jeffmhopkins/POGO/specs/block-6/spec.md

# Block 6: Triple Bandpass + Distortion
Three independent 2-pole OTA-C SVF bandpass resonators with per-band frequency, Q (FOCUS), stereo spread (TILT), drive, and distortion mode. A global BP master section controls overall offset, tilt, bypass level, and wet level.

DSP source: `plugin/src/dsp/BandpassSVF.hpp`, `plugin/src/dsp/Distortion.hpp`, `plugin/src/Pogo.cpp` (lines 410–510)

---

## 1. Intent

Three bandpass resonators — each freely tunable over ~50 Hz–3.2 kHz (F_REF = 400 Hz at param = 0). Together they act as a resonator bank, vowel sculptor, or harmonic comb filter. All three bands default to the same center frequency; the user positions them independently via the per-band FREQ knobs.

**Per-band signal order (change 0018, matching the locked plugin `Pogo.cpp:443–451`): DISTORTION *before* the bandpass.** Each band is `input → DISTn (drive + SC/HC/WF) → SVFn (2-pole bandpass) → band output`; the three band outputs are then summed and dry/wet-mixed. (BP1/BP2 input = LP1 band; BP3 input = the ALT-VCA-or-LP1 selector — see ALT path.) The hardware nets carry this as `LP1_OUT/BP3IN → distN → BPn_DISTOUT → svfN → BPn_BANDOUT/BP3_TAP → mix`.

### Global BP master controls

**BP_OFFSET** shifts all three bands simultaneously (master V/oct offset). **BP_TILT** creates global stereo spread — L channel gets +tiltV, R gets −tiltV — separating the band positions across the stereo field.

**BP_BYPASS** sets the level of the pre-BP signal (LP1 output or ALT input) that passes through to the BP output (0 = muted, 1 = full). **BP_WET** sets the level of the processed (post-distortion) BP sum at the output (0 = dry only, 1 = full wet). The output formula is:

```
bpOut = clamp(bandIn × bypass + wetSum × wet, −12, +12)
```

Both controls are independent scalers — not a crossfade. Setting both to 1.0 adds LP1 and full BP together; setting BYPASS to 0 gives pure BP; setting WET to 0 gives pure LP1 passthrough.

CV inputs for the master section: FREQ jack (+ attenuverter trimpot) modulates BP_OFFSET; TILT jack modulates BP_TILT.

### Per-band controls (BP1, BP2, BP3 — identical architecture)

Each band has:
- **DIST switch** (Dailywell DW5, 3-position toggle): Soft Clip (down) / Hard Clip (centre) / Wavefold (up) — selects distortion character independently per band
- **FREQ knob** (xl): per-band frequency offset in V/oct; F_REF = 400 Hz → range ~50 Hz–3.2 kHz
- **FOCUS knob** (large): resonance (Q); `Q = 0.5 × 400^focus` → Q range 0.5–200; does not self-oscillate
- **TILT knob** (large): per-band stereo spread, additive with global BP_TILT
- **DIST knob** (large): per-band drive depth (0–1) into the distortion cell, which sits **before** the bandpass (0.20 = unity/threshold)
- **CLIP LED**: illuminates when the per-band distortion output (pre-bandpass) exceeds ±4 V
- CV inputs per band: FREQ, TILT, DIST jacks (each with attenuverter trimpot)

### ALT path

`ALT_BP_L/R` jacks (with the `ALT_GAIN` 1×/5× switch) feed **BP3 only**, and the ALT signal still
passes **through the VCA** (same control as the main path) — it bypasses **LP1**, not the VCA (see
block-1/block-4). A per-channel selector (block-6, BP3) routes the ALT-VCA signal (block-4
`ALT_VCA_OUT_L/R`) into BP3's input when the ALT jacks are patched, else BP3 takes the LP1 band.
BP1 and BP2 always take the LP1 band.

### BP3 output tap

`BP3_L_OUT` and `BP3_R_OUT` jacks provide BP3's **post-bandpass band output** (the filtered BP3
voice, after its distortion+SVF, before the 3-band sum and dry/wet mix) — useful for parallel
processing or sidechain routing. R normals to L when the R jack is unpatched.

---

## 2. Theoretical Design and Topology

> ⚠️ **SUPERSEDED (pre-2026-05-27 theory)** — This section predates change 0018. Where it
> conflicts with §1, the Stage-alignment notes above (two-scaler BP_BYPASS+BP_WET mix; **per-band**
> `BP{n}_DIST_MODE`; distortion **before** the SVF; F_REF 400 Hz; per-band variable DRIVE VCA),
> or the `specs/block-6-{svf1,svf2,svf3,dist1,dist2,dist3,mix}/*.nets.yaml`, those are authoritative.
> In particular the "global BP_DIST switch" and "BP_MIX crossfade (default 0.5)" language below is
> stale — mode is per-band and the output uses two independent scalers (both default 1.0).

> 📝 **Schematic transcription (2026-05-29).** The KiCad netlist
> (`specs/block-6/block-6.nets.yaml`, generated by `tools/gen_block6.py`) was transcribed
> this pass and `tools/generate_schematic.py --check` is clean. Findings, reconciled
> against the plugin (ground truth) and the TI datasheets:
> - **BP = the same 2-pole Simper SVF as LP1/HP/LP2** (`BandpassSVF.hpp` confirms it),
>   so the topology mirrors block-5/8 but taps **v1 (BP)** instead of v2 (LP). Each group
>   has its own per-channel Q-VCA OTA (U67-69) injecting damping current at the SUM_AMP
>   virtual ground, exactly like the block-5-hosted shared Q-VCAs.
> - **CD4053 mux is a stereo 1-of-3 built from two CD4053 per group** (muxB picks HC↔WF
>   into a MID node; muxA picks SC↔MID), L on the X channel, R on the Y channel, Z spare.
> - **CD4053 symbol pinout was wrong** (now authored in `components/symbols/cd4053.yaml`) and
>   has been corrected to the
>   TI CD4053B datasheet (selects A/B/C = 11/10/9; X com/0/1 = 14/12/13; Y = 15/2/1;
>   Z = 4/5/3). The prior symbol scrambled the channel numbers and overlapped VEE with a
>   signal pin.
>
> **Three controls remain under-specified and are flagged Phase-3R** — the signal path is
> wired faithfully and each control is treated as a boundary CV applied via a Phase-3R element:
> 1. **DRIVE → variable gain.** No in-block variable-gain element exists (the drive knobs
>    RV33/36/39 are control-board; there is no VCA/JFET in the block-6 BOM). The six SC/HC/WF
>    cells are wired at their fixed minimum gain (R_fb fixed); they still clip at their diode
>    (±1.4 V) / zener (±5.8 V) thresholds, so they are functional. The per-band DRIVE depth is
>    a Phase-3R variable-gain stage fed by the BPx_DIST CV. The C_WF 47 pF caps (spec'd as
>    drive-pot wiper bypass) are relocated to the distortion-input nodes as anti-RF caps.
> 2. **DW5 ON-ON-ON → 2-bit mode encoding.** SW4-6 encode mode into two bits per group; the
>    select lines `BPx_SEL_SC`/`BPx_SEL_WF` are pulled to a 5 V logic rail (D7/R29/C27/C28)
>    and leave as boundary nets to the DW5. The exact lug→bit make pattern is Phase-3R. **5 V
>    logic-high against VDD = +12 V is marginal per the CD4053B datasheet** (V_IH ≈ 0.7·VDD):
>    a level shift or VDD = +5 V may be required — prototype-verify. Analog rails are kept at
>    ±12 V for full ±5 V audio headroom.
> 3. **BP_MIX blend — RESOLVED (change 0018, Stage 7).** The plugin uses **two independent
>    0–1 scalers** (`bpOut = bandL·BP_BYPASS + wetSum·BP_WET`), now built as such: the wet
>    3-band sum (U46/47-A, inverting) is re-inverted by U48 (G=−1) to `BP_WETPOS` (+bands);
>    a **BYPASS** dual-gang pot (RV30 L / RV58 R) attenuates the dry LP1 band and a **WET**
>    dual-gang pot (RV57 L / RV59 R, new) attenuates `BP_WETPOS`; both wipers sum in the final
>    inverting summer (U46/47-B), then an output polarity-restore inverter per channel (U27-B
>    = L, U27-A = R, reused) yields `BP_OUT`. Both pots default 1.0 = LP1 + full BP, matching
>    the plugin. *Polarity:* dry and the wet bus are arranged to **add** at `BP_OUT` (the wet
>    chain's net inversions, including the Stage-5 DRIVE-VCA I/V, are accounted so wet sums
>    with — not against — dry). The exact wet-vs-dry absolute phase across frequency/mode and
>    the pot tapers are Phase-3R bring-up items.

### SVF Groups (3 independent resonators)

Each group is a 2-pole state-variable filter (BP output only). Both DSP and hardware use one 2-pole OTA-C SVF per group per channel:

```
H_BP(s) = (ω₀/Q · s) / (s² + ω₀/Q · s + ω₀²)
```

Peak at s = jω₀: |H_BP(jω₀)| = 1 (constant unity, regardless of Q). Q controls bandwidth only, not peak amplitude.

**f_ref per group** (at 0V CV): **all three bands = 400 Hz** (matches the locked plugin
`BandpassSVF.hpp:42` `F_REF = {400, 400, 400}`). The bands default to the same center and the
player spreads them via the per-band FREQ knobs — they are not fixed-formant. (The earlier
`{200, 1500, 6000}` per-group formant assignment matched a stale code comment, not the plugin
code, and is superseded — change 0018. Integrator caps are now a uniform 68 nF C0G, trimmed to
400 Hz by each band's f_ref trim.)
| Group | f_ref | Cap |
|---|---|---|
| BP1 | 400 Hz | 68 nF (C15) |
| BP2 | 400 Hz | 68 nF (C19) |
| BP3 | 400 Hz | 68 nF (C23) |

**Frequency control:**
```
f₀ = f_ref[i] × 2^(BP_OFFSET + BP_FREQ_i + BP_TILT × ±1)
```
where BP_TILT applies +tiltV on L channel, −tiltV on R channel.

**Q control:**
```
DSP: Q = 0.5 × 400^qParam  (range 0.5–200; does NOT self-oscillate by design)
Hardware: Q = 52mV / (Iabc × R_in)
```
BP Q maximum is ~200 at hardware (Iabc → minimum before instability threshold). Self-oscillation is suppressed — BP groups are resonators, not oscillators.

### Distortion

Three modes, selected **per band** by `BP{n}_DIST_MODE` (0/1/2) — BP1/BP2/BP3 independent:

**Soft Clip (mode 0):**
```
G = driveParam ≤ 0.20 ? (driveParam / 0.20)        (0→1× gain control)
      : exp((driveParam − 0.20) / 0.80 × 4)         (1×→~55× drive, same exp law)
y = Vth × tanh(G × x / Vth)    Vth = 0.28 (= 1.4V/5V; two 1N4148W per polarity)
```
Output bounded to ±Vth = ±1.4V at all drive levels. Linear below threshold; smooth tanh onset above. Diodes always in circuit; gain-control zone (≤9am) feeds the diode chain at reduced gain.

**Hard Clip (mode 1):**
```
g = 1 + d × 4    (1–5× linear gain)
y = clamp(g × x, −1.16, +1.16)    (±1.16 = ±5.8V/5V; zener 5.1V + 1N4148W Vf 0.7V)
```
Linear gain into hard rails at ±5.8V. Aggressive, brick-wall limiting.

**Wavefold (mode 2, Buchla-style):**
```
Vth = 0.28    (= 1.4V/5V; two 1N4148W per polarity in passive clamp)
y = (1 + d × 4) × x                    (1–5× pre-gain)
output = Vth × asin(sin(π/2 / Vth × y)) × 2/π
```
Passive diode clamp at ±Vth, then V_out = 2×V_clamp − V_in (slope reversal at ±1.4V). At max drive and full-scale input: ~18 folds vs ~3 folds at ±5V threshold. Dense Buchla-style folding.

### BP_MIX blend

```
BP_out = clamp(LP1_output + mix × sum(distorted_groups), −12, +12)
```
**(Superseded — see §1 / Stage-7 note.)** The current design uses two independent scalers: `BP_BYPASS` scales the dry LP1 band and `BP_WET` scales the wet sum, both default **1.0** (`bpOut = clamp(band·BYPASS + wetSum·WET, ±12)`). There is no single "mix" crossfade and no 0.5 default.

### Oversampling

None. Hardware SVF and distortion run at audio rate; analog hardware is inherently alias-free. DSP matches: no oversampling applied to BP section.

### DSP/Hardware Alignment

DSP and hardware are aligned on all BP signal-processing behaviors:
- 2-pole SVF per group per channel (both)
- Unity BP peak gain regardless of Q (both)
- Additive BP_MIX: dry at unity, wet added on top (both)
- No oversampling (both)
- Distortion thresholds: SC ±1.4V, HC ±5.8V, WF ±1.4V (both)

→ See aux-ota-c-svf.md for SVF topology; aux-distortion.md for distortion cells.

---

## 3. Physical Design

> ⚠️ **STALE** — This section reflects the pre-panel-redesign analog design (2026-05-27).
> It has not been verified against the current panel control set. Do not use for circuit
> construction until re-verified. See `specs/STATUS.md` for current phase status.

> 🔧 **Change 0020 (the per-section nets ARE current; this §3 prose is not):** two fixes landed in
> the block-6 section netlists (`block-6-svf1/2/3`, `block-6-dist1/2/3`):
> - **§A BP expo V/oct divider:** each per-band expo base got the same divider fix as the filters —
>   `R_VOCT`→**49.9k** + a **Vishay TFPT 1k tempco** shunt to GND (centers 17.92 mV/oct). (svf1/2/3.)
> - **HIGH-3 DRIVE-VCA Ec+ trims:** the 6 per-band DRIVE unity trims (RV51–56) were useless series
>   rheostats into the high-Z Ec+ port → replaced with **voltage-injection trims** (RV→10k divider
>   across a local ±1.2 V ref; wiper→R_inj 1M→Ec+; V_DRIVE_CTRL→R_ec 10k→Ec+). ±~2 dB authority
>   (SPICE `block-6-dist1/sim/dist_clip.cir` etc.; mirrors block-4 vca_ecplus.cir). V_DRIVE_CTRL is already an op-amp output (low-Z) so no extra buffer.
>   Mirrors block-4 HIGH-3. (dist1/2/3: R243–260, REF_P/N 1/2/3.)

### OTA-C SVF instances

Three groups × two channels (L + R) = **6 OTA-C SVF instances**. Each instance requires:
- 1× LM13700 OTA cell as integrator (one IC = 2 cells = one group, one channel)
- 1× TL072 half as SUM_AMP

Grouping per IC:
- Per group: `BP_OTA_G1_L`, `BP_OTA_G1_R` etc. — one LM13700 per group per channel (dual OTA: cell A + cell B = integrator + Q VCA, OR cell A/B for two channels of same group)
- Conservative count: 3 groups × 2 channels × 1 LM13700 = **6× LM13700** for integrators + Q VCAs

**Q (resonance) at SUM_AMP:**
Standard SVF BP peak is 1× (constant unity, independent of Q). No normalization is applied. Q controls bandwidth only; high-Q formants have the same peak level as low-Q formants. This is the natural hardware OTA-C SVF behavior and is preserved in the DSP.

**Stereo tilt implementation:**
- BP_TILT generates +V_tilt (from mod bus via attenuverter)
- +V_tilt added to L-channel expo converter offset sum
- −V_tilt generated by TL072 inverting unity buffer; added to R-channel expo converter offset sum
- One TL072 half used as tilt inverter (shared across all 3 groups, same tilt offset applied to all)

**Expo converters:**
- **Per-channel** THAT340: one per L and one per R, per group — 6× THAT340 total (U28-U30 L, U70-U72 R)
- Each band/channel has its own f_ref trim (RV_BP{1,2,3}_REF L/R), all targeting **400 Hz at 0 V**

**Distortion hardware (see aux-distortion.md):**
- **Variable DRIVE (change 0018):** each band has a stereo VCA at its distortion input — a
  THAT2180 current-in/I-V-out cell per channel (mirrors the block-4 VCA), gain set by the
  per-band DRIVE knob (RV33/36/39) + DRIVE CV (`MOD_BPn_DIST`) summed into Ec+. This is the
  hardware "DRIVE→gain" stage; a single dB-law VGA per band approximates the plugin's
  per-mode drive (SC exp vs HC/WF linear) — an accepted, documented deviation, with the exact
  knob→Ec+ dB law and the knob=0.20⇒unity bias set at **Phase-3R** bring-up (like block-4's Ec+).
  *Polarity:* the I/V stage inverts (as in block-4); this adds one inversion to the BP wet path
  — to be absorbed by the mix's wet polarity-restore (Stage 7 / Phase-3R), so wet sums (not
  subtracts) with the dry LP1 band.
- Three sub-circuit chains per group: SC / HC / WF all running simultaneously (after the DRIVE VCA)
- CD4053 triple 2-channel analog mux per group selects which mode's output passes
- All 3 CD4053 select pins tied together → BP_DIST switch controls all groups simultaneously
- One Dailywell DW5 (2M DPDT ON-ON-ON) toggle → its two poles give the 2 select lines to all 3 CD4053 ICs
- Distortion runs **pre-SVF** (band → DRIVE VCA → DISTn → SVFn) at audio rate (no oversampling)
- BP3 output tap: taken at group 3's **post-bandpass** band output (`BP3_TAP`, after DIST3→SVF3), available at BP3_L/R_OUT jacks

**BP3 input selector (change 0018):** BP3's distortion input is fed by a CD4053 mux (U81, in
block-6-dist3) that picks, per channel, between the **LP1 band** (`LP1_OUT`, mux X0/Y0) and the
**ALT-VCA voice** (`ALT_VCA_OUT` from block-4, mux X1/Y1). The select is `ALT_L_DET` — the
ALT_BP_L jack insertion detect: J3's tip-switch lug (block-1) feeds `ALT_L_DET`, pulled to +12 V
(R133) with a 22 kΩ pulldown on the ALT_L tip (R134); patched ⇒ HIGH ⇒ ALT-VCA, unpatched ⇒ LOW
⇒ LP1. Both channels share `ALT_L_DET` (the plugin's asymmetric `bp3InR = L‖R` is not realized —
the locked single-switch jacks have no free contact for an ALT_R detect; diverges only in the
rare R-patched-but-not-L case). *(Phase-3R: like the other CD4053 selects, a +5 V/+12 V logic
threshold margin should be verified on the prototype; ALT_L_DET uses a +12 V pull-up to stay
clean against VDD=+12.)*

**Oversampling:**
- None. Hardware and DSP both run at base sample rate. Analog hardware is inherently alias-free; no oversampling required.

**Board assignment:** BP SVF and distortion on audio board. BP control pots and jacks on control board. THAT340s on audio board near their respective SVF clusters.

### Q Normalization — Design Decision

Hardware OTA-C SVF produces |H_BP(jω₀)| = 1 (constant unity peak). Q controls bandwidth only. A 1/Q² normalization would require a VCA per group per channel (6 cells), significantly increasing complexity. Decision: hardware unity peak is preserved in both hardware and DSP. High-Q formants are louder — this is musically desirable (tight resonances stand out) and is the expected behavior of analog formant filters.

### Distortion Sub-Circuit Design (SC / HC / WF)

One set of three sub-circuit paths (SC + HC + WF) per group, per channel = 6 sets total.
All paths share a common DRIVE control signal per group (one pot + CV per group, summed at
mod bus). All three paths run continuously; the CD4053 selects which output reaches BP_MIX.

#### SC Path (Soft Clip)

Inverting gain stage followed by antiparallel diode-pair feedback (tanh approximation):

```
                 R_SC_fb_fixed (10 kΩ)
              ┌──────────────────────────────┐
              │   RV_DRIVE (0–470 kΩ log)    │
              ├──────────────────────────────┤
              │         (in feedback path)    │
              │                               │
 BP_out ──[R_SC_in = 10 kΩ]──►(−) TL072 ──►─┴─── SC_out
                                   │
                               D_SC_3│D_SC_4 (1N4148W antiparallel pairs)
                               D_SC_1│D_SC_2
                                   │
                                  GND

Diodes: two 1N4148W in series per direction (4 total per path)
  V_clip = 2 × V_f_1N4148 ≈ 2 × 0.7V = 1.4V (soft clip threshold)

DRIVE varies feedback resistance:
  RV_DRIVE = 0 (full CCW): R_fb = R_SC_fb_fixed = 10 kΩ → gain = 10/10 = 1× (linear)
  RV_DRIVE = max (full CW): R_fb = 10 kΩ + 470 kΩ = 480 kΩ → gain = 480/10 = 48× (heavy sat)
```

At low drive: signal below 1.4V threshold → diodes off → output follows linear gain law.
At high drive: pre-amp amplifies to many multiples of 1.4V → diodes conduct → output
limited to ±1.4V, producing soft saturation. Tanh-like characteristic due to incremental
diode conductance. Polarity preserved (inverting amp + final inverting buffer restores sign).

Components per SC path: 1× TL072 half (SC gain amp), 4× 1N4148W (SOD-123), 2× resistors.

#### HC Path (Hard Clip)

Inverting gain stage with variable gain followed by back-to-back zener clamp:

```
 BP_out ──[R_HC_in = 10 kΩ]──►(−) TL072 ──►───────── HC_out
                                    │               │
                               R_HC_fb              │
                     (10 kΩ + RV_DRIVE 47 kΩ log)  │
                                                    │
                             D_HC_Z1 ── D_HC_Z2     │
                             (BZX84C5V1, SOT-23)    │
                             back-to-back to GND     │

Zener pair: one in breakdown (5.1V), one in forward conduction (0.7V) → V_clip = ±5.8V

DRIVE varies gain:
  RV_DRIVE = 0: R_fb = 10 kΩ → gain = 10/10 = 1× → ±5V signal → stays below ±5.8V clip (near-linear)
  RV_DRIVE = max: R_fb = 10+47 = 57 kΩ → gain = 57/10 = 5.7× → ±5V signal → ±28.5V → clips at ±5.8V
```

At low drive: input ±5V with gain 1× gives ±5V output; just below zener threshold (5.8V) — near-linear.
At high drive: gain up to ~5.7×; input is amplified well beyond threshold → hard clip at ±5.8V
(corresponding to ±1V threshold at the input, i.e., signals above 1V clip against the zeners).

Components per HC path: 1× TL072 half (HC gain amp), 2× BZX84C5V1 zener (SOT-23), 2× resistors.

**Note:** Zener clip threshold of ±5.8V vs DSP target of ±5V. Deviation is ±0.8V (16%).
Acceptable for a distortion effect. Document and close.

#### WF Path (Wavefold)

True symmetric precision folder approximating DSP `asin(sin(π/2 × gain × x)) × 2/π`.

Uses a passive diode clamp + op-amp subtractor topology that produces true slope reversal at
±Vth (1.4 V). This is not gain compression — the output slope inverts at threshold.

```
Stage 1 — pre-gain (variable fold depth):
 BP_out ──[R_WF_in = 10 kΩ]──►(−) TL072-A ──► V_fold_in
                                    │
                               R_WF_fb: 10 kΩ + RV_DRIVE 47 kΩ → gain 1×–5.7×
 (inverting; polarity consistent with SC/HC paths)

Stage 2 — symmetric precision folder:
 Passive diode clamp:
   V_fold_in ──[R_clamp = 10 kΩ]──┬── V_clamp
                                    │
              D_WF_1 ──►|── D_WF_2 ──►|──┐
                                           ├── AGND
              D_WF_3 ─◄|── D_WF_4 ─◄|──┘
   (D_WF_1–4: 1N4148W, SOD-123; two per direction → Vth = ±2×0.7V = ±1.4V)
   Clamp action: V_clamp = V_fold_in when |V_fold_in| ≤ 1.4V
                 V_clamp = +1.4V    when V_fold_in > +1.4V
                 V_clamp = −1.4V    when V_fold_in < −1.4V

 Op-amp folder (TL072-B, non-inverting reference = V_clamp):
   V_clamp ──────────────────────────►(+)
   V_fold_in ──[R_g = 10 kΩ]─────────►(−)──── TL072-B ──[R_f = 10 kΩ]──► WF_out
                                        (−) receives negative feedback from output via R_f
```

**Transfer function:**
```
WF_out = 2 × V_clamp − V_fold_in

 |V_fold_in| ≤ 1.4V: V_clamp = V_fold_in → WF_out = V_fold_in          (linear)
 V_fold_in  > +1.4V: V_clamp = +1.4V    → WF_out = 2.8V − V_fold_in   (fold down)
 V_fold_in  < −1.4V: V_clamp = −1.4V    → WF_out = −2.8V − V_fold_in  (fold up)
```

This is a true slope reversal at ±1.4 V, matching the asin(sin(x)) shape for a single fold.
At DRIVE=max (gain 5.7×), a ±5V input signal reaches ±28V pre-fold → multiple reflections
across the ±1.4V window → dense odd-harmonic spectrum.

**Stability:** TL072-B is in standard negative feedback (output → R_f → (−) input).
V_clamp at (+) is a passive resistor-diode network with no active elements; it presents a
source impedance of R_clamp = 10 kΩ at (+), which has no impact on loop stability.
Phase margin is identical to a standard G=+2 non-inverting configuration. No stability
concern — no prototype verification required for this stage.

**Diode Vth variation (resolved — accepted characteristic):**

1N4148W Vf depends on clamp current; Vth = 2×Vf shifts with drive level:

```
V_fold_in   I_clamp = (V−1.4V)/10kΩ   Vf (1N4148W)   Vth = 2×Vf
  3 V           160 µA                  ~0.62 V          ~1.24 V
  5 V           360 µA                  ~0.64 V          ~1.28 V
 10 V           860 µA                  ~0.68 V          ~1.36 V
 28 V (max)    2.66 mA                  ~0.72 V          ~1.44 V
```

At practical folding depths (V_fold_in > 5 V), Vth sits in the 1.28–1.44 V range,
within ±10% of the DSP target (1.4 V). At very low drive (barely past threshold),
Vth is lower (~1.2 V), which softens fold onset slightly. This gives the hardware a
characteristically smooth entry into folding — the fold corners are rounder than the
mathematical `asin(sin(x))` model, consistent with all passive-diode Buchla-style
folders. It is an analog character feature, not a defect. No hardware change required.

Components per WF path: 2× TL072 halves (pre-gain + folder; same IC, no additional ICs),
4× 1N4148W (SOD-123), 4× resistors (R_WF_in, R_WF_fb_fixed, R_clamp, R_g = R_f = 10 kΩ).

**Note on wiper bypass caps:** A 47 pF cap from each RV_DRIVE wiper to AGND is recommended
(pole at R_wiper_max × C ≈ 11.75 kΩ × 47 pF → f_pole ≈ 288 kHz). Kills RF pickup; no
effect on control-rate drive changes.

### CD4053 Mux Wiring

One CD4053 (SOIC-16) per group, 3 total (BP_DIST_MUX_1, _2, _3). All three have their
S_A and S_B control pins tied together (global mode select from SW_DIST panel switch).

**Power supply wiring:**
```
VDD (+12V supply) → pin 16 of each CD4053 (analog/digital supply)
VSS (−12V supply) → pin 7 of each CD4053 (negative analog rail)
VEE (GND)         → pin 8 of each CD4053 (digital ground; sets logic threshold at ~VDD/2)
INH pin (pin 6)   → GND (active-low inhibit; tied LOW = always enabled)
```

The CD4053 passes signals from VSS to VDD on each analog channel. With ±12V supply,
the audio signal can swing ±5V without signal-dependent R_on distortion.

**Control line encoding (2 binary lines → 3 modes):**
```
SW_DIST position → S_A line, S_B line:
  Soft Clip:  S_A = 0,  S_B = 0   → Channel X passes SC_out; Channel Y passes X-output
  Hard Clip:  S_A = 1,  S_B = 0   → Channel X passes HC_out; Channel Y passes X-output
  Wavefold:   S_A = x,  S_B = 1   → Channel Y selects WF_out (overrides Channel X)
```

**Channel assignment within each CD4053:**
```
Channel X (control S_A):
  X0 input ← SC_out
  X1 input ← HC_out
  X output → Channel Y input Y0

Channel Y (control S_B):
  Y0 input ← Channel X output
  Y1 input ← WF_out
  Y output → DIST_out (→ BPn_DISTOUT → SVF input; the SVF band output then goes to the mix)

Channel Z: spare (inputs tied to GND; output unused)
```

When S_B = 1: Channel Y selects WF regardless of S_A — wavefold mode overrides.
When S_B = 0: Channel Y passes Channel X output, which is SC or HC depending on S_A.

SW_DIST is a Dailywell DW5 (2M DPDT ON-ON-ON) toggle generating S_A and S_B:
- Position 0 (Soft):  S_A=low, S_B=low   (0V = logic LOW; from GND)
- Position 1 (Hard):  S_A=high, S_B=low  (+5V = logic HIGH; from +5V regulator or +12V with R+zener)
- Position 2 (Fold):  S_A=low, S_B=high

The +5V logic rail for CD4053 control inputs: taken from a 78L05 regulator (or 5.1V zener
from +12V with 1kΩ series R) on the audio board. Logic signal swings 0V–5V, which is within
the CD4053 VIH threshold at VDD=+12V.

### BP_MIX Blend Circuit

The DSP: `V_out = (1 − mix) × V_dry + mix × V_wet`  
where V_dry = LP1 signal (entering block-6), V_wet = sum of three distorted BP groups.

**BP summing stage (V_wet):**

One TL072 inverting summer combines distortion outputs of all three groups (per channel):
```
DIST_BP1_out ──[R_sum = 33 kΩ]──┐
DIST_BP2_out ──[R_sum = 33 kΩ]──┼──►(−) TL072 ──[R_f = 33 kΩ]──► V_wet_inv
DIST_BP3_out ──[R_sum = 33 kΩ]──┘         │
                                         (+) = GND
```
V_wet_inv = −(BP1 + BP2 + BP3) / 3 (normalized). Signal inverted; corrected at the fixed
output polarity-restore stage (U27 half B).

**BP_MIX summing amp:**

A TL072 inverting summer with the MIX pot controlling the wet-to-dry ratio:
```
V_dry ──[R_dry = 100 kΩ]────────────────────────┐
                                                  ├──►(−) TL072 ──[R_mix_f = 100 kΩ]──► V_mix_inv
V_wet_inv ──[R_wet_pot = RV_BP_MIX wiper × 100k]─┘
                                                (+) = GND
```

RV_BP_MIX (linear-taper 100 kΩ): controls R_wet from 0 (full CCW, no wet) to 100 kΩ (full CW).
V_mix_inv = −(V_dry × R_f/R_dry + V_wet_inv × R_f/R_wet)

At MIX=0 (R_wet = ∞): V_mix_inv = −V_dry (dry inverted)
At MIX=max (R_wet = 100k, R_f = R_dry = 100k):
  V_mix_inv = −V_dry − V_wet_inv = −V_dry − (−V_wet) = −V_dry + V_wet

**Wet polarity restore (U48):** An inverting unity-gain buffer on the V_wet_inv signal
restores wet polarity to +V_wet before the MIX amp, so V_wet_pos = −V_wet_inv = +V_wet.

With V_wet_pos (corrected) feeding the MIX amp instead of V_wet_inv:
  V_mix_inv = −(V_dry + V_wet_pos × R_f/R_wet)
At MIX=0: V_mix_inv = −V_dry
At MIX=max: V_mix_inv = −V_dry − V_wet

V_mix_inv then passes to the fixed output polarity-restore stage (U27 half B).

**DESIGN NOTE — U48 reassigned:** U48 (previously "output polarity buffer") is used as
the wet polarity restorer. This inserts one inversion in the wet path to correct the
polarity before the MIX amp. Without this correction, the wet signal would be subtracted
rather than added at the BP output (V_dry − V_wet instead of V_dry + V_wet).

**Note:** DSP matches hardware: dry is always present at unity, wet is added on top. At MIX=max: output = dry + wet (up to 6 dB louder than a crossfade at equal level). DSP clamps at ±12V; hardware limited by op-amp rails.

### BP output polarity restore (fixed)

The hardware MIX amp output V_mix_inv is inherently negative-polarity (−V_dry − V_wet).
A fixed G=−1 inverter (U27 half B, in the output polarity-restore TL072CDT) restores the expected
positive-polarity BP output (+V_dry + V_wet). There is no user polarity control (BP_POL
was removed — the plugin has no polarity param; the inversion below is always in path).

```
                               R_pol_in (100 kΩ)    R_pol_fb (100 kΩ)
V_mix_inv ──[R_pol_in = 100 kΩ]──►(−) U27-B ──[R_pol_fb]──► V_bp_out (+V_dry+V_wet)
                                        │
                                   (+) = GND
```

U27 (output polarity-restore TL072CDT) halves — both channels (change 0018; per-band tilt
moved to U82/U83/U84):
- Half B: fixed G=−1 inverter, restores **BP_OUT_L** polarity (always in path; no switch).
- Half A: fixed G=−1 inverter, restores **BP_OUT_R** polarity (always in path; no switch).

**Board assignment:** BP_MIX summing amp + output polarity-restore inverter on the audio board.

### Trim Pots

| Ref | Range | Purpose |
|---|---|---|
| RV_BP1_REF | 500 kΩ; ±25% f_ref | BP1 cutoff reference (target: **400 Hz** at 0V); in series with R_IREF_A 1 MΩ |
| RV_BP2_REF | 500 kΩ; ±25% f_ref | BP2 cutoff reference (target: **400 Hz** at 0V); in series with R_IREF_A 1 MΩ |
| RV_BP3_REF | 500 kΩ; ±25% f_ref | BP3 cutoff reference (target: **400 Hz** at 0V); in series with R_IREF_A 1 MΩ |
| RV_BP1_1VOCT | 20 kΩ; ±10% tracking | BP1 expo 1V/oct calibration |
| RV_BP2_1VOCT | 20 kΩ; ±10% tracking | BP2 expo 1V/oct calibration |
| RV_BP3_1VOCT | 20 kΩ; ±10% tracking | BP3 expo 1V/oct calibration |
| RV_BP1_QMAX | V_bias | BP1 Q maximum point |
| RV_BP2_QMAX | V_bias | BP2 Q maximum point |
| RV_BP3_QMAX | V_bias | BP3 Q maximum point |

### Integrator Cap Derivation

All three bands target f_ref = **400 Hz** (plugin `F_REF = {400,400,400}`):
C = g_m_ref / (2π × 400) ≈ 192 µS / (2π × 400) = 76 nF → use **68 nF (C0G, 0805)** for all three
bands (C15/C19/C23), with the per-band f_ref trim (RV_BP{n}_REF, ±25%) calibrating to exactly
400 Hz. (Superseded: the earlier per-band 150/22/4.7 nF caps implemented a stale {200,1500,6000}
formant spread that does not match the plugin code — change 0018.)

(Exact values adjusted via RV_BPx_REF trim; derive from nominal at I_abc = 10µA.)

### Power Draw Estimate

- 6× LM13700M (SVF integrators + Q VCAs): ~4 mA × 6 = ~24 mA  (TI: 4 mA typ per package)
- 6× OPA1612 (SUM_AMPs, dual SOIC-8): 5.5 mA × 6 = 33 mA  (Iq = 2.75 mA/channel × 2 ch/IC)
- Distortion op-amps — 12 TL072CDT ICs (6 SC+HC shared + 6 WF): ~2.6 mA × 12 = ~31 mA
- BP_MIX + tilt/pol — 5 TL072CDT ICs (1 tilt/pol inverter + 2 wet-summer + 2 MIX polarity buffer): ~2.6 mA × 5 = ~13 mA
- 3× THAT340S14-U (expo converters): ~3 mA
- 3× CD4053BM96 (distortion mux, CMOS quiescent ≈ 0): ~0 mA
- **+12V: ~104 mA | −12V: ~104 mA**

Note: SC and HC distortion paths share one TL072CDT per group/channel (half A = SC, half B = HC).
WF requires both halves of its own IC. Total distortion ICs reduced from 18 to 12 vs prior design.
Icc figures use ±12V operating point (~2.6 mA/pkg), not the ±15V datasheet spec.

---

## 4. Component Requirements

Component set: see the generated BOM `kicad/pogo-bom.csv` (rows with `Block = block-6`),
sourced from `specs/components.yaml` (the per-ref design manifest) and enriched by the
`components/` registry (MPN, footprint, datasheet). Verification status: `specs/STATUS.md`.
