jeffmhopkins/POGO/specs/block-8/spec.md

# Block 8: LP Filter 2
Second independent 2-pole lowpass filter, after HP, for stacked or layered LP filtering with separate CV.

DSP source: `plugin/src/dsp/LPFilter.hpp`, `plugin/src/Pogo.cpp` (lines 486–492)

---

## 1. Intent

Block 8 is the second lowpass filter in the chain and the last filter block before the output
buffers (Block B). It shares the same OTA-C SVF topology as LP1 but operates independently — its
own cutoff CV, resonance, and expo converter — so the two LP filters can be tuned to different
purposes simultaneously.

The most common uses are:

- **Stacked mode:** LP2 cutoff set below LP1 cutoff → combined 24 dB/oct slope, both cutoffs swept
  in parallel (or independently) for a steeper, more dramatic lowpass character.
- **Layered mode:** LP2 cutoff set above LP1 cutoff → dual-knee LP response, creating a compound
  transfer function with two shelf-like transition regions and a flat passband between them.
- **Bright default:** LP2_FREQ_PARAM defaults to +2V (≈ 2.5 kHz), placing LP2 well above LP1's
  default of 0V (632 Hz). In this configuration LP2 is effectively open, contributing only a
  gentle top-end softness, while LP1 dominates the filter sound.
- **Independent resonance:** LP2 resonance adds a second resonant peak at its own cutoff, creating
  a dual-peak spectral character when both LP1 and LP2 have significant Q.

LP2 has no stereo tilt — both L and R channels share one cutoff CV and one Q control, keeping
the hardware simpler and reserving the stereo-spread complexity for LP1 and BP_TILT.

LP2's output feeds Block B (output buffers → MAIN_L/R jacks) directly.

---

## 2. Theoretical Design and Topology

> ✅ **Re-verified 2026-05-30** against the locked plugin (change 0018). LP2 mirrors LP1
> minus tilt: 2-pole Simper SVF, 632 Hz V/oct, self-oscillation, mono cutoff (single shared
> expo). Output buffer is a **non-inverting** unity follower (matches LP2's un-negated v2 — no
> polarity flip, unlike HP). Q via the shared U9/U10 cell B (hosted on block-5); boundary nets
> pin-verified. No behavioral edits.

### DSP-to-analog mapping

LP2 uses the same LPFilter struct as LP1. From Pogo.cpp lines 486–491:

```cpp
float lp2FreqCv = params[LP2_FREQ_PARAM].getValue()
                  + modDest(LP2_FREQ_INPUT, LP2_FREQ_ATT_PARAM);
float lp2ResCv  = clamp(params[LP2_RES_PARAM].getValue()
                  + modDest(LP2_RES_INPUT, LP2_RES_ATT_PARAM) / 10.f, 0.f, 1.f);
float outL = lp2L.process(hpOutL, lp2FreqCv, lp2ResCv, fs);
float outR = lp2R.process(hpOutR, lp2FreqCv, lp2ResCv, fs);
```

The same `f₀ = f_ref × 2^(cutoffV)` law with `f_ref = 632 Hz` applies. The default
LP2_FREQ_PARAM = +2V shifts the reference point up by two octaves:

```
f₀_default = 632 Hz × 2^(+2) = 632 × 4 = 2528 Hz ≈ 2.5 kHz
```

This places LP2 above LP1 (632 Hz default) so that in the default patch state the module sounds
like a single LP1 filter — LP2 only becomes audibly active when its cutoff is swept down or when
LP1 is swept above LP2.

### Transfer function (analog prototype)

Identical to LP1 (see `aux/aux-ota-c-svf.md`):

```
H_LP(s) =        ω₀²
          ──────────────────────────
          s² + (ω₀/Q)·s + ω₀²
```

With Q law and Q range identical to LP1/HP:

```
Q = 52mV / (I_abc_q × 100kΩ)
I_abc_q = 0.74 µA → Q = 0.70  (Butterworth, default)
I_abc_q → 0       → Q → ∞    (self-oscillation)
```

**Accepted Q_min deviation:** DSP Q_min = 0.5 at resParam = 0; hardware Q_min = 0.70 (Butterworth).
See LP1 and `aux/aux-q-control.md` §Q_min deviation for full discussion.

### Cascaded response (LP1 + HP + LP2)

When LP2 is stacked below LP1 (LP2_FREQ < LP1_FREQ), the combined response approaches 24 dB/oct.
Cascading two 2-pole stages with independent Q settings produces a 4th-order response that is
not a standard Butterworth or Linkwitz-Riley alignment; the exact shape depends on the ratio of
the two cutoff frequencies and both Q values. This is a feature, not a defect — it produces a
complex, tunable slope character.

When HP is active between LP1 and LP2, the combined LP1 + HP + LP2 response is a bandpass-like
envelope: HP sets a lower cutoff; LP2 sets an upper cutoff; LP1 shapes the overall entry into the
passband. This is a useful configuration for narrow-band spectral shaping downstream of the BP formant section.

### Shared Q-VCAs (U9/U10) — sharing with LP1

LP2 Q uses cell B of U9/U10 — the same LM13700 packages whose cell A provides LP1 Q.
This means LP1 and LP2 Q cells are on the same die; their I_abc_q signals are independently
driven by separate IRES_AMP circuits. Thermal coupling between cells A and B is negligible at the
operating Iabc (<1 µA, <10 µW per cell). See `aux/aux-q-control.md` §LM13700 Cell Sharing.

### Independent EXPO_LP2 converter

LP2 has its own THAT340 expo converter (EXPO_LP2), independently calibrated from EXPO_LP1. This
is required because LP2's default +2V offset means that the two filters are typically operating
at different points on the expo curve simultaneously. If they shared an expo converter, trimming
RV_REF for one would detune the other.

See `aux/aux-expo-converter.md` for full EXPO topology and calibration procedure.

### No stereo tilt

LP2 has no tilt parameter. Both lp2L and lp2R receive the same `lp2FreqCv` and `lp2ResCv` (Pogo.cpp
lines 490–491). Hardware: EXPO_LP2 drives L and R OTA Iabc pins in parallel from a single expo
output — identical to HP, simpler than LP1.

---

## 3. Physical Design

> ✅ **Re-verified 2026-05-30** against the locked plugin (change 0018). Component values,
> the shared U9/U10 cell-B Q boundary (hosted on block-5), the own IRES_AMP (U65), and the
> non-inverting LP output follower verified consistent with §2 and the plugin. Doc-only pass.

> 🔧 **Change 0020 (CV-conditioning fixes):** mirrors block-7 §A/§C/§D.
> - **§A:** `R86` R_VOCT **47k→49.9k** + **Vishay TFPT 1k tempco** shunt (R230) LP2_EXPO_BASE→GND.
> - **§C:** v1/v2 tap the **unbuffered** OTA outputs (pins 5/12); v2 drives the LP output buffer +
>   R_FB from the clean cap node. Pulldowns R88–R91 removed.
> - **§D:** `R80/R81` R_Iabc **1M→100k** (Iabc pin ≈ −10.8 V). IRES_AMP negative-drive = Phase-3R trim.

### Component derivations

**Integrator capacitors C1, C2 (per channel, ×2 channels = 4 total): 47 nF C0G/NP0 0603**

Same derivation as LP1 and HP:

```
f_ref = 632 Hz → I_abc_ref = 9.69 µA → g_m_ref = 186.3 µS → C = 47.0 nF
```

At default +2V CV: I_abc = 9.69µA × 2² = 38.8 µA → f₀ = 2528 Hz ✓. C0G/NP0 mandatory.

**Input resistors, SUM_AMP feedback, linearizing resistors, Q control:** Identical values to LP1
(100 kΩ, 100 kΩ, 1 kΩ, 1 MΩ respectively). See LP1 derivations in block-5/spec.md §3.

**LP2 does not expose an HP output** (output goes directly to Block B, LP output only — the
plugin LP2 returns `v2`/LP only). The SUM_AMP's HP-tap node is used internally by the SVF loop
but not routed anywhere; LP2 therefore has no HP output buffer at all (U58/U59 half B is the LP
output follower). This matches the plugin.

### Calibration trim pots

| Ref | Value | Purpose | Procedure |
|---|---|---|---|
| RV_REF | 500 kΩ | f_ref calibration | Apply 0V CV; trim until f₀ = 632 Hz; in series with R_IREF_A 1 MΩ; set to ~238 kΩ (47.6% CW) |
| RV_1VOCT | 20 kΩ | 1V/oct tracking | Apply +5V CV; trim until f₀ = 632 × 32 = 20.2 kHz |
| RV_QMAX | 100 kΩ | Self-osc onset | Full CW resonance; trim for stable self-oscillation |

Calibration is independent of LP1. Perform LP2 calibration with LP1 set to a known passing state
(bypass or transparent settings) so LP2 output is observable at MAIN_L/R.

### Signal routing

```
Block HP out L  →  LP2_L SVF (SUM_AMP + OTA-A1 + OTA-A2)  →  LP2 out L  →  Block B in L  →  MAIN_L
Block HP out R  →  LP2_R SVF (SUM_AMP + OTA-B1 + OTA-B2)  →  LP2 out R  →  Block B in R  →  MAIN_R

LP2_FREQ_PARAM (−5 to +5 V, default +2V) + LP2_FREQ_INPUT (attenuated by LP2_FREQ_ATT_PARAM)
  →  V_ctrl  →  EXPO_LP2  →  I_abc (shared L+R)

LP2_RES_PARAM (0 to 1, default 0) + LP2_RES_INPUT / 10  →  IRES_AMP_LP2  →  I_abc_q via U9/U10 cell B
```

### Board assignment

Audio board. LP2 should be placed between the HP output nodes and Block B. EXPO_LP2 (THAT340)
is a separate IC from EXPO_LP1, placed adjacent to LP2's V_ctrl summing network.
U9/U10 are shared with LP1 and should be placed between the two filter sections so traces to
both cell A (LP1 Q) and cell B (LP2 Q) are of comparable length.

### Power Draw Estimate

- 2× LM13700M (LP2 L/R integrators): ~4 mA × 2 = 8 mA  (TI: 4 mA typ per package)
- (U9/U10 shared with block-5 — counted in block-5's power estimate, not here)
- 2× OPA1612 (SUM_AMP L/R, dual SOIC-8): 5.5 mA × 2 = 11 mA  (Iq = 2.75 mA/channel × 2 ch/IC)
- 1× TL072CDT (IRES_AMP): ~3 mA  (TI: 1.4 mA/ch × 2 = 2.8 mA)
- 1× THAT340S14-U (EXPO_LP2): ~1 mA
- **+12V: ~23 mA | −12V: ~23 mA**

---

## 4. Component Requirements

Component set: see the generated BOM `kicad/pogo-bom.csv` (rows with `Block = block-8`),
sourced from `specs/components.yaml` (the per-ref design manifest) and enriched by the
`components/` registry (MPN, footprint, datasheet). Verification status: `specs/STATUS.md`.

**Shared resource:** LP2's Q uses **cell B** of the shared Q-VCAs `U9`/`U10`, which are **hosted
on block-5** (`components.yaml`: `block: [block-5, block-8]`, `shared: true`). block-8 reaches them via
boundary nets `LP2_V1/SUMINV/QIABC_*`.
