jeffmhopkins/POGO/specs/block-A/spec.md

# Block A: Input Buffers
Unity-gain stereo input stage that clamps, protects, and normalizes R to L when unpatched.

DSP source: `plugin/src/dsp/InputBuffer.hpp`, `plugin/src/Pogo.cpp` (lines 335–338)

---

## 1. Intent

Block A is the first thing the outside world touches. Its job is purely protective and
organizational: accept up to two TS audio jacks, absorb any cable impedance mismatch,
clamp destructively high voltages before they can reach the signal chain, and present a
low-impedance, unity-gain copy of each input to Block 1. When only a mono source is
patched into the L jack, the R channel silently duplicates L so every downstream stereo
block receives a coherent pair without the user needing to manually mult. The user hears
nothing attributable to this block under normal conditions; its audible contribution is the
absence of buzzing, clipping artifacts from external overdrive, and the convenience of
transparent mono-to-stereo normalling.

---

## 2. Theoretical Design and Topology

> ✅ **Re-verified 2026-05-30** against the locked plugin (change 0017 follow-up).
> Block A is unchanged by 0017; the clamp / R-normalling / unity-follower model below
> matches the plugin ground truth (`InputBuffer.hpp:8–10`, `Pogo.cpp:335–338`) under
> adversarial review. No behavioral edits required — this pass corrected documentation only.

### DSP-to-analog mapping

The DSP model is a single-line hard clamp:

```
V_out = clamp(V_in, −11.0 V, +11.0 V)
```

The ±11 V limit reflects the OPA1612 output swing on ±12 V rails (typ. ±11 V). In
hardware the clamp is not a software limit but a consequence of op-amp output saturation
combined with upstream Schottky diode protection. The analog realization therefore maps
directly: the clamp is the op-amp's natural output ceiling, and the series resistor plus
BAT54S diodes protect the op-amp input before the rail is ever reached.

> **Part-identity note:** the plugin source comment (`InputBuffer.hpp:5–6`) still names an
> *LM4562* follower — that comment predates the hardware part selection and is stale. The
> hardware part is **OPA1612** (see §3 / `components.yaml`), chosen for its lower noise floor;
> the behavior (unity gain, ±11 V saturation) is identical, so this is a part upgrade, not a
> behavioral deviation. The plugin comment is documentation-only and does not affect DSP.

### Transfer function

In the linear region (|V_in| < 11 V):

```
H(s) = 1      (ideal voltage follower, unity gain, zero phase shift at audio frequencies)
```

The OPA1612 has a gain-bandwidth product of ~80 MHz; configured as a voltage follower
(100% feedback) the −3 dB corner is well above 1 MHz, invisible to audio.

### Topology choice and rationale

Non-inverting voltage follower (gain = +1). Chosen because:
- Unity gain — no resistor ratio to trim or drift.
- Non-inverting — preserves signal polarity; no phantom inversion to track through the chain.
- Lowest possible output impedance for driving the next stage's 10 kΩ input.
- OPA1612 selected for noise floor: 1.1 nV/√Hz vs. TL072's 18 nV/√Hz and LM4562's 2.7 nV/√Hz.
  Because Block A sits at the head of the entire chain, its noise contribution is amplified by
  every subsequent gain stage. OPA1612 is the superior choice: it has lower noise than LM4562
  and draws half the quiescent current (2.75 mA/ch vs. 5.5 mA/ch), avoiding SOIC-8 thermal
  stress (LM4562 at 11 mA total = 264 mW in SOIC-8 exceeds the ~200 mW conservative limit).

### Input protection network

Each jack feeds:

```
jack tip ─── 100 Ω ─── BAT54S (to +12V and −12V) ─── op-amp (+) input
```

The 100 Ω series resistor limits the peak current through the Schottky clamp diodes
during an extreme overvoltage event (e.g., patching a powered output from a different
module that is at rail). BAT54S forward voltage ≈ 0.3 V at 1 mA; with the 100 Ω
series resistor, an input of +15 V results in only ~28 mA through the diode, safely
within the BAT54S 200 mA continuous rating.

### R normalling

The R jack carries a tip-switching contact. When the R jack is empty, the tip-switch
ring connects the R buffer's (+) input to the output of the L buffer. When a cable is
inserted into R, the tip-switch opens and the R channel becomes independent. This is a
passive mechanical normalling; no additional circuitry is required.

### Hardware deviations from DSP model

The DSP clamp is symmetric at exactly ±11.0 V. In hardware the OPA1612 output swing is
a function of load current and rail accuracy; it typically saturates at ±10.8 V to
±11.2 V. This is consistent with the DSP spec and requires no correction. There is no
intentional nonlinearity in this block.

→ References `aux/aux-unity-buffer.md` (Variant A, non-inverting follower), `aux/aux-cv-protection.md`

---

## 3. Physical Design

> ✅ **Re-verified 2026-05-30** against the locked plugin (change 0017 follow-up).
> Block A is unchanged by 0017. Component values, netlist (`block-A.nets.yaml`) and BOM
> verified consistent with the §2 model and the plugin ground truth. Documentation-only
> corrections applied (clamp-current derivation, series-R value rationale, aux references).

### Component values and derivations

**Series protection resistors (R1, R2): 100 Ω**
- The clamp current is set by the BAT54S holding the signal node at the rail + a Schottky
  drop (≈ ±12.3 V), *not* near ground — so the series resistor only drops the overshoot
  above the clamp voltage: I = (V_in − 12.3) / R. Worst realistic mis-patch (±17 V from a
  ±15 V system at rail): I = (17 − 12.3) / 100 = **47 mA**, comfortably within the BAT54S
  200 mA continuous rating. (An earlier note quoting 167 mA used I = (17 − 0.3)/100, which
  wrongly assumes the diode clamps to ground rather than to the 12 V rail — 100 Ω is safe.)
- 100 Ω is the Eurorack community standard, keeps source impedance / noise low, and makes
  insertion loss negligible: divider with a ~1 MΩ op-amp input ≈ 0.00001 dB attenuation.

**Clamp diodes (D1, D2): BAT54S (dual *series* Schottky, SOT-23)**
- BAT54S is a **series** dual: D1 (A1=pin1 → K1) in series with D2 (A2 → K2=pin2), the two
  meeting at the **series junction K1;A2 = pin 3**. That junction is wired to the signal node
  (after R1/R2); pin 1 (A1) → −12 V, pin 2 (K2) → +12 V. D2 (junction→+12 V) is the high clamp
  (conducts above +12.3 V); D1 (−12 V→junction) is the low clamp (conducts below −12.3 V). This
  holds the op-amp (+) input within ±(12 + 0.3) = ±12.3 V. (See aux-cv-protection.md for the pin map.)

**Op-amp (U1): OPA1612, SOIC-8**
- Dual: one package serves both L and R channels.
- Configured as voltage followers: (+) = signal input, (−) tied to output, no external
  resistors.
- Supply decoupling: 100 nF X7R 0603 from each supply pin (V+ and V−) to ground,
  placed within 2 mm of IC pins.
- Iq = 2.75 mA/channel × 2 = 5.5 mA total; P_diss = 24 V × 5.5 mA = 132 mW — within
  SOIC-8 practical limit.

### Signal routing

```
J1 (L_IN) → R1 (100 Ω) → D1 clamp → U1A (+) → U1A output → Block 1 inL
J2 (R_IN) → R2 (100 Ω) → D2 clamp → U1B (+) → U1B output → Block 1 inR
J2 (empty) → tip-switch normalling → routes U1A output to U1B (+) input
```

### Calibration points

No calibration is needed for this block. Voltage followers have no adjustable gain.
The ±11 V clamp is set by the OPA1612 rail swing — a property of the IC, not a tunable
parameter.

### Trim pots

None.

### Board assignment

Audio board. Both channels are on a single SOIC-8. Place near the panel edge where the
jacks are located to keep input traces short and shielded from digital noise.

### Power Draw Estimate

- 1× OPA1612 (U1, dual SOIC-8): ~6 mA  (Iq = 2.75 mA/channel × 2 channels = 5.5 mA)
- **+12V: ~6 mA | −12V: ~6 mA**

→ References `aux/aux-unity-buffer.md` (Variant A) for the op-amp follower ASCII schematic
primitive. (The aux/ library is ASCII-only — there are no SVG schematic files.)

---

## 4. Component Requirements

Component set: see the generated BOM `kicad/pogo-bom.csv` (rows with `Block = block-A`),
sourced from `specs/components.yaml` (the per-ref design manifest) and enriched by the
`components/` registry (MPN, footprint, datasheet). Verification status: `specs/STATUS.md`.
