jeffmhopkins/POGO/GENERATED.md

# Generated artifacts (build graph)

<!-- GENERATED by tools/build_components.py --gen-manifest — DO NOT EDIT. -->

These files are **derived** — never hand-edit them; regenerate from their source.
They are flagged `linguist-generated` in `.gitattributes`. Every other tracked file
is authored source of truth. CI `--check` gates keep each row reproducible.

| Artifact | Generator | Source(s) | --check gate |
|---|---|---|---|
| `kicad/fp-lib-table` | `build_components.py --gen-fplib` | components/footprints/*.pretty | `build_components.py --check` |
| `kicad/pogo-bom.csv` | `build_components.py --gen-bom` | specs/components.yaml + components/parts | `build_components.py --check` |
| `docs/pogo-bom.csv` | `build_components.py --gen-bom` | (copy of kicad/pogo-bom.csv) | `build_components.py --check` |
| `docs/footprints/*.svg` | `build_components.py --gen-fp` | components/footprints/*.pretty | `build_components.py --check` |
| `docs/Pogo.svg` | `build_components.py --gen-panel` | plugin/res/Pogo.svg | `build_components.py --check` |
| `kicad/pogo-*.kicad_sch` | `tools/generate_schematic.py` | specs/block-*/*.nets.yaml | `generate_schematic.py --check` |
| `docs/netlist.html` | `tools/build_netlist_viz.py` | specs/block-*/*.nets.yaml + specs/components.yaml | `build_netlist_viz.py --check` |
| `plugin/res/Pogo.svg + Pogo-source.svg` | `build_panel.py --resource --mfr` | tools/panel-data.yaml | `build_panel.py --check (DRC)` |
| `docs/panel-debug.html` | `build_panel.py --design` | tools/panel-data.yaml | `build_panel.py --check (DRC)` |
