jeffmhopkins/POGO/specs/archive/40hp-era-2026-05/kicad-process.md

# POGO — KiCad Schematic Generation Process

## Overview

POGO has no EDA files — all circuit information lives in `specs/`. This document explains how
KiCad 7 `.kicad_sch` files are generated from those specs. PCB layout is done in KiCad
directly using a hybrid approach: critical signal paths and power rails are hand-routed;
remaining traces are completed by an auto-router.

The approach: write a Python generator script per board that emits valid KiCad 7 S-expression
syntax. The generator is the authoritative source; the `.kicad_sch` file is the artifact.

---

## Board Order

| Board | Why this order |
|---|---|
| 1. Control board | Purely passive (jacks, pots, switches). No ICs. Easiest to validate format. |
| 2. Utility board | Complex (mod bus, attenuverters, THAT340s). Do after format is proven. |
| 3. Combined audio board | All analog signal processing ICs — L-channel left half, R-channel right half. Most dense. Use separate sub-sheets or zone comments to distinguish L and R areas. |

---

## File Locations

```
kicad/
  pogo.kicad_pro                    KiCad 7 project file (references all schematics)
  generate_control_board.py         Generator script → produces pogo-control-board.kicad_sch
  pogo-control-board.kicad_sch      Generated artifact (control board — complete)
  generate_utility_board.py         [planned] → pogo-utility-board.kicad_sch
  pogo-utility-board.kicad_sch      [planned artifact]
  generate_audio_combined.py        [planned] → pogo-audio-combined.kicad_sch
  pogo-audio-combined.kicad_sch     [planned artifact] (L-channel left half, R-channel right half)
```

---

## KiCad 7 S-Expression Format

A `.kicad_sch` file is a nested S-expression (Lisp-like parenthesized text). Key sections:

```
(kicad_sch (version 20230121) (generator "eeschema") (paper "A0")
  (lib_symbols          ← inline symbol geometry (defined ONCE per type)
    (symbol "Device:R_POT" ...)
    ...
  )
  (symbol               ← component INSTANCE (one per placed component)
    (lib_id "Device:R_POT")
    (at X Y angle)
    (property "Reference" "RV1" ...)
    (property "Value" "ATTACK" ...)
    ...
  )
  (global_label         ← net label (placed at pin connection point)
    "NET_WPR_ATTACK"
    (shape input)
    (at X Y angle)
    ...
  )
)
```

### How connectivity works

Instead of drawing wires across the canvas, every component pin gets a **global label** placed
directly at its pin endpoint. Two pins with the same label string are electrically connected.
This makes the schematic readable regardless of component placement.

Pin endpoint = symbol (at X Y) + pin offset from lib_symbol definition.

---

## Symbol Library Mapping

| Component | KiCad 7 lib_id | Pins | Notes |
|---|---|---|---|
| Thonkiconn PJ301M-12 | `Device:Audio_Jack_3.5mm_SwitchT` | T=Tip, S=Sleeve, SW=Switch-lug | SW breaks when cable inserted; used for normalling |
| Alpha 9mm pot (any size) | `Device:R_POT` | 1=CCW, 2=Wiper, 3=CW | Same symbol all sizes; Value = panel label |
| ALPS RS45xx slider | `Device:R_POT` | Same 3-pin | Value="SLIDER LP2 CUTOFF" etc. |
| Sub-mini toggle 2-pos (SPDT) | `Switch:SW_SPDT` | C=Common, A=throw-A, B=throw-B | GAIN switch |
| Sub-mini toggle 3-pos (SP3T) | `Switch:SW_SP3T` | C=Common, 1/2/3=positions | MOD SRC, MODE 1/2/3, POLARITY |
| IDC 34-pin (2×17) | `Connector_IDC:IDC-Header_2x17_P2.54mm_Vertical` | Pins 1–34 | CN_CTRL_1 only |
| IDC 40-pin (2×20) | `Connector_IDC:IDC-Header_2x20_P2.54mm_Vertical` | Pins 1–40 | CN_CTRL_2 (expanded from 34 to carry individual SP3T position outputs) |
| IDC 24-pin placeholder (2×12) | `Connector_IDC:IDC-Header_2x12_P2.54mm_Vertical` | Pins 1–24 | CN_CTRL_3 (21 main parameter wipers + 2 GND + 1 spare) |
| Power rails | `power:+12V`, `power:-12V`, `power:GND` | 1 pin each | Pot supply ends |

---

## Net Naming Convention

```
NET_<SIGNAL>          Audio/CV signals on jacks (NET_L_IN, NET_ENV_OUT_L)
NET_CV_<DEST>         CV override jack tips (NET_CV_FREQ1, NET_CV_LP1_CUT)
NET_WPR_<LABEL>       Pot/slider wipers (NET_WPR_FREQ1, NET_WPR_ATT_BYPASS)
NET_SW_<LABEL>        Switch outputs (NET_SW_GAIN, NET_SW_MODE1_A)
+12V / -12V / GND     Power rails (KiCad power symbols)
```

Audio jack sleeve → `GND`. Pot CCW end:
- Bipolar attenuverter: CCW=`-12V`, CW=`+12V`
- Unipolar main pot: CCW=`GND`, CW=`+12V`

All 19 CV override jack switch lugs share a single net: `NET_MODBUS_NORM`.
On the control board PCB, all 19 SW pads are wired together and to CN_CTRL_2 pin 39.
The utility board drives that pin with the processed Mod Bus output (post-AMOUNT/OFFSET,
buffered). When no cable is plugged into any CV jack, the tip sees the Mod Bus signal via
the internal Thonkiconn switch. This costs 1 connector pin instead of 19.

---

## Reference Designator Scheme

| Prefix | Component |
|---|---|
| J | Audio/CV jacks (Thonkiconn) |
| RV | Pots and sliders (rotary or slider) |
| SW | Toggle switches |
| CN | IDC connectors |

Numbering is sequential within each prefix, ordered left-to-right, top-to-bottom on the panel.
J1–J8 = audio I/O jacks; J9 = MOD IN; J10–J28 = CV override jacks (19 destinations).
RV1–RV43 = pots/sliders (43 total). SW1 = GAIN; SW2 = MOD SRC; SW3 = POLARITY; SW4 = MODE (1 shared).
CN1 = CN_CTRL_1 (34-pin); CN2 = CN_CTRL_2 (40-pin); CN3 = CN_CTRL_3 (24-pin placeholder).

---

## Design Decisions (Resolved)

### CN_CTRL_3: Main parameter wipers — 24-pin IDC

CN_CTRL_1 (34-pin) and CN_CTRL_2 (40-pin) carry audio I/O, 19 CV override jack tips, 19
attenuverter wipers, switch position outputs, and mod bus normalling signals. The remaining
21 main parameter pot/slider wipers that do not fit in CN_CTRL_1/2 are carried by **CN_CTRL_3**
(24-pin IDC, 2×12 = 21 signals + 2 GND + 1 spare):

- ATTACK wiper, RELEASE wiper
- COMB BYPASS wiper, WIDTH wiper, MASTER OFFSET wiper, FB DIST BLEND wiper
- FREQ 1/2/3 wipers, FB 1/2/3 wipers, DRIVE 1/2/3 wipers
- LP1 CUTOFF wiper, LP1 RESONANCE wiper
- LP2 CUTOFF (slider) wiper, LP2 RESONANCE wiper
- HP CUTOFF (slider) wiper, HP RESONANCE wiper

**Status: finalized.** Full 24-pin pinout: `layout-notes.md` §5. Implemented in
`kicad/pogo-control-board.kicad_sch` (CN3). Verified by `kicad/validate_schematic.py`
checks 9–11 (all 24 pin assignments).

**Switch common wiring**: All SP3T and SPDT switch commons tie directly to +12V or GND on the
control board (power symbols, no connector pin). Only position outputs and the GAIN common go
through the connector. The utility board decodes which position pin is high.

### MODE switch

**Decision: one shared 3-position vertical switch (SW4)** for all three distortion chains,
confirmed by `panel.svg` (single switch at cx=28 in Zone 1 DIST section; no per-group MODE
switches in Zones 2a/2b/2c).

CN_CTRL_2 pins 6–8 carry SW4's three position outputs: `NET_SW_MODE_SFT`, `NET_SW_MODE_HRD`,
`NET_SW_MODE_WFD`. The switch common ties to +12V on the control board; the active position is
high. The utility board decodes which of the three is high to set the CD4053 A/B state for
all three Block 4 distortion chains simultaneously.

---

## Generator Script Approach

`kicad/generate_control_board.py` produces the `.kicad_sch` by:

1. Defining all lib_symbol geometries (once per type) — correct pin count, type, position
2. Building a component list (ref, lib_id, value, net assignments per pin)
3. Placing components in a zone-based grid matching the panel layout zones
4. Emitting a global_label for every pin (net label placed at the pin's canvas coordinate)
5. Emitting power symbols (+12V, −12V, GND) for pot supply ends
6. Writing the complete S-expression to `pogo-control-board.kicad_sch`

Run from the `kicad/` directory:
```bash
cd kicad
python3 generate_control_board.py
```

---

## Validation Steps

1. Open `pogo-control-board.kicad_sch` in KiCad 7 (free download from kicad.org)
2. Run ERC (Tools → Electrical Rules Checker):
   - Expected: "pin unconnected" warnings for 3 spare connector pins (SPARE_CN2_28, SPARE_CN2_40, SPARE_CN3_24) — intentional
   - Not expected: short circuits, missing power pins, duplicate reference designators, any other floating nets
3. Check component count: 28 jacks + 43 pots/sliders + 4 switches + 3 connectors = 78 components
4. Verify connector pin assignments match `layout-notes.md` CN_CTRL_1 and CN_CTRL_2 tables
5. Export netlist: File → Export → Netlist → KiCad format → `pogo-control-board.net`

---

## PCB Layout Approach

PCB layout uses KiCad native workflow with a hybrid routing strategy:

1. Open `pogo-control-board.kicad_sch` in KiCad 7, then **Tools → Update PCB from Schematic**
   to push the netlist into the `.kicad_pcb` file
2. Component placement is generated by `kicad/generate_control_pcb.py` (reads
   `kicad/layouts/control-board.json` for positions derived from `specs/panel-design/panel.svg`)
3. **Hand-route first**: power rails (+12V, -12V, GND planes), I_abc signal traces (critical
   for noise — see noise-audit.md H2/H3), and any traces where adjacency matters
4. **Auto-route remaining**: run the KiCad built-in auto-router (or external: FreeRouting)
   on all remaining unrouted nets
5. Run DRC after auto-routing; fix any violations manually

Footprints for all parts are committed to `kicad/footprints/` sourced from the KiCad
official footprint library and manufacturer datasheets. No footprint geometry is hand-coded
from memory — see commit history for source citations.

---

## Template for Subsequent Boards

Each board's generator script follows the same structure:

| Section | Content |
|---|---|
| lib_symbols | Only types used on that board |
| Power symbols | +12V, -12V, GND at every IC supply pin |
| Component instances | One per IC, resistor, capacitor, etc. |
| Global labels | Net name at every pin |
| Connector block | Stacking header footprints (STK_AUDIO_L / STK_AUDIO_R) or IDC connectors (CN_CTRL) |

For the utility board: add `Device:R` (resistors), `Device:C` (caps), `Amplifier_Operational:TL074`
(quad op-amp SOIC-14), `Amplifier_Operational:TL072` (dual op-amp), and the THAT340 (custom
symbol needed — 16-pin SOIC with 4 NPN transistors). Stacking header connectors for
STK_AUDIO_L and STK_AUDIO_R (2×20 2.54 mm): use `Connector_PinHeader_2.54mm:PinHeader_2x20_P2.54mm_Vertical`.

For the combined audio board: additionally `Amplifier_Operational:LM13700` (18-pin DIP/SOIC OTA),
`Amplifier_Operational:LM4562` (SOIC-8), `Amplifier_Operational:NE5532` (SOIC-8),
and the CD4053 analog switch (SOIC-16). The schematic should use zone annotations or
hierarchical sub-sheets to distinguish L-channel (left half) and R-channel (right half)
components. All L-channel reference designators end in _L (e.g., IC_Q_AB_L); all R-channel
end in _R. The center GND strip appears as a power symbol cluster with no signal connections.
