jeffmhopkins/POGO/changes/0020-cv-conditioning-fixes.md

# 0020 — CV-conditioning & behavioral netlist fixes (adversarial-review findings)

- **Lane:** B→**A/B MIXED (reclassified 2026-05-30).** Mostly Lane B (spec/nets/components follow the
  locked plugin), BUT §E introduced a **Lane A plugin DSP change** (ALT_BP_L/R made fully independent —
  dropped the R→L normal + symmetric per-channel BP3 gating in `Pogo.cpp`). That slice needs G3 (VCV
  Rack verification) + a `plugin.json` version bump before close.
- **Status:** OPEN — G1 confirmed (fix all CRIT+HIGH; full H5/H6/M5 fixes). Working per cluster.
  **✅ G3 PASSED (user, 2026-05-30): "plugin was good in branch"** — §E ALT-independence verified in
  VCV Rack from the branch CI build. **Plugin LOCKED @** `Pogo.cpp` blob
  `e611fa720bfbe6100f7d011d7ba0e1038f7c9662`, `plugin.json` blob `4188c1cea48208074e55d38f24566ad5c9a9723a`
  (v2.1.0). Any further plugin edit re-opens G2/G3.
- **Opened:** 2026-05-30
- **Branch:** `change/0020-cv-conditioning-fixes` (now rebaselined on `dev` after #48/0019 merged).
- **Stacked-on:** 0019 (merged to dev via #48; 0020's merge-base is 0019's tip — clean, no rebase needed).

## Intent

A 6-agent adversarial review (plugin→spec→nets→schematic, primary sources) found the **signal
paths sound** but the **CV-conditioning sub-circuits and a few change-0018 behavioral wirings
wrong** vs the locked plugin. Fix the confirmed netlist/topology defects so the hardware spec
faithfully reproduces the plugin. No plugin/panel change (Lane B).

## Findings to address (prioritized; severity from review, ✓ = I independently verified)

### CRITICAL
- **C1 — Expo V/oct has no attenuation divider (blocks 5,7,8 + 6 by inheritance). ✓**
  CV reaches the THAT340 base through series R only (`R_VOCT`+`RV_1VOCT`), no shunt → no ~18 mV/oct
  scaling; converter rails. Needs a base divider (≈1:55) / proper summing node + the 1V/oct trim
  acting within it. (block-5/7/8 nets + aux-expo-converter §Schematic/Transfer.)
- **C2 — Mod-bus delivers ~3% depth at unpatched destinations (block 3). ✓**
  100 kΩ `R_SRC_NORM` into a ~3.3 kΩ destination node (10 kΩ inverter-in ∥ 10 kΩ pot) → ÷31.
  Fix: low-Z/direct normal (tip-switch breaks it) or buffer per destination. Pairs with H-mod below.
- **C3 — LP1 stereo-tilt "summer" injects into the raw expo base, not a summing node (block 5). ✓**
  Same root as C1; tilt scaling unrealizable. Fix together with C1.

### HIGH
- **H1 — BP3 input selector ignores ALT_BP_R (block-6-dist3). ✓** `ALT_L_DET` drives both U81
  selects; no `ALT_R_DET`. Plugin gates BP3_R on `altLConn||altRConn` (`Pogo.cpp:441`). Need an
  ALT_R detect + an OR into the Y(R) select; X(L) select stays on ALT_L_DET.
  **CONSTRAINT (found 2026-05-30):** `J4.3` (ALT_R jack's only switch lug) is already the
  normalling contact (`block-1.nets.yaml:76` `ALT_L_IN:[...,J4.3]` realizes the plugin's
  "normalise R to L if only L patched"). PJ301M-12 has one switch contact, so J4 can't both
  normal and cleanly detect — the ALT_R_DET derivation is a **G5 topology decision** (options:
  comparator off the normalling node / a second detect scheme / document as a minor limitation).
- **H2 — Mod-bus distribution buffer specified but absent (block 3).** Spec says U3 C/D parallel
  buffer; nets ground them as spares. Bare `MB_INV` (one TL074 section) drives 18 loads. Fix with C2.
- **H3 — VCA "unity trims" are series rheostats into the high-Z Ec+ port (block-4; copied to
  block-6 DRIVE trims). ✓** Series R can't set a DC offset on a µA control input. And the shared
  unbuffered V_CTRL wiper couples all 4 cells. Needs a real offset-injection (divider→Ec+) + a
  wiper buffer.
- **H4 — Wavefold phase — ❌ WITHDRAWN (SPICE-refuted 2026-05-30).** SC/HC/WF all share small-signal
  sign (−drive) from the common node; the VCA inversion is common, no relative flip. See §F. No change.
- **H5 — State variable tapped from LM13700 Darlington buffer → ~1.2 V DC into next OTA input
  (blocks 5,7,8).** Saturates the µV-class OTA input. Tap the unbuffered integrator node, or
  offset-correct. (Needs bias analysis to confirm severity/fix.)
- **H6 — Q=2000 self-osc needs ~260 pA Iabc, below LM13700 floor (5,7,8).** Top decade of Q
  uncontrollable. Likely a documented-limit + soft-limit addition rather than a full fix.

### MED (fold in where cheap)
- **M1 — BP3 R→L output normal averages (L+R)/2 through 2×1 kΩ instead of delivering L (block-6-mix). ✓**
- **M2 — Mod OFFSET range ±12 V vs plugin ±5 V (block 3).** Scale R15 or use ±5 V references.
- ~~M3 — BP per-band TILT CV missing the plugin ×0.22.~~ **RESOLVED / NON-ISSUE (verified
  2026-05-30).** block-6-svf1/2/3 already apply it: `R137/R143/R149 = 470k` into the 100k tilt
  summer = ×0.213 ≈ plugin ×0.22 (the net comment even says so). block-3's BP-tilt destinations are
  plain attenuverters feeding `MOD_BP{n}_TILT` into that summer; the scaling is applied once, in
  block-6, matching the plugin's single `×0.22f`. No change needed — dropped from scope.
- **M4 — I/V transimpedance has no feedback comp cap (block-4, 4 channels).** Add small C_f.
- **M5 — Q-cell Iabc bias math ignores the Iabc-pin rail potential (5,7,8).** Recheck arithmetic.

### Decisions made (G1, 2026-05-30)
- **Scope: fix all confirmed CRITICAL + HIGH defects in this one change (0020)**, plus the cheap
  MEDs (M1, M2, M4, M5). M3 dropped (non-issue, verified).
- **H5/H6/M5: full netlist fixes now** (not deferred to Phase-3R), backed by deeper LM13700
  datasheet analysis.
- Mod-bus strategy + expo divider topology will still be presented at **G5** for approval before
  the nets are rewired (the *decision to fix* is made; the *exact topology* is the G5 gate).

## Status
- **Status:** OPEN — G1 confirmed. Working cluster-by-cluster, committing per cluster.

## Scope / blocks
block-3, block-4, block-5, block-7, block-8, block-6-svf{1,2,3}, block-6-dist{1,2,3}, block-6-mix;
aux-expo-converter, aux-q-control, aux-ota-c-svf, aux-vca-cell, aux-mod-bus-core, aux-distortion;
components.yaml (new parts: shunt resistors, comp caps, possible buffer op-amps, ALT_R detect).

## Reconnaissance notes (wiring facts gathered before G5)
- **M1 mechanism (block-6-mix:88-89):** `BP3_L_OUT:[J27.1, J28.3]` + `BP3_R_OUT:[J28.1]`. BP3_L/R_OUT
  are block-B-buffered (U62, 1k series each). J28 unpatched shorts tip↔switch → ties both buffer
  outputs through 2k → tip = (L+R)/2, and back-feeds R into the J27(L) node. Fix: normal the L
  *source* into J28's switch ahead of R's buffer/series-R, not tie two driven outputs. (Wiring-only.)
- **H4 (WF phase, dist3 + dist1/2):** WF folder `BP3_WFOUT = 2·Vclamp − Vfoldin` with the leading
  DRIVE-VCA I/V inversion makes WF net-inverting while SC/HC are net non-inverting. Fix: add one
  unity inversion in the WF path (or swap a summing polarity) so all 3 modes share sign. Need to
  confirm a free op-amp half exists per dist section (U38/39/44/45 usage) — else +1 component.
- **H1 (BP3 selector):** see CONSTRAINT above — J4.3 already normalling; ALT_R_DET source is a G5 call.

---

## G5 TOPOLOGY PROPOSAL (2026-05-30) — awaiting user approval

Datasheet-grounded values from a focused analog-design pass (LM13700 SNOSBW2F, THAT340 Doc 600041).
Confidence tags: **[HC]** high (math/datasheet solid, verified) · **[NV]** needs datasheet re-verify
(PDF text-extraction unavailable in this env — structural argument sound, exact value to confirm).

### A. Expo V/oct divider — fixes C1 (+C3 base) — blocks 5,7,8 + propagate to 6-svf1/2/3 [HC, SPICE-validated]
- **Root cause:** V/oct CV lands on the THAT340 base through series R only (no shunt) → ratio≈1 → rails.
- **Fix:** add a base divider. ΔV_BE/oct = V_T·ln2 = **17.92 mV/oct** → 1 V ÷ ~55.8.
- ⚠️ **SPICE caught a 2.1× error in the first-pass values (2026-05-30).** The analysis gave R_SHUNT
  866Ω *and* a 1k tempco in series → real shunt leg 1866Ω → 37.8 mV/V (2.1× too high). Corrected
  topology (`specs/sim/expo_voct.cir`): **the +4110ppm tempco (Vishay TFPT 1k) IS the shunt leg to GND**
  (whole shunt tracks temp), and the **series leg sets the ratio**.
  - Validated: `R_VOCT ≈ 51.1k (E96)` + `RV_1VOCT 10k` (series wiper) + `R_TEMPCO = TFPT 1k` shunt→GND
    gives **19.19 → 16.10 mV/V across full trim, 17.92 at ~38% rotation** — target centered with
    authority both sides. (Final series R tuned to E96 to center 17.92 at mid-rotation; SPICE picks it.)
  - Shunt (the tempco) to **GND**, not the I_ref node (loading I_ref shifts f_ref). f_ref trim (RV_REF)
    stays — orthogonal. R_E (1k) + I_ref net unchanged.
  - Tempco SLOPE: TFPT +4110 ppm/K vs ideal ~+3413 ppm/K over-compensates ~20% — RV_1VOCT sets the
    room-temp setpoint; residual tempco-slope error is a documented limit (bench-trimmable, not a value bug).
  - **New part = tempco (G6a, Vishay TFPT, decided).** R_VOCT/RV unchanged types. Counts: LP1=2 (L+R),
    HP=1, LP2=1, BP×3=2 each → ~8 tempco + 8 series-R changes.

### B. LP1 tilt summing node — fixes C3 — block-5 [HC] — DESIGN REFINED 2026-05-30
- **Plugin:** `lp1TiltV = LP1_TILT×5` → full tilt **±5 V/oct**; L=base+tilt, R=base−tilt; sums 1:1 with V_freq.
- **Why it's mandatory once §A lands (SPICE `lp1_tilt_sum.cir`):** §A adds the tempco shunt (~1k base→GND).
  The current tilt injection (R55/R56 100k → raw base) then divides ~99% away. So tilt MUST be summed
  with V_freq **before** the §A divider, not at the base.
- **Polarity finding (SPICE):** a plain inverting summer flips sign (out = −(Vf+Vt)). The expo needs
  +mV/+octave at the base. **Cleanest topology (proposed):** sum V_freq + (±V_tilt) at the **top of the
  R_VOCT divider** (the divider input node `a`, not the base), so the existing divider+tempco scales the
  *summed* octave command. Per channel: a summing junction feeding R_VOCT. L sums +V_freq + (+V_tilt);
  R sums +V_freq + (−V_tilt) (U13-A already makes −V_tilt). Sign handled by driving the summer from the
  already-correct-polarity freq/tilt sources (no extra inversion) OR one shared inverter.
- **Op-amp budget:** needs up to **2 summer halves** (L+R). U13 both halves are used (tilt-inv + IRES_AMP),
  so this is **+1 dual op-amp** (TL072) on block-5 — a G6 item (existing type, new ref).
- ⚠️ **block-5 is the convergence of §A + §B + §C(OTA tap) + §D(Q-cell) + the shared U9/U10 Q-VCAs.**
  These interact (same expo nodes, same SUM_AMP, same V_ires). **Plan: do block-5 as ONE combined
  edit** (A+B+C+D together) rather than piecemeal, to avoid regenerating an inconsistent intermediate.
  Pending: finalize the summer node topology + the +1 TL072 ref, SPICE the combined base response, then wire.

### C. OTA state-variable tap — fixes H5 — blocks 5,7,8 [HC, pure reroute]
- **Root cause:** v1/v2 tapped from LM13700 **Darlington buffer** outputs (pins 8/9), ~1.2–1.4 V
  (2·V_BE, temp-dependent) below the integrator node → injects ~1.3 V DC into the next OTA's ±30mV input.
- **Fix:** tap v1 from **pin 5**, v2 from **pin 12** (the unbuffered OTA outputs = the cap nodes; merge
  `*_V1_*` into `*_V1CAP_*`, `*_V2_*` into `*_V2CAP_*`). Use the Darlington buffer (8/9) **only** for
  output-jack / inter-block low-Z drive, never inside the loop or into an OTA input. **No new parts.**
  47nF C0G caps stay on pins 5/12; f_ref math unchanged (gm/C identical) — removing the buffer *improves*
  DC accuracy.

### D. Q-cell Iabc bias + self-osc — fixes M5 (bias) + H6 (range) — blocks 5,7,8 [NV — re-verify pin V]
- **M5 root cause:** spec assumes Iabc = V_ires/R_Iabc with the bias pin at 0 V. The LM13700 Iabc pin
  actually sits ~2·V_BE above V− (**≈ −10.8 V at −12V rails**), so a 1 MΩ from a ~0 V node delivers
  ~10.8 µA almost regardless of control → Q pinned at min. **(Structurally certain the pin is near V−,
  not GND; the exact 1-vs-2 V_BE figure is the [NV] item.)**
- **Proposed fix:** `R_Iabc` 1MΩ → **100k**; IRES_AMP drives V_ires **negative** in the ~−10.0…−10.8 V
  window (Iabc = (V_ires−V_pin)/R_Iabc); **fix the clamp polarity** (current BAT54 clamps V_ires≥0,
  wrong sign — should prevent going below V_pin).
- **H6 root cause:** Q=2000 needs Iabc≈**260 pA**, far below the LM13700 controllable floor (~10–100 nA).
  Honest controlled Q_max ≈ **10–50**.
  - **Proposed:** clamp the *controlled* Q range to ~≤10 and reach self-oscillation via a **soft-limit:
    2× BAT54S antiparallel across the BP-tap integrator cap** (BAT54 already in BOM — no new part type).
    Alternative (cleaner, bigger blast radius): lower R_in so a comfortable Iabc maps to high Q — but
    R_in is the SVF summing/gm-reference resistor, so it ripples into SUM_AMP gains. **Recommend the
    soft-limit option.**

### E. BP3 input selector ALT_R — fixes H1 — block-6-dist3 + block-1 [topology decision]
- Plugin: `bp3InR = (altLConn || altRConn)`; `bp3InL = altLConn`. Hardware gates BOTH selects on
  ALT_L_DET only.
- **Truth table (verified 2026-05-30 against `Pogo.cpp:345-441`):** the ONLY divergent case is
  **"ALT_R patched, ALT_L empty"**: plugin sends ALT→BP3_R, hardware leaves BP3_R on LP1 (bandR). All
  other 3 patch states already match. And the L channel is correct in ALL cases (only R is wrong) →
  **the fix is R-channel-only.**
- **Confirmed the ALT_R *signal* normal already works in hardware:** `block-1.nets.yaml:76` ties J4.3
  (R jack switch lug) into `ALT_L_IN`, so an unpatched R jack routes the L signal into the R gain
  stage → R VCA — matching the plugin's `altR = (altLConn ? altL : 0)`. So §E is ONLY the *selector
  gating*, not the signal path.
- **J4 switch-lug constraint:** J4.3 is the signal-normal contact (can't also be the detect). The
  ALT_L detect (`ALT_L_DET=J3.3`) uses J3's *switch lug*, but J3 doesn't need its lug for normalling
  (L is master); J4 does. → derive ALT_R_DET by **tip-sensing** instead (independent of the lug).
- **Proposed E1+E2 (refined):**
  - **E1 — tip-sense ALT_R_DET (block-1):** `ALT_R_TIP` already has the 100Ω + a pulldown pattern
    available; add a detect that goes HIGH when a plug drives the tip. Simplest robust form: a small
    NPN (MMBT3904, already in BOM) or comparator referencing the tip vs a threshold → logic-level
    `ALT_R_DET`. +1 small part on block-1. (SPICE-check the threshold + that it ignores audio swing.)
  - **E2 — OR into R select only (block-6-dist3):** `ALT_R_DET` OR `ALT_L_DET` → U81 **Y/R** select
    (pins 10? — verify which select pin is the Y channel); **X/L select stays ALT_L_DET alone.**
    Diode-OR (2× 1N4148 + pullup) into the existing R133 pull-up node. No new part type.
  - **E3 (fallback):** document the narrow "R-only patched" limitation, no change.
  - **Recommend E1+E2.** NOTE: tip-sense detect is an [NV]-class analog choice (threshold vs audio
    swing) — SPICE the detector before wiring; if it proves fiddly, fall back to E3 + document.

#### ⚠️ E1 INFEASIBLE — finding 2026-05-30 (overrides the E1+E2 selection)
While designing the MMBT3904 tip-sense detector I proved it **cannot work reliably**, and that the
whole E1 premise is flawed:
- **A tip-VOLTAGE sense can't distinguish "patched but silent" from "unpatched."** Both leave the J4
  tip near 0 V (a patched cable from an idle source = 0 V; unpatched = floating/pulled). The *only*
  unambiguous "plug inserted" signal on a switched jack is the **switch contact opening** — which on a
  PJ301M is the single lug J4.3, already consumed by the R→L signal normal (`ALT_L_IN`).
- **One switch contact cannot do both** a reliable insertion-detect and the signal normal. This is a
  hardware reality of the chosen jack, not a wiring oversight. (Contrast J3/ALT_L: J3's lug is free for
  detect precisely because L, as master, needs no normal.)
- **Options that remain real:**
  - **E3 — document the narrow limitation (now recommended).** The only divergent case is "ALT_R
    patched, ALT_L empty"; leave wiring, document. Zero new parts, zero new [NV] analog.
  - **E-dual-jack — switch to a dual-switch (NN) jack for J4** (e.g. a Thonkiconn with 2 switch
    contacts / a different jack PN): one contact does the normal, the other the detect. New part type
    (G6) + panel/footprint change — heavier than the bug warrants.
  - **E-source-normal — move the R→L normal to the amp input** (feed `ALT_R_IN` from `ALT_L_IN` via the
    lug) and use the **tip+pulldown as detect** — but this still hits the patched-silent ambiguity
    above, so it does NOT actually recover a reliable detect. Rejected.
- **Recommendation: E3.** The "R-only patched" case is an unusual mono-into-right patch; reproducing it
  faithfully costs either a new dual-switch jack (G6 + panel) or an unreliable analog sense. Documenting
  the limitation is the honest, proportionate call. **Needs user OK to drop E1+E2 → E3.**

#### E DECISION (user, 2026-05-30): dual-switch jack for J4 — full parity
- Replace J4 (ALT_BP_R) with a **dual-switch 3.5mm jack** (two switch contacts): contact 1 = R→L signal
  normal (as today), contact 2 = independent ALT_R insertion-detect → `ALT_R_DET`. Then E2: OR
  `ALT_R_DET` with `ALT_L_DET` into U81's **R-channel select only**; L-select stays `ALT_L_DET`.
- **NEW PART TYPE → G6a/G6b required** before any net references it: real dual-switch jack MPN +
  datasheet + a new symbol (≥5 pins: tip / tip-switch / ring-or-sleeve / 2nd-switch / sleeve) + a
  vendored footprint + `footprints.yaml` panel binding. Also a **panel/footprint implication** (J4
  mechanical footprint changes) — coordinate with the panel build.
- Part research launched (background). G6a STOP until a real MPN + datasheet land. §E netlist edit
  (block-1 J4 + dist3 OR) waits on that.

#### E — jack research result (2026-05-30): a panel-mechanical tradeoff surfaced
- **Amphenol ACJS-MV35-5** — *only confirmed dual-switch* vertical 3.5mm jack. 5 pins (T=4, TN=5,
  R=2, RN=3, S=1; two independent switch legs — datasheet 55010544-001-5). BUT **M6 bushing, not
  the M8 Thonkiconn standard** → J4 becomes a mechanical outlier among POGO's ~24 jacks (different
  panel hole), and the footprint must be **vendored** (no stock KiCad fp). Symbol `AudioJack3_SwitchTR`
  exists in stock KiCad. Datasheet: amphenol-sine.com/pdf/datasheet/ACJS-MV35-5.pdf.
- **Qingpu WQP-PJ3410** — Thonk-ecosystem, **M8 (fits the standard)**, taller. BUT dual-switch status
  **UNCONFIRMED** — marketing says "switching on tip"; the clacktronics lib maps it to a switched-T/R
  symbol only as a *substitute*. If it's switched-tip-only it does NOT give the detect → back to square
  one. Would need physical verification.
- **The tradeoff:** parity-certain (Amphenol, panel outlier + vendored fp) vs ecosystem-fit-but-risky
  (PJ3410, unconfirmed). All to fix the narrow "ALT_R-only patched" case. **E3 (document) remains the
  proportionate fallback** now that the dual-switch route is shown to cost a panel-standard break or a
  sourcing risk. → user decision needed (next question).

#### ✅ E RESOLVED (user, 2026-05-30): keep ALT L & R fully INDEPENDENT (Lane A plugin change)
Rather than chase a dual-switch jack to reproduce the R→L normal, the user chose to **make ALT_BP_L/R
independent** — which dissolves the whole problem: each jack does one job (self-detect via its own
switch lug), no dual-switch jack, no M8→M6 panel break, no new part type. Cleaner behavior (true stereo
ALT input) too. This is a **plugin (Lane A) change** (plugin leads), done here per user direction:
- **Plugin (`Pogo.cpp`):** `altR = altRConn ? PreGain(...) : 0` (dropped the `altLConn ? altL : 0`
  R→L normal); `bp3InR = altRConn ? VcaBlock(...) : bandR` (was `altLConn||altRConn`). L unchanged.
  → **✅ G3 PASSED** (user verified in VCV Rack, 2026-05-30); plugin LOCKED @ v2.1.0.
- **block-1:** J4 now mirrors J3 — `ALT_R_DET:[J4.3]` (own switch lug) + `R225` 22k tip pulldown on
  `ALT_R_TIP`; removed `J4.3` from `ALT_L_IN` (R→L normal gone). New boundary `ALT_R_DET`.
- **block-6-dist3:** split the U81 selects — X/L select (pin11/A) stays `ALT_L_DET`; Y/R select
  (pin10/B) now `ALT_R_DET` with its own `R226` 100k pull-up. New boundary `ALT_R_DET`.
- **components.yaml:** +R225 (block-1, 22k), +R226 (block-6-dist3, 100k). No new part *type*.
- **Gates:** all green (components/build_components/netlist-viz/panel + schematic, only the pre-existing
  jack-pad WARN); `ALT_R_DET` boundary resolves across both sheets. BOM regenerated.
- **Supersedes** the dual-switch-jack plan above and the earlier E1/E2/E3 options. The narrow divergence
  is now *fully fixed* (R gates on its own input), not documented-around.

### F. WF phase — H4 — block-6-dist1/2/3 — ❌ WITHDRAWN (H4 is FALSE; no change)
- Original claim: WF net-inverting vs SC/HC → add an inversion. **SPICE refuted it** (`specs/sim/wf_phase.cir`).
- Net trace from the common `BP1_DRIVEOUT` node: SC = inverting amp (R18/R19) → −drive; HC = inverting
  (R20/R21) → −drive; WF = stage-1 invert (V_foldin = −drive) then folder `2·V_clamp − V_foldin` = below
  threshold = +V_foldin = −drive. **All three are −drive → same small-signal sign.** The DRIVE-VCA
  inversion ahead of them is common to all three, so it cannot create a *relative* phase difference.
- SPICE: SC and WF slopes identical (both −1 V/V near 0; ∓1.0 at din=±1); WF folds above ±1.4V while
  SC stays linear, but **phase agrees**. The agent's "Vfoldin=−Vin" was a sign-tracking error.
- **Decision: NO netlist change.** Adding an inversion would have *introduced* a phase bug across all
  3 bands. (2nd SPICE catch of a wrong proposed fix — validation working as intended.)

### G. BP3 R→L output normal — fixes M1 — block-6-mix + block-B [HC, wiring] — ✅ IMPLEMENTED
- Re-route so J28's switch lug taps the **L source ahead of R's buffer/series-R** (true "R normals to L"),
  instead of tying two driven 1k outputs together (which gives (L+R)/2 and back-feeds the L jack).
- **DONE (2026-05-30):** added boundary net `BP3_L_BUF` = block-B U62A stiff output (pre-R36);
  `block-6-mix` J28.3 (switch lug) now taps `BP3_L_BUF` instead of `BP3_L_OUT` (post-1k). block-B
  exports `BP3_L_BUF` as boundary. SPICE `bp3_normal.cir`: buggy = J27/J28 both (L+R)/2 = 2.0V;
  fixed = J28 tip clean 3.0V, J27 undisturbed. Gates: schematic --check OK, netlist-viz OK.

### H. Mod-bus depth + buffer — fixes C2 + H2 — block-3 [topology decision]
- C2: 100k `R_SRC_NORM` into a ~3.3k destination node → ~3% depth. H2: spec'd distribution buffer is
  absent (U3 C/D grounded as spares); bare MB_INV drives 18 loads.
- **Options for G5:**
  - **(H-a)** Direct/low-Z normal: bus normals onto V_src via the jack tip-switch (override breaks it),
    drop R_SRC_NORM; **re-enable the U3 C/D distribution buffer** (per the spec's own §145) to drive the
    18×~10k loads (~18 mA). Cleanest plugin parity. **Recommend.**
  - **(H-b)** Per-destination buffer (18 unity buffers) — many parts, overkill.
  - **(H-c)** Raise destination input impedance (10k→100k pots+inverters) so 100k norm divides less —
    changes 18 attenuverter scalings + noise. Not recommended.
- Also fold **M2** (mod OFFSET ±12V→±5V: scale R15 or use ±5V refs) and confirm **M4** (block-4 I/V comp
  cap, add small C_f ~few pF across R_f, 4 ch) here.

#### H — SPICE-validated (2026-05-30). `specs/sim/modbus_depth.cir` + `modbus_load.cir`
- Depth: buggy 100k-norm → **~3–4.8%** at an unpatched destination; **direct low-Z normal → ~98%**.
  C2 confirmed + fixed.
- ⚠️ **Buffer-load REVISED (modbus_load.cir, exact attenuverter model):** my 10k estimate was wrong —
  it ignored the pot's path to −V_src. Exact per-dest load = `R_INV_IN(10k to vground) ∥ pot(10k to
  −V_src=inverted copy, looks like 5k)` = **3.33k**. Model **reconciles the 3% bug figure exactly
  (3.22%)**, confirming it's right. → **~2.9 mA/dest, ~52 mA for all 18 at +10V.**
- **The mod bus is ONE source normalled to ALL 18 destinations at once**, so all-18-at-+10V is the
  REAL worst case, not rare. **52 mA exceeds 2× TL074 sections (~40 mA peak) → H-a is UNDER-SPEC.**
- **Buffer options (user decision needed):** (i) **3× TL074 ∥** (~60-75mA) — but U3 has only C+D free,
  needs a 4th IC section / new TL074; (ii) **op-amp + BJT push-pull current boost** inside the feedback
  loop (>100mA robust, +2 transistors — MMBT3904/3906 class); (iii) reduce the load (raise R_INV_IN
  10k→larger across 18 dests — but that changes attenuverter scaling/noise). **Recommend (ii)** — a
  transistor-boosted unity buffer is the standard, robust mod-bus distribution driver.

#### ✅ H BUFFER DECISION (user, 2026-05-30): raise destination impedance (option iii)
SPICE `modbus_hiZ.cir`: scaling the attenuverter network **×5** (R_INV_IN/FB 10k→**47k**, pot
10k→**50k**; preserves the −1 inverter gain + ±1 attenuverter ratio, only impedance up) →
**0.61 mA/dest, ~11.0 mA for all 18 at +10V** — comfortably within the re-enabled 2× U3 TL074
distribution buffer (~40 mA peak). **No transistor boost, no extra IC.** Modest noise penalty (47k
Johnson ≈ 28 nV/√Hz vs 18 nV at 10k) — acceptable on CV (non-audio) paths.

#### ✅ §H IMPLEMENTED (2026-05-30) — C2 + H2 + M2 fixed, all gates green
- 18 attenuverters scaled ×5 (R_INV_IN/FB 10k→47k in nets + BOM); R_SRC_NORM (18× R18) **removed**;
  each jack switch lug now ties **directly** to the buffered `V_MODBUS` rail (low-Z normal). U3 C/D
  re-enabled as paralleled unity distribution buffer (MB_INV out → U3.10/U3.12 in+ → U3.8/U3.14 out
  → R227/R228 47Ω share → rail). M2: R15 100k→240k (OFFSET ±12V→±5V). +R227/R228 BOM rows; R18 row
  dropped. block-3 schematic regenerated (141 parts/111 nets), all `--check` gates + parity green.
- SPICE: depth ~3%→~98%; buffer load ~11mA (within 2× TL074). Verified V_MODBUS = 18 jack lugs + 2
  share Rs, no R18 part remains.

#### §H EDIT PLAN (validated; done — see above)
1. **18 attenuverters:** `R_INV_IN_n`/`R_INV_FB_n` 10k→**47k** (nets); `R_INV_IN`/`R_INV_FB` qty-18 BOM
   rows 10k→47k; pot value tag stays `lin pot` but spec the value as **50k** (RV6–RV23).
2. **Drop the normalling R:** remove the 18× `R18_n` parts + their `JSW_*`↔`V_MODBUS` series; instead
   tie each `JSW_*` (jack switch lug) **directly** to `V_MODBUS` (low-Z normal; override plug breaks
   it). Remove the `R18` qty-19 BOM row (it was already mis-counted as 19; the VCA normal isn't an R18).
3. **Re-enable U3 C/D buffer:** `U3_SPARE_3/4` → paralleled unity followers driving `V_MODBUS` from
   `MB_INV` output, each via a small ~47Ω share R (R227/R228). V_MODBUS becomes the buffered rail.
4. **M2 (OFFSET ±12V→±5V):** RV4 wiper currently spans ±12V into R15=100k (gain 1 vs R13=100k). Scale
   so the wiper's usable range maps to ±5V: change R15 100k→**240k** (±12·100/240 ≈ ±5V at the summer).
5. Regenerate sch/BOM/viz; full gate stack; commit.
- **Edit plan (block-3):** (1) drop the 18× `R18_n` (R_SRC_NORM 100k); (2) jack switch lug ties
  `V_MODBUS` directly to each tip (low-Z normal, override plug breaks it); (3) re-wire `U3_SPARE_3/4`
  → paralleled unity buffer driving `V_MODBUS` (each via a small ~47Ω share resistor); (4) M2: rescale
  the OFFSET path (R15) for ±5V. Big 18-destination rewrite — do as its own commit + re-gate.

### New out-of-scope finding (log, separate change)
- **THAT340 has NO internal PTAT/tempco** — aux-expo-converter's "on-chip compensation" is wrong. A real
  V/oct design needs an external **+3300 ppm/°C tempco resistor** in the expo (e.g. series with R_SHUNT).
  This affects ALL expo converters (5,7,8,6×3). Recommend a **separate change 0021** (it's a new
  component type + every expo), not folded into 0020. Flagging now so it isn't lost.

### G5 DECISIONS (user, 2026-05-30) — APPROVED, proceed
1. **Mod-bus (H):** ✅ **H-a** — low-Z normal via jack tip-switch (drop R_SRC_NORM) + re-enable U3 C/D
   distribution buffer to drive the 18 loads.
2. **BP3 selector (E):** ✅ **E1+E2** — add ALT_R detect (+1 part on block-1) + OR with ALT_L_DET into
   the R-channel select. Full plugin parity.
3. **Q-cell (D):** ✅ **Proceed, flag [NV]** — implement R_Iabc 1M→100k, negative V_ires drive, fix
   clamp polarity, soft-limit diodes for self-osc; mark the LM13700 Iabc-pin-voltage-dependent values
   as needing datasheet/bench re-verify at prototype.
4. **THAT340 tempco (out-of-scope finding):** ✅ **Fold into 0020** — add external +3300 ppm/°C tempco
   resistor to every expo converter (blocks 5,7,8 + 6-svf1/2/3). NEW PART TYPE → G6a/G6b required.

## G6 — new components (gate before any net references them)
| Item | Part | New type? | Gate |
|---|---|---|---|
| Expo base shunt (§A) | R_SHUNT 866Ω 0603 | no (generic R, new value) | — |
| Expo tempco (§4 fold-in) | **tempco resistor +3500 ppm/°C** (e.g. Vishay TFPT/PTF series or KRL) | **YES** | **G6a+G6b** |
| Tilt summer op-amp (§B) | TL072/OPA1612 half | no (existing type, new ref) | — |
| WF invert op-amp (§F) | TL072 half | no (existing type, new ref) | — |
| ALT_R detect (§E1) | MMBT3904 + R (existing) or comparator | no (MMBT3904 in BOM) | — |
| E2 OR gate | 2× 1N4148W + pullup (existing) | no | — |
| Q soft-limit (§D/H6) | 2× BAT54S antiparallel (in BOM) | no | — |
| I/V comp cap (§M4) | C_f ~10pF 0603 (existing type) | no | — |
- **Only the tempco resistor needs G6a/G6b.** Candidate to confirm: a discrete PTC/tempco resistor with
  ~+3300–3500 ppm/°C to compensate the expo's −1/T base-emitter tempco. Need a real MPN + footprint +
  datasheet. **G6a STOP: confirm the tempco-resistor MPN before it enters any netlist.**

## Implementation plan (cluster-by-cluster, commit per cluster, gates per CLAUDE.md Step 5-7)
1. **G6a** tempco resistor part selection (STOP for confirm) → registry + datasheet + footprint.
2. **Cluster expo+tilt** (A,B,§4): block-5/7/8 + 6-svf1/2/3 nets + aux-expo-converter §2-3 + aux-ota-c-svf.
3. **Cluster OTA-tap** (C): block-5/7/8 nets (reroute) + aux-ota-c-svf.
4. **Cluster Q-cell** (D): block-5/7/8 nets + aux-q-control.
5. **Cluster block-6** (E,F,G): dist1/2/3 (WF invert), dist3 (ALT_R sel), mix (BP3 normal) + block-1 (ALT_R det).
6. **Cluster mod-bus** (H,M2): block-3 nets + aux-mod-bus-core; **block-4** M4 comp cap + (carry HIGH-3
   VCA Ec+ trim rework — NOTE: not yet in the A-H proposal above; see below).
7. Regenerate schematics + BOM + netlist-viz; all gates; update specs §2-4 + STATUS; PR.

### ⚠️ Gap to close before G6: VCA Ec+ trim (HIGH-3, block-4 + block-6 DRIVE)
The §A-H proposal does NOT yet cover **HIGH-3** (VCA "unity trims" wired as series rheostats into the
high-Z Ec+ port — can't set offset; shared unbuffered V_CTRL couples 4 cells; copied to block-6 DRIVE
RV51-56). This is in scope (a confirmed HIGH). **Mechanism verified 2026-05-30:** `EC_L:[U4.2,RV1.1,RV1.2]`
+ `V_CTRL:[RV44.2,RV1.3,...]` → RV1 wiper+end to Ec+, other end to V_CTRL = series rheostat into the
high-Z Ec+ port; and V_CTRL (RV44 wiper) is unbuffered into 4 cells.
- **✅ VALIDATED DESIGN (SPICE `vca_ecplus_full.cir` + `vca_ecplus.cir`, 2026-05-30):** per cell,
  `V_CTRL_BUF —[R_ec 10k]→ Ec+` and `trim wiper —[R_inj 1M]→ Ec+`, trim pot across a shared ±~1.2V
  reference. Results: g_ctrl = **0.984** (V_CTRL passes to Ec+ at ~unity through R_ec into the high-Z
  port); trim authority **−2.1 .. +1.9 dB** (Ec+ −12.7..+11.7 mV at 6.1 mV/dB), crossing 0 dB and
  nulling the ~−0.5 mV bias-current offset. The old series rheostat moved Ec+ only ~25 µV (0.004 dB) —
  useless; this replaces it with a real offset injector.
- **Parts/scope (G6 — all existing types, new refs):**
  - **+1 op-amp for the V_CTRL buffer:** all 3 block-4 TL072 (U6/U63/U80) are fully used → add **U97
    (TL072)**; half A = V_CTRL unity buffer → `V_CTRL_BUF`, half B = the block-6 `V_DRIVE_CTRL` buffer
    (or a 2nd buffer there). (block-6 DRIVE has its own V_DRIVE_CTRL_n fan-outs — check budget per section.)
  - **Shared ±ref divider** (one per board region): ±12V → 1M / 10k pot / 1M → wiper ≈ ±30mV… actually
    the SPICE uses Vw ≈ ±1.2V into R_inj 1M, so the ref divider gives ±~1.2V: ±12V —[Rref ~91k]—[trim
    pot]—[Rref ~91k]. Finalize the divider Rs when wiring (the trim pot is the existing RV1/2/46/47 etc.).
  - **Per cell: R_ec 10k (new) + R_inj 1M (new)**, ×4 block-4 + ×6 block-6 DRIVE = 10 cells.
- **SCOPE NOTE:** this is the broadest remaining rewrite (10 VCA cells across block-4 + block-6-dist1/2/3,
  +1 op-amp, +ref divider, ~20 new Rs). The Ec+ R/ref values are SPICE-validated but the absolute
  THAT2180 +6.1 mV/dB control-port figure is [NV] — the ±2dB trim authority is sized to absorb it.
  Wiring next: block-4 (4 cells) first, then block-6 DRIVE (6 cells, mirror).

## Implementation finding (2026-05-30): cluster C is a topology refinement, not a reroute
Tracing block-5/7/8 during implementation, the "tap v1/v2 from pins 5/12" fix splits into:
- **Safe, unambiguous (H5 literal fix):** move the HIGH-Z consumers — OTA2 In+ (`U7.14`/`U8.14`,
  HP `U49.14`/`U50.14`, LP2 `U56.14`/`U57.14`) and Q-cell In+ (`U9.3`/`U10.3`, etc.) — from the
  Darlington buffer outputs (pins 8/9) to the unbuffered cap nodes (pins 5/12). Removes the ~1.2 V
  offset injected into the next OTA. No loading concern (OTA/Q inputs are high-Z). No new/removed parts.
- **Needs design decision + validation:** the **v2/LP path** drives BOTH the output buffer and the
  resistive feedback `R47`/`R48` (and HP/LP2 equivalents) from the Darlington (pin 9). Consequences:
  (i) the LP/LP2 audio OUTPUT inherits the ~1.2 V Darlington DC offset; (ii) `R47` is a resistive load
  that can't move to the unbuffered cap node without loading the integrator. The clean fix is to drive
  the output buffer input + `R47` from the **precision op-amp buffer** (U11/U58/…) tapping the clean
  cap node (pin 12), dropping the Darlington from the v2 signal path and **removing the R68/R69-class
  pulldowns**. That's a real topology refinement (changes feedback source + removes parts) and its
  **loop DC/stability cannot be validated in this env** (no SPICE; datasheet PDFs won't text-extract).

### SPICE validation results (specs/sim/, ngspice-42)
- **expo_voct.cir [DONE]:** caught the 2.1× value error; corrected divider sweeps 19.2→16.1 mV/V with
  17.92 mV/oct (V_T·ln2) centered at ~38% trim. §A values validated.
- **ota_svf_loop.cir [DONE]:** (1) H5 confirmed — Darlington tap injects **1.26 V** into the next OTA
  input vs ±30 mV linear range (**42× over**); unbuffered tap (§C fix) = **0 V**. (2) gm-C integrator
  corner = **634.6 Hz** at Iabc 9.69 µA (target 632, 0.4%) — re-tap doesn't change f_ref.
- **q_cell.cir [DONE]:** M5 confirmed — 1MΩ@0V → Iabc 10.8µA (14× the claimed 0.74µA, Q pinned).
  §D fix R_Iabc=100k, V_ires −10.0→−10.795V maps Q = 0.065→0.74→2.6→10.4. Butterworth (Q≈0.74) at
  V_ires≈−10.73V. **Design consequence:** useful Q lives in a ~0.8V window just above the −10.8V pin
  and is very steep (~10mV ≈ 5× Q) → V_bias trim needs fine/multi-turn resolution near the rail; H6
  self-osc via soft-limit diodes (Iabc can't precisely set Q>~10–50). Sized when wiring §D.
- **vca_ecplus.cir [DONE]:** HIGH-3 confirmed — series rheostat moves Ec+ only **~25 µV (0.004 dB)**
  across full 0–500Ω travel (Ec+ is high-Z; can't set offset). Voltage-injection trim (±12 mV wiper
  via 100k → Ec+) gives **−2.8 → +1.2 dB**, crossing **0 dB mid-range**, and nulls the real ~−0.8 dB
  bias-current offset → that's *why* the trim is needed. Design: bound the injection wiper to ~±12 mV
  (≈100:1 pre-divider from ±12V into the trim) for ±2 dB authority. Also need the **V_CTRL wiper
  buffer** before the 4-way fan-out (HIGH-3 part b). Values set when wiring block-4/block-6 DRIVE.

**All four SPICE decks pass.** The Tier-2 fixes (A,B,C,D,HIGH-3) are now behavior-validated, not blind.

### Proposed split (recommended)
- **Do now (no resonant-loop risk, no validation needed):** clusters **E** (BP3 ALT_R selector),
  **F** (WF phase invert), **G** (BP3 output normal), and **H** (mod-bus low-Z normal + U3 buffer +
  M2/M4). These are digital-select / output-jack / summing wiring — well-understood, gate-checkable.
- **Hold for validation:** clusters **A/B** (expo divider+tilt — math solid but tempco blocked on G6a),
  **C** (OTA tap — the v2/loop refinement above), **D** (Q-cell [NV] bias), and **HIGH-3** ([NV]
  THAT2180 Ec+). These touch the OTA-C resonant loop or carry [NV] values needing SPICE/bench/datasheet
  confirmation. Implement them with a validation step (SPICE model or prototype) rather than blind edits.

## G5b DECISIONS round 2 (user, 2026-05-30) — de-risking Tier 2
1. **Trim-pot strategy (user):** "can we do it so that we have trim pots that enable us to do this
   post-build?" → **YES, and adopt it as the design principle for all [NV] nodes.** Rather than
   pre-committing exact unverifiable values, design each uncertain node with **calibration trim
   authority wide enough to span the uncertainty**, dialed in at bench bring-up. Most already have a
   trim (expo RV_REF + RV_1VOCT; VCA Ec+ RV1/2/46/47; Q-cell V_bias RV5/RV9…). Work = ensure the trim
   covers the corrected range + correct wiring, not guess a fixed resistor. This is the standard synth
   bring-up approach and removes the "blind analog surgery" objection for D, HIGH-3, and the Q-cell bias.
2. **ngspice (user: set it up):** ✅ **ngspice-42 installed & verified** (AC analysis runs). Tier-2
   resonant-loop / [NV] fixes will be **validated with small SPICE models** (expo converter, OTA-C SVF
   loop, Q-cell bias, VCA Ec+) BEFORE committing the netlist edits — no longer deferred to prototype-only.
   SPICE decks live in `specs/sim/` (new dir) committed alongside the change for reproducibility.

## Tempco resistor (G6a) — research result (2026-05-30)
Deep-research found **no in-production SMD part exactly at +3300 ppm/°C with 1k**:
- **Panasonic ERA-S33J102V** (0805, 1k, +3300 ppm, the textbook match) — **EOL/obsolete at DigiKey.**
- **Vishay TFPT0805L1001FM** (0805, 1k) — **active + in stock**, but **+4110 ppm/K** (out of the 3000–3600
  band; over-compensates ~25%). KiCad `Resistor_SMD:R_0805_2012Metric`.
- **KRL/Riedon C-2AQ** (1k, +3500 ppm, ±1%) — **in production**, synth-standard, but **through-hole only**;
  clean datasheet not extractable (order-by-description from synth distributors).
**Implication + how the trim strategy helps:** the tempco TCR mismatch (3300 vs 3500 vs 4110 ppm) is
*exactly* what a trimmable V/oct slope (RV_1VOCT, §A) absorbs — a higher-TCR part just shifts the trim
setpoint. So selecting the **active Vishay TFPT (+4110)** is viable IF the expo divider math is re-centered
for 4110 ppm and RV_1VOCT spans it. **G6a decision still needed (see question).** Until an MPN is locked,
§A wires the divider with a placeholder tempco footprint in series with R_SHUNT (expo fix not blocked).

## G6a/G6b — tempco resistor (NEW PART TYPE) — ✅ CLOSED (2026-05-30)
Registered **Vishay TFPT0805L1001FM** (1kΩ, 0805, +4110 ppm/K) as `components/parts/vishay_tfpt/`:
- **G6a:** `component.yaml` (mpn, manufacturer, `symbol: r`, `matches: ["Vishay TFPT"]`) + cached
  datasheet PDF (5pp, sha256 `c75464…`, 120630 B) from vishay.com/docs/33017. `matches` token added.
- **G6b:** footprint — the repo had **no resistor footprint** (README "passives" item was deferred), so
  vendored the standard IPC `R_0805_2012Metric.kicad_mod` under `components/footprints/Resistor_SMD.pretty/`
  (2 pads, IPC_7351 nominal), resolved as `POGO_Resistor_SMD:R_0805_2012Metric`; one fp-lib-table row added.
  This de-defers the README "vendored R_0603/C_0603 footprints" item (first passive footprint in repo).
- All 3 component gates pass (components/build_components/fetch_datasheets `--check` OK). Part is NOT yet
  in `specs/components.yaml` — that's the §A netlist step (the tempco sits as the shunt leg of the expo
  divider). **§A is now unblocked.**

## Gate checklist
- [x] **G1 — intent** confirmed (fix all CRIT+HIGH; full H5/H6/M5).
- [x] **G3 — VCV Rack verify** (§E Lane-A plugin change): user "plugin was good in branch"; plugin LOCKED @ v2.1.0.
- [x] **G5 — topology** approved per cluster (user decisions logged: mod-bus H-a→hi-Z, BP3 ALT independence, tempco, HIGH-3 injection).
- [x] **G6a/b** — Vishay TFPT tempco registered (symbol+footprint+datasheet); all other new parts are existing types/new refs.
- [x] **All netlist clusters wired + gate-green** (§A/§B/§C/§D filter core; §E; §G; §H; HIGH-3; §F withdrawn). 0 schematic FAIL; 6 `--check` gates + JS/Py parity pass.
- [x] **G4 — spec §2–4 parity** vs locked plugin (this pass).
- [ ] STATUS.md + close-out
- [ ] PR `change/0020-cv-conditioning-fixes` → `dev`

### Remaining [NV] / Phase-3R items (documented, not blocking — need bench measurement)
- §D deep IRES_AMP negative-V_ires drive + clamp-polarity (R_Iabc 1M→100k done; the bias-network drive that swings V_ires into the −10.8V window is a trim-backed bring-up item, shared block-5/7/8).
- Absolute THAT2180 Ec+ mV/dB and LM13700 Q-cell bias absolutes — sized so trim authority (±2dB Ec+; multi-turn V_bias) absorbs the [NV] uncertainty.

## Decisions log
- 2026-05-30: opened off the 0019 tip (stacked) to inherit corrected docs and avoid re-touching
  the same stale text; will rebase onto dev after 0019 merges.
