jeffmhopkins/POGO/kicad/pogo-block-1.kicad_sch

## KiCad design kicad/pogo-block-1.kicad_sch (2026-05-31)

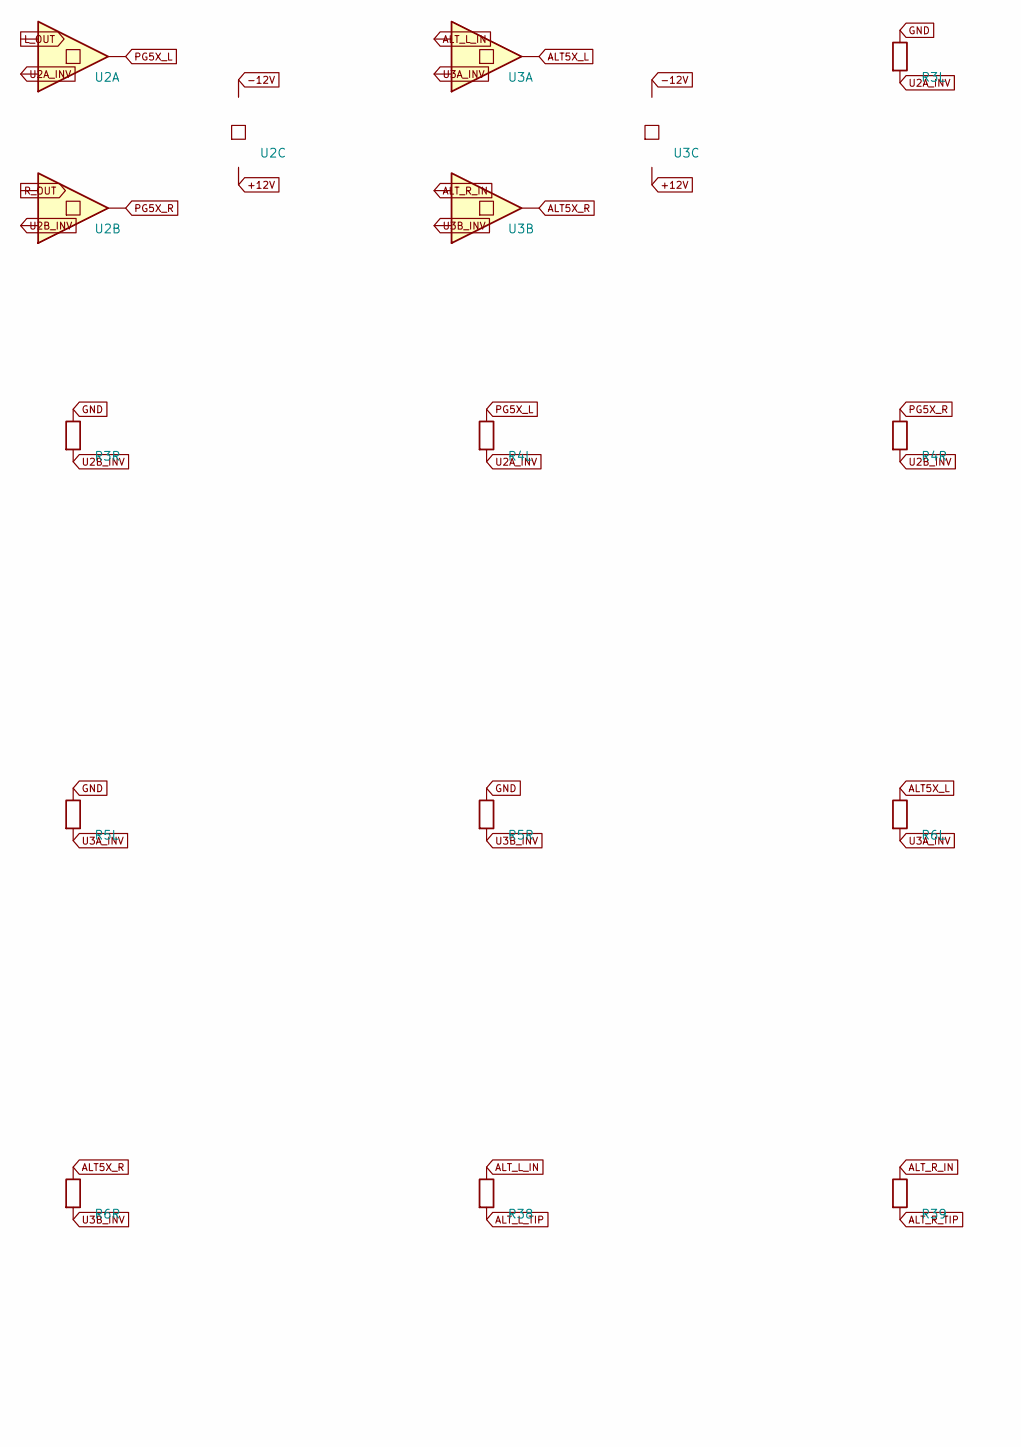
[picture p1: schematic pogo-block-1.kicad_sch, part in row 1, column 1]

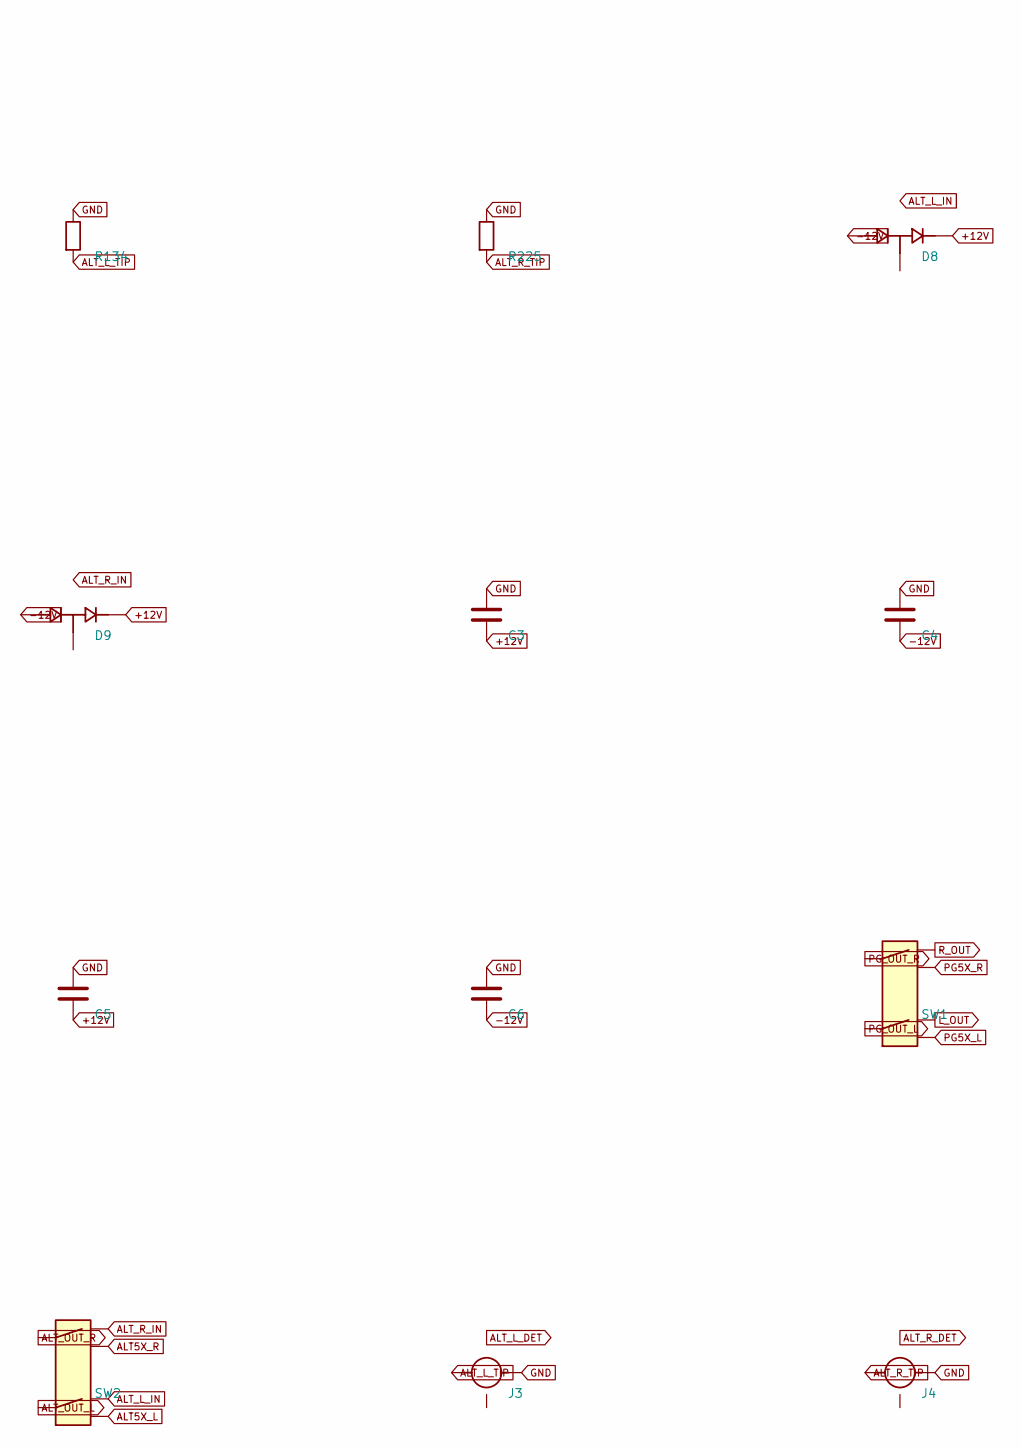
[picture p2: schematic pogo-block-1.kicad_sch, part in row 2, column 1]

Parts:
C3, C4, C5, C6: 100nF
D8, D9: BAT54S; SOT-23
J3: ALT_BP_L; Jack_3.5mm_QingPu_WQP-PJ398SM_Vertical_CircularHoles
J4: ALT_BP_R; Jack_3.5mm_QingPu_WQP-PJ398SM_Vertical_CircularHoles
R3L, R3R, R5L, R5R: 4k7
R4L, R4R, R6L, R6R: 18k
R38, R39: 100R
R134, R225: 22k
SW1: GAIN_MAIN; SW_Dailywell_DW3_DPDT
SW2: GAIN_BP3; SW_Dailywell_DW3_DPDT
U2, U3: OPA1612; SOIC-8_3.9x4.9mm_P1.27mm

Connections:
+12V: C3.2, C5.2, D8.2 (K2), D9.2 (K2), U2.4 (V-), U3.4 (V-)
-12V: C4.2, C6.2, D8.1 (A1), D9.1 (A1), U2.8 (V+), U3.8 (V+)
ALT5X_L: R6L.1, SW2.6 (B2), U3.1 (Out)
ALT5X_R: R6R.1, SW2.3 (A2), U3.7 (Out)
ALT_L_IN: R38.1, SW2.4 (B1), U3.2 (In-)
ALT_L_TIP: J3.1 (T), R38.2, R134.2
ALT_OUT_L: SW2.5 (B_COM)
ALT_OUT_R: SW2.2 (A_COM)
ALT_R_IN: R39.1, SW2.1 (A1), U3.6 (In-)
ALT_R_TIP: J4.1 (T), R39.2, R225.2
GND: C3.1, C4.1, C5.1, C6.1, J3.2 (S), J4.2 (S), R3L.1, R3R.1, R5L.1, R5R.1, R134.1, R225.1
L_OUT: SW1.4 (B1), U2.2 (In-)
PG5X_L: R4L.1, SW1.6 (B2), U2.1 (Out)
PG5X_R: R4R.1, SW1.3 (A2), U2.7 (Out)
PG_OUT_L: SW1.5 (B_COM)
PG_OUT_R: SW1.2 (A_COM)
R_OUT: SW1.1 (A1), U2.6 (In-)
U2A_INV: R3L.2, R4L.2, U2.3 (In+)
U2B_INV: R3R.2, R4R.2, U2.5 (In+)
U3A_INV: R5L.2, R6L.2, U3.3 (In+)
U3B_INV: R5R.2, R6R.2, U3.5 (In+)
