jeffmhopkins/POGO/kicad/pogo-block-2.kicad_sch

## KiCad design kicad/pogo-block-2.kicad_sch (2026-05-31)

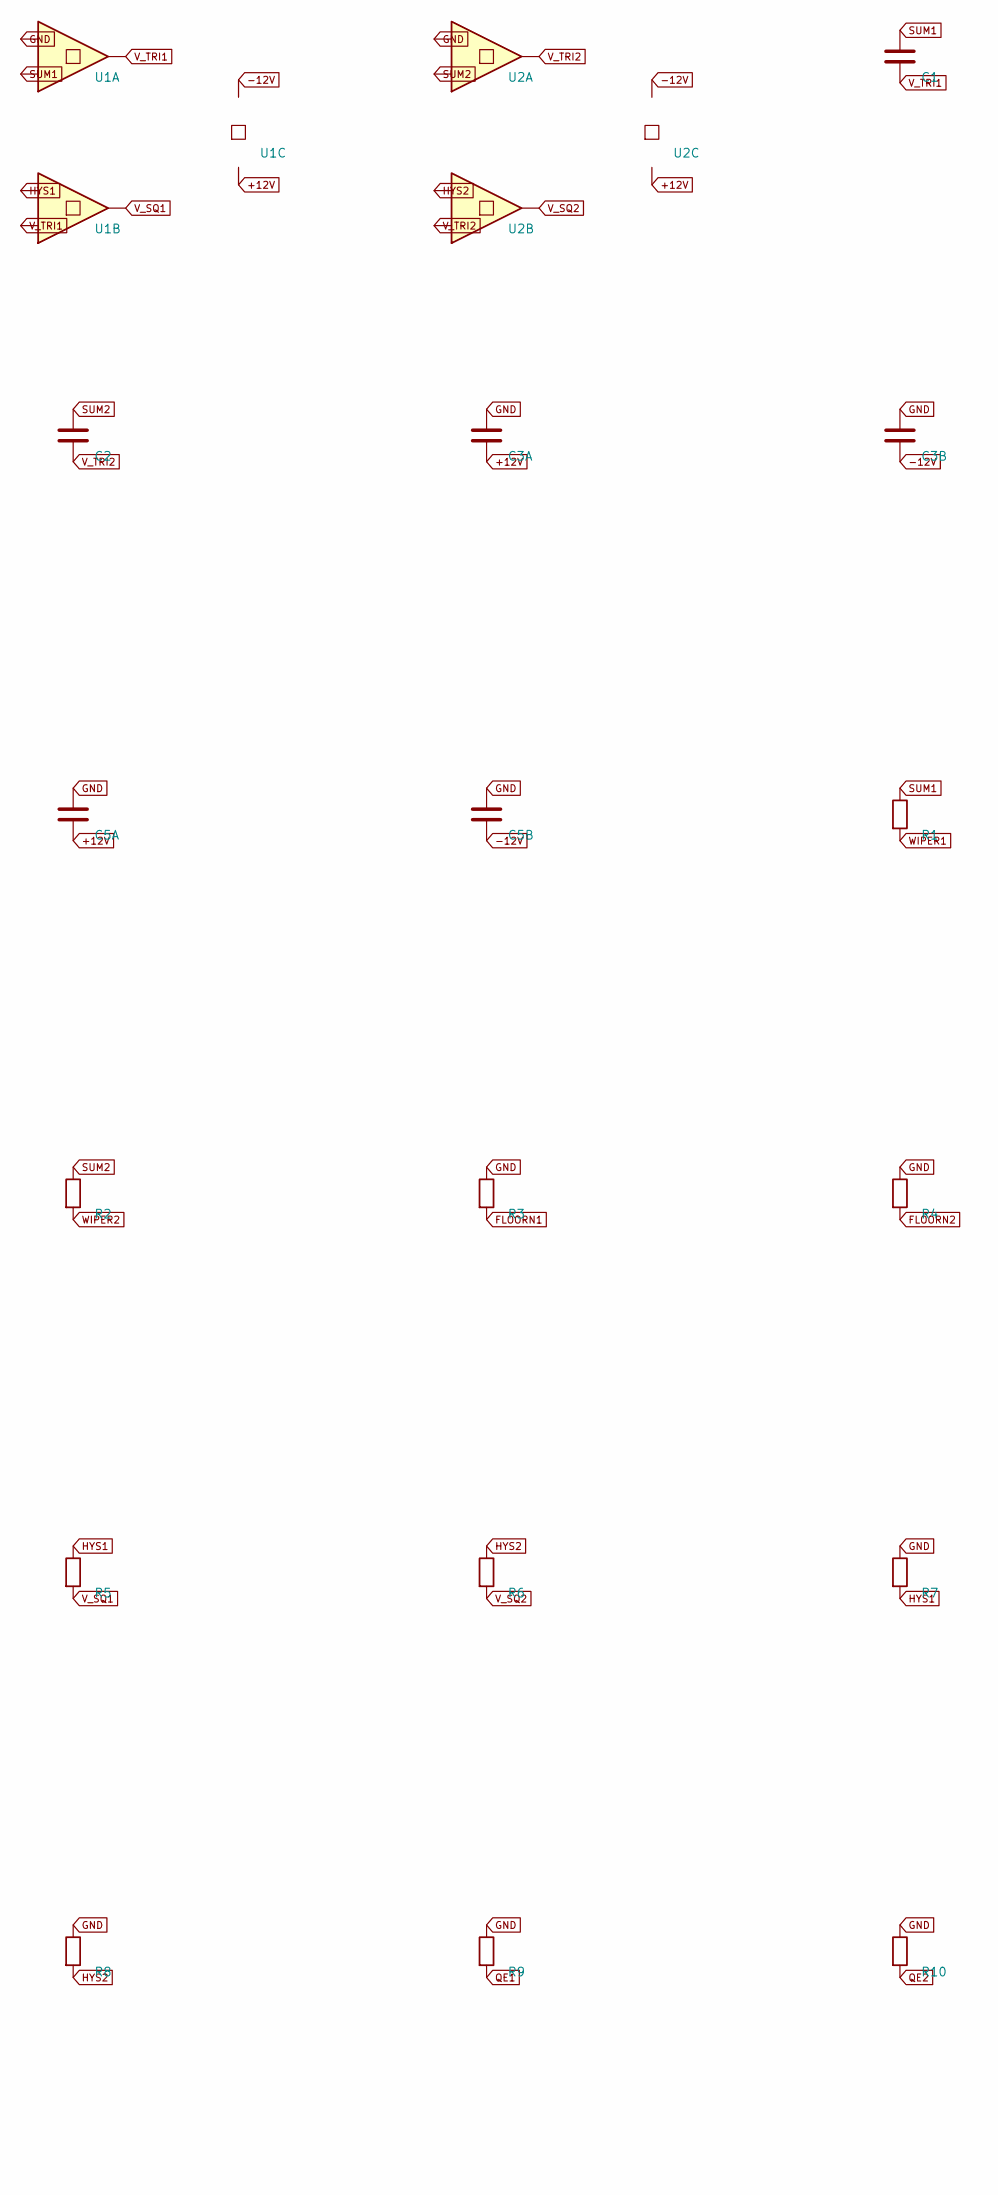
[picture p3: schematic pogo-block-2.kicad_sch, part in row 1, column 1]

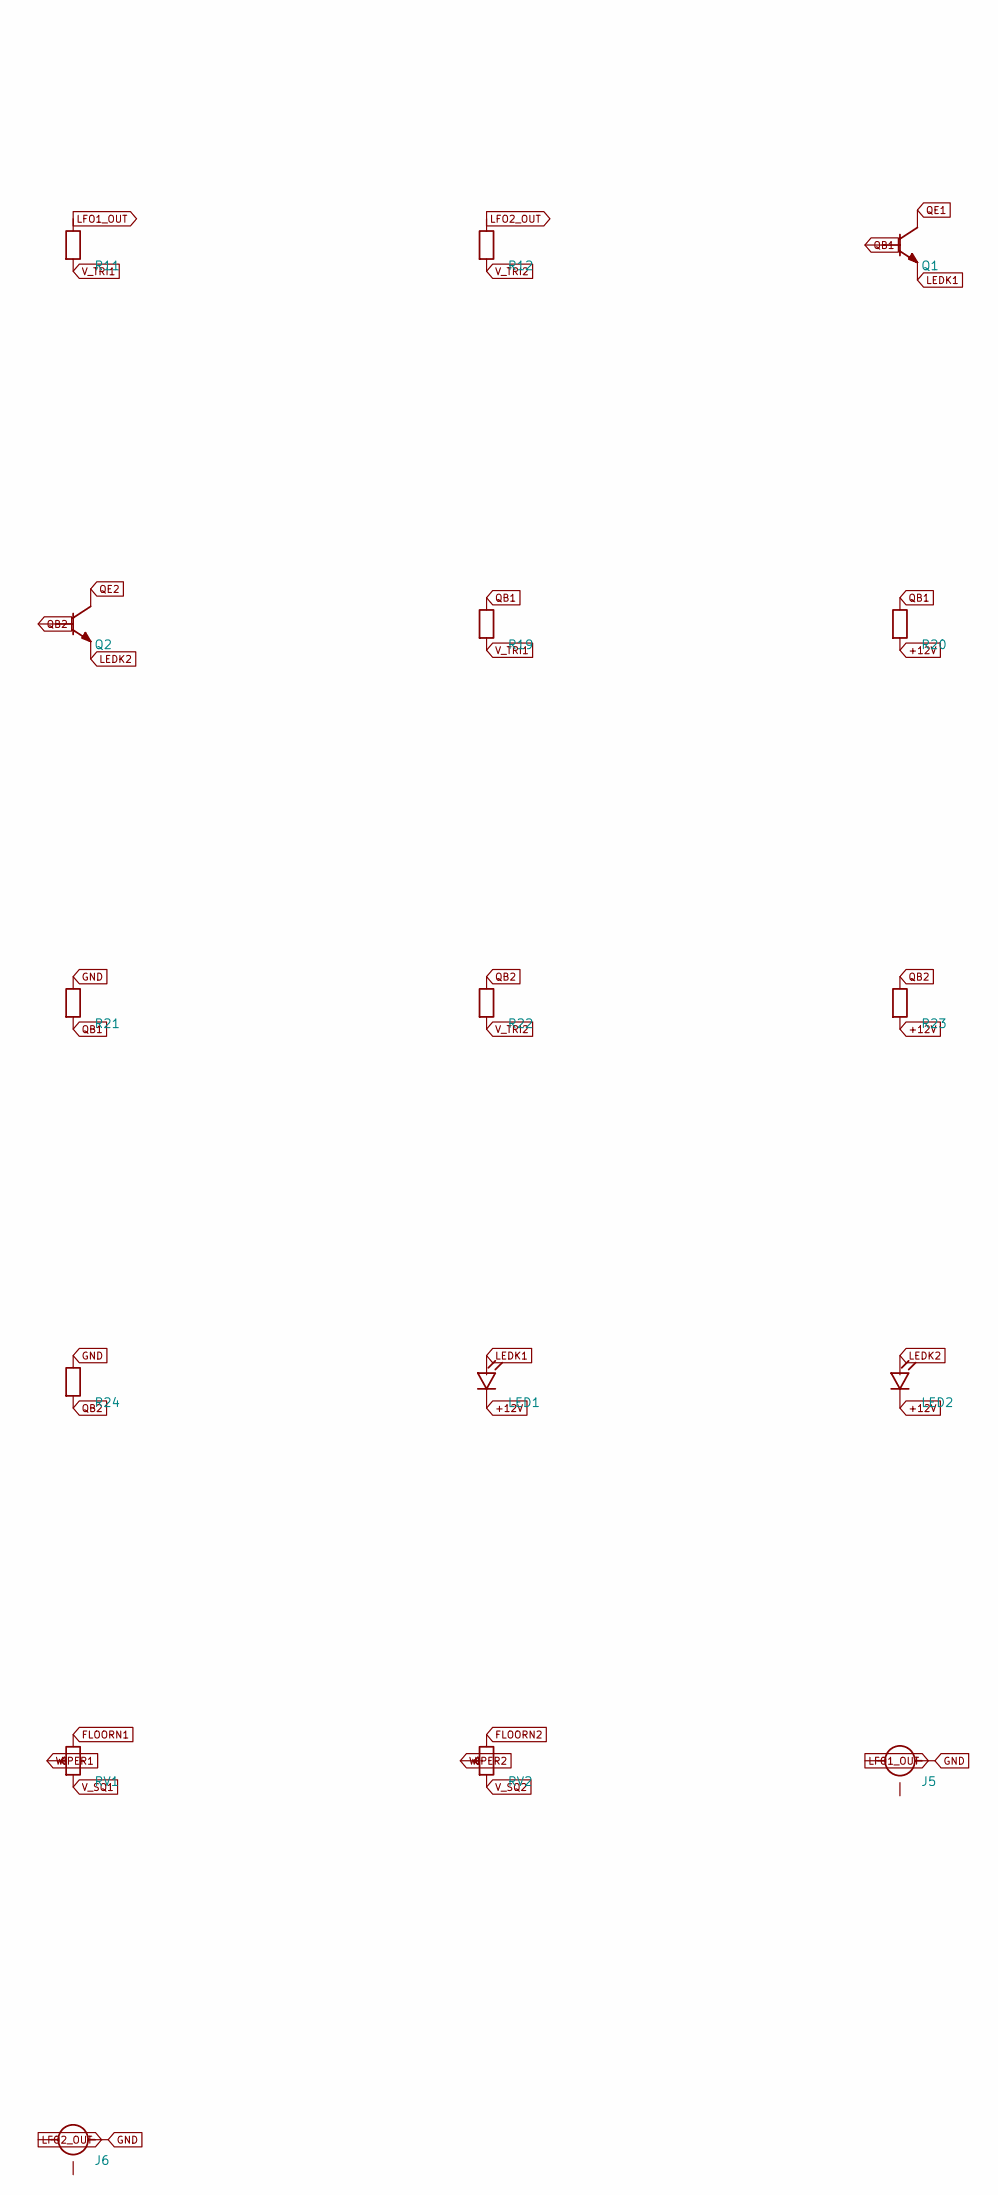
[picture p4: schematic pogo-block-2.kicad_sch, part in row 2, column 1]

Parts:
C1, C2: 47nF
C3A, C3B, C5A, C5B: 100nF
J5: LFO1; Jack_3.5mm_QingPu_WQP-PJ398SM_Vertical_CircularHoles
J6: LFO2; Jack_3.5mm_QingPu_WQP-PJ398SM_Vertical_CircularHoles
LED1: LFO1; LED_D3.0mm
LED2: LFO2; LED_D3.0mm
Q1, Q2: MMBT3904; SOT-23
R1, R2: 590k
R3, R4: 2k4
R5, R6: 100k
R7, R8: 82k
R9, R10: 470R
R11, R12: 1k
R19, R22: 51k
R20, R23: 68k
R21, R24: 10k
RV1: LFO1_RATE; Potentiometer_Songhuei_9mm_TallTrimmer_Vertical
RV2: LFO2_RATE; Potentiometer_Songhuei_9mm_TallTrimmer_Vertical
U1, U2: TL072; SOIC-8_3.9x4.9mm_P1.27mm

Connections:
+12V: C3A.2, C5A.2, LED1.K, LED2.K, R20.2, R23.2, U1.4 (V-), U2.4 (V-)
-12V: C3B.2, C5B.2, U1.8 (V+), U2.8 (V+)
FLOORN1: R3.2, RV1.3
FLOORN2: R4.2, RV2.3
GND: C3A.1, C3B.1, C5A.1, C5B.1, J5.2 (S), J6.2 (S), R3.1, R4.1, R7.1, R8.1, R9.1, R10.1, R21.1, R24.1, U1.2 (In-), U2.2 (In-)
HYS1: R5.1, R7.2, U1.6 (In-)
HYS2: R6.1, R8.2, U2.6 (In-)
LEDK1: LED1.A, Q1.2 (E)
LEDK2: LED2.A, Q2.2 (E)
LFO1_OUT: J5.1 (T), R11.1
LFO2_OUT: J6.1 (T), R12.1
QB1: Q1.1 (B), R19.1, R20.1, R21.2
QB2: Q2.1 (B), R22.1, R23.1, R24.2
QE1: Q1.3 (C), R9.2
QE2: Q2.3 (C), R10.2
SUM1: C1.1, R1.1, U1.3 (In+)
SUM2: C2.1, R2.1, U2.3 (In+)
V_SQ1: R5.2, RV1.1, U1.7 (Out)
V_SQ2: R6.2, RV2.1, U2.7 (Out)
V_TRI1: C1.2, R11.2, R19.2, U1.1 (Out), U1.5 (In+)
V_TRI2: C2.2, R12.2, R22.2, U2.1 (Out), U2.5 (In+)
WIPER1: R1.2, RV1.2 (Wiper)
WIPER2: R2.2, RV2.2 (Wiper)
