jeffmhopkins/POGO/kicad/pogo-block-3.kicad_sch

## KiCad design kicad/pogo-block-3.kicad_sch (2026-05-31)

Schematic: pogo-block-3.kicad_sch

Parts:
C7_1, C7_3, C7_4, C7_5, C7_6, C7_7, C7_8, C7_10, C7_11, C7_12, C7_13, C7_14: 100nF
D3_1, D3_2, D3_3, D3_4, D3_5, D3_6, D3_7, D3_8, D3_9, D3_10, D3_11, D3_12, D3_13, D3_14, D3_15, D3_16, D3_17, D3_18, D4: BAT54S; SOT-23
D5, D6: BZX84C10; SOT-23
J7: MOD_IN; Jack_3.5mm_QingPu_WQP-PJ398SM_Vertical_CircularHoles
J8: LP1_FREQ; Jack_3.5mm_QingPu_WQP-PJ398SM_Vertical_CircularHoles
J9: LP1_TILT; Jack_3.5mm_QingPu_WQP-PJ398SM_Vertical_CircularHoles
J10: LP1_RES; Jack_3.5mm_QingPu_WQP-PJ398SM_Vertical_CircularHoles
J11: BP_FREQ; Jack_3.5mm_QingPu_WQP-PJ398SM_Vertical_CircularHoles
J12: BP_TILT; Jack_3.5mm_QingPu_WQP-PJ398SM_Vertical_CircularHoles
J13: BP1_FREQ; Jack_3.5mm_QingPu_WQP-PJ398SM_Vertical_CircularHoles
J14: BP1_TILT; Jack_3.5mm_QingPu_WQP-PJ398SM_Vertical_CircularHoles
J15: BP1_DIST; Jack_3.5mm_QingPu_WQP-PJ398SM_Vertical_CircularHoles
J16: BP2_FREQ; Jack_3.5mm_QingPu_WQP-PJ398SM_Vertical_CircularHoles
J17: BP2_TILT; Jack_3.5mm_QingPu_WQP-PJ398SM_Vertical_CircularHoles
J18: BP2_DIST; Jack_3.5mm_QingPu_WQP-PJ398SM_Vertical_CircularHoles
J19: BP3_FREQ; Jack_3.5mm_QingPu_WQP-PJ398SM_Vertical_CircularHoles
J20: BP3_TILT; Jack_3.5mm_QingPu_WQP-PJ398SM_Vertical_CircularHoles
J21: BP3_DIST; Jack_3.5mm_QingPu_WQP-PJ398SM_Vertical_CircularHoles
J22: HP_FREQ; Jack_3.5mm_QingPu_WQP-PJ398SM_Vertical_CircularHoles
J23: HP_RES; Jack_3.5mm_QingPu_WQP-PJ398SM_Vertical_CircularHoles
J24: LP2_FREQ; Jack_3.5mm_QingPu_WQP-PJ398SM_Vertical_CircularHoles
J25: LP2_RES; Jack_3.5mm_QingPu_WQP-PJ398SM_Vertical_CircularHoles
R13, R16_1, R16_2: 100k
R14: 22k
R15: 240k
R37_1, R37_2, R37_3, R37_4, R37_5, R37_6, R37_7, R37_8, R37_9, R37_10, R37_11, R37_12, R37_13, R37_14, R37_15, R37_16, R37_17, R37_18, R99: 100R
R227, R228: 47R
RV3: MOD_SCALE; Potentiometer_Songhuei_9mm_TallTrimmer_Vertical
RV4: MOD_OFFSET; Potentiometer_Songhuei_9mm_TallTrimmer_Vertical
RV6: LP1_FREQ_ATT; Potentiometer_Songhuei_9mm_TallTrimmer_Vertical
RV7: LP1_TILT_ATT; Potentiometer_Songhuei_9mm_TallTrimmer_Vertical
RV8: LP1_RES_ATT; Potentiometer_Songhuei_9mm_TallTrimmer_Vertical
RV9: BP_FREQ_ATT; Potentiometer_Songhuei_9mm_TallTrimmer_Vertical
RV10: BP_TILT_ATT; Potentiometer_Songhuei_9mm_TallTrimmer_Vertical
RV11: BP1_FREQ_ATT; Potentiometer_Songhuei_9mm_TallTrimmer_Vertical
RV12: BP1_TILT_ATT; Potentiometer_Songhuei_9mm_TallTrimmer_Vertical
RV13: BP1_DIST_ATT; Potentiometer_Songhuei_9mm_TallTrimmer_Vertical
RV14: BP2_FREQ_ATT; Potentiometer_Songhuei_9mm_TallTrimmer_Vertical
RV15: BP2_TILT_ATT; Potentiometer_Songhuei_9mm_TallTrimmer_Vertical
RV16: BP2_DIST_ATT; Potentiometer_Songhuei_9mm_TallTrimmer_Vertical
RV17: BP3_FREQ_ATT; Potentiometer_Songhuei_9mm_TallTrimmer_Vertical
RV18: BP3_TILT_ATT; Potentiometer_Songhuei_9mm_TallTrimmer_Vertical
RV19: BP3_DIST_ATT; Potentiometer_Songhuei_9mm_TallTrimmer_Vertical
RV20: HP_FREQ_ATT; Potentiometer_Songhuei_9mm_TallTrimmer_Vertical
RV21: HP_RES_ATT; Potentiometer_Songhuei_9mm_TallTrimmer_Vertical
RV22: LP2_FREQ_ATT; Potentiometer_Songhuei_9mm_TallTrimmer_Vertical
RV23: LP2_RES_ATT; Potentiometer_Songhuei_9mm_TallTrimmer_Vertical
R_INV_FB_1, R_INV_FB_2, R_INV_FB_3, R_INV_FB_4, R_INV_FB_5, R_INV_FB_6, R_INV_FB_7, R_INV_FB_8, R_INV_FB_9, R_INV_FB_10, R_INV_FB_11, R_INV_FB_12, R_INV_FB_13, R_INV_FB_14, R_INV_FB_15, R_INV_FB_16, R_INV_FB_17, R_INV_FB_18: 47k
R_INV_IN_1, R_INV_IN_2, R_INV_IN_3, R_INV_IN_4, R_INV_IN_5, R_INV_IN_6, R_INV_IN_7, R_INV_IN_8, R_INV_IN_9, R_INV_IN_10, R_INV_IN_11, R_INV_IN_12, R_INV_IN_13, R_INV_IN_14, R_INV_IN_15, R_INV_IN_16, R_INV_IN_17, R_INV_IN_18: 47k
SW7: MOD_SRC
U3, U5, U6, U7, U8, U9: TL074; SOIC-14_3.9x8.7mm_P1.27mm

Connections:
+12V: C7_1.2, C7_3.2, C7_4.2, C7_5.2, C7_6.2, C7_7.2, D3_1.2 (K2), D3_2.2 (K2), D3_3.2 (K2), D3_4.2 (K2), D3_5.2 (K2), D3_6.2 (K2), D3_7.2 (K2), D3_8.2 (K2), D3_9.2 (K2), D3_10.2 (K2), D3_11.2 (K2), D3_12.2 (K2), D3_13.2 (K2), D3_14.2 (K2), D3_15.2 (K2), D3_16.2 (K2), D3_17.2 (K2), D3_18.2 (K2), D4.2 (K2), RV4.1, U3.11 (V-), U5.11 (V-), U6.11 (V-), U7.11 (V-), U8.11 (V-), U9.11 (V-)
-12V: C7_8.2, C7_10.2, C7_11.2, C7_12.2, C7_13.2, C7_14.2, D3_1.1 (A1), D3_2.1 (A1), D3_3.1 (A1), D3_4.1 (A1), D3_5.1 (A1), D3_6.1 (A1), D3_7.1 (A1), D3_8.1 (A1), D3_9.1 (A1), D3_10.1 (A1), D3_11.1 (A1), D3_12.1 (A1), D3_13.1 (A1), D3_14.1 (A1), D3_15.1 (A1), D3_16.1 (A1), D3_17.1 (A1), D3_18.1 (A1), D4.1 (A1), RV4.3, U3.4 (V+), U5.4 (V+), U6.4 (V+), U7.4 (V+), U8.4 (V+), U9.4 (V+)
BUF_C_OUT: R227.2, U3.8 (Out), U3.10 (In+)
BUF_D_OUT: R228.2, U3.12 (In+), U3.14 (Out)
GND: C7_1.1, C7_3.1, C7_4.1, C7_5.1, C7_6.1, C7_7.1, C7_8.1, C7_10.1, C7_11.1, C7_12.1, C7_13.1, C7_14.1, D6.3 (K), J7.2 (S), J8.2 (S), J9.2 (S), J10.2 (S), J11.2 (S), J12.2 (S), J13.2 (S), J14.2 (S), J15.2 (S), J16.2 (S), J17.2 (S), J18.2 (S), J19.2 (S), J20.2 (S), J21.2 (S), J22.2 (S), J23.2 (S), J24.2 (S), J25.2 (S), U3.2 (In-), U3.6 (In-), U5.2 (In-), U5.6 (In-), U5.9 (In-), U5.13 (In-), U6.2 (In-), U6.6 (In-), U6.9 (In-), U6.13 (In-), U7.2 (In-), U7.6 (In-), U7.9 (In-), U7.13 (In-), U8.2 (In-), U8.6 (In-), U8.9 (In-), U8.13 (In-), U9.2 (In-), U9.6 (In-), U9.9 (In-), U9.13 (In-)
INVN_BP1_DIST: R_INV_FB_8.2, R_INV_IN_8.1, U6.12 (In+)
INVN_BP1_FREQ: R_INV_FB_6.2, R_INV_IN_6.1, U6.5 (In+)
INVN_BP1_TILT: R_INV_FB_7.2, R_INV_IN_7.1, U6.10 (In+)
INVN_BP2_DIST: R_INV_FB_11.2, R_INV_IN_11.1, U7.10 (In+)
INVN_BP2_FREQ: R_INV_FB_9.2, R_INV_IN_9.1, U7.3 (In+)
INVN_BP2_TILT: R_INV_FB_10.2, R_INV_IN_10.1, U7.5 (In+)
INVN_BP3_DIST: R_INV_FB_14.2, R_INV_IN_14.1, U8.5 (In+)
INVN_BP3_FREQ: R_INV_FB_12.2, R_INV_IN_12.1, U7.12 (In+)
INVN_BP3_TILT: R_INV_FB_13.2, R_INV_IN_13.1, U8.3 (In+)
INVN_BP_FREQ: R_INV_FB_4.2, R_INV_IN_4.1, U5.12 (In+)
INVN_BP_TILT: R_INV_FB_5.2, R_INV_IN_5.1, U6.3 (In+)
INVN_HP_FREQ: R_INV_FB_15.2, R_INV_IN_15.1, U8.10 (In+)
INVN_HP_RES: R_INV_FB_16.2, R_INV_IN_16.1, U8.12 (In+)
INVN_LP1_FREQ: R_INV_FB_1.2, R_INV_IN_1.1, U5.3 (In+)
INVN_LP1_RES: R_INV_FB_3.2, R_INV_IN_3.1, U5.10 (In+)
INVN_LP1_TILT: R_INV_FB_2.2, R_INV_IN_2.1, U5.5 (In+)
INVN_LP2_FREQ: R_INV_FB_17.2, R_INV_IN_17.1, U9.3 (In+)
INVN_LP2_RES: R_INV_FB_18.2, R_INV_IN_18.1, U9.5 (In+)
JTIP_BP1_DIST: J15.1 (T), R37_8.2
JTIP_BP1_FREQ: J13.1 (T), R37_6.2
JTIP_BP1_TILT: J14.1 (T), R37_7.2
JTIP_BP2_DIST: J18.1 (T), R37_11.2
JTIP_BP2_FREQ: J16.1 (T), R37_9.2
JTIP_BP2_TILT: J17.1 (T), R37_10.2
JTIP_BP3_DIST: J21.1 (T), R37_14.2
JTIP_BP3_FREQ: J19.1 (T), R37_12.2
JTIP_BP3_TILT: J20.1 (T), R37_13.2
JTIP_BP_FREQ: J11.1 (T), R37_4.2
JTIP_BP_TILT: J12.1 (T), R37_5.2
JTIP_HP_FREQ: J22.1 (T), R37_15.2
JTIP_HP_RES: J23.1 (T), R37_16.2
JTIP_LP1_FREQ: J8.1 (T), R37_1.2
JTIP_LP1_RES: J10.1 (T), R37_3.2
JTIP_LP1_TILT: J9.1 (T), R37_2.2
JTIP_LP2_FREQ: J24.1 (T), R37_17.2
JTIP_LP2_RES: J25.1 (T), R37_18.2
LFO1_OUT: SW7.6 (B2)
LFO2_OUT: SW7.3 (A2)
MB_INVN: R16_1.1, R16_2.2, U3.5 (In+)
MB_SUMINV: R13.2, R14.1, R15.1, U3.3 (In+)
MOD_BP1_DIST: RV13.2 (Wiper)
MOD_BP1_FREQ: RV11.2 (Wiper)
MOD_BP1_TILT: RV12.2 (Wiper)
MOD_BP2_DIST: RV16.2 (Wiper)
MOD_BP2_FREQ: RV14.2 (Wiper)
MOD_BP2_TILT: RV15.2 (Wiper)
MOD_BP3_DIST: RV19.2 (Wiper)
MOD_BP3_FREQ: RV17.2 (Wiper)
MOD_BP3_TILT: RV18.2 (Wiper)
MOD_BP_FREQ: RV9.2 (Wiper)
MOD_BP_TILT: RV10.2 (Wiper)
MOD_HP_FREQ: RV20.2 (Wiper)
MOD_HP_RES: RV21.2 (Wiper)
MOD_IN_EXT: R99.1, SW7.1 (A1)
MOD_IN_TIP: J7.1 (T), R99.2
MOD_LP1_FREQ: RV6.2 (Wiper)
MOD_LP1_RES: RV8.2 (Wiper)
MOD_LP1_TILT: RV7.2 (Wiper)
MOD_LP2_FREQ: RV22.2 (Wiper)
MOD_LP2_RES: RV23.2 (Wiper)
NVSRC_BP1_DIST: RV13.3, R_INV_FB_8.1, U6.14 (Out)
NVSRC_BP1_FREQ: RV11.3, R_INV_FB_6.1, U6.7 (Out)
NVSRC_BP1_TILT: RV12.3, R_INV_FB_7.1, U6.8 (Out)
NVSRC_BP2_DIST: RV16.3, R_INV_FB_11.1, U7.8 (Out)
NVSRC_BP2_FREQ: RV14.3, R_INV_FB_9.1, U7.1 (Out)
NVSRC_BP2_TILT: RV15.3, R_INV_FB_10.1, U7.7 (Out)
NVSRC_BP3_DIST: RV19.3, R_INV_FB_14.1, U8.7 (Out)
NVSRC_BP3_FREQ: RV17.3, R_INV_FB_12.1, U7.14 (Out)
NVSRC_BP3_TILT: RV18.3, R_INV_FB_13.1, U8.1 (Out)
NVSRC_BP_FREQ: RV9.3, R_INV_FB_4.1, U5.14 (Out)
NVSRC_BP_TILT: RV10.3, R_INV_FB_5.1, U6.1 (Out)
NVSRC_HP_FREQ: RV20.3, R_INV_FB_15.1, U8.8 (Out)
NVSRC_HP_RES: RV21.3, R_INV_FB_16.1, U8.14 (Out)
NVSRC_LP1_FREQ: RV6.3, R_INV_FB_1.1, U5.1 (Out)
NVSRC_LP1_RES: RV8.3, R_INV_FB_3.1, U5.8 (Out)
NVSRC_LP1_TILT: RV7.3, R_INV_FB_2.1, U5.7 (Out)
NVSRC_LP2_FREQ: RV22.3, R_INV_FB_17.1, U9.1 (Out)
NVSRC_LP2_RES: RV23.3, R_INV_FB_18.1, U9.7 (Out)
OFFSET_W: R15.2, RV4.2 (Wiper)
SCALE_W: R14.2, RV3.2 (Wiper), RV3.3
SW_AB_BRIDGE: SW7.2 (A_COM), SW7.4 (B1)
U9_SPARE: U9.12 (In+), U9.14 (Out)
U9_SPARE_C: U9.8 (Out), U9.10 (In+)
VSRC_BP1_DIST: R37_8.1, RV13.1, R_INV_IN_8.2
VSRC_BP1_FREQ: R37_6.1, RV11.1, R_INV_IN_6.2
VSRC_BP1_TILT: R37_7.1, RV12.1, R_INV_IN_7.2
VSRC_BP2_DIST: R37_11.1, RV16.1, R_INV_IN_11.2
VSRC_BP2_FREQ: R37_9.1, RV14.1, R_INV_IN_9.2
VSRC_BP2_TILT: R37_10.1, RV15.1, R_INV_IN_10.2
VSRC_BP3_DIST: R37_14.1, RV19.1, R_INV_IN_14.2
VSRC_BP3_FREQ: R37_12.1, RV17.1, R_INV_IN_12.2
VSRC_BP3_TILT: R37_13.1, RV18.1, R_INV_IN_13.2
VSRC_BP_FREQ: R37_4.1, RV9.1, R_INV_IN_4.2
VSRC_BP_TILT: R37_5.1, RV10.1, R_INV_IN_5.2
VSRC_HP_FREQ: R37_15.1, RV20.1, R_INV_IN_15.2
VSRC_HP_RES: R37_16.1, RV21.1, R_INV_IN_16.2
VSRC_LP1_FREQ: R37_1.1, RV6.1, R_INV_IN_1.2
VSRC_LP1_RES: R37_3.1, RV8.1, R_INV_IN_3.2
VSRC_LP1_TILT: R37_2.1, RV7.1, R_INV_IN_2.2
VSRC_LP2_FREQ: R37_17.1, RV22.1, R_INV_IN_17.2
VSRC_LP2_RES: R37_18.1, RV23.1, R_INV_IN_18.2
V_MODBUS: R227.1, R228.1
V_MODBUS_INV: D5.3 (K), R13.1, R16_1.2, U3.1 (Out)
V_MODBUS_RAW: R16_2.1, U3.7 (Out), U3.9 (In-), U3.13 (In-)
V_SRC: RV3.1, SW7.5 (B_COM)
ZMID: D5.1 (A), D6.1 (A)
