jeffmhopkins/POGO/kicad/pogo-block-4.kicad_sch

## KiCad design kicad/pogo-block-4.kicad_sch (2026-05-31)

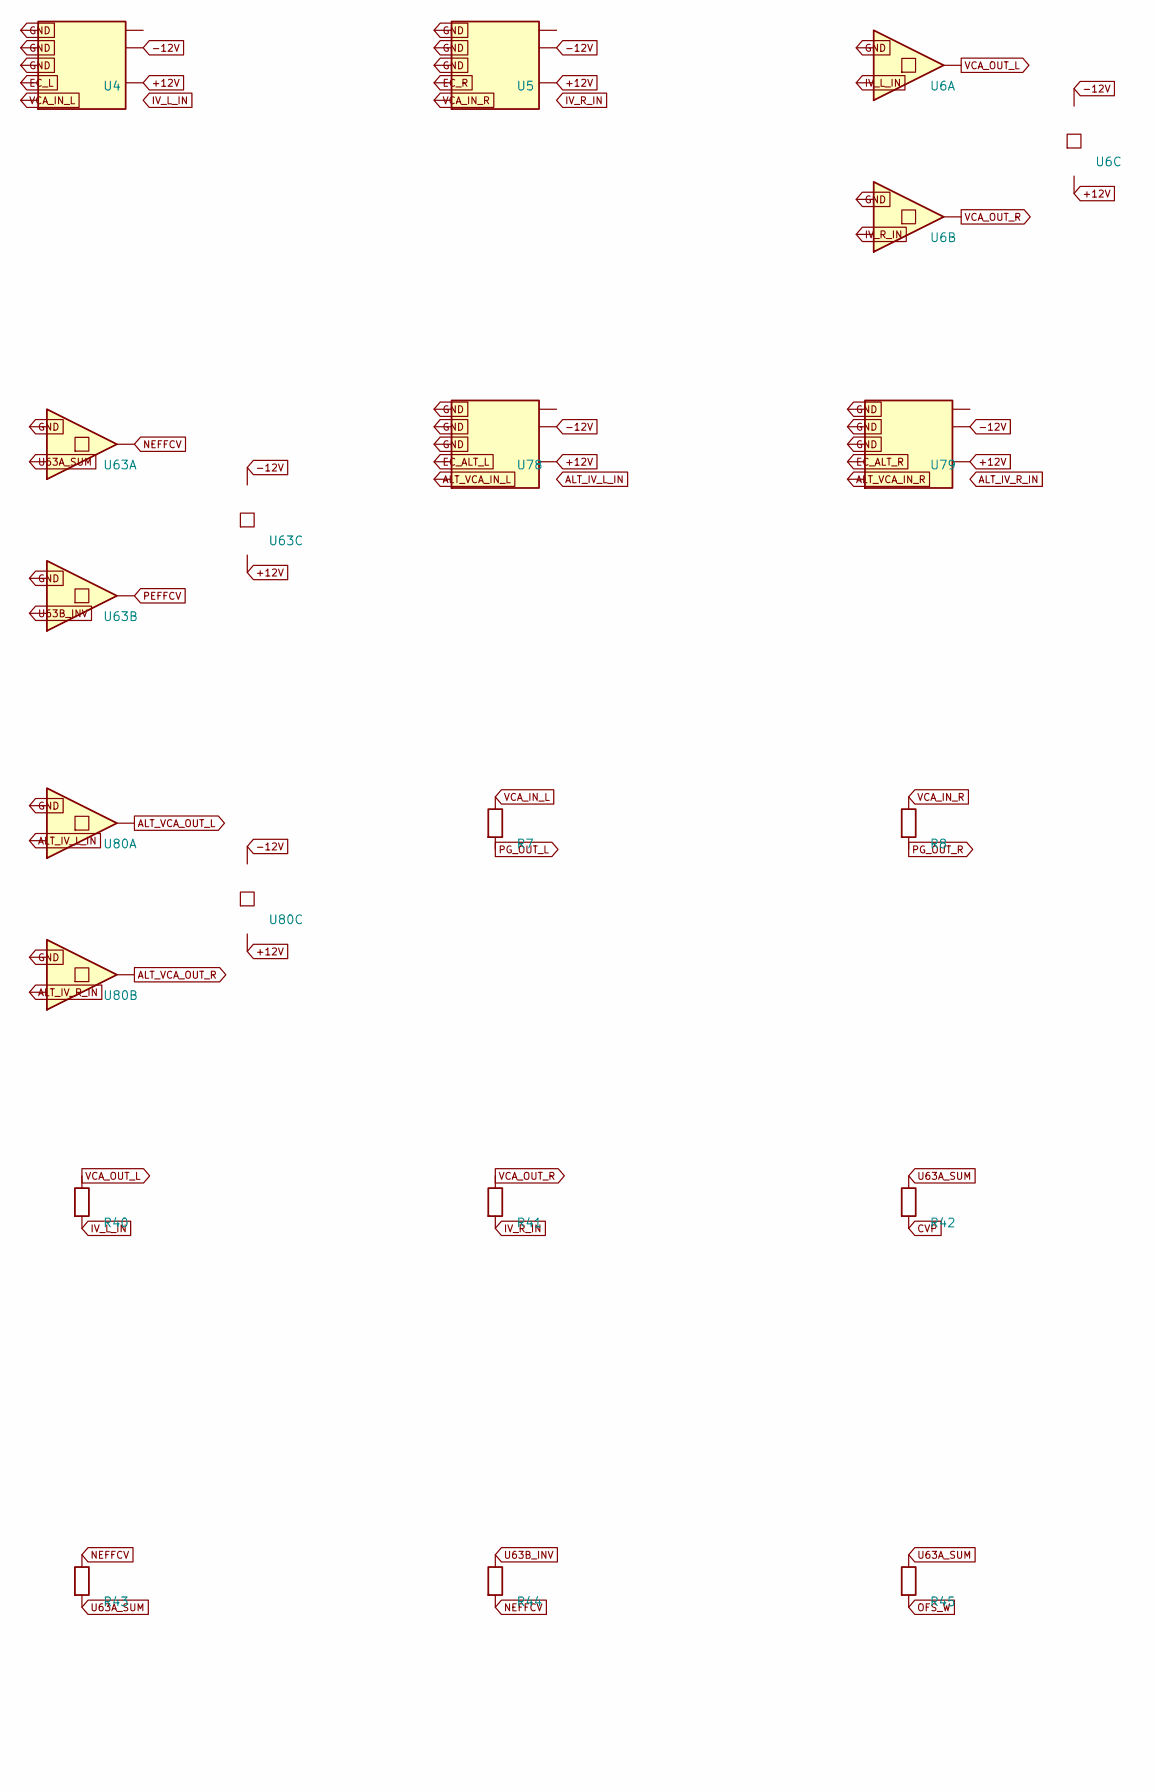
[picture p5: schematic pogo-block-4.kicad_sch, part in row 1, column 1]

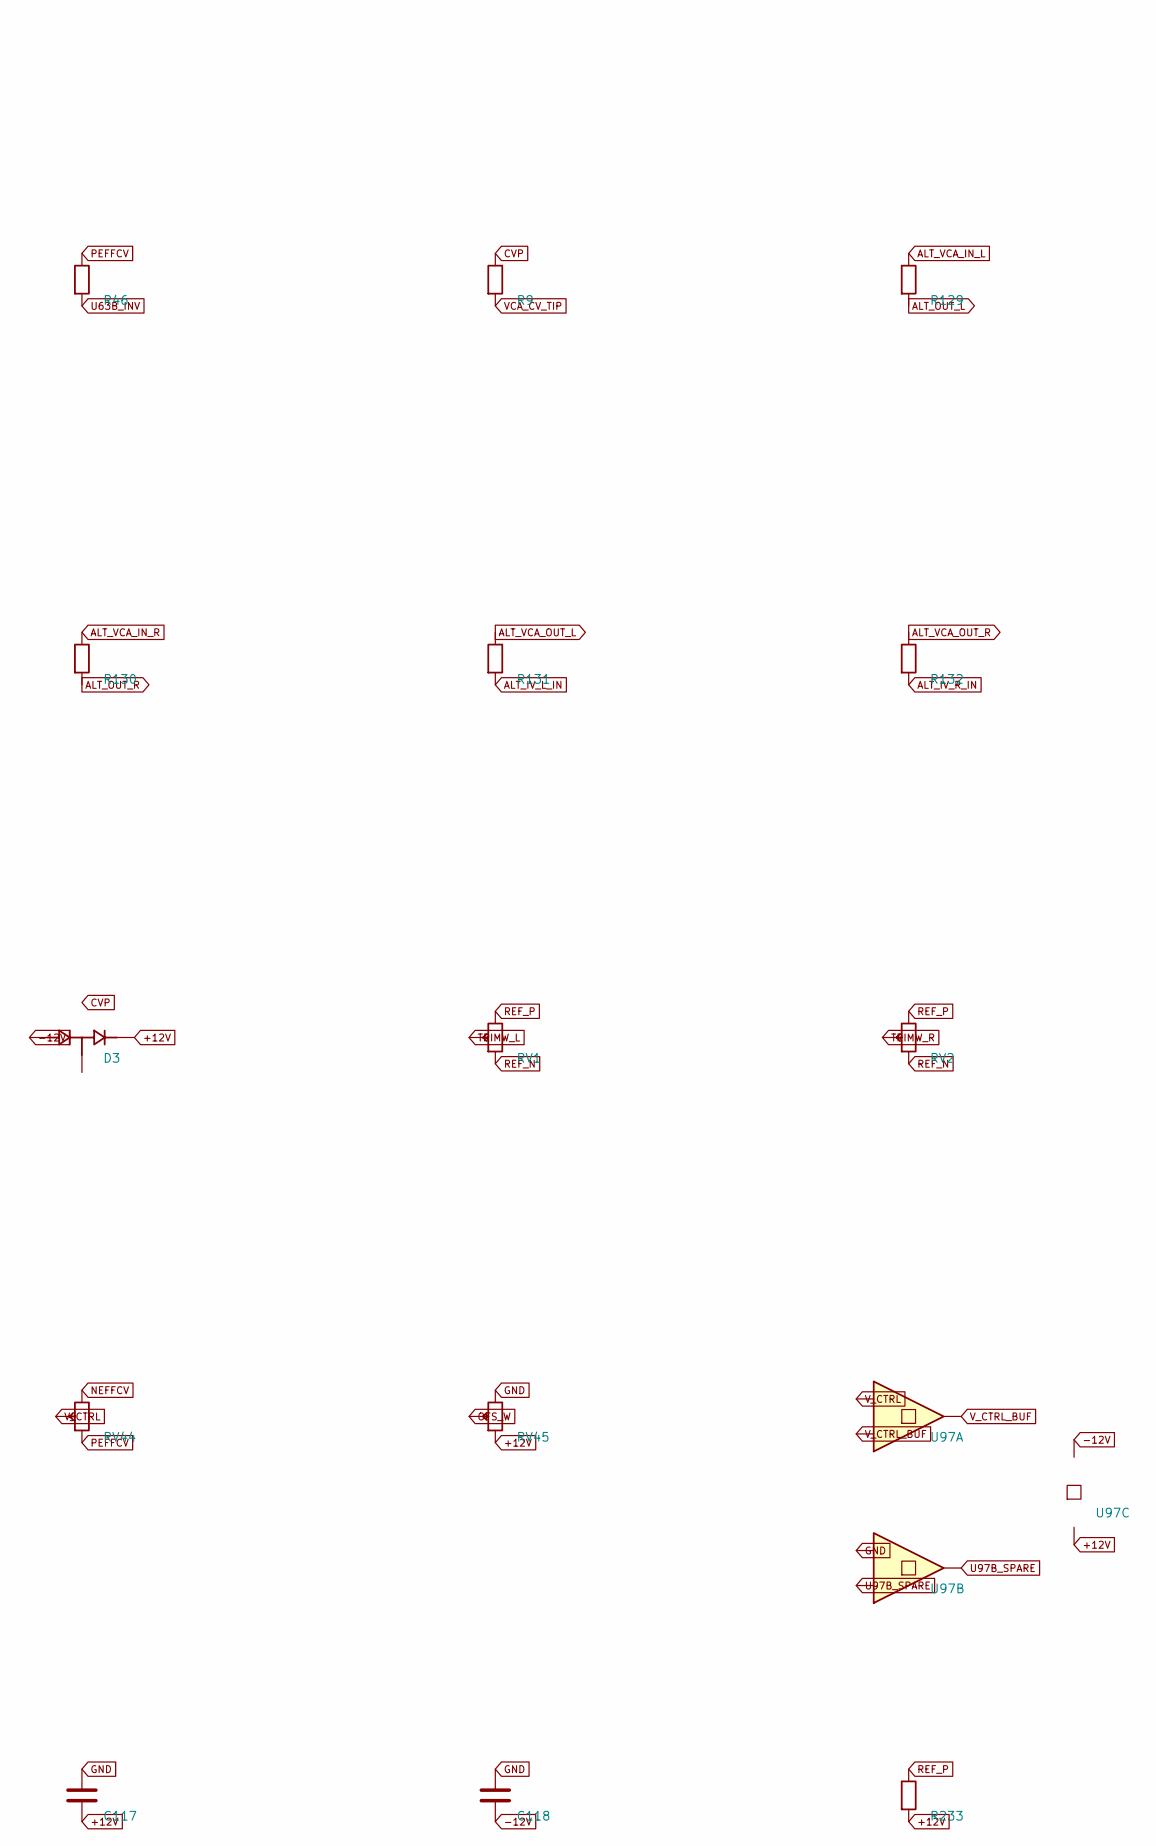
[picture p6: schematic pogo-block-4.kicad_sch, part in row 2, column 1]

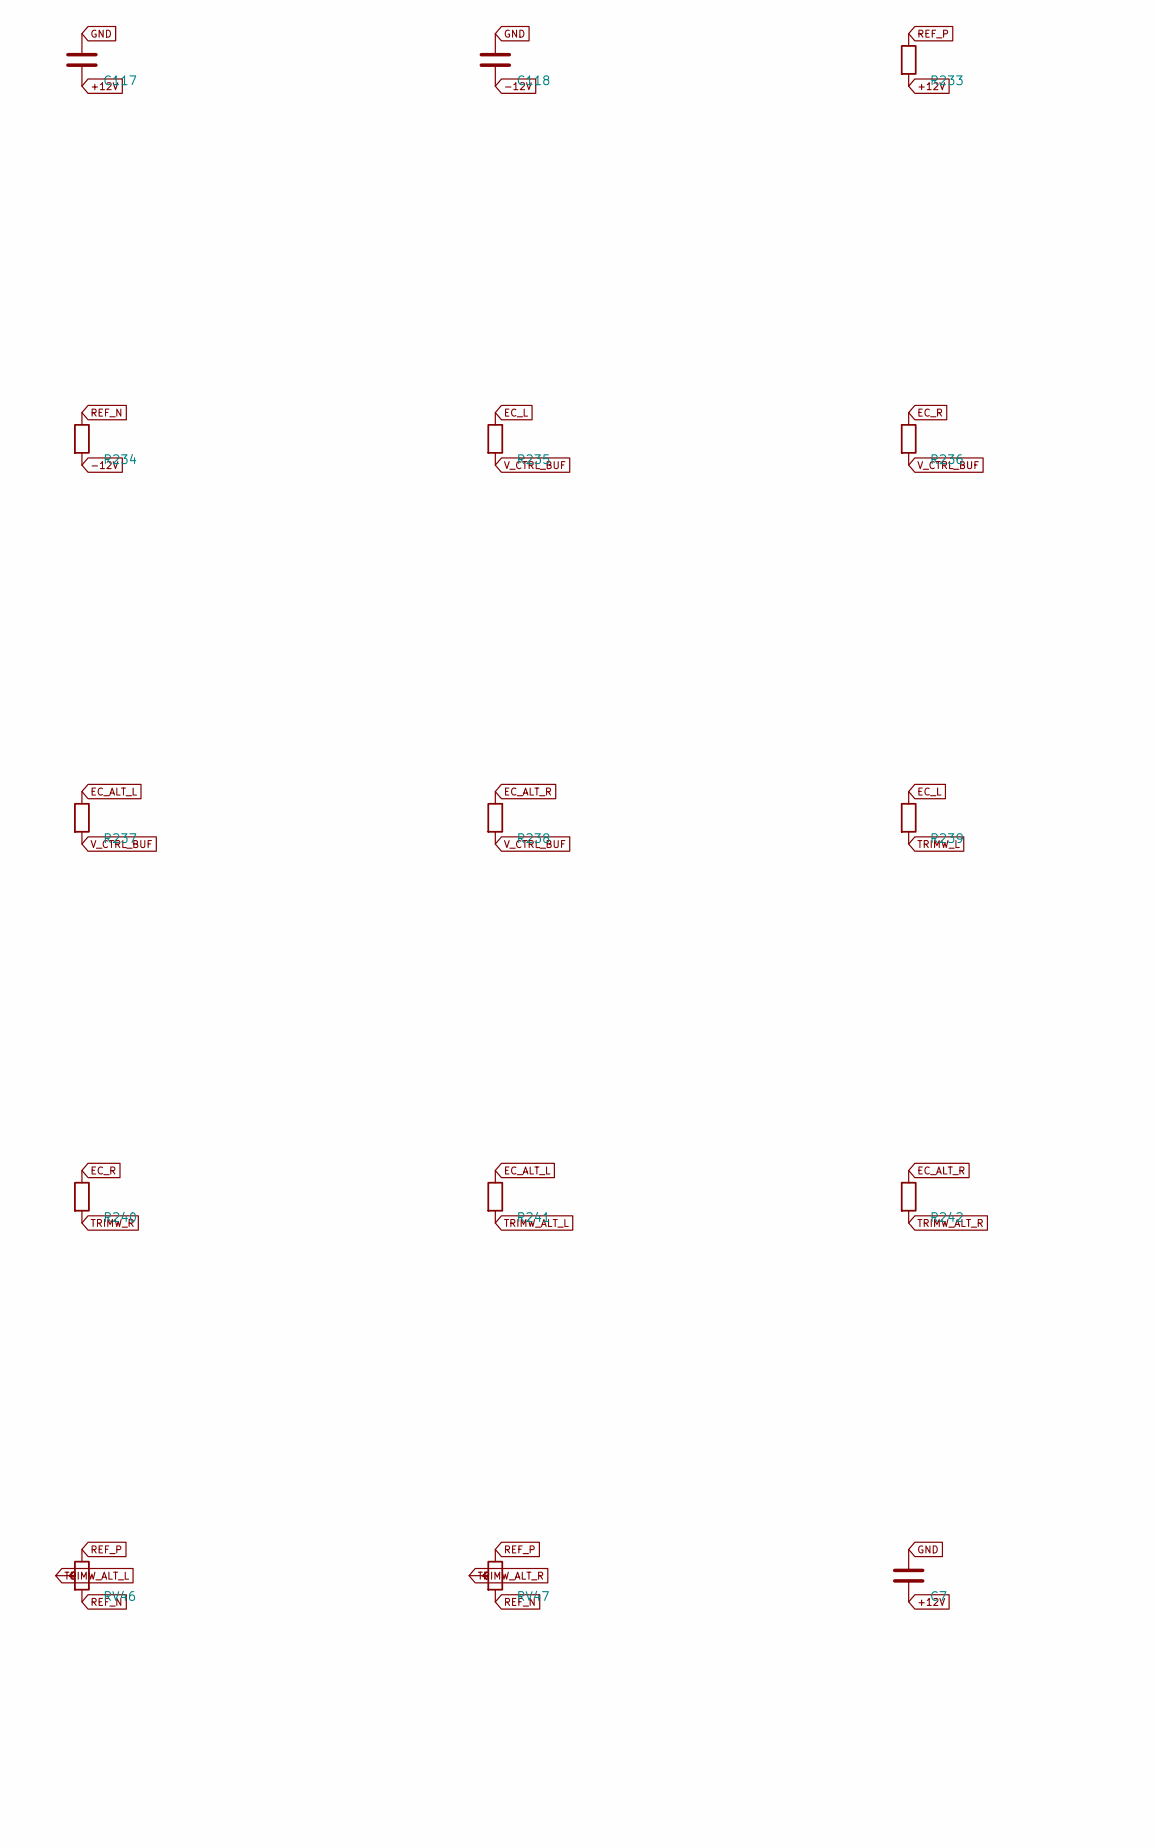
[picture p7: schematic pogo-block-4.kicad_sch, part in row 3, column 1]

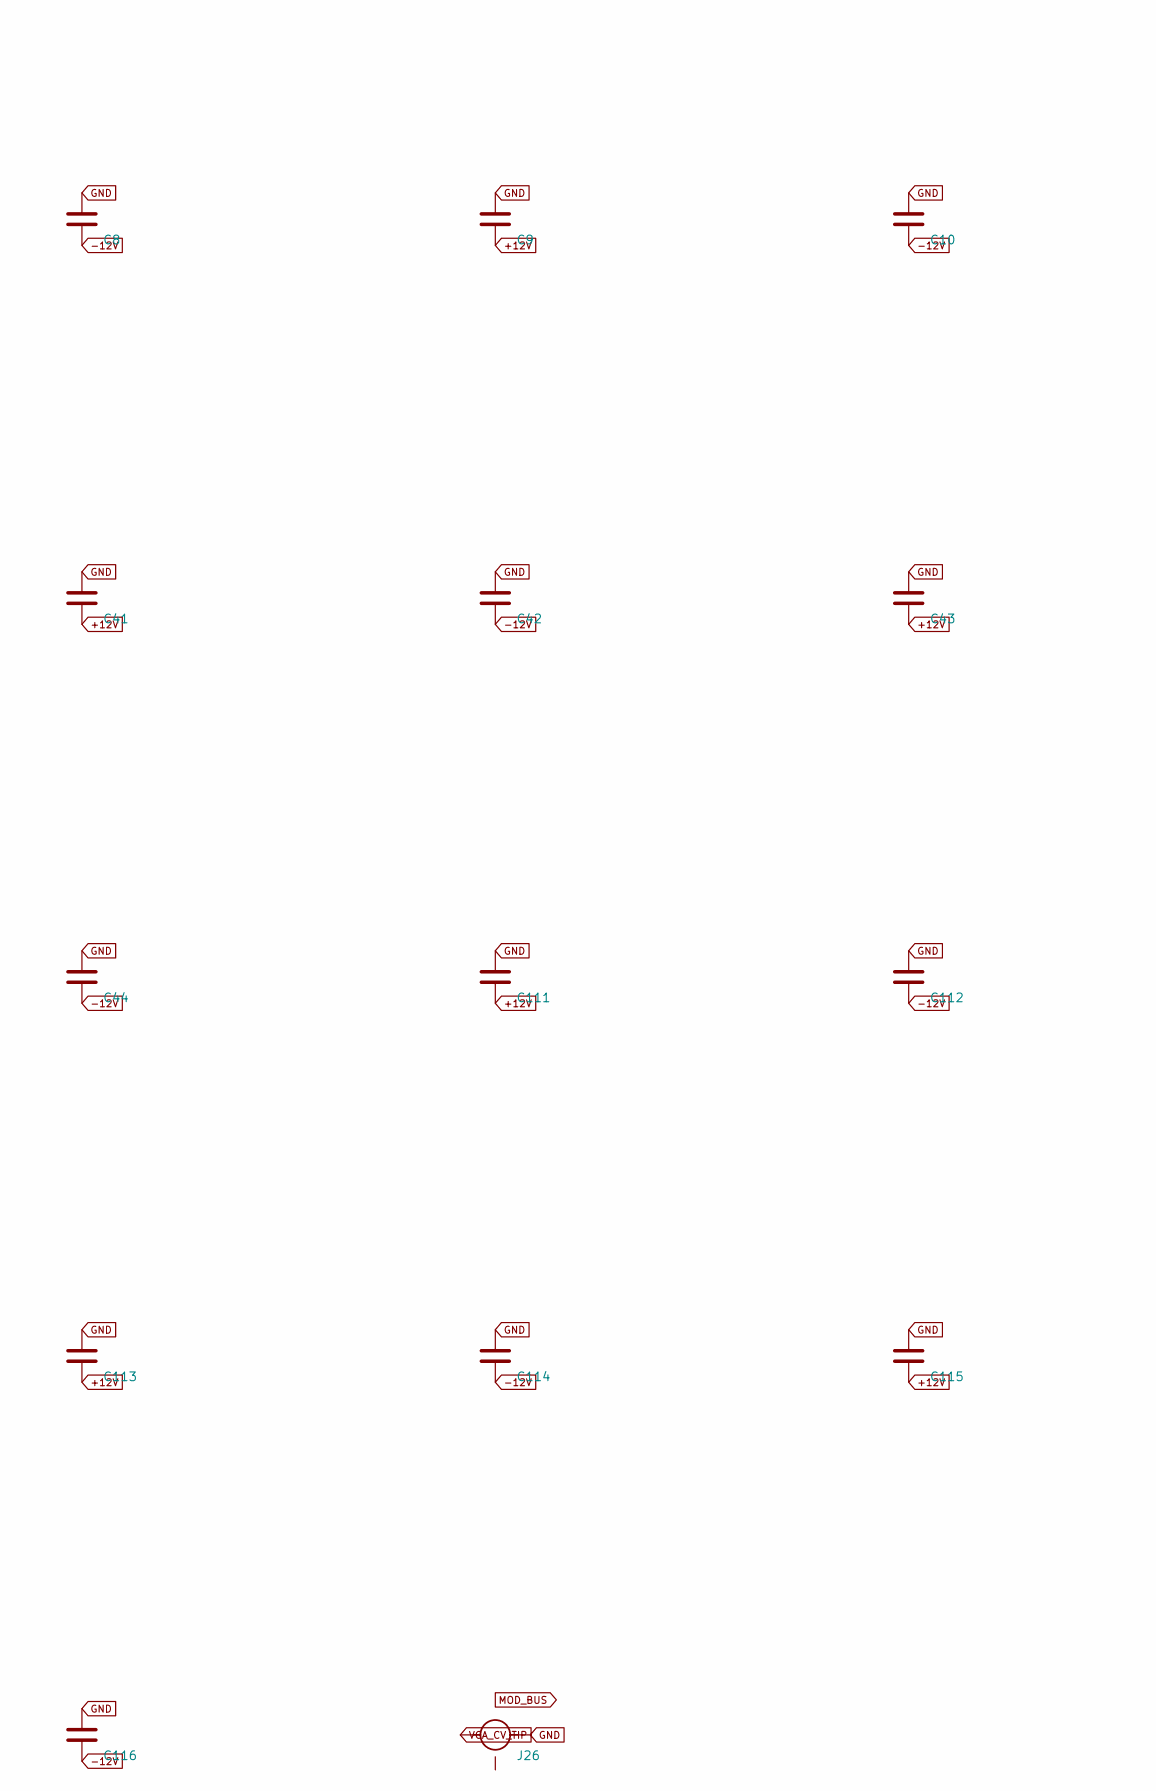
[picture p8: schematic pogo-block-4.kicad_sch, part in row 4, column 1]

Parts:
C7, C8, C9, C10, C41, C42, C43, C44, C111, C112, C113, C114, C115, C116, C117, C118: 100nF
D3: BAT54S; SOT-23
J26: VCA_IN; Jack_3.5mm_QingPu_WQP-PJ398SM_Vertical_CircularHoles
R7, R8, R40, R41, R129, R130, R131, R132: 20k
R9: 100R
R42, R43, R44, R45, R46: 100k
R233, R234: 11k3
R235, R236, R237, R238: 10k
R239, R240, R241, R242: 1M
RV1: VCA_UNITY_L; Potentiometer_Bourns_3224W
RV2: VCA_UNITY_R; Potentiometer_Bourns_3224W
RV44: VCA_AMT; Potentiometer_Songhuei_9mm_TallTrimmer_Vertical
RV45: VCA_OFS; Potentiometer_Songhuei_9mm_TallTrimmer_Vertical
RV46: VCA_UNITY_ALT_L; Potentiometer_Bourns_3224W
RV47: VCA_UNITY_ALT_R; Potentiometer_Bourns_3224W
U4, U5, U78, U79: THAT2180; SIP-8_2.54mm
U6, U63, U80, U97: TL072; SOIC-8_3.9x4.9mm_P1.27mm

Connections:
+12V: C7.2, C9.2, C41.2, C43.2, C111.2, C113.2, C115.2, C117.2, D3.2 (K2), R233.2, RV45.1, U4.5 (V-), U5.5 (V-), U6.4 (V-), U63.4 (V-), U78.5 (V-), U79.5 (V-), U80.4 (V-), U97.4 (V-)
-12V: C8.2, C10.2, C42.2, C44.2, C112.2, C114.2, C116.2, C118.2, D3.1 (A1), R234.2, U4.7 (V+), U5.7 (V+), U6.8 (V+), U63.8 (V+), U78.7 (V+), U79.7 (V+), U80.8 (V+), U97.8 (V+)
ALT_IV_L_IN: R131.2, U80.3 (In+)
ALT_IV_R_IN: R132.2, U80.5 (In+)
ALT_OUT_L: R129.2
ALT_OUT_R: R130.2
ALT_VCA_IN_L: R129.1, U78.6 (Gnd)
ALT_VCA_IN_R: R130.1, U79.6 (Gnd)
ALT_VCA_OUT_L: R131.1, U80.1 (Out)
ALT_VCA_OUT_R: R132.1, U80.7 (Out)
CVP: R9.1, R42.2
EC_ALT_L: R237.1, R241.1, U78.4 (Sym)
EC_ALT_R: R238.1, R242.1, U79.4 (Sym)
EC_L: R235.1, R239.1, U4.4 (Sym)
EC_R: R236.1, R240.1, U5.4 (Sym)
GND: C7.1, C8.1, C9.1, C10.1, C41.1, C42.1, C43.1, C44.1, C111.1, C112.1, C113.1, C114.1, C115.1, C116.1, C117.1, C118.1, J26.2 (S), RV45.3, U4.1 (Input), U4.2 (Ec+), U4.3 (Ec-), U5.1 (Input), U5.2 (Ec+), U5.3 (Ec-), U6.2 (In-), U6.6 (In-), U63.2 (In-), U63.6 (In-), U78.1 (Input), U78.2 (Ec+), U78.3 (Ec-), U79.1 (Input), U79.2 (Ec+), U79.3 (Ec-), U80.2 (In-), U80.6 (In-), U97.6 (In-)
IV_L_IN: R40.2, U6.3 (In+)
IV_R_IN: R41.2, U6.5 (In+)
NEFFCV: R43.1, R44.2, RV44.3, U63.1 (Out)
OFS_W: R45.2, RV45.2 (Wiper)
PEFFCV: R46.1, RV44.1, U63.7 (Out)
PG_OUT_L: R7.2
PG_OUT_R: R8.2
REF_N: R234.1, RV1.1, RV2.1, RV46.1, RV47.1
REF_P: R233.1, RV1.3, RV2.3, RV46.3, RV47.3
TRIMW_ALT_L: R241.2, RV46.2 (Wiper)
TRIMW_ALT_R: R242.2, RV47.2 (Wiper)
TRIMW_L: R239.2, RV1.2 (Wiper)
TRIMW_R: R240.2, RV2.2 (Wiper)
U63A_SUM: R42.1, R43.2, R45.1, U63.3 (In+)
U63B_INV: R44.1, R46.2, U63.5 (In+)
U97B_SPARE: U97.5 (In+), U97.7 (Out)
VCA_CV_TIP: J26.1 (T), R9.2
VCA_IN_L: R7.1, U4.6 (Gnd)
VCA_IN_R: R8.1, U5.6 (Gnd)
VCA_OUT_L: R40.1, U6.1 (Out)
VCA_OUT_R: R41.1, U6.7 (Out)
V_CTRL: RV44.2 (Wiper), U97.2 (In-)
V_CTRL_BUF: R235.2, R236.2, R237.2, R238.2, U97.1 (Out), U97.3 (In+)
