jeffmhopkins/POGO/kicad/pogo-block-5.kicad_sch

## KiCad design kicad/pogo-block-5.kicad_sch (2026-05-31)

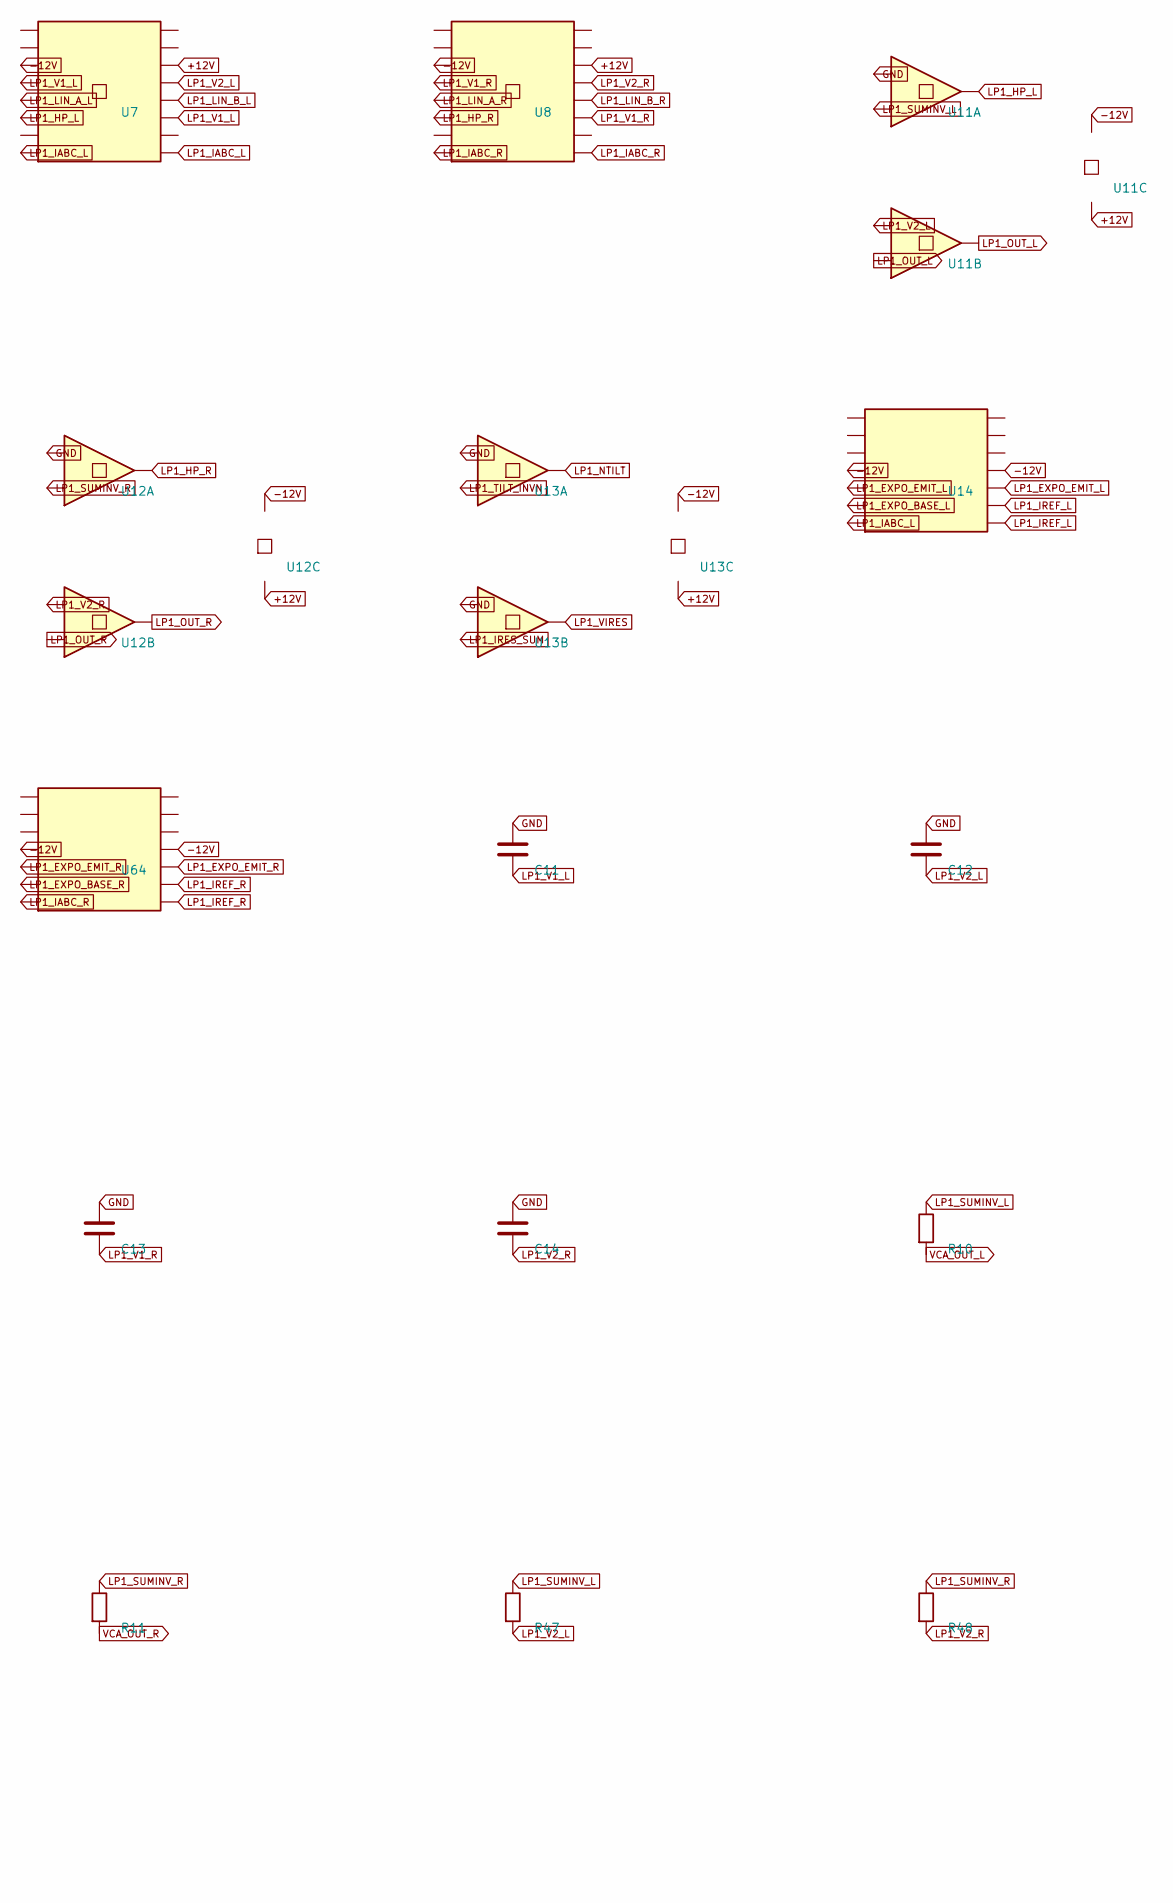
[picture p9: schematic pogo-block-5.kicad_sch, part in row 1, column 1]

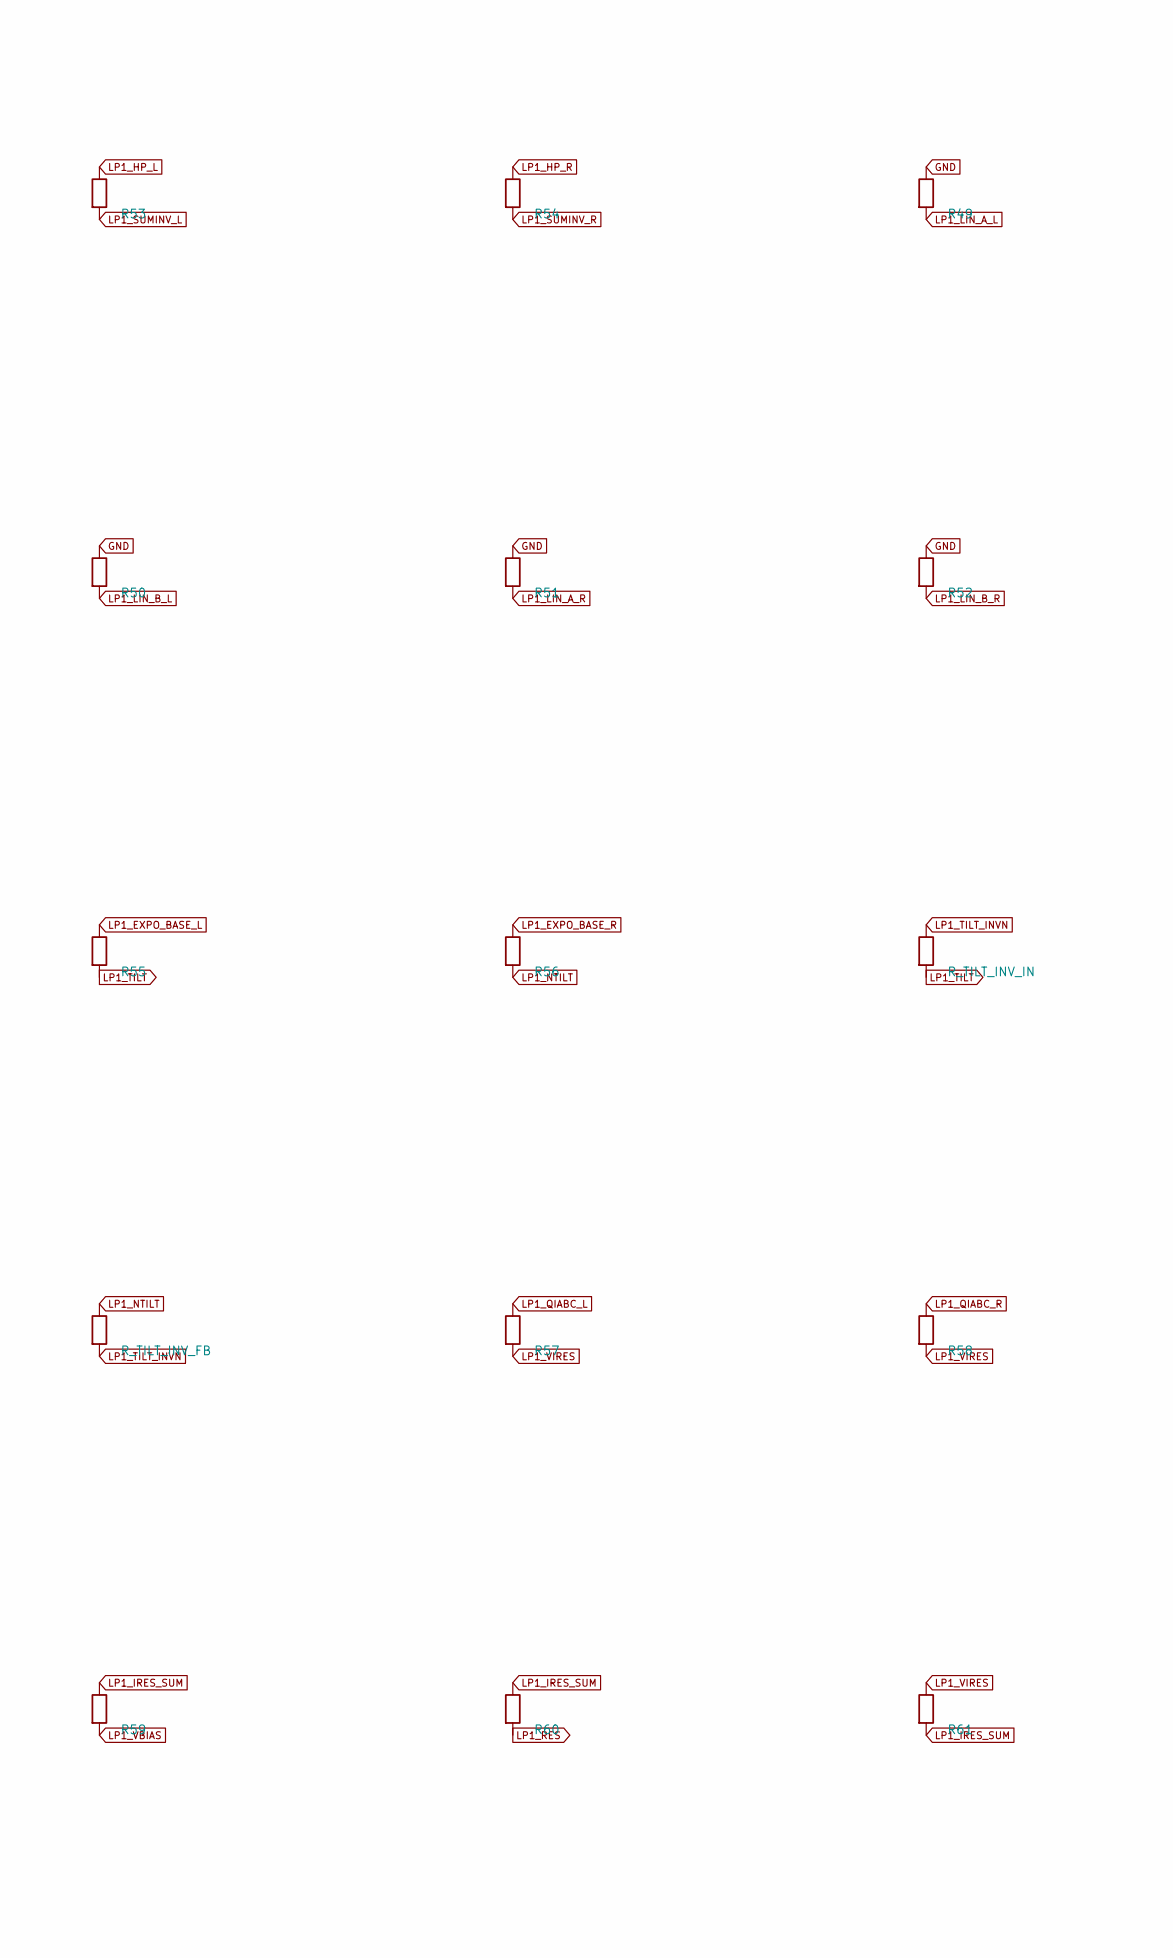
[picture p10: schematic pogo-block-5.kicad_sch, part in row 2, column 1]

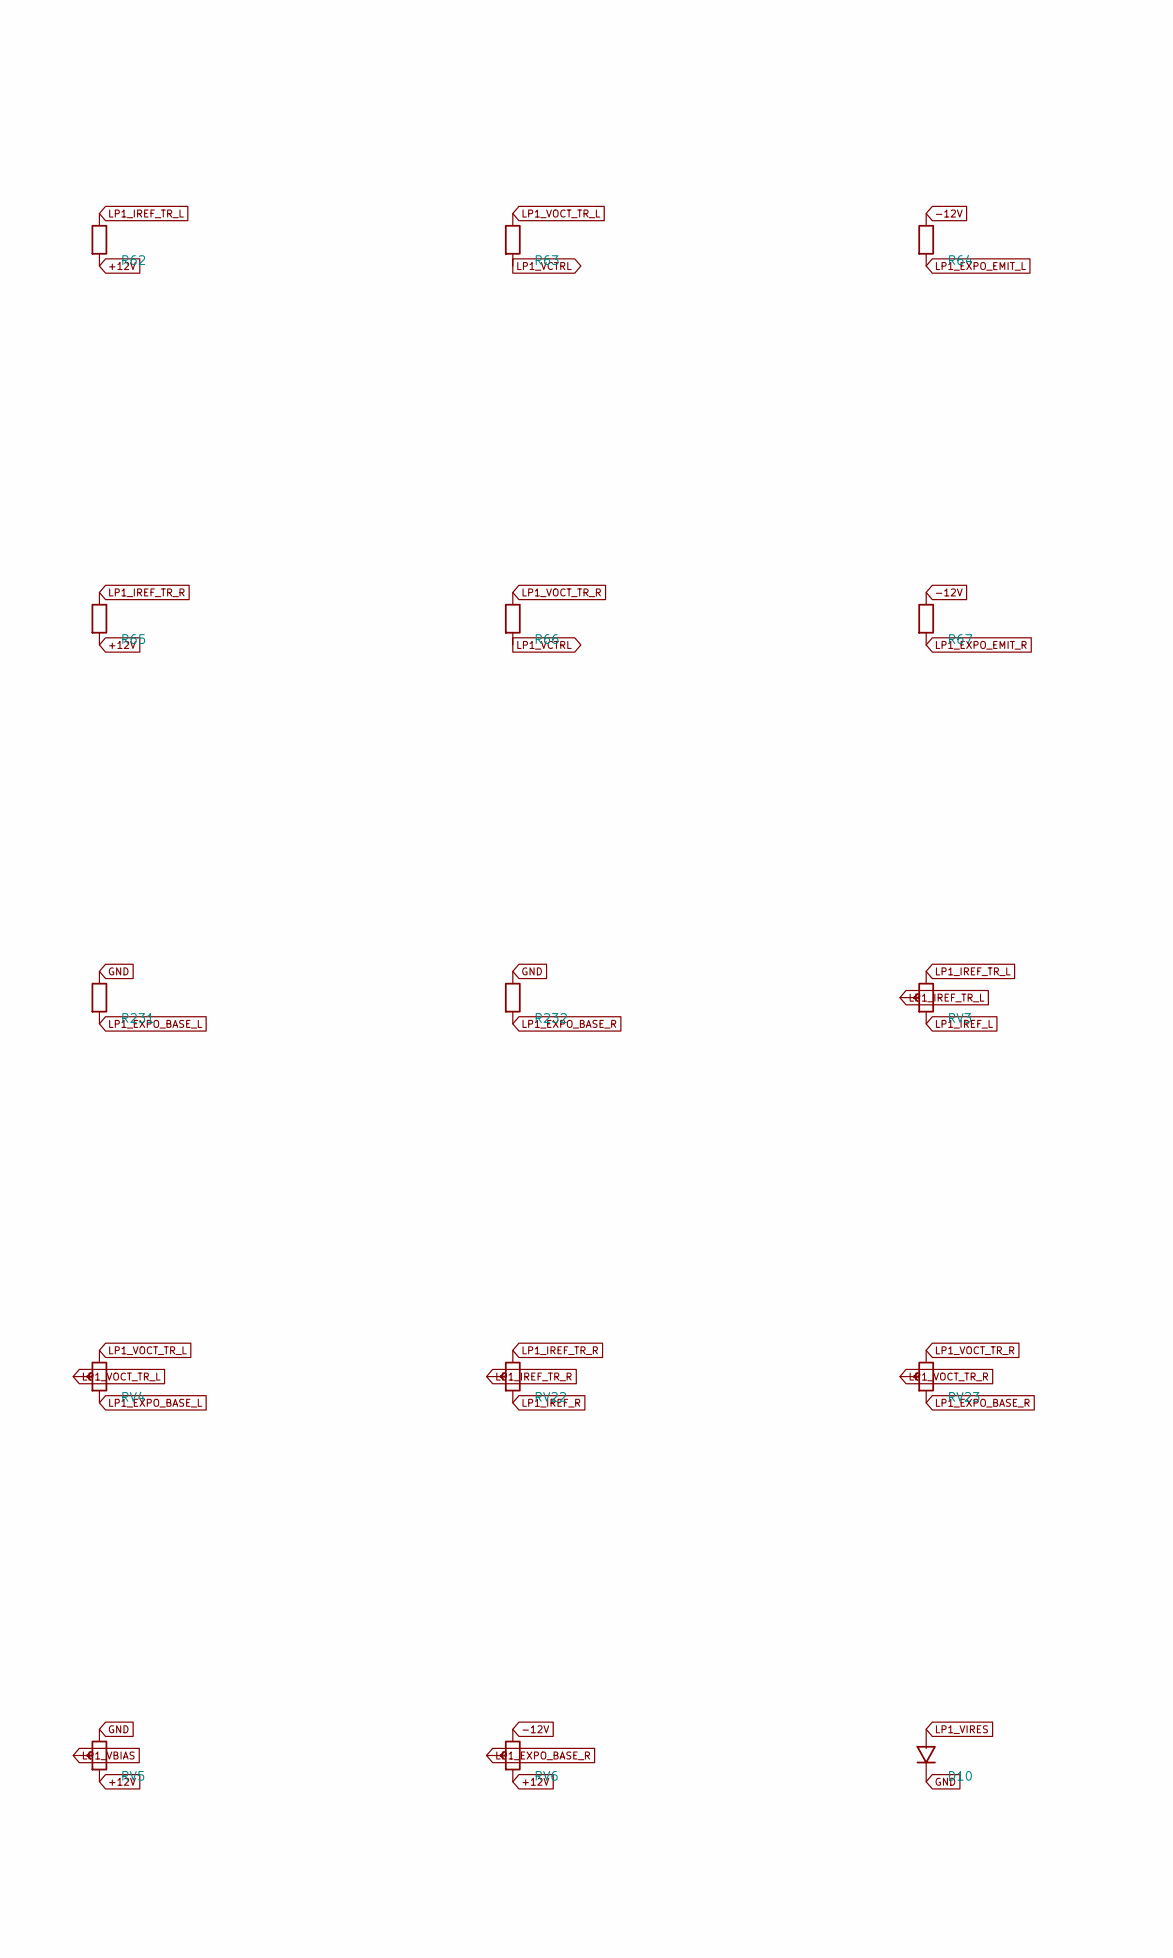
[picture p11: schematic pogo-block-5.kicad_sch, part in row 3, column 1]

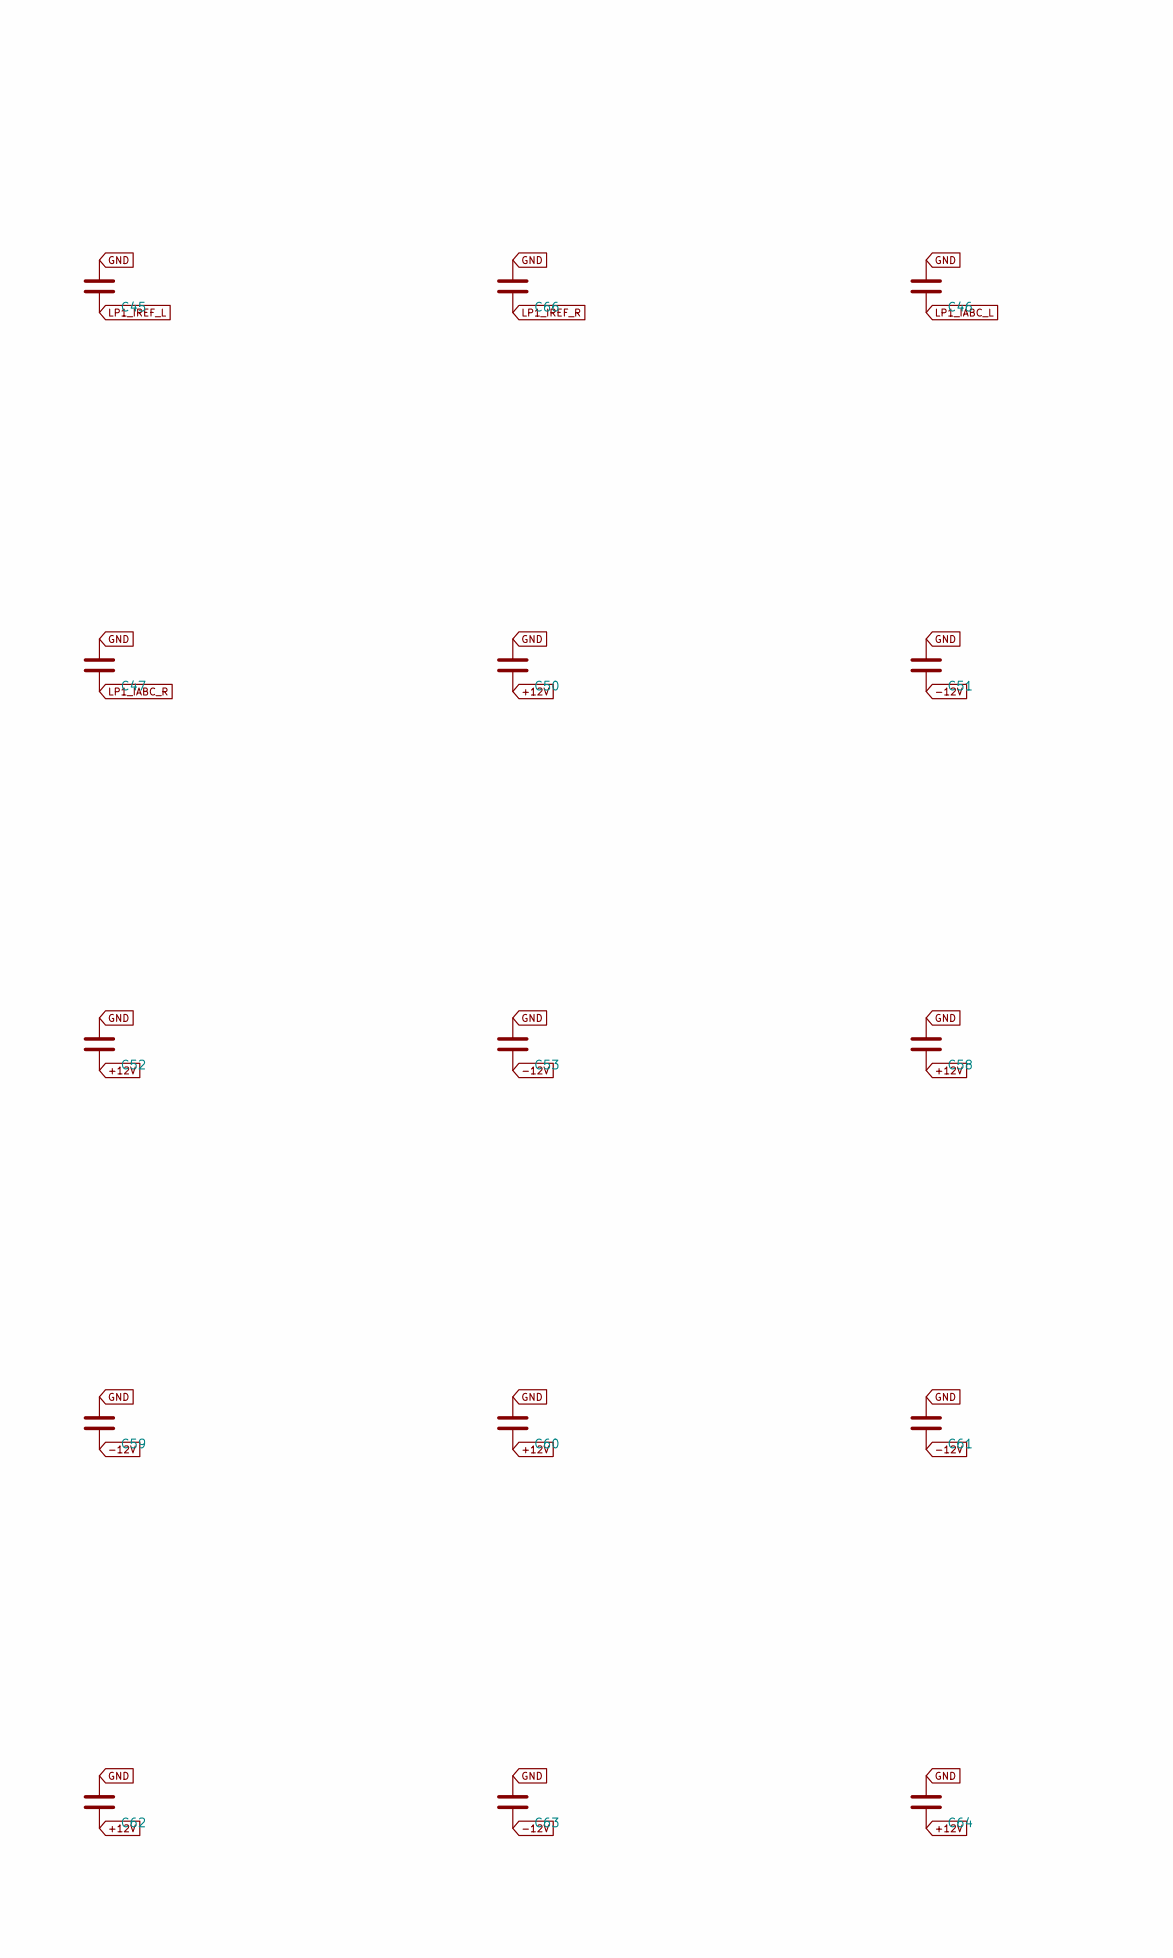
[picture p12: schematic pogo-block-5.kicad_sch, part in row 4, column 1]

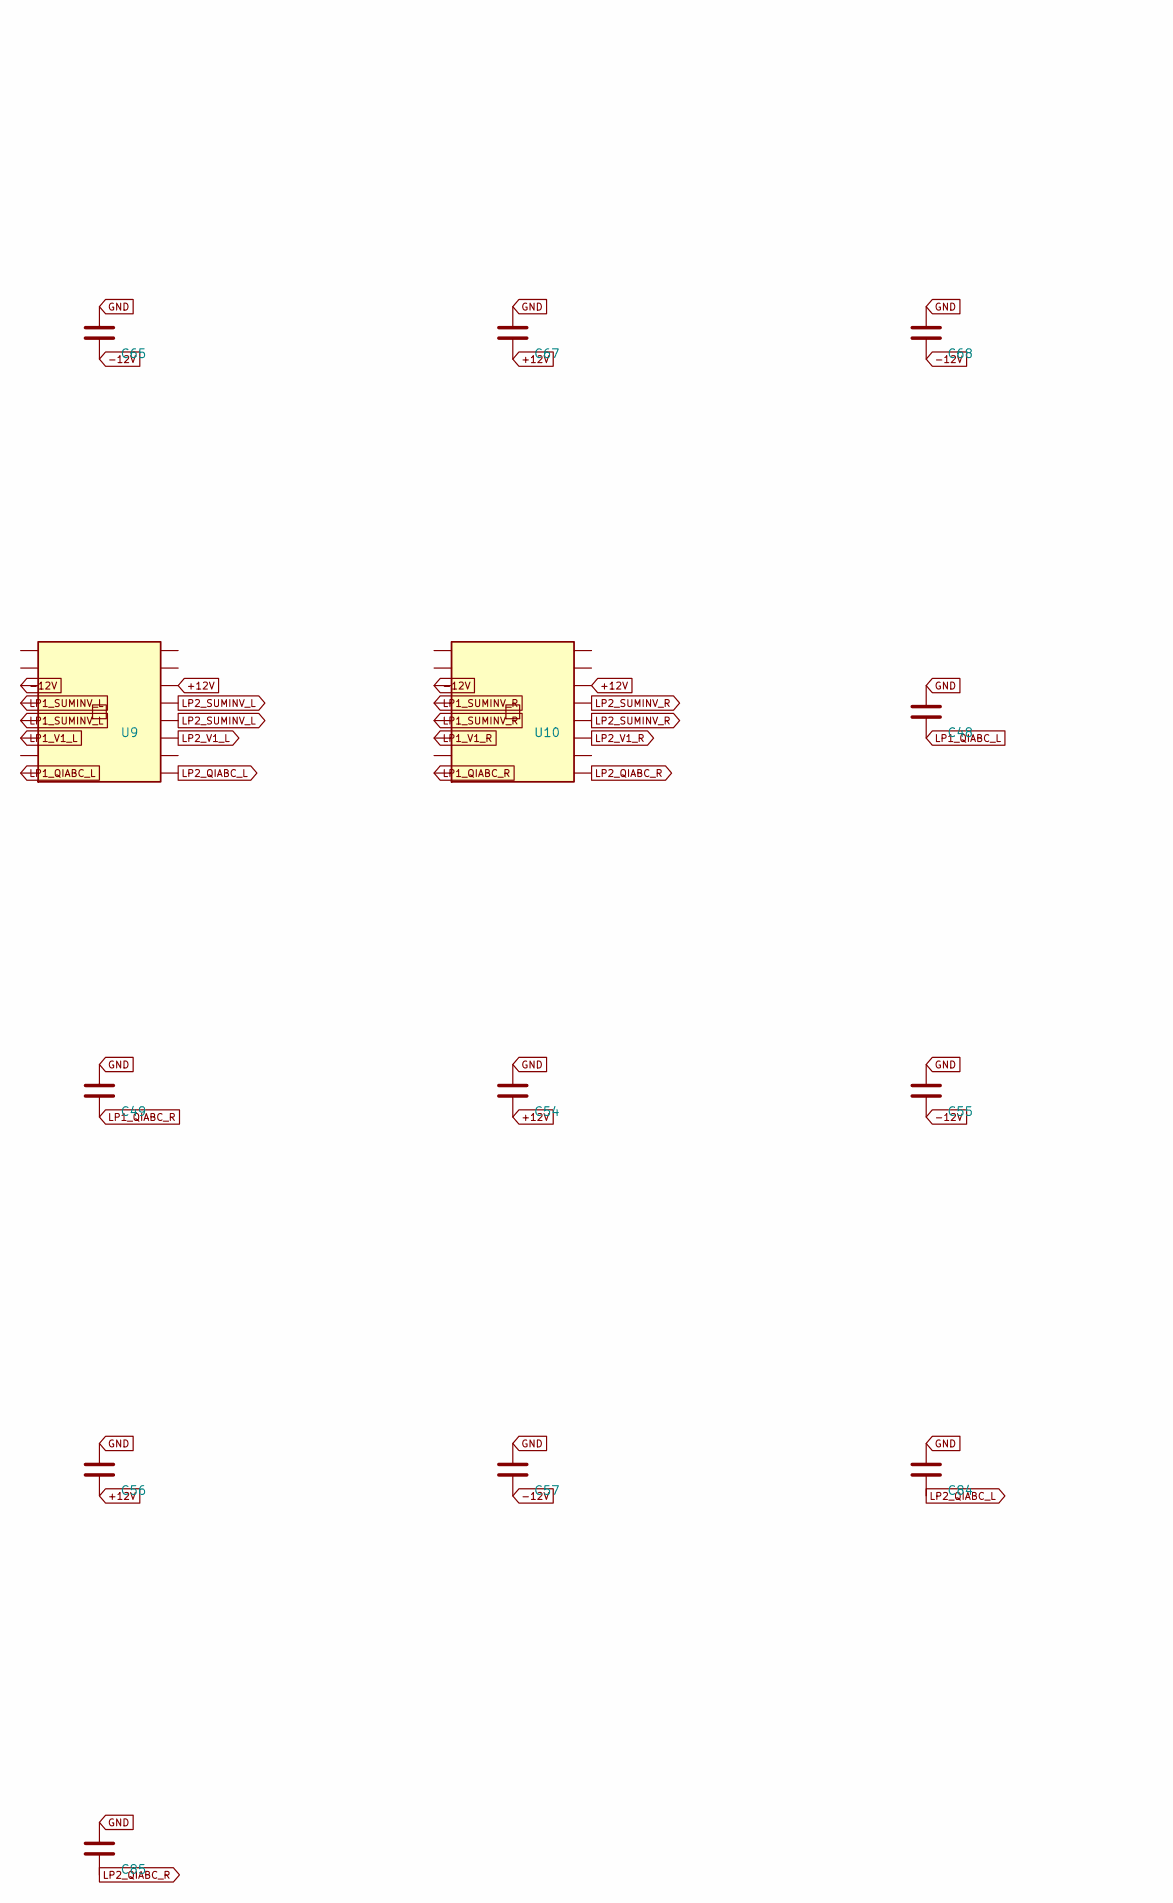
[picture p13: schematic pogo-block-5.kicad_sch, part in row 5, column 1]

Parts:
C11, C12, C13, C14: 47nF
C45, C50, C51, C52, C53, C54, C55, C56, C57, C58, C59, C60, C61, C62, C63, C64, C65, C66, C67, C68: 100nF
C46, C47, C48, C49, C84, C85: 10nF
D10: 1N4148W; D_SOD-123
R10, R11, R47, R48, R53, R54, R57, R58, R59, R60, R61: 100k
R49, R50, R51, R52, R64, R67: 1k
R55, R56: 54k9
R62, R65: 1M
R63, R66: 49k9
R231, R232: 1k; R_0805_2012Metric
RV3: LP1_FREF_L; Potentiometer_Bourns_3224W
RV4: LP1_1VOCT_L; Potentiometer_Bourns_3224W
RV5: LP1_QMAX; Potentiometer_Bourns_3224W
RV6: LP1_TILTNULL; Potentiometer_Bourns_3224W
RV22: LP1_FREF_R; Potentiometer_Bourns_3224W
RV23: LP1_1VOCT_R; Potentiometer_Bourns_3224W
R_TILT_INV_FB: 100k
R_TILT_INV_IN: 100k
U7, U8, U9, U10: LM13700; SOIC-16_3.9x9.9mm_P1.27mm
U11, U12: OPA1612; SOIC-8_3.9x4.9mm_P1.27mm
U13: TL072; SOIC-8_3.9x4.9mm_P1.27mm
U14, U64: THAT340; SOIC-14_3.9x8.7mm_P1.27mm

Connections:
+12V: C50.2, C52.2, C54.2, C56.2, C58.2, C60.2, C62.2, C64.2, C67.2, R62.2, R65.2, RV5.1, RV6.1, U7.14 (In+_B), U8.14 (In+_B), U9.14 (In+_B), U10.14 (In+_B), U11.4 (V-), U12.4 (V-), U13.4 (V-)
-12V: C51.2, C53.2, C55.2, C57.2, C59.2, C61.2, C63.2, C65.2, C68.2, R64.1, R67.1, RV6.3, U7.3 (In+_A), U8.3 (In+_A), U9.3 (In+_A), U10.3 (In+_A), U11.8 (V+), U12.8 (V+), U13.8 (V+), U14.4 (SUB), U14.11 (SUB), U64.4 (SUB), U64.11 (SUB)
GND: C11.1, C12.1, C13.1, C14.1, C45.1, C46.1, C47.1, C48.1, C49.1, C50.1, C51.1, C52.1, C53.1, C54.1, C55.1, C56.1, C57.1, C58.1, C59.1, C60.1, C61.1, C62.1, C63.1, C64.1, C65.1, C66.1, C67.1, C68.1, C84.1, C85.1, D10.K, R49.1, R50.1, R51.1, R52.1, R231.1, R232.1, RV5.3, U11.2 (In-), U12.2 (In-), U13.2 (In-), U13.6 (In-)
LP1_EXPO_BASE_L: R55.1, R231.2, RV4.1, U14.6 (Q3_B)
LP1_EXPO_BASE_R: R56.1, R232.2, RV6.2 (Wiper), RV23.1, U64.6 (Q3_B)
LP1_EXPO_EMIT_L: R64.2, U14.5 (Q3_E), U14.10 (Q4_E)
LP1_EXPO_EMIT_R: R67.2, U64.5 (Q3_E), U64.10 (Q4_E)
LP1_HP_L: R53.1, U7.6 (V-), U11.1 (Out)
LP1_HP_R: R54.1, U8.6 (V-), U12.1 (Out)
LP1_IABC_L: C46.2, U7.8 (BufOut_A), U7.9 (BufOut_B), U14.7 (Q3_C)
LP1_IABC_R: C47.2, U8.8 (BufOut_A), U8.9 (BufOut_B), U64.7 (Q3_C)
LP1_IREF_L: C45.2, RV3.1, U14.8 (Q4_C), U14.9 (Q4_B)
LP1_IREF_R: C66.2, RV22.1, U64.8 (Q4_C), U64.9 (Q4_B)
LP1_IREF_TR_L: R62.1, RV3.2 (Wiper), RV3.3
LP1_IREF_TR_R: R65.1, RV22.2 (Wiper), RV22.3
LP1_IRES_SUM: R59.1, R60.1, R61.2, U13.5 (In+)
LP1_LIN_A_L: R49.2, U7.5 (Out_A)
LP1_LIN_A_R: R51.2, U8.5 (Out_A)
LP1_LIN_B_L: R50.2, U7.12 (Out_B)
LP1_LIN_B_R: R52.2, U8.12 (Out_B)
LP1_NTILT: R56.2, R_TILT_INV_FB.1, U13.1 (Out)
LP1_OUT_L: U11.5 (In+), U11.7 (Out)
LP1_OUT_R: U12.5 (In+), U12.7 (Out)
LP1_QIABC_L: C48.2, R57.1, U9.8 (BufOut_A)
LP1_QIABC_R: C49.2, R58.1, U10.8 (BufOut_A)
LP1_RES: R60.2
LP1_SUMINV_L: R10.1, R47.1, R53.2, U9.4 (In-_A), U9.5 (Out_A), U11.3 (In+)
LP1_SUMINV_R: R11.1, R48.1, R54.2, U10.4 (In-_A), U10.5 (Out_A), U12.3 (In+)
LP1_TILT: R55.2, R_TILT_INV_IN.2
LP1_TILT_INVN: R_TILT_INV_FB.2, R_TILT_INV_IN.1, U13.3 (In+)
LP1_V1_L: C11.2, U7.4 (In-_A), U7.11 (V+), U9.6 (V-)
LP1_V1_R: C13.2, U8.4 (In-_A), U8.11 (V+), U10.6 (V-)
LP1_V2_L: C12.2, R47.2, U7.13 (In-_B), U11.6 (In-)
LP1_V2_R: C14.2, R48.2, U8.13 (In-_B), U12.6 (In-)
LP1_VBIAS: R59.2, RV5.2 (Wiper)
LP1_VCTRL: R63.2, R66.2
LP1_VIRES: D10.A, R57.2, R58.2, R61.1, U13.7 (Out)
LP1_VOCT_TR_L: R63.1, RV4.2 (Wiper), RV4.3
LP1_VOCT_TR_R: R66.1, RV23.2 (Wiper), RV23.3
LP2_QIABC_L: C84.2, U9.9 (BufOut_B)
LP2_QIABC_R: C85.2, U10.9 (BufOut_B)
LP2_SUMINV_L: U9.12 (Out_B), U9.13 (In-_B)
LP2_SUMINV_R: U10.12 (Out_B), U10.13 (In-_B)
LP2_V1_L: U9.11 (V+)
LP2_V1_R: U10.11 (V+)
VCA_OUT_L: R10.2
VCA_OUT_R: R11.2
