jeffmhopkins/POGO/kicad/pogo-block-6-dist1.kicad_sch

## KiCad design kicad/pogo-block-6-dist1.kicad_sch (2026-05-31)

Schematic: pogo-block-6-dist1.kicad_sch

Parts:
BP1_CLIP_LED: BP1_CLIP; LED_D3.0mm
C110_U31n, C110_U31p, C110_U34n, C110_U34p, C110_U35n, C110_U35p, C110_U40n, C110_U40p, C110_U41n, C110_U41p, C110_U75n, C110_U75p, C110_U85n, C110_U85p, C110_U86n, C110_U86p, C110_U91n, C110_U91p, C110_U94n, C110_U94p, C111_N4, C111_P4: 100nF
C_WF_1La, C_WF_1Lb, C_WF_1Ra, C_WF_1Rb: 47pF
D4_1La, D4_1Lb, D4_1Lc, D4_1Ld, D4_1Ra, D4_1Rb, D4_1Rc, D4_1Rd, D6_1La, D6_1Lb, D6_1Lc, D6_1Ld, D6_1Ra, D6_1Rb, D6_1Rc, D6_1Rd, D14_1a, D14_1b, D14_1c, D14_1d: 1N4148W; D_SOD-123
D5_1La, D5_1Lb, D5_1Ra, D5_1Rb: BZX84C5V1; SOT-23
R18_1L, R18_1R, R19_1L, R19_1R, R20_1L, R20_1R, R21_1L, R21_1R, R22_1L, R22_1R, R23_1L, R23_1R, R24_1L, R24_1R, R25_1L, R25_1R, R187, R189, R245, R246: 10k
R128_1sc, R128_1wf, R157, R158, R159, R160, R177, R178, R179, R180, R190, R191: 100k
R153, R154, R155, R156, R186, R188: 20k
R181, R182, R183, R184: 2.2M
R185: 1k
R243, R244: 22k6
R247, R248: 1M
RV33: BP1_DIST; Potentiometer_Alpha_RD901F-40-00D_Single_Vertical_CircularH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
RV51: BP1_DRIVE_UNITY_L; Potentiometer_Bourns_3224W
RV52: BP1_DRIVE_UNITY_R; Potentiometer_Bourns_3224W
R_f_wf_1L, R_f_wf_1R: 10k
U31, U75: CD4053; SOIC-16_3.9x9.9mm_P1.27mm
U34, U35, U40, U41: TL072; SOIC-8_3.9x4.9mm_P1.27mm
U85, U86: THAT2180; SIP-8_2.54mm
U91, U94: TL074; SOIC-14_3.9x8.7mm_P1.27mm

Connections:
+12V: C110_U31p.2, C110_U34p.2, C110_U35p.2, C110_U40p.2, C110_U41p.2, C110_U75p.2, C110_U85p.2, C110_U86p.2, C110_U91p.2, C110_U94p.2, R186.2, R243.2, U31.9 (C), U34.4 (V-), U35.4 (V-), U40.4 (V-), U41.4 (V-), U75.9 (C), U85.5 (V-), U86.5 (V-), U91.11 (V-), U94.11 (V-)
-12V: C110_U31n.2, C110_U34n.2, C110_U35n.2, C110_U40n.2, C110_U41n.2, C110_U75n.2, C110_U85n.2, C110_U86n.2, C110_U91n.2, C110_U94n.2, R188.2, R244.2, U31.11 (A), U34.8 (V+), U35.8 (V+), U40.8 (V+), U41.8 (V+), U75.11 (A), U85.7 (V+), U86.7 (V+), U91.4 (V+), U94.4 (V+)
BP1_CLIP_A_INP: R177.1, R181.1, U94.2 (In-)
BP1_CLIP_A_OUT: D14_1a.K, R181.2, U94.1 (Out)
BP1_CLIP_B_INN: R178.1, U94.5 (In+)
BP1_CLIP_B_INP: R182.1, R190.1, U94.6 (In-)
BP1_CLIP_B_OUT: D14_1b.K, R182.2, U94.7 (Out)
BP1_CLIP_C_INP: R179.1, R183.1, U94.9 (In-)
BP1_CLIP_C_OUT: D14_1c.K, R183.2, U94.8 (Out)
BP1_CLIP_D_INN: R180.1, U94.12 (In+)
BP1_CLIP_D_INP: R184.1, R191.1, U94.13 (In-)
BP1_CLIP_D_OUT: D14_1d.K, R184.2, U94.14 (Out)
BP1_CLIP_LEDA: BP1_CLIP_LED.K, R185.1
BP1_CLIP_OR: D14_1a.A, D14_1b.A, D14_1c.A, D14_1d.A, R185.2
BP1_DISTOUT_L: R177.2, R178.2, U31.5 (Z0)
BP1_DISTOUT_R: R179.2, R180.2, U31.2 (Y0)
BP1_DRIVEIN_L: R153.1, U85.6 (Gnd)
BP1_DRIVEIN_R: R154.1, U86.6 (Gnd)
BP1_DRIVEIV_L: R155.2, U91.3 (In+)
BP1_DRIVEIV_R: R156.2, U91.5 (In+)
BP1_DRIVEOUT_L: C_WF_1La.2, C_WF_1Lb.2, R18_1L.2, R20_1L.2, R22_1L.2, R155.1, U91.1 (Out)
BP1_DRIVEOUT_R: C_WF_1Ra.2, C_WF_1Rb.2, R18_1R.2, R20_1R.2, R22_1R.2, R156.1, U91.7 (Out)
BP1_DRIVE_KNOB: R157.2, RV33.2 (Wiper)
BP1_DRIVE_SPARE: U91.12 (In+), U91.14 (Out)
BP1_DRIVE_SUM: R157.1, R158.1, R159.1, R160.2, U91.10 (In+)
BP1_HCOUT_L: D5_1La.1 (A), R21_1L.1, U34.7 (Out), U75.4 (Z)
BP1_HCOUT_R: D5_1Ra.1 (A), R21_1R.1, U35.7 (Out), U75.15 (Y)
BP1_HCVG_L: R20_1L.1, R21_1L.2, U34.5 (In+)
BP1_HCVG_R: R20_1R.1, R21_1R.2, U35.5 (In+)
BP1_HCZMID_L: D5_1La.3 (K), D5_1Lb.3 (K)
BP1_HCZMID_R: D5_1Ra.3 (K), D5_1Rb.3 (K)
BP1_MID_L: U31.4 (Z), U75.5 (Z0)
BP1_MID_R: U31.15 (Y), U75.2 (Y0)
BP1_SCM1_L: D4_1La.A, D4_1Lb.K
BP1_SCM1_R: D4_1Ra.A, D4_1Rb.K
BP1_SCM2_L: D4_1Lc.A, D4_1Ld.K
BP1_SCM2_R: D4_1Rc.A, D4_1Rd.K
BP1_SCOUT_L: D4_1La.K, D4_1Ld.A, R19_1L.1, U31.3 (Z1), U34.1 (Out)
BP1_SCOUT_R: D4_1Ra.K, D4_1Rd.A, R19_1R.1, U31.1 (Y1), U35.1 (Out)
BP1_SCVG_L: D4_1Lb.A, D4_1Lc.K, R18_1L.1, R19_1L.2, U34.3 (In+)
BP1_SCVG_R: D4_1Rb.A, D4_1Rc.K, R18_1R.1, R19_1R.2, U35.3 (In+)
BP1_SEL_SC: R128_1sc.1, U31.7 (VEE), U31.8 (VSS)
BP1_SEL_WF: R128_1wf.1, U75.7 (VEE), U75.8 (VSS)
BP1_VFOLDIN_L: R23_1L.1, R24_1L.2, R25_1L.2, U40.1 (Out)
BP1_VFOLDIN_R: R23_1R.1, R24_1R.2, R25_1R.2, U41.1 (Out)
BP1_WFCLAMP_L: D6_1La.K, D6_1Ld.A, R24_1L.1, U40.6 (In-)
BP1_WFCLAMP_R: D6_1Ra.K, D6_1Rd.A, R24_1R.1, U41.6 (In-)
BP1_WFCM1_L: D6_1La.A, D6_1Lb.K
BP1_WFCM1_R: D6_1Ra.A, D6_1Rb.K
BP1_WFCM2_L: D6_1Lc.A, D6_1Ld.K
BP1_WFCM2_R: D6_1Rc.A, D6_1Rd.K
BP1_WFFVG_L: R25_1L.1, R_f_wf_1L.2, U40.5 (In+)
BP1_WFFVG_R: R25_1R.1, R_f_wf_1R.2, U41.5 (In+)
BP1_WFOUT_L: R_f_wf_1L.1, U40.7 (Out), U75.3 (Z1)
BP1_WFOUT_R: R_f_wf_1R.1, U41.7 (Out), U75.1 (Y1)
BP1_WFVG_L: R22_1L.1, R23_1L.2, U40.3 (In+)
BP1_WFVG_R: R22_1R.1, R23_1R.2, U41.3 (In+)
EC_BP1_DRIVE_L: R245.1, R247.1, U85.4 (Sym)
EC_BP1_DRIVE_R: R246.1, R248.1, U86.4 (Sym)
GND: BP1_CLIP_LED.A, C110_U31n.1, C110_U31p.1, C110_U34n.1, C110_U34p.1, C110_U35n.1, C110_U35p.1, C110_U40n.1, C110_U40p.1, C110_U41n.1, C110_U41p.1, C110_U75n.1, C110_U75p.1, C110_U85n.1, C110_U85p.1, C110_U86n.1, C110_U86p.1, C110_U91n.1, C110_U91p.1, C110_U94n.1, C110_U94p.1, C111_N4.1, C111_P4.1, C_WF_1La.1, C_WF_1Lb.1, C_WF_1Ra.1, C_WF_1Rb.1, D5_1Lb.1 (A), D5_1Rb.1 (A), D6_1Lb.A, D6_1Lc.K, D6_1Rb.A, D6_1Rc.K, R187.1, R189.1, RV33.3, U31.6 (INH), U31.10 (B), U34.2 (In-), U34.6 (In-), U35.2 (In-), U35.6 (In-), U40.2 (In-), U41.2 (In-), U75.6 (INH), U75.10 (B), U85.1 (Input), U85.2 (Ec+), U85.3 (Ec-), U86.1 (Input), U86.2 (Ec+), U86.3 (Ec-), U91.2 (In-), U91.6 (In-), U91.9 (In-), U91.13 (In-)
LP1_OUT_L: R153.2
LP1_OUT_R: R154.2
MOD_BP1_DIST: R158.2
REF_N1: R244.1, RV51.1, RV52.1
REF_P1: R243.1, RV51.3, RV52.3
TRIMW_BP1_L: R247.2, RV51.2 (Wiper)
TRIMW_BP1_R: R248.2, RV52.2 (Wiper)
V5LOGIC: R128_1sc.2, R128_1wf.2, R159.2, RV33.1
VREF_N4: C111_N4.2, R188.1, R189.2, R190.2, R191.2
VREF_P4: C111_P4.2, R186.1, R187.2, U94.3 (In+), U94.10 (In+)
V_DRIVE_CTRL_1: R160.1, R245.2, R246.2, U91.8 (Out)
