jeffmhopkins/POGO/kicad/pogo-block-6-dist2.kicad_sch

## KiCad design kicad/pogo-block-6-dist2.kicad_sch (2026-05-31)

Schematic: pogo-block-6-dist2.kicad_sch

Parts:
BP2_CLIP_LED: BP2_CLIP; LED_D3.0mm
C110_U32n, C110_U32p, C110_U36n, C110_U36p, C110_U37n, C110_U37p, C110_U42n, C110_U42p, C110_U43n, C110_U43p, C110_U76n, C110_U76p, C110_U87n, C110_U87p, C110_U88n, C110_U88p, C110_U92n, C110_U92p, C110_U95n, C110_U95p: 100nF
C_WF_2La, C_WF_2Lb, C_WF_2Ra, C_WF_2Rb: 47pF
D4_2La, D4_2Lb, D4_2Lc, D4_2Ld, D4_2Ra, D4_2Rb, D4_2Rc, D4_2Rd, D6_2La, D6_2Lb, D6_2Lc, D6_2Ld, D6_2Ra, D6_2Rb, D6_2Rc, D6_2Rd, D15_2a, D15_2b, D15_2c, D15_2d: 1N4148W; D_SOD-123
D5_2La, D5_2Lb, D5_2Ra, D5_2Rb: BZX84C5V1; SOT-23
R18_2L, R18_2R, R19_2L, R19_2R, R20_2L, R20_2R, R21_2L, R21_2R, R22_2L, R22_2R, R23_2L, R23_2R, R24_2L, R24_2R, R25_2L, R25_2R, R251, R252: 10k
R128_2sc, R128_2wf, R165, R166, R167, R168, R192, R193, R194, R195, R201, R202: 100k
R161, R162, R163, R164: 20k
R196, R197, R198, R199: 2.2M
R200: 1k
R249, R250: 22k6
R253, R254: 1M
RV36: BP2_DIST; Potentiometer_Alpha_RD901F-40-00D_Single_Vertical_CircularH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
RV53: BP2_DRIVE_UNITY_L; Potentiometer_Bourns_3224W
RV54: BP2_DRIVE_UNITY_R; Potentiometer_Bourns_3224W
R_f_wf_2L, R_f_wf_2R: 10k
U32, U76: CD4053; SOIC-16_3.9x9.9mm_P1.27mm
U36, U37, U42, U43: TL072; SOIC-8_3.9x4.9mm_P1.27mm
U87, U88: THAT2180; SIP-8_2.54mm
U92, U95: TL074; SOIC-14_3.9x8.7mm_P1.27mm

Connections:
+12V: C110_U32p.2, C110_U36p.2, C110_U37p.2, C110_U42p.2, C110_U43p.2, C110_U76p.2, C110_U87p.2, C110_U88p.2, C110_U92p.2, C110_U95p.2, R249.2, U32.9 (C), U36.4 (V-), U37.4 (V-), U42.4 (V-), U43.4 (V-), U76.9 (C), U87.5 (V-), U88.5 (V-), U92.11 (V-), U95.11 (V-)
-12V: C110_U32n.2, C110_U36n.2, C110_U37n.2, C110_U42n.2, C110_U43n.2, C110_U76n.2, C110_U87n.2, C110_U88n.2, C110_U92n.2, C110_U95n.2, R250.2, U32.11 (A), U36.8 (V+), U37.8 (V+), U42.8 (V+), U43.8 (V+), U76.11 (A), U87.7 (V+), U88.7 (V+), U92.4 (V+), U95.4 (V+)
BP2_CLIP_A_INP: R192.1, R196.1, U95.2 (In-)
BP2_CLIP_A_OUT: D15_2a.K, R196.2, U95.1 (Out)
BP2_CLIP_B_INN: R193.1, U95.5 (In+)
BP2_CLIP_B_INP: R197.1, R201.1, U95.6 (In-)
BP2_CLIP_B_OUT: D15_2b.K, R197.2, U95.7 (Out)
BP2_CLIP_C_INP: R194.1, R198.1, U95.9 (In-)
BP2_CLIP_C_OUT: D15_2c.K, R198.2, U95.8 (Out)
BP2_CLIP_D_INN: R195.1, U95.12 (In+)
BP2_CLIP_D_INP: R199.1, R202.1, U95.13 (In-)
BP2_CLIP_D_OUT: D15_2d.K, R199.2, U95.14 (Out)
BP2_CLIP_LEDA: BP2_CLIP_LED.K, R200.1
BP2_CLIP_OR: D15_2a.A, D15_2b.A, D15_2c.A, D15_2d.A, R200.2
BP2_DISTOUT_L: R192.2, R193.2, U32.5 (Z0)
BP2_DISTOUT_R: R194.2, R195.2, U32.2 (Y0)
BP2_DRIVEIN_L: R161.1, U87.6 (Gnd)
BP2_DRIVEIN_R: R162.1, U88.6 (Gnd)
BP2_DRIVEIV_L: R163.2, U92.3 (In+)
BP2_DRIVEIV_R: R164.2, U92.5 (In+)
BP2_DRIVEOUT_L: C_WF_2La.2, C_WF_2Lb.2, R18_2L.2, R20_2L.2, R22_2L.2, R163.1, U92.1 (Out)
BP2_DRIVEOUT_R: C_WF_2Ra.2, C_WF_2Rb.2, R18_2R.2, R20_2R.2, R22_2R.2, R164.1, U92.7 (Out)
BP2_DRIVE_KNOB: R165.2, RV36.2 (Wiper)
BP2_DRIVE_SPARE: U92.12 (In+), U92.14 (Out)
BP2_DRIVE_SUM: R165.1, R166.1, R167.1, R168.2, U92.10 (In+)
BP2_HCOUT_L: D5_2La.1 (A), R21_2L.1, U36.7 (Out), U76.4 (Z)
BP2_HCOUT_R: D5_2Ra.1 (A), R21_2R.1, U37.7 (Out), U76.15 (Y)
BP2_HCVG_L: R20_2L.1, R21_2L.2, U36.5 (In+)
BP2_HCVG_R: R20_2R.1, R21_2R.2, U37.5 (In+)
BP2_HCZMID_L: D5_2La.3 (K), D5_2Lb.3 (K)
BP2_HCZMID_R: D5_2Ra.3 (K), D5_2Rb.3 (K)
BP2_MID_L: U32.4 (Z), U76.5 (Z0)
BP2_MID_R: U32.15 (Y), U76.2 (Y0)
BP2_SCM1_L: D4_2La.A, D4_2Lb.K
BP2_SCM1_R: D4_2Ra.A, D4_2Rb.K
BP2_SCM2_L: D4_2Lc.A, D4_2Ld.K
BP2_SCM2_R: D4_2Rc.A, D4_2Rd.K
BP2_SCOUT_L: D4_2La.K, D4_2Ld.A, R19_2L.1, U32.3 (Z1), U36.1 (Out)
BP2_SCOUT_R: D4_2Ra.K, D4_2Rd.A, R19_2R.1, U32.1 (Y1), U37.1 (Out)
BP2_SCVG_L: D4_2Lb.A, D4_2Lc.K, R18_2L.1, R19_2L.2, U36.3 (In+)
BP2_SCVG_R: D4_2Rb.A, D4_2Rc.K, R18_2R.1, R19_2R.2, U37.3 (In+)
BP2_SEL_SC: R128_2sc.1, U32.7 (VEE), U32.8 (VSS)
BP2_SEL_WF: R128_2wf.1, U76.7 (VEE), U76.8 (VSS)
BP2_VFOLDIN_L: R23_2L.1, R24_2L.2, R25_2L.2, U42.1 (Out)
BP2_VFOLDIN_R: R23_2R.1, R24_2R.2, R25_2R.2, U43.1 (Out)
BP2_WFCLAMP_L: D6_2La.K, D6_2Ld.A, R24_2L.1, U42.6 (In-)
BP2_WFCLAMP_R: D6_2Ra.K, D6_2Rd.A, R24_2R.1, U43.6 (In-)
BP2_WFCM1_L: D6_2La.A, D6_2Lb.K
BP2_WFCM1_R: D6_2Ra.A, D6_2Rb.K
BP2_WFCM2_L: D6_2Lc.A, D6_2Ld.K
BP2_WFCM2_R: D6_2Rc.A, D6_2Rd.K
BP2_WFFVG_L: R25_2L.1, R_f_wf_2L.2, U42.5 (In+)
BP2_WFFVG_R: R25_2R.1, R_f_wf_2R.2, U43.5 (In+)
BP2_WFOUT_L: R_f_wf_2L.1, U42.7 (Out), U76.3 (Z1)
BP2_WFOUT_R: R_f_wf_2R.1, U43.7 (Out), U76.1 (Y1)
BP2_WFVG_L: R22_2L.1, R23_2L.2, U42.3 (In+)
BP2_WFVG_R: R22_2R.1, R23_2R.2, U43.3 (In+)
EC_BP2_DRIVE_L: R251.1, R253.1, U87.4 (Sym)
EC_BP2_DRIVE_R: R252.1, R254.1, U88.4 (Sym)
GND: BP2_CLIP_LED.A, C110_U32n.1, C110_U32p.1, C110_U36n.1, C110_U36p.1, C110_U37n.1, C110_U37p.1, C110_U42n.1, C110_U42p.1, C110_U43n.1, C110_U43p.1, C110_U76n.1, C110_U76p.1, C110_U87n.1, C110_U87p.1, C110_U88n.1, C110_U88p.1, C110_U92n.1, C110_U92p.1, C110_U95n.1, C110_U95p.1, C_WF_2La.1, C_WF_2Lb.1, C_WF_2Ra.1, C_WF_2Rb.1, D5_2Lb.1 (A), D5_2Rb.1 (A), D6_2Lb.A, D6_2Lc.K, D6_2Rb.A, D6_2Rc.K, RV36.3, U32.6 (INH), U32.10 (B), U36.2 (In-), U36.6 (In-), U37.2 (In-), U37.6 (In-), U42.2 (In-), U43.2 (In-), U76.6 (INH), U76.10 (B), U87.1 (Input), U87.2 (Ec+), U87.3 (Ec-), U88.1 (Input), U88.2 (Ec+), U88.3 (Ec-), U92.2 (In-), U92.6 (In-), U92.9 (In-), U92.13 (In-)
LP1_OUT_L: R161.2
LP1_OUT_R: R162.2
MOD_BP2_DIST: R166.2
REF_N2: R250.1, RV53.1, RV54.1
REF_P2: R249.1, RV53.3, RV54.3
TRIMW_BP2_L: R253.2, RV53.2 (Wiper)
TRIMW_BP2_R: R254.2, RV54.2 (Wiper)
V5LOGIC: R128_2sc.2, R128_2wf.2, R167.2, RV36.1
VREF_N4: R201.2, R202.2
VREF_P4: U95.3 (In+), U95.10 (In+)
V_DRIVE_CTRL_2: R168.1, R251.2, R252.2, U92.8 (Out)
