jeffmhopkins/POGO/kicad/pogo-block-6-dist3.kicad_sch

## KiCad design kicad/pogo-block-6-dist3.kicad_sch (2026-05-31)

Schematic: pogo-block-6-dist3.kicad_sch

Parts:
BP3_CLIP_LED: BP3_CLIP; LED_D3.0mm
C110_U33n, C110_U33p, C110_U38n, C110_U38p, C110_U39n, C110_U39p, C110_U44n, C110_U44p, C110_U45n, C110_U45p, C110_U77n, C110_U77p, C110_U81n, C110_U81p, C110_U89n, C110_U89p, C110_U90n, C110_U90p, C110_U93n, C110_U93p, C110_U96n, C110_U96p: 100nF
C_WF_3La, C_WF_3Lb, C_WF_3Ra, C_WF_3Rb: 47pF
D4_3La, D4_3Lb, D4_3Lc, D4_3Ld, D4_3Ra, D4_3Rb, D4_3Rc, D4_3Rd, D6_3La, D6_3Lb, D6_3Lc, D6_3Ld, D6_3Ra, D6_3Rb, D6_3Rc, D6_3Rd, D16_3a, D16_3b, D16_3c, D16_3d: 1N4148W; D_SOD-123
D5_3La, D5_3Lb, D5_3Ra, D5_3Rb: BZX84C5V1; SOT-23
R18_3L, R18_3R, R19_3L, R19_3R, R20_3L, R20_3R, R21_3L, R21_3R, R22_3L, R22_3R, R23_3L, R23_3R, R24_3L, R24_3R, R25_3L, R25_3R, R257, R258: 10k
R128_3sc, R128_3wf, R133, R173, R174, R175, R176, R203, R204, R205, R206, R212, R213, R226: 100k
R169, R170, R171, R172: 20k
R207, R208, R209, R210: 2.2M
R211: 1k
R255, R256: 22k6
R259, R260: 1M
RV39: BP3_DIST; Potentiometer_Alpha_RD901F-40-00D_Single_Vertical_CircularH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
RV55: BP3_DRIVE_UNITY_L; Potentiometer_Bourns_3224W
RV56: BP3_DRIVE_UNITY_R; Potentiometer_Bourns_3224W
R_f_wf_3L, R_f_wf_3R: 10k
U33, U77, U81: CD4053; SOIC-16_3.9x9.9mm_P1.27mm
U38, U39, U44, U45: TL072; SOIC-8_3.9x4.9mm_P1.27mm
U89, U90: THAT2180; SIP-8_2.54mm
U93, U96: TL074; SOIC-14_3.9x8.7mm_P1.27mm

Connections:
+12V: C110_U33p.2, C110_U38p.2, C110_U39p.2, C110_U44p.2, C110_U45p.2, C110_U77p.2, C110_U81p.2, C110_U89p.2, C110_U90p.2, C110_U93p.2, C110_U96p.2, R133.2, R226.2, R255.2, U33.9 (C), U38.4 (V-), U39.4 (V-), U44.4 (V-), U45.4 (V-), U77.9 (C), U81.9 (C), U89.5 (V-), U90.5 (V-), U93.11 (V-), U96.11 (V-)
-12V: C110_U33n.2, C110_U38n.2, C110_U39n.2, C110_U44n.2, C110_U45n.2, C110_U77n.2, C110_U81n.2, C110_U89n.2, C110_U90n.2, C110_U93n.2, C110_U96n.2, R256.2, U33.11 (A), U38.8 (V+), U39.8 (V+), U44.8 (V+), U45.8 (V+), U77.11 (A), U81.11 (A), U89.7 (V+), U90.7 (V+), U93.4 (V+), U96.4 (V+)
ALT_L_DET: R133.1, U81.7 (VEE)
ALT_R_DET: R226.1, U81.8 (VSS)
ALT_VCA_OUT_L: U81.3 (Z1)
ALT_VCA_OUT_R: U81.1 (Y1)
BP3IN_L: R169.2, U81.5 (Z0)
BP3IN_R: R170.2, U81.2 (Y0)
BP3_CLIP_A_INP: R203.1, R207.1, U96.2 (In-)
BP3_CLIP_A_OUT: D16_3a.K, R207.2, U96.1 (Out)
BP3_CLIP_B_INN: R204.1, U96.5 (In+)
BP3_CLIP_B_INP: R208.1, R212.1, U96.6 (In-)
BP3_CLIP_B_OUT: D16_3b.K, R208.2, U96.7 (Out)
BP3_CLIP_C_INP: R205.1, R209.1, U96.9 (In-)
BP3_CLIP_C_OUT: D16_3c.K, R209.2, U96.8 (Out)
BP3_CLIP_D_INN: R206.1, U96.12 (In+)
BP3_CLIP_D_INP: R210.1, R213.1, U96.13 (In-)
BP3_CLIP_D_OUT: D16_3d.K, R210.2, U96.14 (Out)
BP3_CLIP_LEDA: BP3_CLIP_LED.K, R211.1
BP3_CLIP_OR: D16_3a.A, D16_3b.A, D16_3c.A, D16_3d.A, R211.2
BP3_DISTOUT_L: R203.2, R204.2, U33.5 (Z0)
BP3_DISTOUT_R: R205.2, R206.2, U33.2 (Y0)
BP3_DRIVEIN_L: R169.1, U89.6 (Gnd)
BP3_DRIVEIN_R: R170.1, U90.6 (Gnd)
BP3_DRIVEIV_L: R171.2, U93.3 (In+)
BP3_DRIVEIV_R: R172.2, U93.5 (In+)
BP3_DRIVEOUT_L: C_WF_3La.2, C_WF_3Lb.2, R18_3L.2, R20_3L.2, R22_3L.2, R171.1, U93.1 (Out)
BP3_DRIVEOUT_R: C_WF_3Ra.2, C_WF_3Rb.2, R18_3R.2, R20_3R.2, R22_3R.2, R172.1, U93.7 (Out)
BP3_DRIVE_KNOB: R173.2, RV39.2 (Wiper)
BP3_DRIVE_SPARE: U93.12 (In+), U93.14 (Out)
BP3_DRIVE_SUM: R173.1, R174.1, R175.1, R176.2, U93.10 (In+)
BP3_HCOUT_L: D5_3La.1 (A), R21_3L.1, U38.7 (Out), U77.4 (Z)
BP3_HCOUT_R: D5_3Ra.1 (A), R21_3R.1, U39.7 (Out), U77.15 (Y)
BP3_HCVG_L: R20_3L.1, R21_3L.2, U38.5 (In+)
BP3_HCVG_R: R20_3R.1, R21_3R.2, U39.5 (In+)
BP3_HCZMID_L: D5_3La.3 (K), D5_3Lb.3 (K)
BP3_HCZMID_R: D5_3Ra.3 (K), D5_3Rb.3 (K)
BP3_MID_L: U33.4 (Z), U77.5 (Z0)
BP3_MID_R: U33.15 (Y), U77.2 (Y0)
BP3_SCM1_L: D4_3La.A, D4_3Lb.K
BP3_SCM1_R: D4_3Ra.A, D4_3Rb.K
BP3_SCM2_L: D4_3Lc.A, D4_3Ld.K
BP3_SCM2_R: D4_3Rc.A, D4_3Rd.K
BP3_SCOUT_L: D4_3La.K, D4_3Ld.A, R19_3L.1, U33.3 (Z1), U38.1 (Out)
BP3_SCOUT_R: D4_3Ra.K, D4_3Rd.A, R19_3R.1, U33.1 (Y1), U39.1 (Out)
BP3_SCVG_L: D4_3Lb.A, D4_3Lc.K, R18_3L.1, R19_3L.2, U38.3 (In+)
BP3_SCVG_R: D4_3Rb.A, D4_3Rc.K, R18_3R.1, R19_3R.2, U39.3 (In+)
BP3_SEL_SC: R128_3sc.1, U33.7 (VEE), U33.8 (VSS)
BP3_SEL_WF: R128_3wf.1, U77.7 (VEE), U77.8 (VSS)
BP3_VFOLDIN_L: R23_3L.1, R24_3L.2, R25_3L.2, U44.1 (Out)
BP3_VFOLDIN_R: R23_3R.1, R24_3R.2, R25_3R.2, U45.1 (Out)
BP3_WFCLAMP_L: D6_3La.K, D6_3Ld.A, R24_3L.1, U44.6 (In-)
BP3_WFCLAMP_R: D6_3Ra.K, D6_3Rd.A, R24_3R.1, U45.6 (In-)
BP3_WFCM1_L: D6_3La.A, D6_3Lb.K
BP3_WFCM1_R: D6_3Ra.A, D6_3Rb.K
BP3_WFCM2_L: D6_3Lc.A, D6_3Ld.K
BP3_WFCM2_R: D6_3Rc.A, D6_3Rd.K
BP3_WFFVG_L: R25_3L.1, R_f_wf_3L.2, U44.5 (In+)
BP3_WFFVG_R: R25_3R.1, R_f_wf_3R.2, U45.5 (In+)
BP3_WFOUT_L: R_f_wf_3L.1, U44.7 (Out), U77.3 (Z1)
BP3_WFOUT_R: R_f_wf_3R.1, U45.7 (Out), U77.1 (Y1)
BP3_WFVG_L: R22_3L.1, R23_3L.2, U44.3 (In+)
BP3_WFVG_R: R22_3R.1, R23_3R.2, U45.3 (In+)
EC_BP3_DRIVE_L: R257.1, R259.1, U89.4 (Sym)
EC_BP3_DRIVE_R: R258.1, R260.1, U90.4 (Sym)
GND: BP3_CLIP_LED.A, C110_U33n.1, C110_U33p.1, C110_U38n.1, C110_U38p.1, C110_U39n.1, C110_U39p.1, C110_U44n.1, C110_U44p.1, C110_U45n.1, C110_U45p.1, C110_U77n.1, C110_U77p.1, C110_U81n.1, C110_U81p.1, C110_U89n.1, C110_U89p.1, C110_U90n.1, C110_U90p.1, C110_U93n.1, C110_U93p.1, C110_U96n.1, C110_U96p.1, C_WF_3La.1, C_WF_3Lb.1, C_WF_3Ra.1, C_WF_3Rb.1, D5_3Lb.1 (A), D5_3Rb.1 (A), D6_3Lb.A, D6_3Lc.K, D6_3Rb.A, D6_3Rc.K, RV39.3, U33.6 (INH), U33.10 (B), U38.2 (In-), U38.6 (In-), U39.2 (In-), U39.6 (In-), U44.2 (In-), U45.2 (In-), U77.6 (INH), U77.10 (B), U81.6 (INH), U81.10 (B), U81.12 (X0), U81.13 (X1), U81.14 (X), U81.16 (VDD), U89.1 (Input), U89.2 (Ec+), U89.3 (Ec-), U90.1 (Input), U90.2 (Ec+), U90.3 (Ec-), U93.2 (In-), U93.6 (In-), U93.9 (In-), U93.13 (In-)
LP1_OUT_L: U81.4 (Z)
LP1_OUT_R: U81.15 (Y)
MOD_BP3_DIST: R174.2
REF_N3: R256.1, RV55.1, RV56.1
REF_P3: R255.1, RV55.3, RV56.3
TRIMW_BP3_L: R259.2, RV55.2 (Wiper)
TRIMW_BP3_R: R260.2, RV56.2 (Wiper)
V5LOGIC: R128_3sc.2, R128_3wf.2, R175.2, RV39.1
VREF_N4: R212.2, R213.2
VREF_P4: U96.3 (In+), U96.10 (In+)
V_DRIVE_CTRL_3: R176.1, R257.2, R258.2, U93.8 (Out)
