jeffmhopkins/POGO/kicad/pogo-block-6-mix.kicad_sch

## KiCad design kicad/pogo-block-6-mix.kicad_sch (2026-05-31)

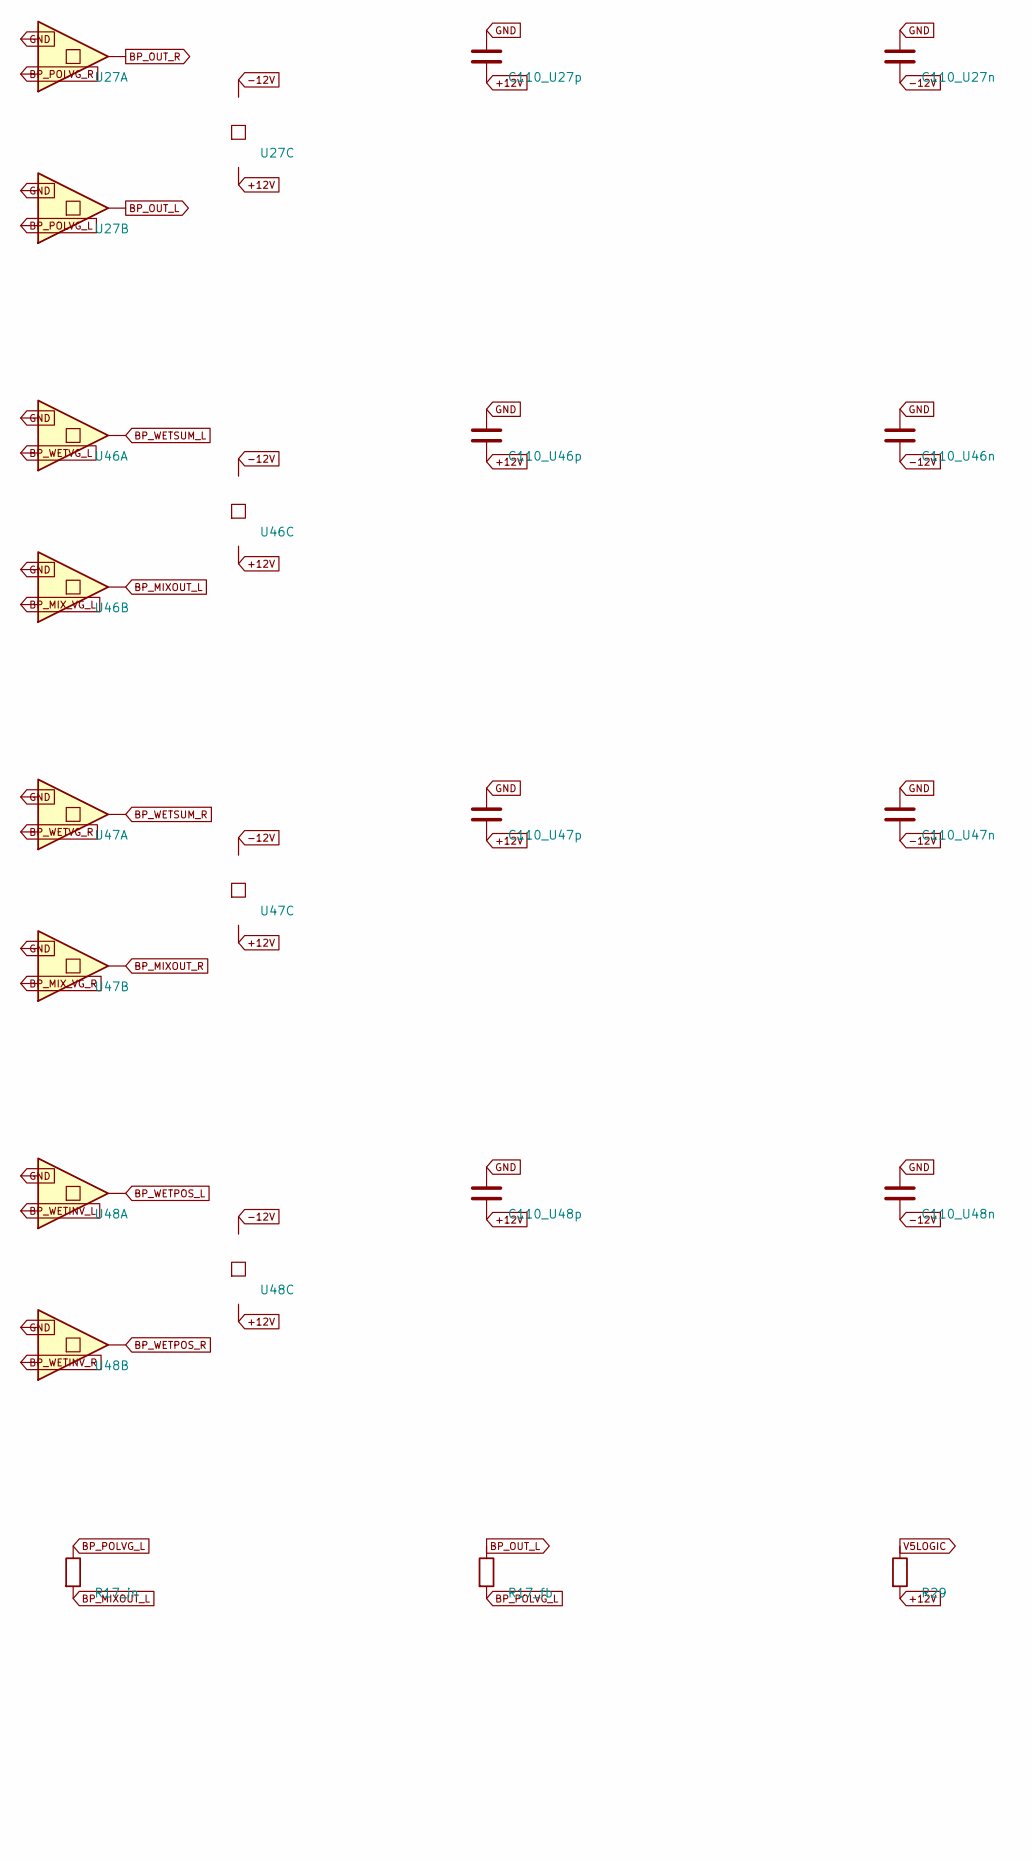
[picture p14: schematic pogo-block-6-mix.kicad_sch, part in row 1, column 1]

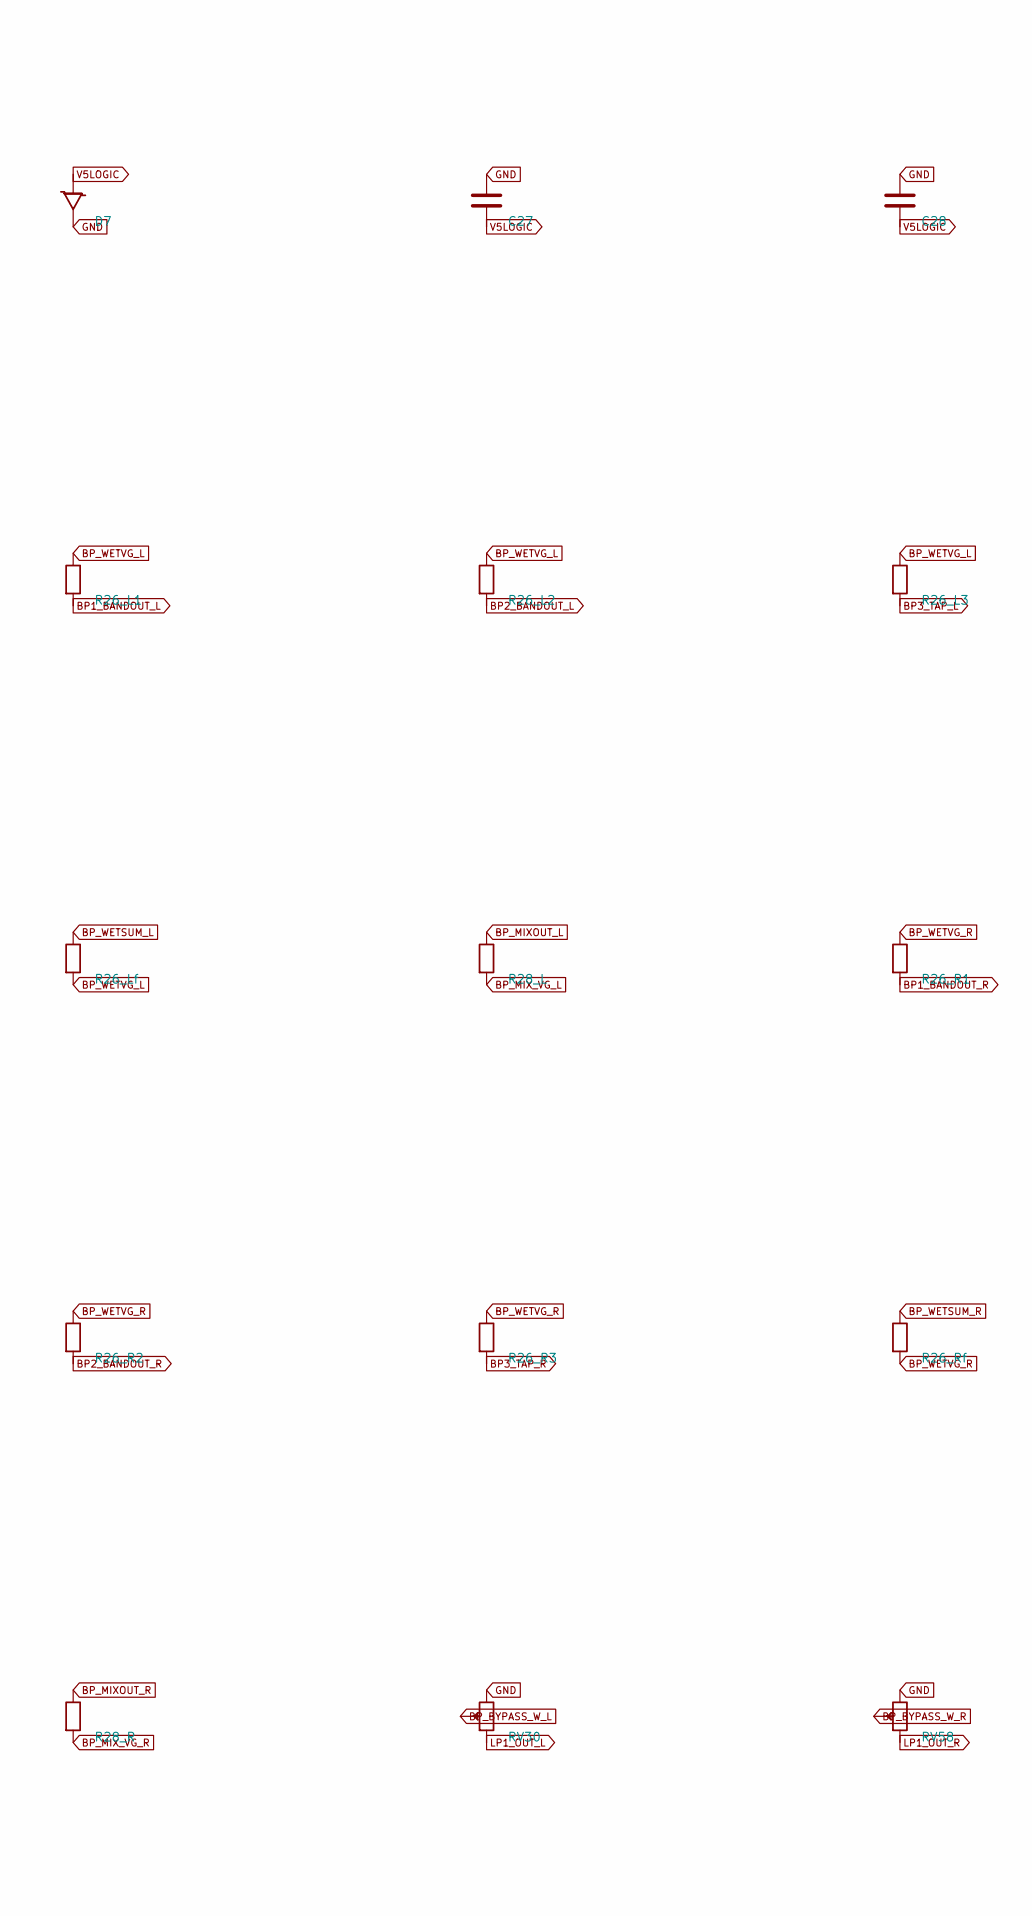
[picture p15: schematic pogo-block-6-mix.kicad_sch, part in row 2, column 1]

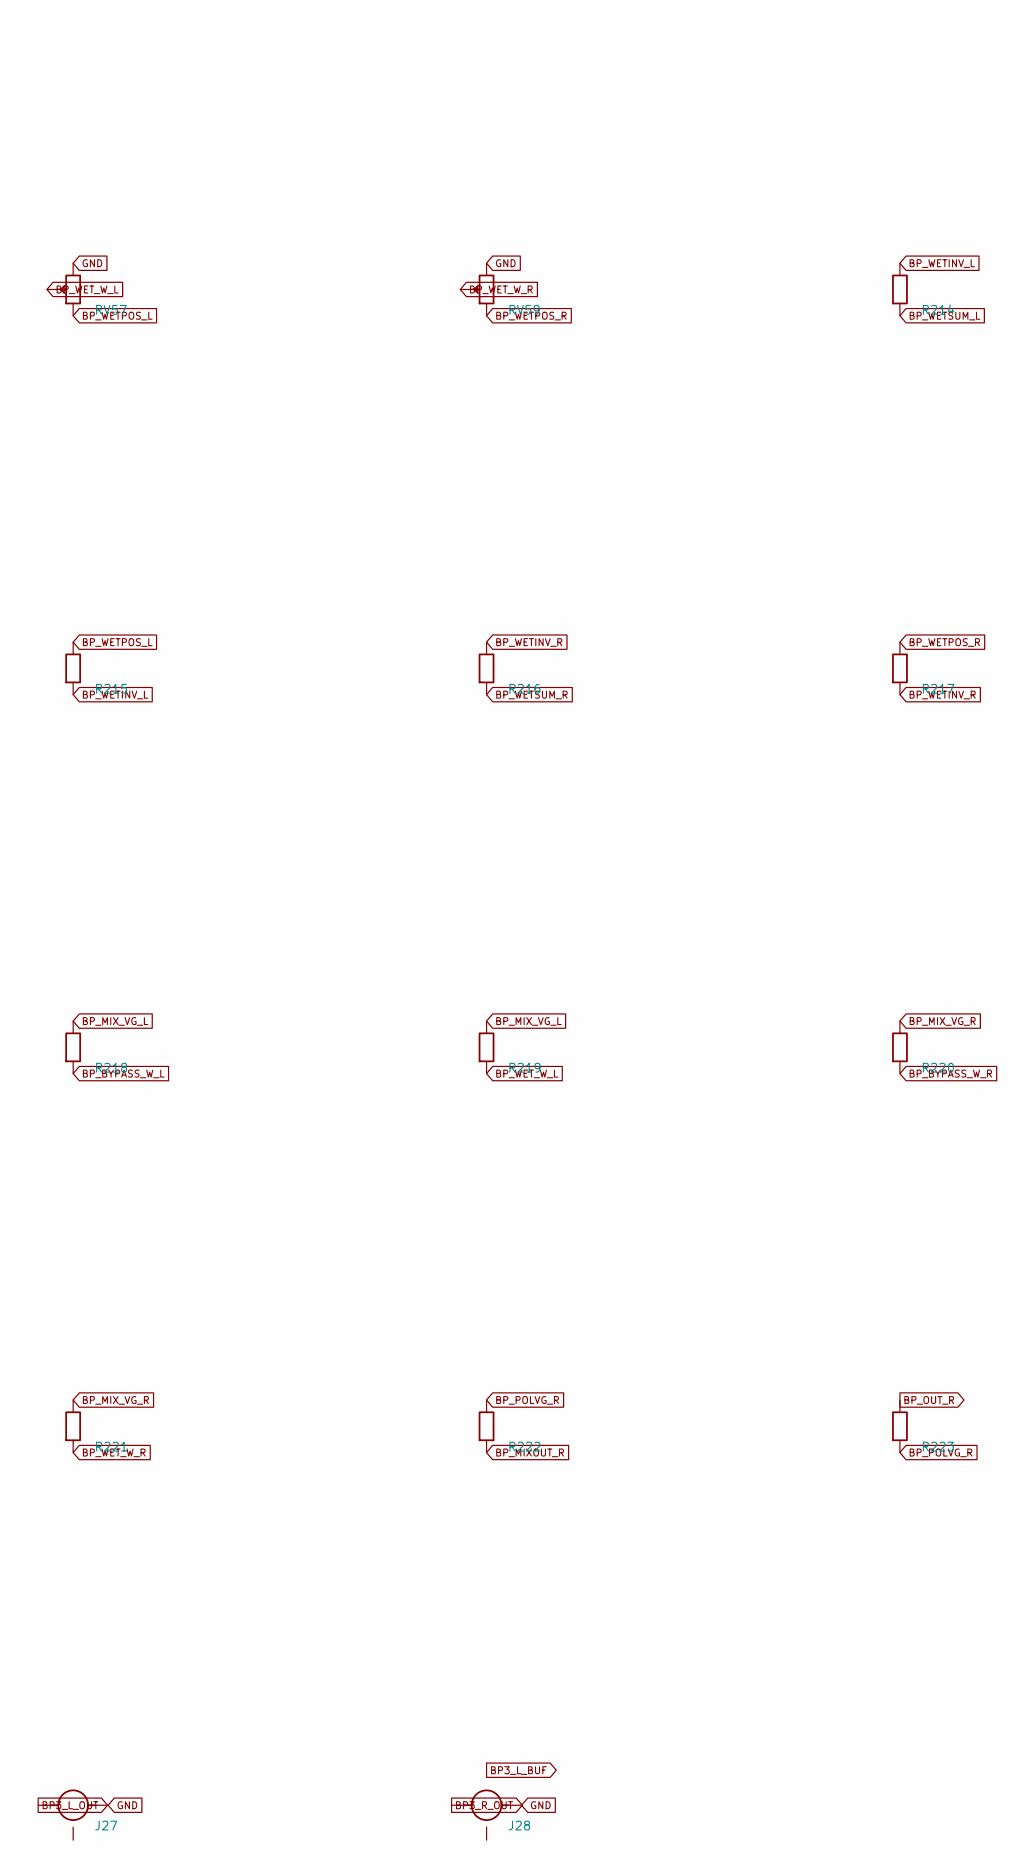
[picture p16: schematic pogo-block-6-mix.kicad_sch, part in row 3, column 1]

Parts:
C27: 10uF
C28, C110_U27n, C110_U27p, C110_U46n, C110_U46p, C110_U47n, C110_U47p, C110_U48n, C110_U48p: 100nF
D7: BZX84C5V1; SOT-23
J27: BP3_L_OUT; Jack_3.5mm_QingPu_WQP-PJ398SM_Vertical_CircularHoles
J28: BP3_R_OUT; Jack_3.5mm_QingPu_WQP-PJ398SM_Vertical_CircularHoles
R17_fb, R17_in, R28_L, R28_R, R214, R215, R216, R217, R218, R219, R220, R221, R222, R223: 100k
R26_L1, R26_L2, R26_L3, R26_Lf, R26_R1, R26_R2, R26_R3, R26_Rf: 33k
R29: 1k
RV30: BP_BYPASS_L; Potentiometer_Alpha_RD901F-40-00D_Single_Vertical_CircularH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
RV57: BP_WET_L; Potentiometer_Alpha_RD901F-40-00D_Single_Vertical_CircularH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
RV58: BP_BYPASS_R; Potentiometer_Alpha_RD901F-40-00D_Single_Vertical_CircularH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
RV59: BP_WET_R; Potentiometer_Alpha_RD901F-40-00D_Single_Vertical_CircularH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
U27, U46, U47, U48: TL072; SOIC-8_3.9x4.9mm_P1.27mm

Connections:
+12V: C110_U27p.2, C110_U46p.2, C110_U47p.2, C110_U48p.2, R29.2, U27.4 (V-), U46.4 (V-), U47.4 (V-), U48.4 (V-)
-12V: C110_U27n.2, C110_U46n.2, C110_U47n.2, C110_U48n.2, U27.8 (V+), U46.8 (V+), U47.8 (V+), U48.8 (V+)
BP1_BANDOUT_L: R26_L1.2
BP1_BANDOUT_R: R26_R1.2
BP2_BANDOUT_L: R26_L2.2
BP2_BANDOUT_R: R26_R2.2
BP3_L_OUT: J27.1 (T)
BP3_R_OUT: J28.1 (T)
BP3_TAP_L: R26_L3.2
BP3_TAP_R: R26_R3.2
BP_BYPASS_W_L: R218.2, RV30.2 (Wiper)
BP_BYPASS_W_R: R220.2, RV58.2 (Wiper)
BP_MIXOUT_L: R17_in.2, R28_L.1, U46.7 (Out)
BP_MIXOUT_R: R28_R.1, R222.2, U47.7 (Out)
BP_MIX_VG_L: R28_L.2, R218.1, R219.1, U46.5 (In+)
BP_MIX_VG_R: R28_R.2, R220.1, R221.1, U47.5 (In+)
BP_OUT_L: R17_fb.1, U27.7 (Out)
BP_OUT_R: R223.1, U27.1 (Out)
BP_POLVG_L: R17_fb.2, R17_in.1, U27.5 (In+)
BP_POLVG_R: R222.1, R223.2, U27.3 (In+)
BP_WETINV_L: R214.1, R215.2, U48.3 (In+)
BP_WETINV_R: R216.1, R217.2, U48.5 (In+)
BP_WETPOS_L: R215.1, RV57.1, U48.1 (Out)
BP_WETPOS_R: R217.1, RV59.1, U48.7 (Out)
BP_WETSUM_L: R26_Lf.1, R214.2, U46.1 (Out)
BP_WETSUM_R: R26_Rf.1, R216.2, U47.1 (Out)
BP_WETVG_L: R26_L1.1, R26_L2.1, R26_L3.1, R26_Lf.2, U46.3 (In+)
BP_WETVG_R: R26_R1.1, R26_R2.1, R26_R3.1, R26_Rf.2, U47.3 (In+)
BP_WET_W_L: R219.2, RV57.2 (Wiper)
BP_WET_W_R: R221.2, RV59.2 (Wiper)
GND: C27.1, C28.1, C110_U27n.1, C110_U27p.1, C110_U46n.1, C110_U46p.1, C110_U47n.1, C110_U47p.1, C110_U48n.1, C110_U48p.1, D7.3 (K), J27.2 (S), J28.2 (S), RV30.3, RV57.3, RV58.3, RV59.3, U27.2 (In-), U27.6 (In-), U46.2 (In-), U46.6 (In-), U47.2 (In-), U47.6 (In-), U48.2 (In-), U48.6 (In-)
LP1_OUT_L: RV30.1
LP1_OUT_R: RV58.1
V5LOGIC: C27.2, C28.2, D7.1 (A), R29.1
