jeffmhopkins/POGO/kicad/pogo-block-6-svf1.kicad_sch

## KiCad design kicad/pogo-block-6-svf1.kicad_sch (2026-05-31)

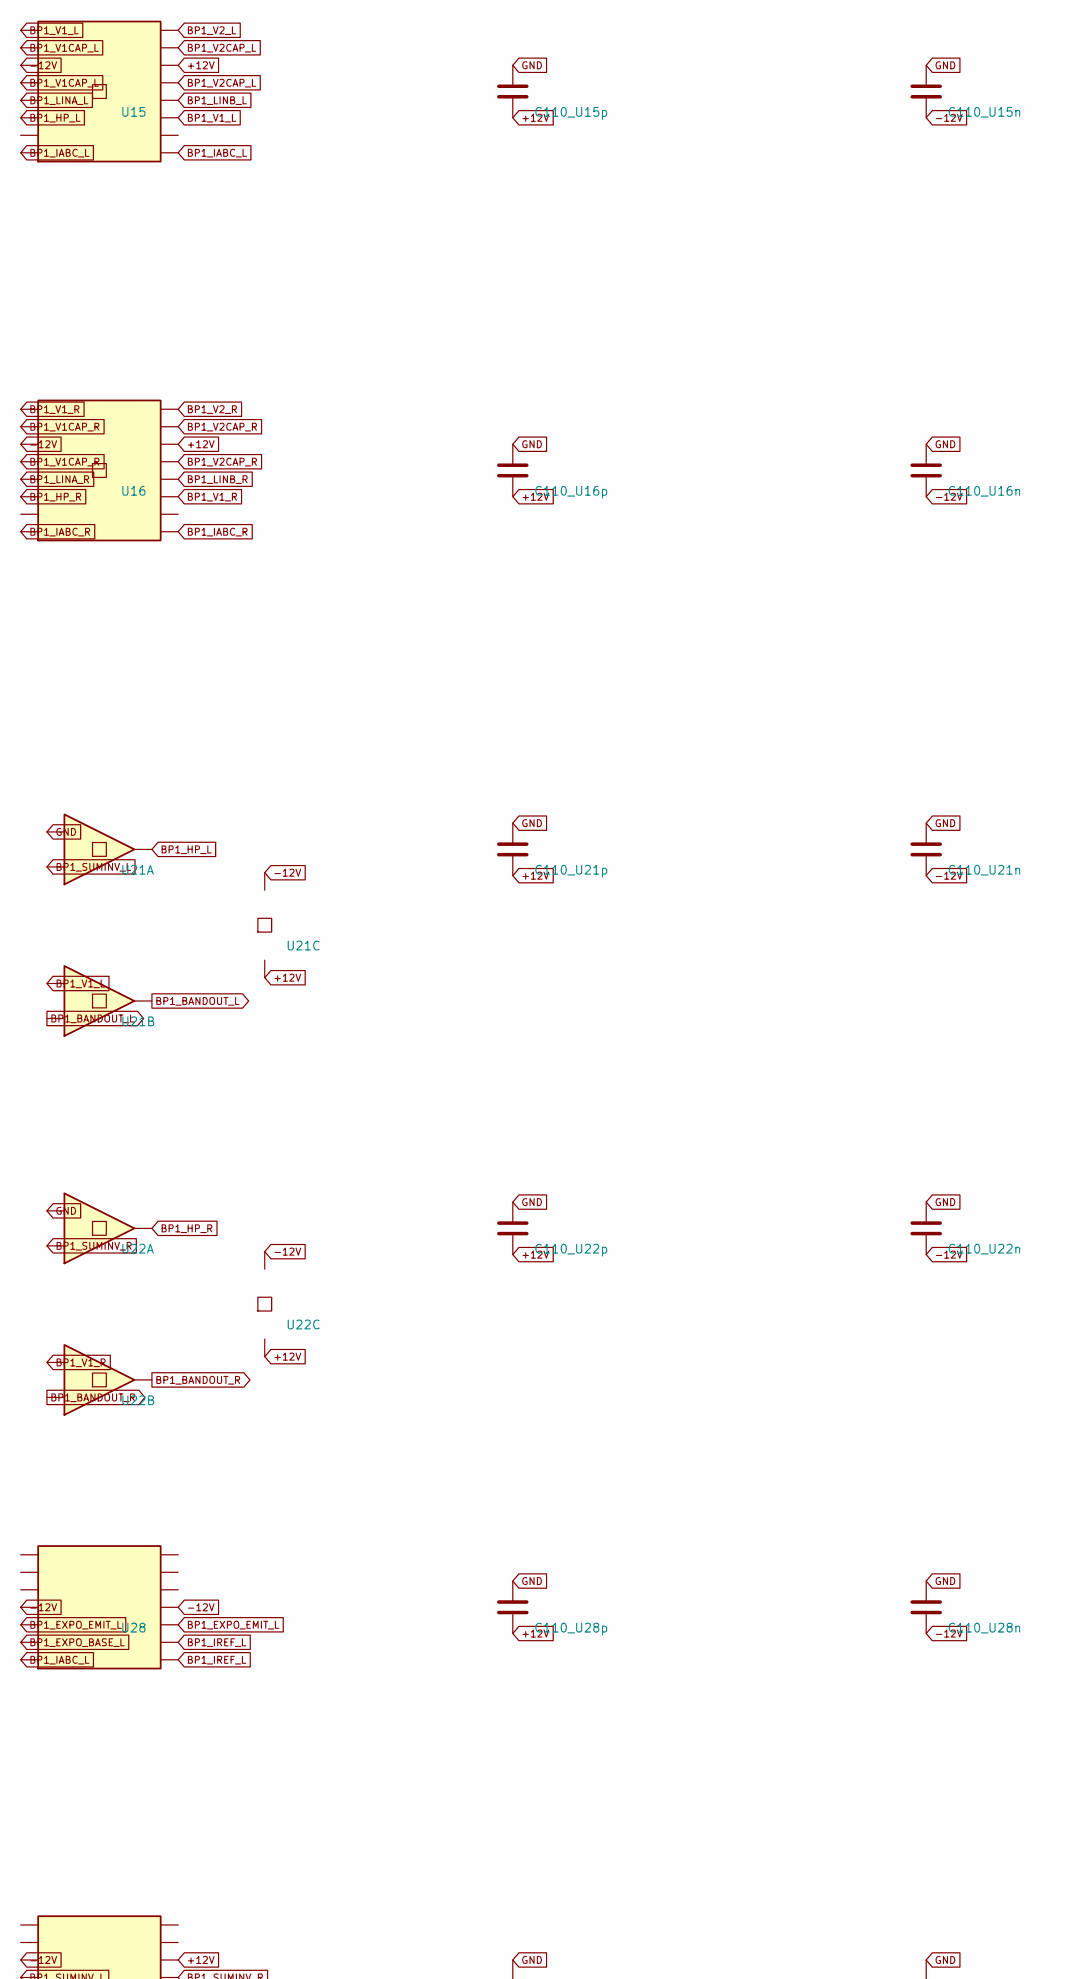
[picture p17: schematic pogo-block-6-svf1.kicad_sch, part in row 1, column 1]

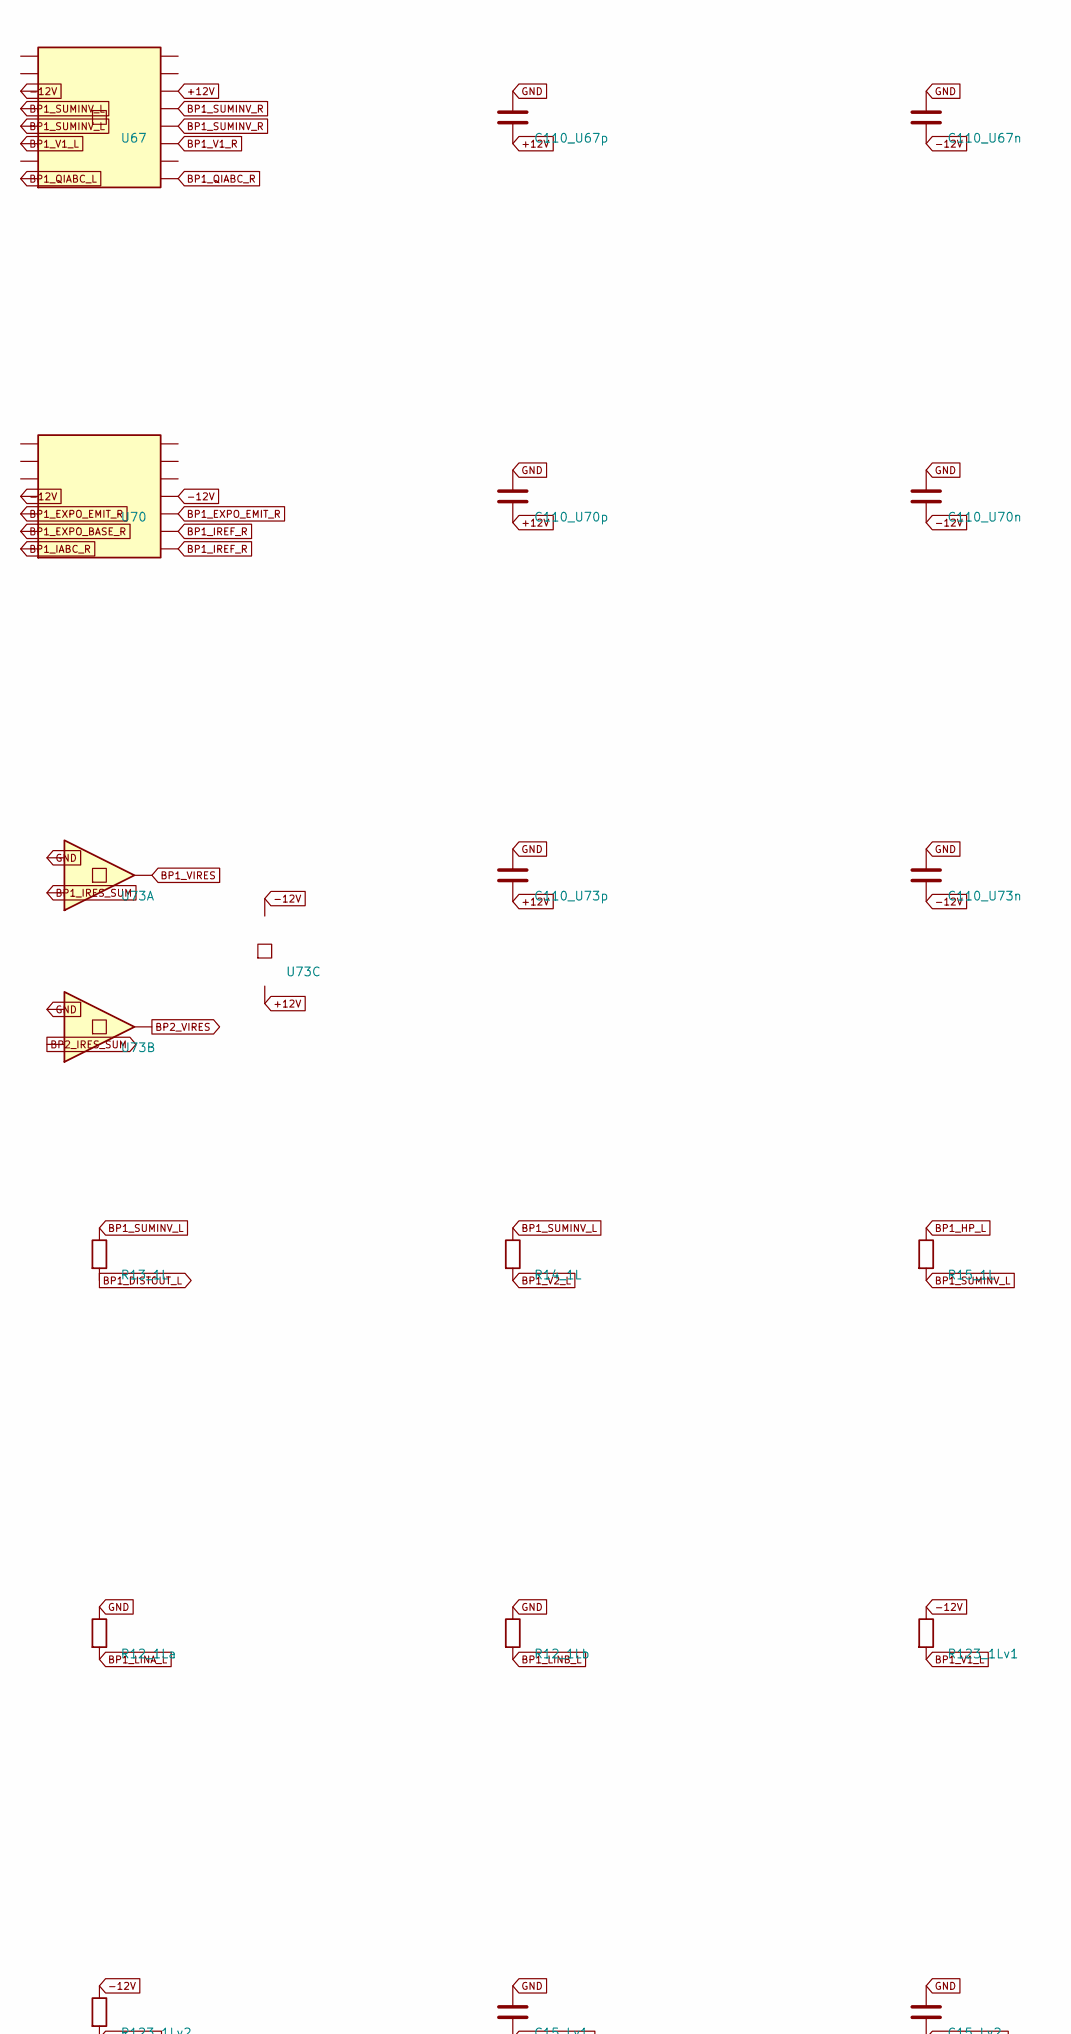
[picture p18: schematic pogo-block-6-svf1.kicad_sch, part in row 2, column 1]

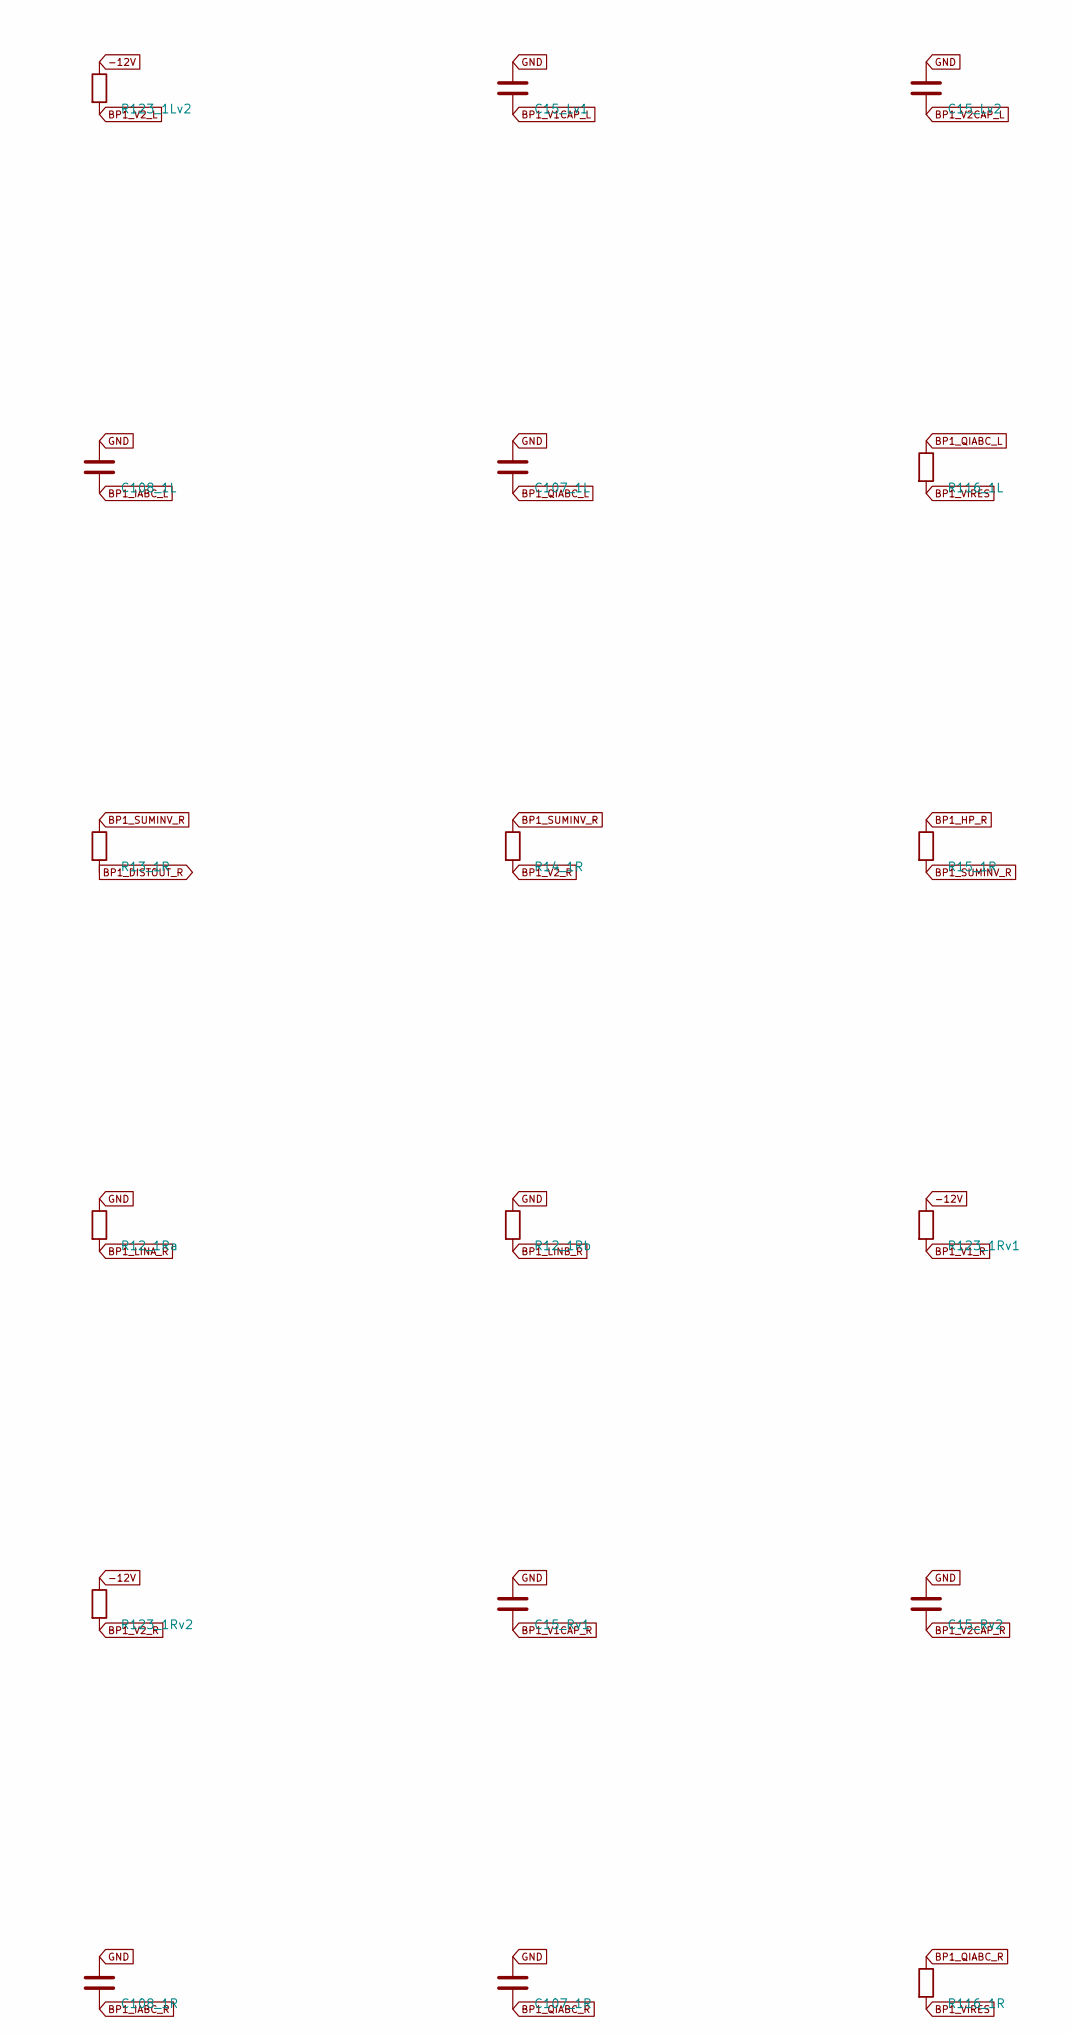
[picture p19: schematic pogo-block-6-svf1.kicad_sch, part in row 3, column 1]

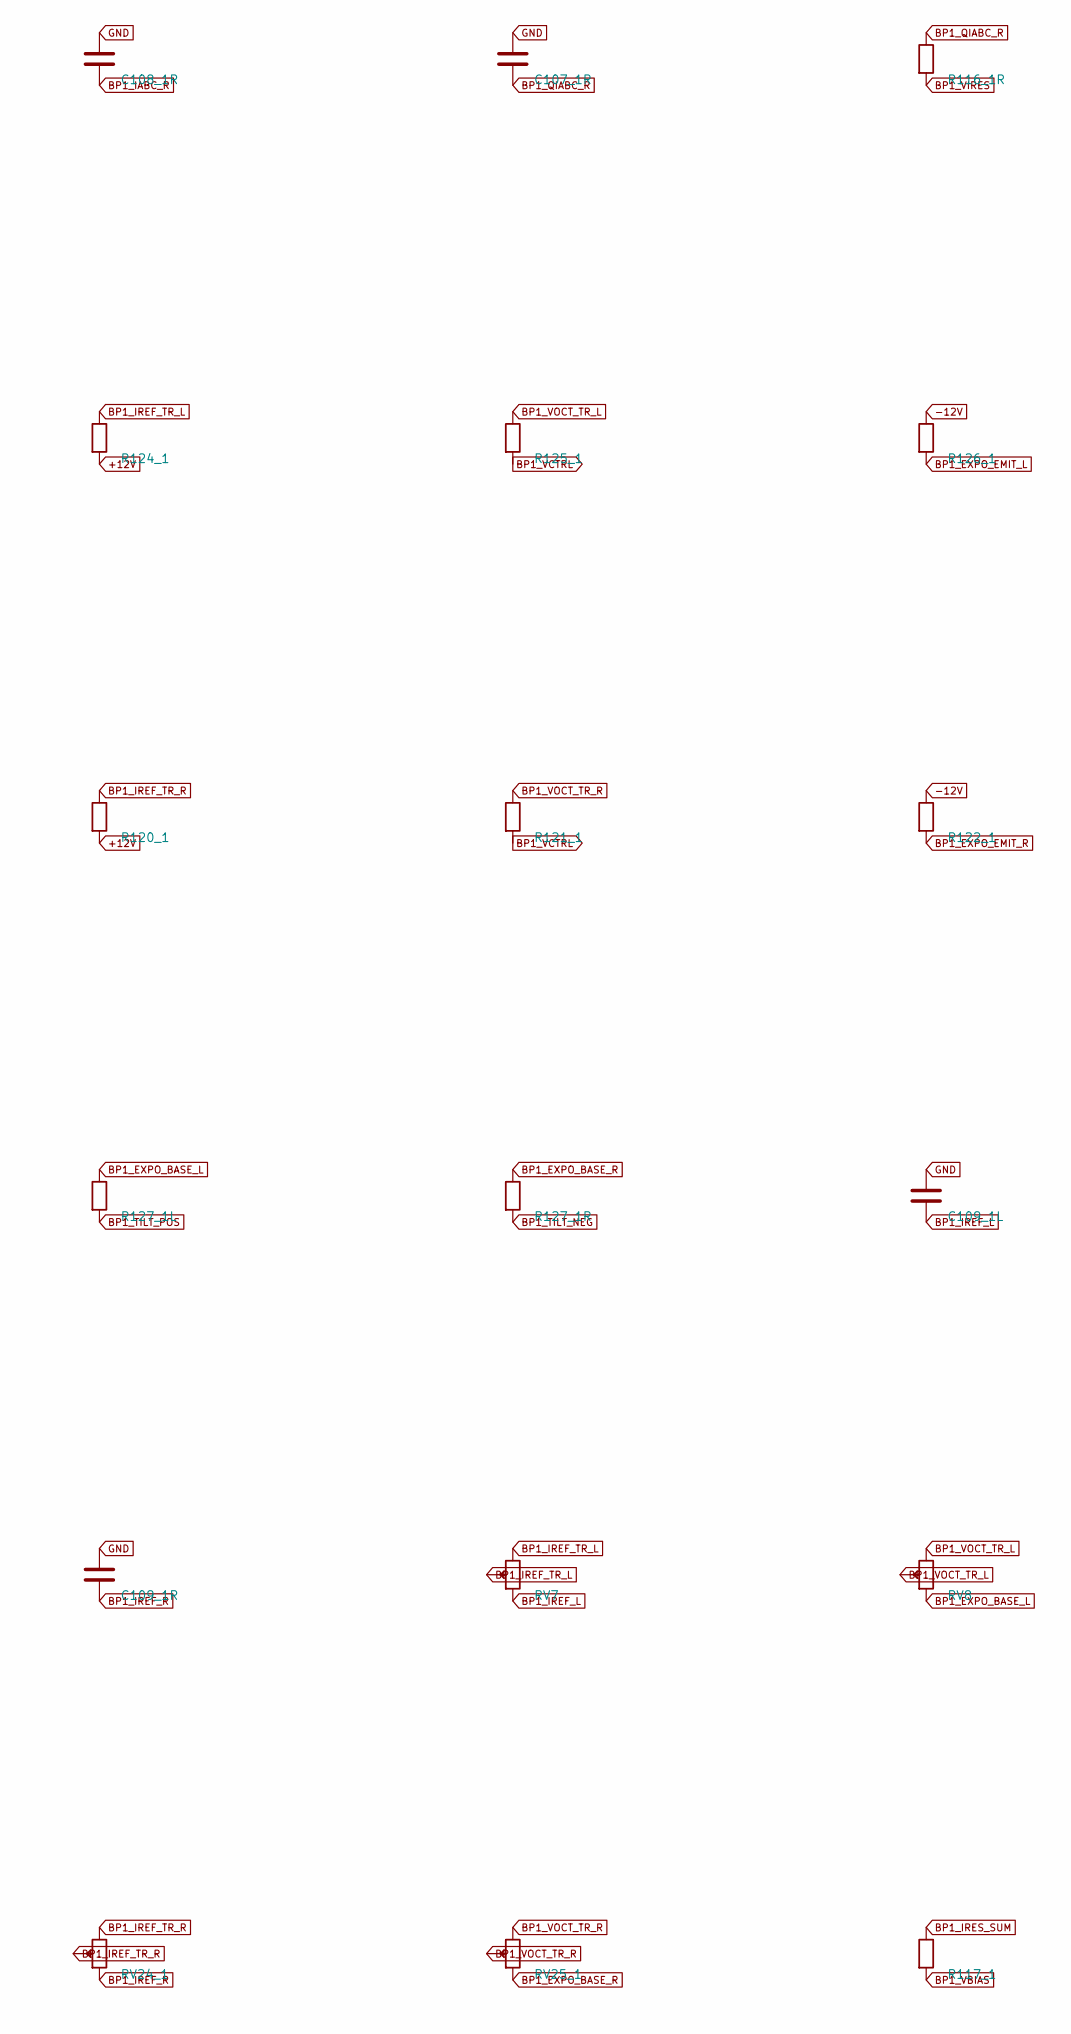
[picture p20: schematic pogo-block-6-svf1.kicad_sch, part in row 4, column 1]

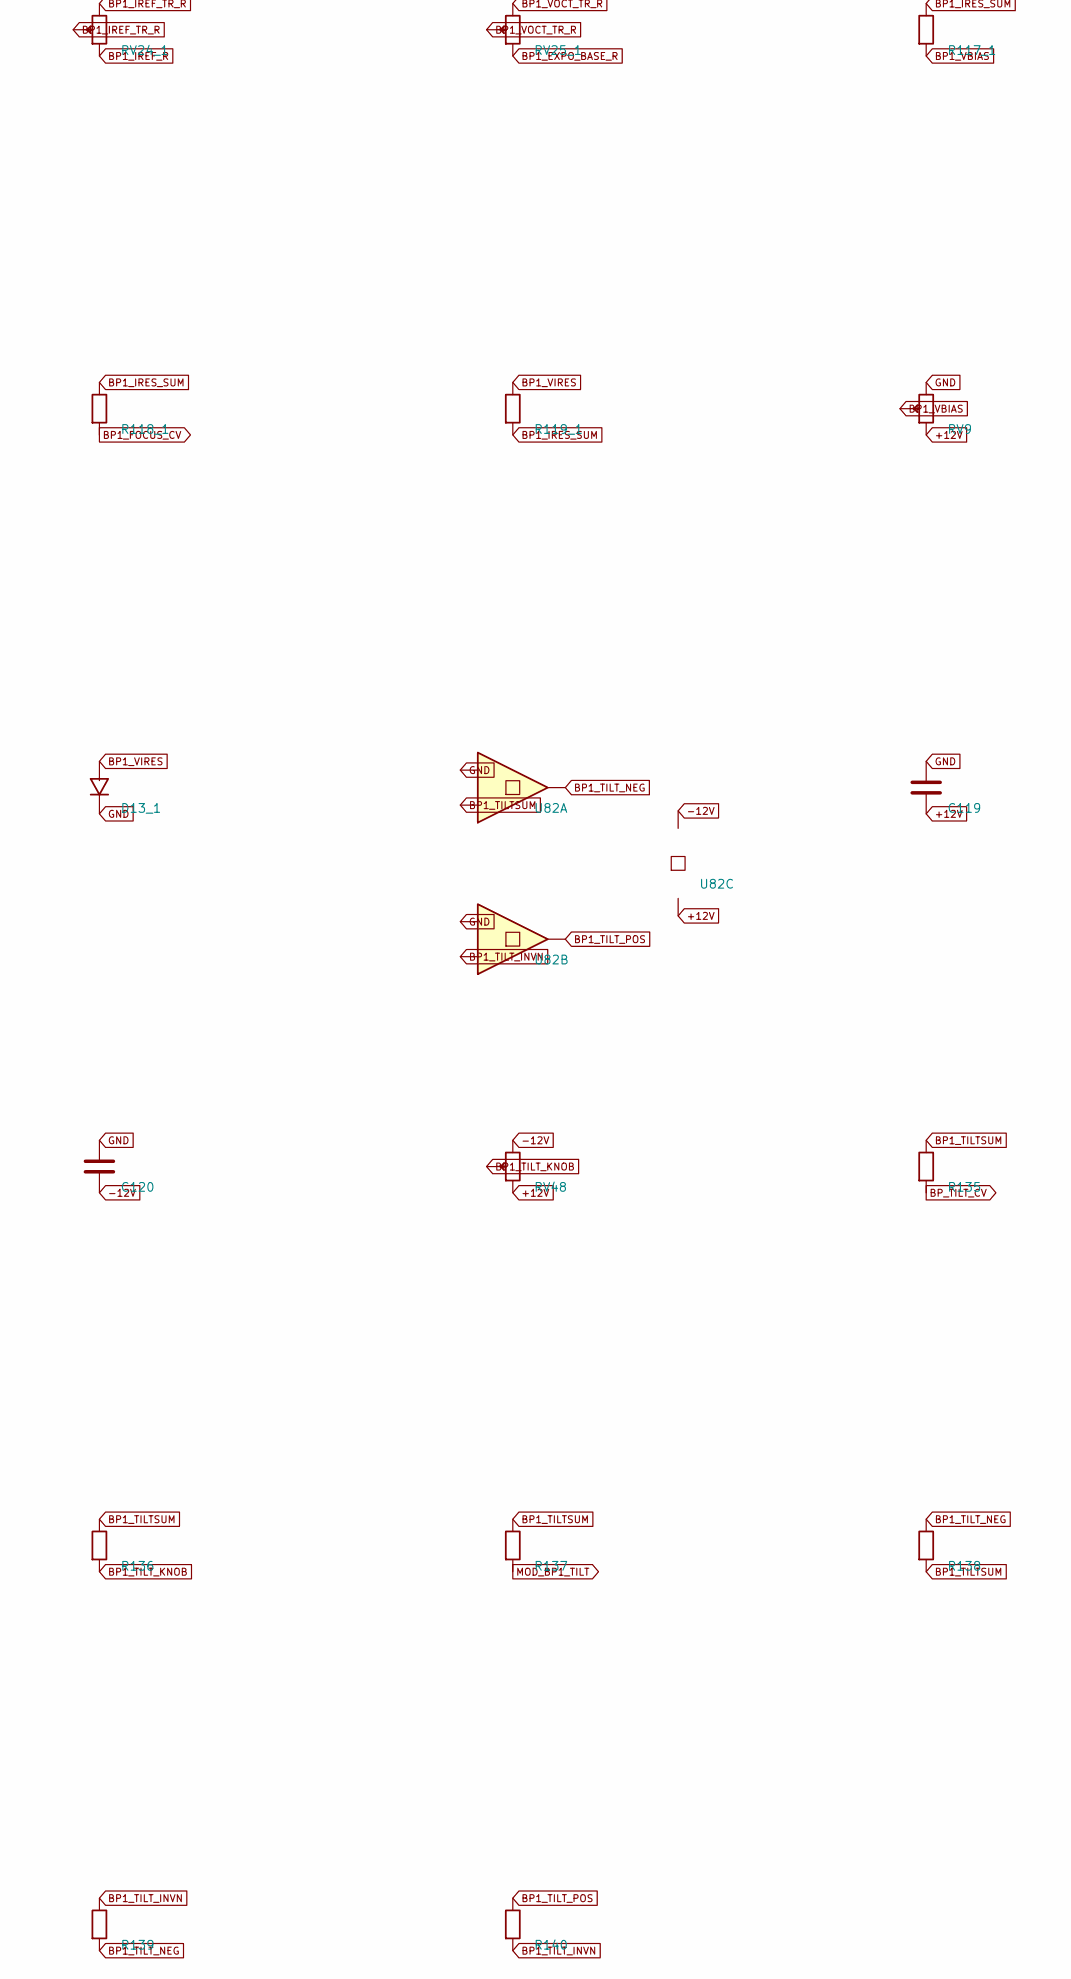
[picture p21: schematic pogo-block-6-svf1.kicad_sch, part in row 5, column 1]

Parts:
C15_Lv1, C15_Lv2, C15_Rv1, C15_Rv2: 68nF
C107_1L, C107_1R, C108_1L, C108_1R: 10nF
C109_1L, C109_1R, C110_U15n, C110_U15p, C110_U16n, C110_U16p, C110_U21n, C110_U21p, C110_U22n, C110_U22p, C110_U28n, C110_U28p, C110_U67n, C110_U67p, C110_U70n, C110_U70p, C110_U73n, C110_U73p, C119, C120: 100nF
D13_1: 1N4148W; D_SOD-123
R12_1La, R12_1Lb, R12_1Ra, R12_1Rb, R122_1, R126_1: 1k
R13_1L, R13_1R, R14_1L, R14_1R, R15_1L, R15_1R, R117_1, R118_1, R119_1, R127_1L, R127_1R, R135, R136, R138, R139, R140: 100k
R116_1L, R116_1R, R120_1, R124_1: 1M
R121_1, R125_1: 47k
R123_1Lv1, R123_1Lv2, R123_1Rv1, R123_1Rv2: 10k
R137: 470k
RV7: BP1_FREF_L; Potentiometer_Bourns_3224W
RV8: BP1_1VOCT_L; Potentiometer_Bourns_3224W
RV9: BP1_QMAX; Potentiometer_Bourns_3224W
RV24_1: BP1_FREF_R; Potentiometer_Bourns_3224W
RV25_1: BP1_1VOCT_R; Potentiometer_Bourns_3224W
RV48: BP1_TILT; Potentiometer_Songhuei_9mm_TallTrimmer_Vertical
U15, U16, U67: LM13700; SOIC-16_3.9x9.9mm_P1.27mm
U21, U22: OPA1612; SOIC-8_3.9x4.9mm_P1.27mm
U28, U70: THAT340; SOIC-14_3.9x8.7mm_P1.27mm
U73, U82: TL072; SOIC-8_3.9x4.9mm_P1.27mm

Connections:
+12V: C110_U15p.2, C110_U16p.2, C110_U21p.2, C110_U22p.2, C110_U28p.2, C110_U67p.2, C110_U70p.2, C110_U73p.2, C119.2, R120_1.2, R124_1.2, RV9.1, RV48.1, U15.14 (In+_B), U16.14 (In+_B), U21.4 (V-), U22.4 (V-), U67.14 (In+_B), U73.4 (V-), U82.4 (V-)
-12V: C110_U15n.2, C110_U16n.2, C110_U21n.2, C110_U22n.2, C110_U28n.2, C110_U67n.2, C110_U70n.2, C110_U73n.2, C120.2, R122_1.1, R123_1Lv1.1, R123_1Lv2.1, R123_1Rv1.1, R123_1Rv2.1, R126_1.1, RV48.3, U15.3 (In+_A), U16.3 (In+_A), U21.8 (V+), U22.8 (V+), U28.4 (SUB), U28.11 (SUB), U67.3 (In+_A), U70.4 (SUB), U70.11 (SUB), U73.8 (V+), U82.8 (V+)
BP1_BANDOUT_L: U21.5 (In+), U21.7 (Out)
BP1_BANDOUT_R: U22.5 (In+), U22.7 (Out)
BP1_DISTOUT_L: R13_1L.2
BP1_DISTOUT_R: R13_1R.2
BP1_EXPO_BASE_L: R127_1L.1, RV8.1, U28.6 (Q3_B)
BP1_EXPO_BASE_R: R127_1R.1, RV25_1.1, U70.6 (Q3_B)
BP1_EXPO_EMIT_L: R126_1.2, U28.5 (Q3_E), U28.10 (Q4_E)
BP1_EXPO_EMIT_R: R122_1.2, U70.5 (Q3_E), U70.10 (Q4_E)
BP1_FOCUS_CV: R118_1.2
BP1_HP_L: R15_1L.1, U15.6 (V-), U21.1 (Out)
BP1_HP_R: R15_1R.1, U16.6 (V-), U22.1 (Out)
BP1_IABC_L: C108_1L.2, U15.8 (BufOut_A), U15.9 (BufOut_B), U28.7 (Q3_C)
BP1_IABC_R: C108_1R.2, U16.8 (BufOut_A), U16.9 (BufOut_B), U70.7 (Q3_C)
BP1_IREF_L: C109_1L.2, RV7.1, U28.8 (Q4_C), U28.9 (Q4_B)
BP1_IREF_R: C109_1R.2, RV24_1.1, U70.8 (Q4_C), U70.9 (Q4_B)
BP1_IREF_TR_L: R124_1.1, RV7.2 (Wiper), RV7.3
BP1_IREF_TR_R: R120_1.1, RV24_1.2 (Wiper), RV24_1.3
BP1_IRES_SUM: R117_1.1, R118_1.1, R119_1.2, U73.3 (In+)
BP1_LINA_L: R12_1La.2, U15.5 (Out_A)
BP1_LINA_R: R12_1Ra.2, U16.5 (Out_A)
BP1_LINB_L: R12_1Lb.2, U15.12 (Out_B)
BP1_LINB_R: R12_1Rb.2, U16.12 (Out_B)
BP1_QIABC_L: C107_1L.2, R116_1L.1, U67.8 (BufOut_A)
BP1_QIABC_R: C107_1R.2, R116_1R.1, U67.9 (BufOut_B)
BP1_SUMINV_L: R13_1L.1, R14_1L.1, R15_1L.2, U21.3 (In+), U67.4 (In-_A), U67.5 (Out_A)
BP1_SUMINV_R: R13_1R.1, R14_1R.1, R15_1R.2, U22.3 (In+), U67.12 (Out_B), U67.13 (In-_B)
BP1_TILTSUM: R135.1, R136.1, R137.1, R138.2, U82.3 (In+)
BP1_TILT_INVN: R139.1, R140.2, U82.5 (In+)
BP1_TILT_KNOB: R136.2, RV48.2 (Wiper)
BP1_TILT_NEG: R127_1R.2, R138.1, R139.2, U82.1 (Out)
BP1_TILT_POS: R127_1L.2, R140.1, U82.7 (Out)
BP1_V1CAP_L: C15_Lv1.2, U15.2 (DiodeBias_A), U15.4 (In-_A)
BP1_V1CAP_R: C15_Rv1.2, U16.2 (DiodeBias_A), U16.4 (In-_A)
BP1_V1_L: R123_1Lv1.2, U15.1 (Iabc_A), U15.11 (V+), U21.6 (In-), U67.6 (V-)
BP1_V1_R: R123_1Rv1.2, U16.1 (Iabc_A), U16.11 (V+), U22.6 (In-), U67.11 (V+)
BP1_V2CAP_L: C15_Lv2.2, U15.13 (In-_B), U15.15 (DiodeBias_B)
BP1_V2CAP_R: C15_Rv2.2, U16.13 (In-_B), U16.15 (DiodeBias_B)
BP1_V2_L: R14_1L.2, R123_1Lv2.2, U15.16 (Iabc_B)
BP1_V2_R: R14_1R.2, R123_1Rv2.2, U16.16 (Iabc_B)
BP1_VBIAS: R117_1.2, RV9.2 (Wiper)
BP1_VCTRL: R121_1.2, R125_1.2
BP1_VIRES: D13_1.A, R116_1L.2, R116_1R.2, R119_1.1, U73.1 (Out)
BP1_VOCT_TR_L: R125_1.1, RV8.2 (Wiper), RV8.3
BP1_VOCT_TR_R: R121_1.1, RV25_1.2 (Wiper), RV25_1.3
BP2_IRES_SUM: U73.5 (In+)
BP2_VIRES: U73.7 (Out)
BP_TILT_CV: R135.2
GND: C15_Lv1.1, C15_Lv2.1, C15_Rv1.1, C15_Rv2.1, C107_1L.1, C107_1R.1, C108_1L.1, C108_1R.1, C109_1L.1, C109_1R.1, C110_U15n.1, C110_U15p.1, C110_U16n.1, C110_U16p.1, C110_U21n.1, C110_U21p.1, C110_U22n.1, C110_U22p.1, C110_U28n.1, C110_U28p.1, C110_U67n.1, C110_U67p.1, C110_U70n.1, C110_U70p.1, C110_U73n.1, C110_U73p.1, C119.1, C120.1, D13_1.K, R12_1La.1, R12_1Lb.1, R12_1Ra.1, R12_1Rb.1, RV9.3, U21.2 (In-), U22.2 (In-), U73.2 (In-), U73.6 (In-), U82.2 (In-), U82.6 (In-)
MOD_BP1_TILT: R137.2
