jeffmhopkins/POGO/kicad/pogo-block-6-svf2.kicad_sch

## KiCad design kicad/pogo-block-6-svf2.kicad_sch (2026-05-31)

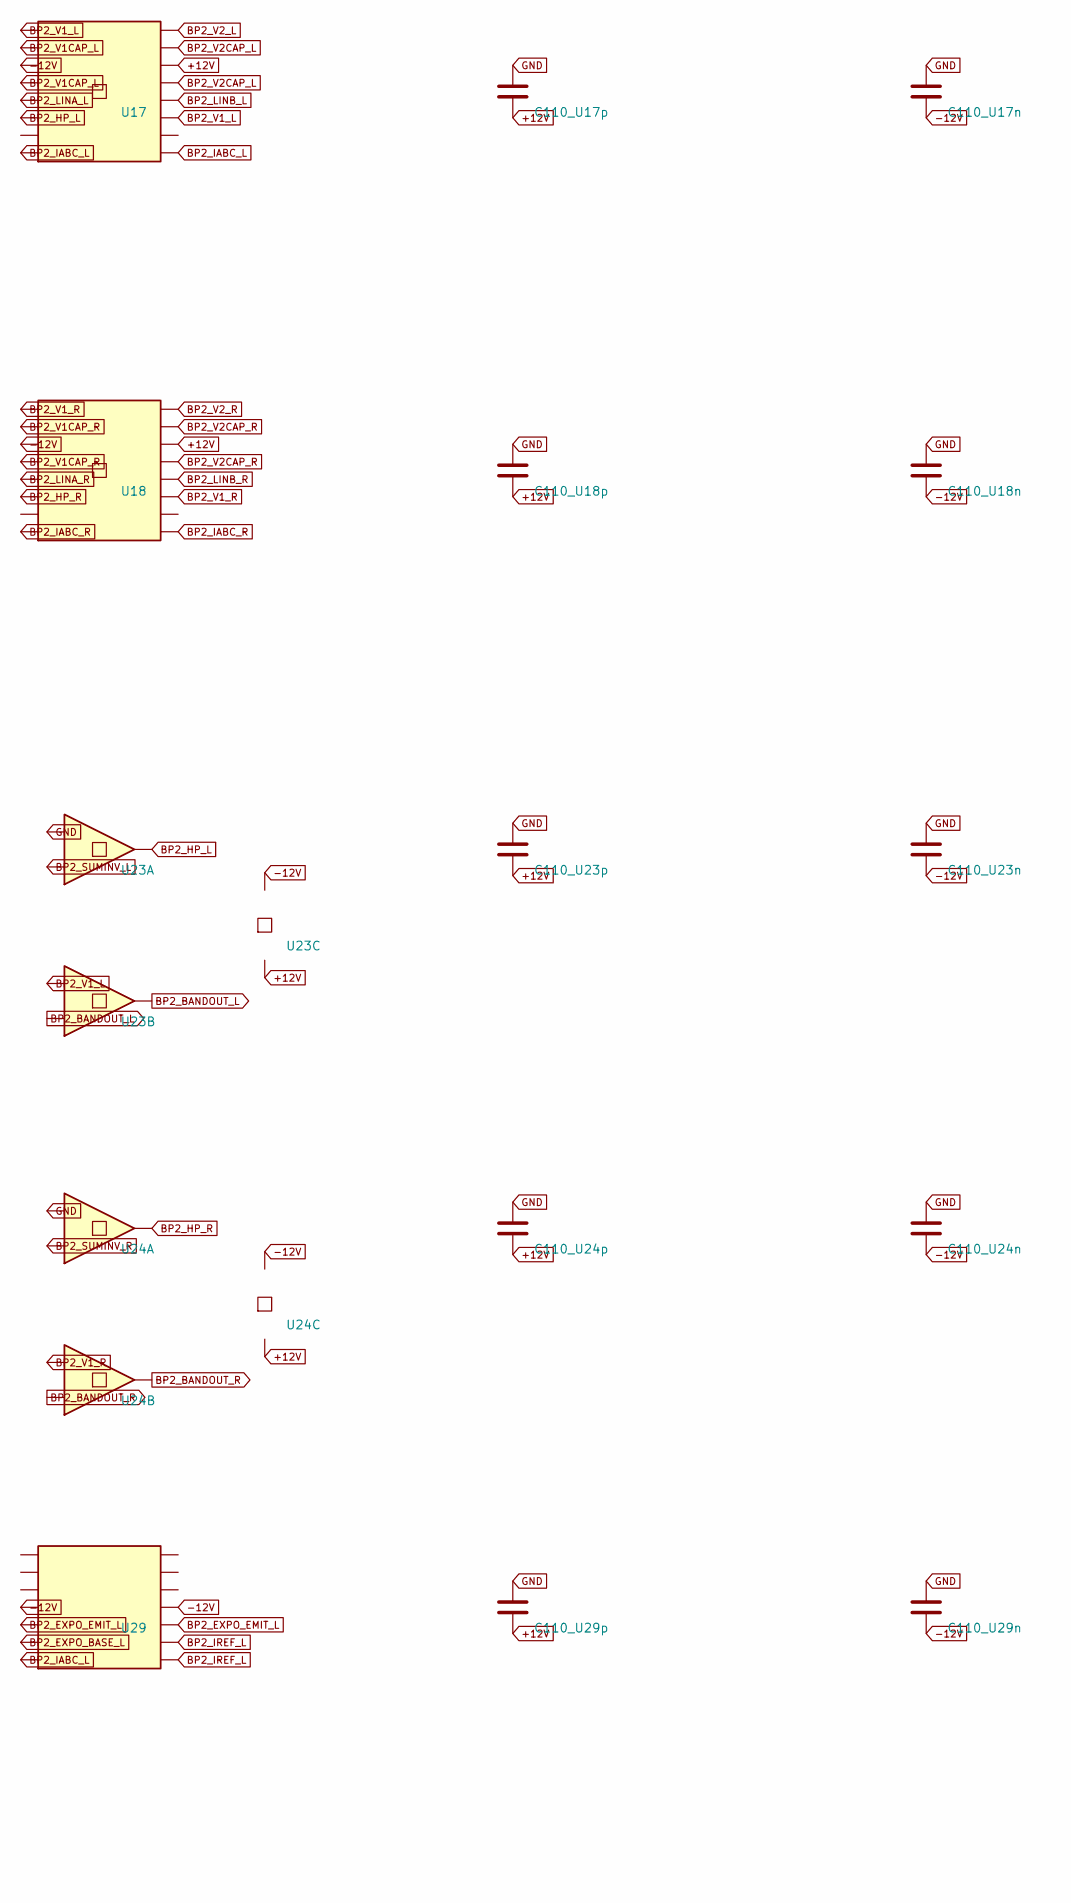
[picture p22: schematic pogo-block-6-svf2.kicad_sch, part in row 1, column 1]

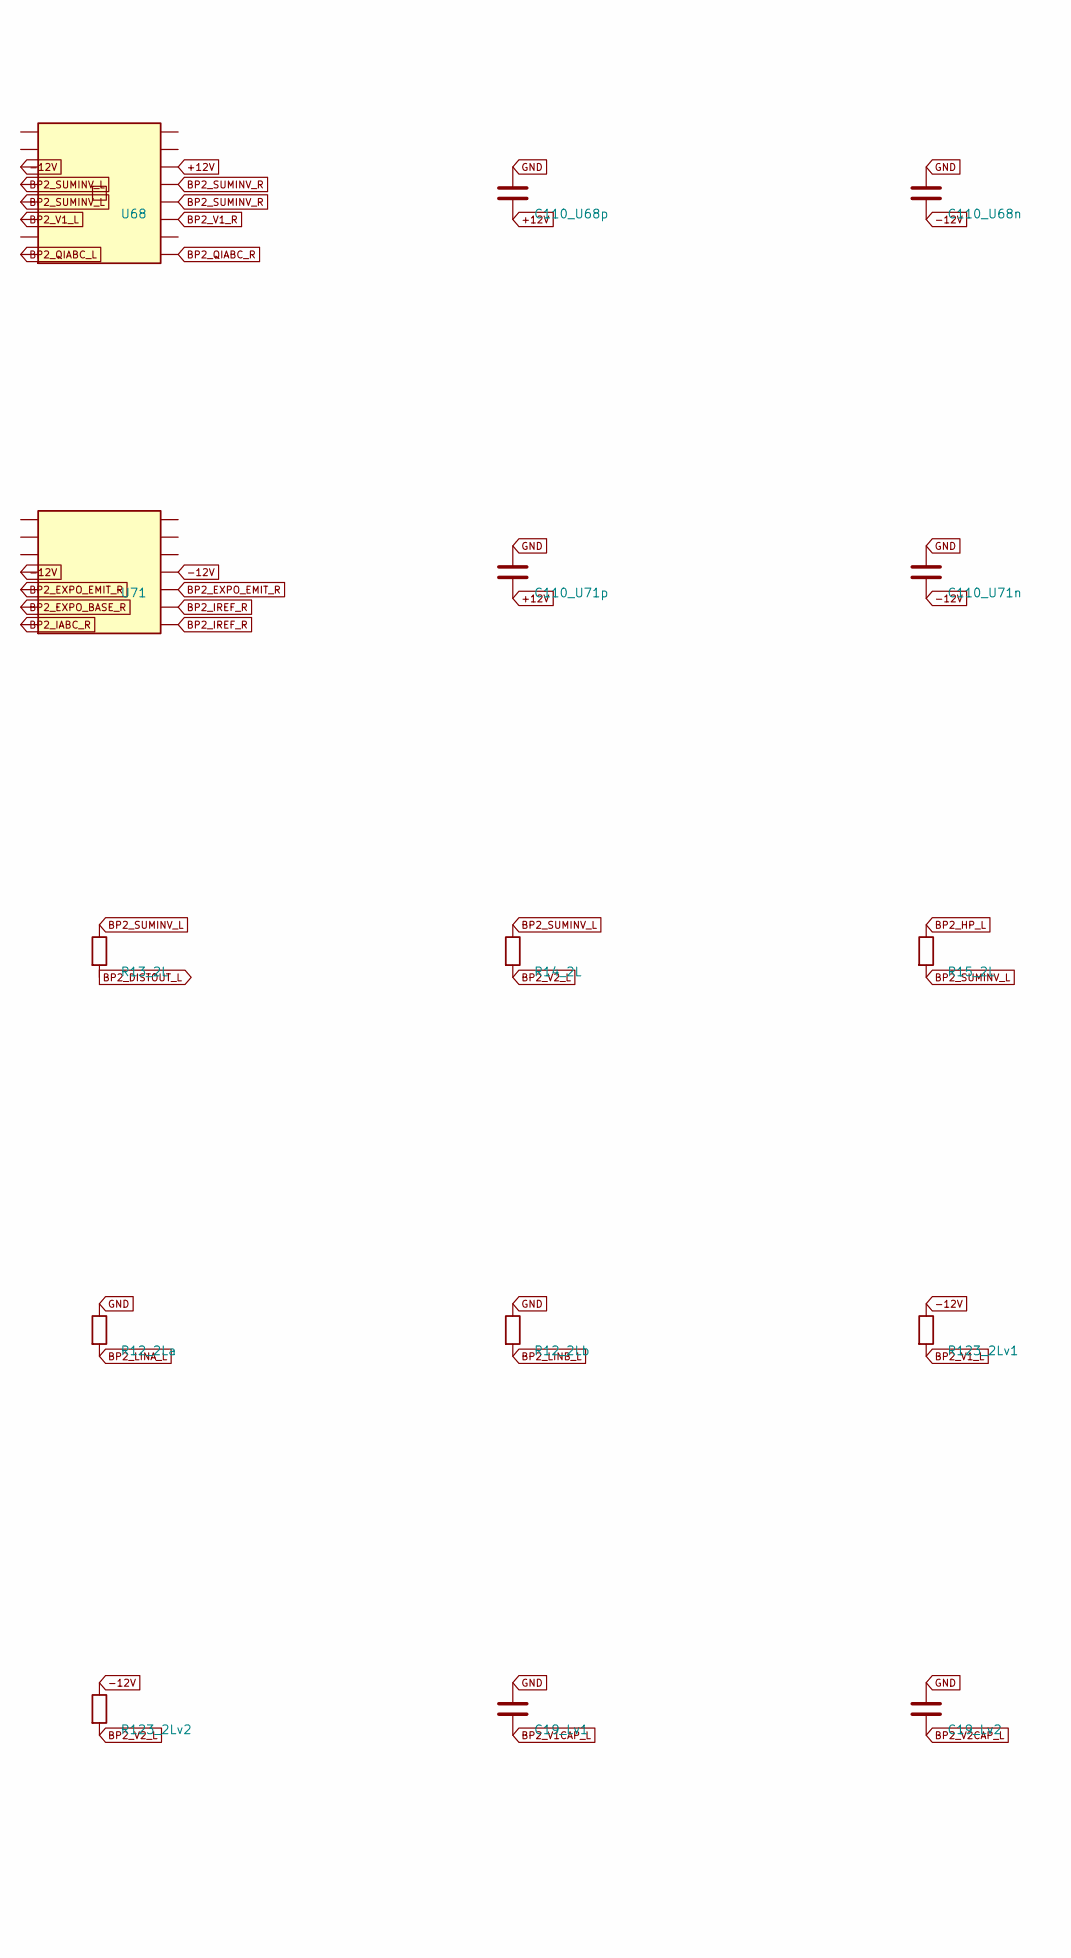
[picture p23: schematic pogo-block-6-svf2.kicad_sch, part in row 2, column 1]

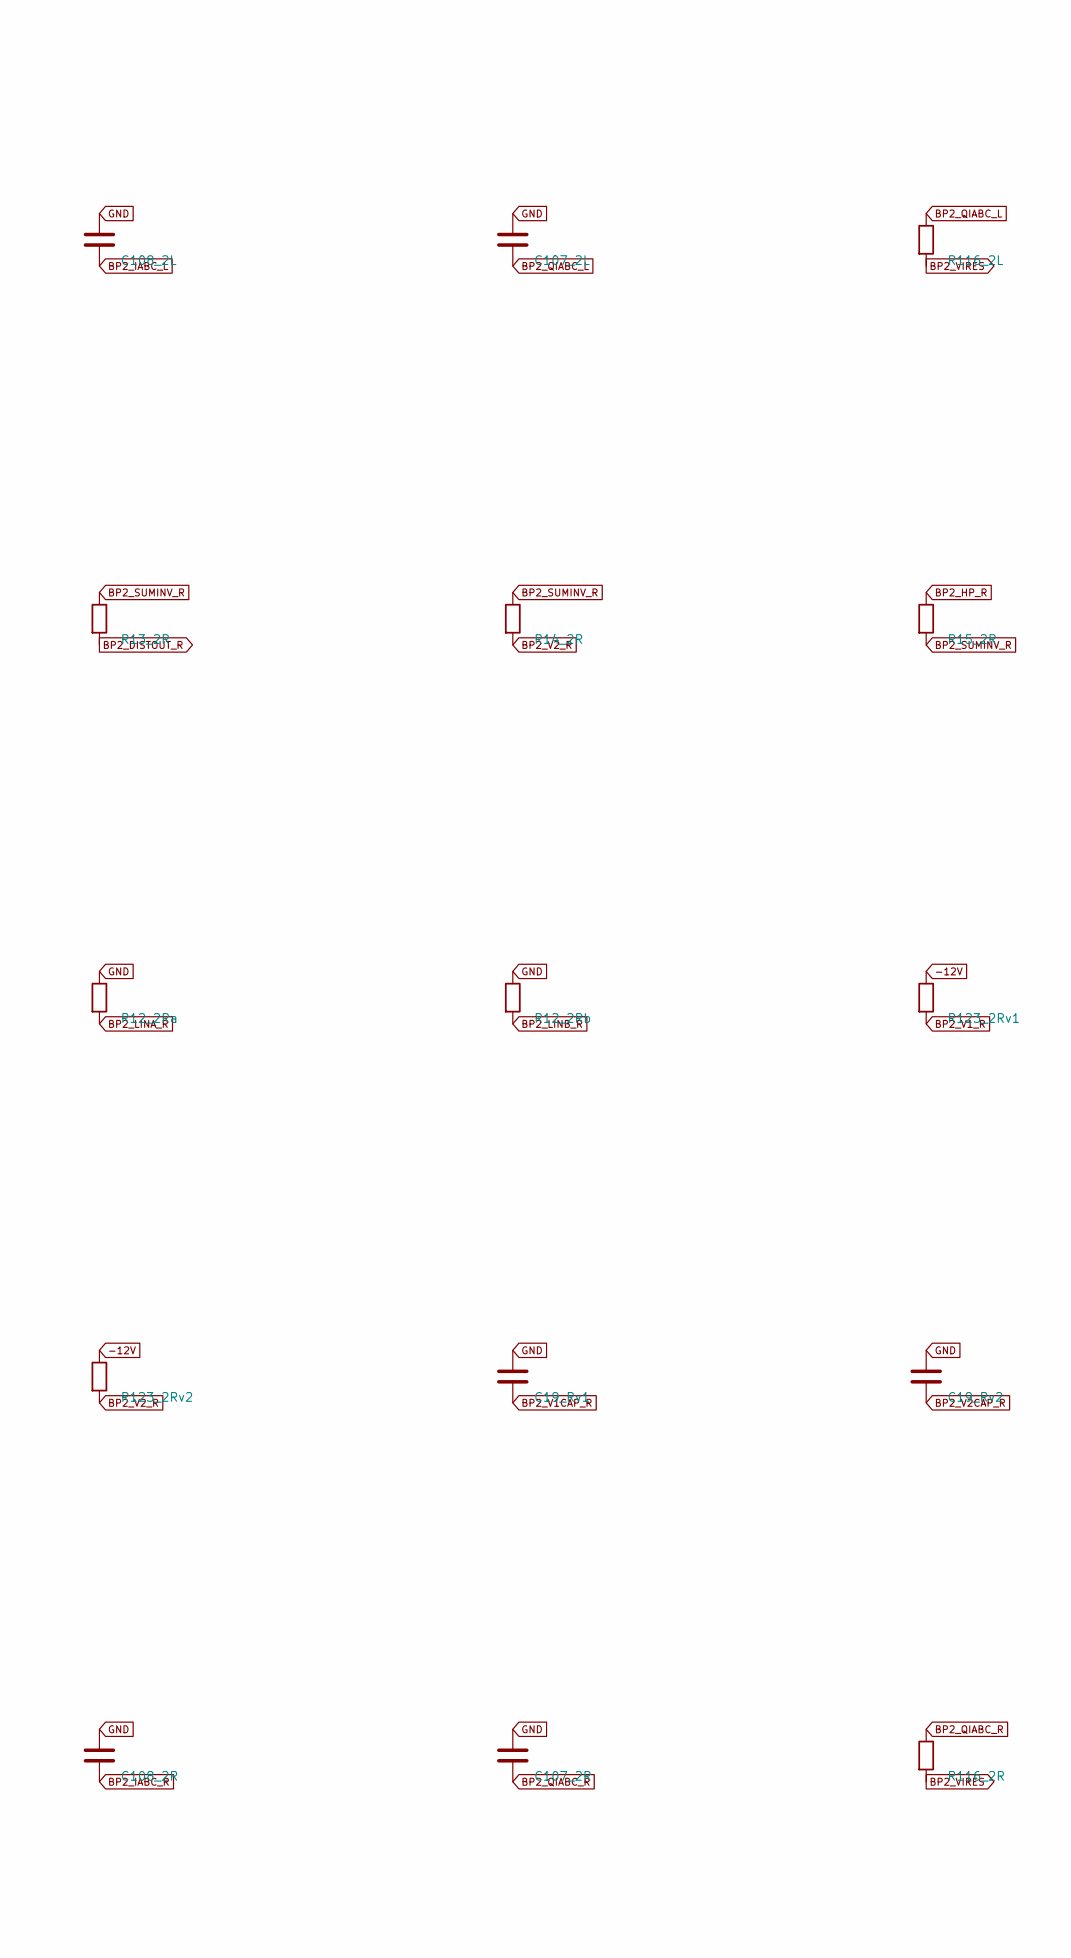
[picture p24: schematic pogo-block-6-svf2.kicad_sch, part in row 3, column 1]

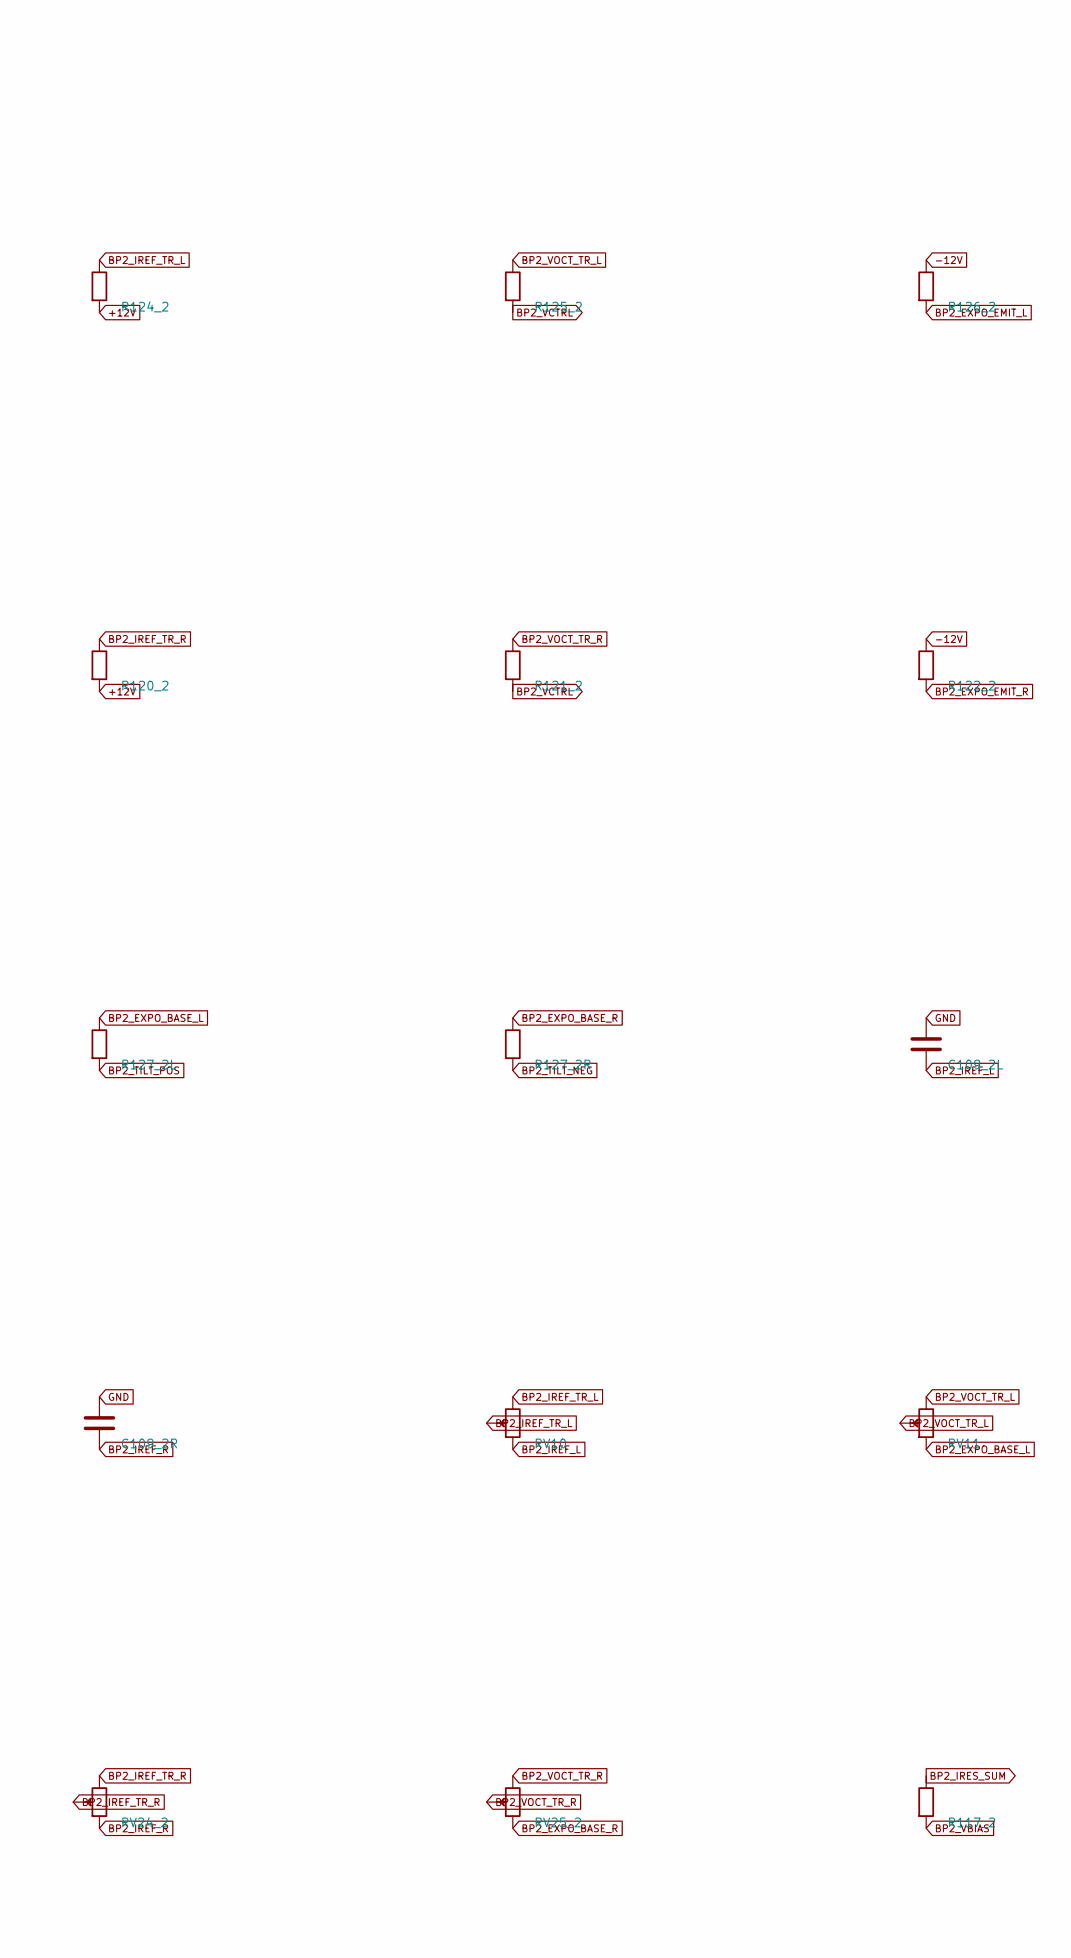
[picture p25: schematic pogo-block-6-svf2.kicad_sch, part in row 4, column 1]

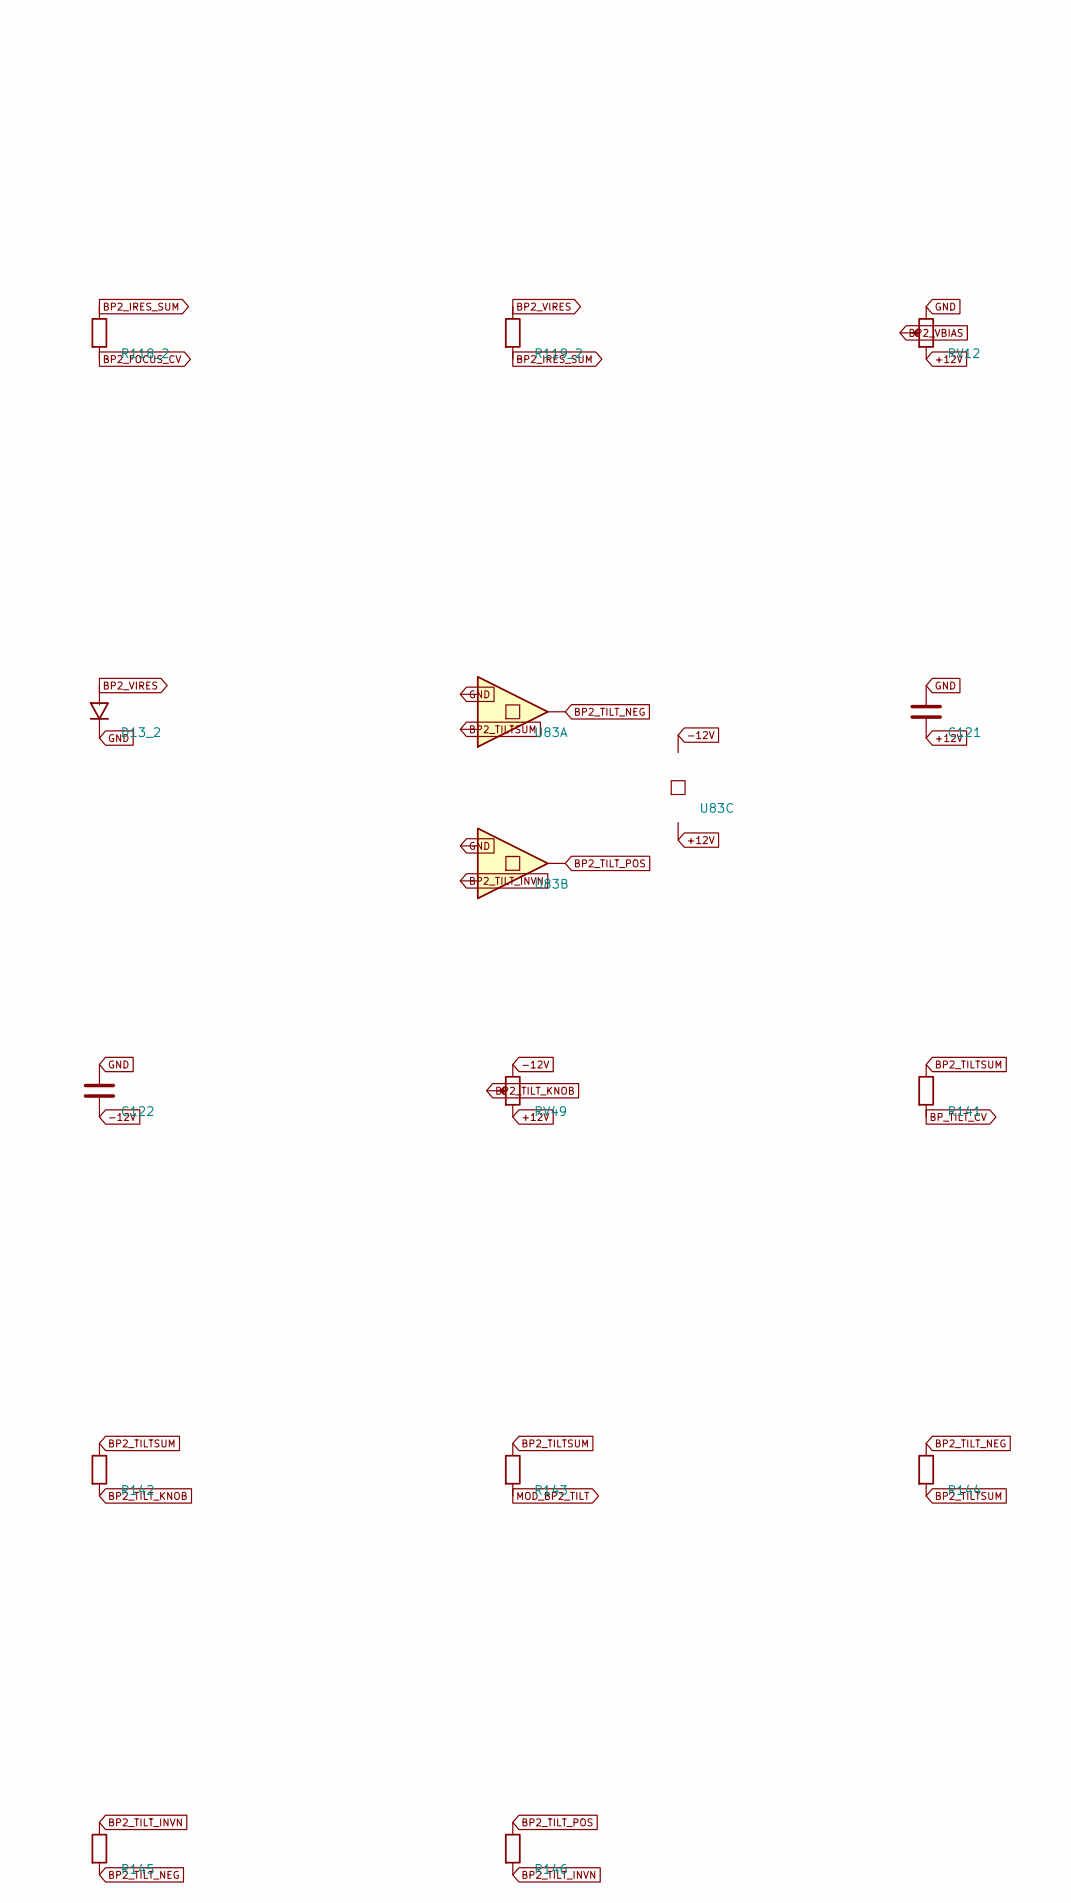
[picture p26: schematic pogo-block-6-svf2.kicad_sch, part in row 5, column 1]

Parts:
C19_Lv1, C19_Lv2, C19_Rv1, C19_Rv2: 68nF
C107_2L, C107_2R, C108_2L, C108_2R: 10nF
C109_2L, C109_2R, C110_U17n, C110_U17p, C110_U18n, C110_U18p, C110_U23n, C110_U23p, C110_U24n, C110_U24p, C110_U29n, C110_U29p, C110_U68n, C110_U68p, C110_U71n, C110_U71p, C121, C122: 100nF
D13_2: 1N4148W; D_SOD-123
R12_2La, R12_2Lb, R12_2Ra, R12_2Rb, R122_2, R126_2: 1k
R13_2L, R13_2R, R14_2L, R14_2R, R15_2L, R15_2R, R117_2, R118_2, R119_2, R127_2L, R127_2R, R141, R142, R144, R145, R146: 100k
R116_2L, R116_2R, R120_2, R124_2: 1M
R121_2, R125_2: 47k
R123_2Lv1, R123_2Lv2, R123_2Rv1, R123_2Rv2: 10k
R143: 470k
RV10: BP2_FREF_L; Potentiometer_Bourns_3224W
RV11: BP2_1VOCT_L; Potentiometer_Bourns_3224W
RV12: BP2_QMAX; Potentiometer_Bourns_3224W
RV24_2: BP2_FREF_R; Potentiometer_Bourns_3224W
RV25_2: BP2_1VOCT_R; Potentiometer_Bourns_3224W
RV49: BP2_TILT; Potentiometer_Songhuei_9mm_TallTrimmer_Vertical
U17, U18, U68: LM13700; SOIC-16_3.9x9.9mm_P1.27mm
U23, U24: OPA1612; SOIC-8_3.9x4.9mm_P1.27mm
U29, U71: THAT340; SOIC-14_3.9x8.7mm_P1.27mm
U83: TL072; SOIC-8_3.9x4.9mm_P1.27mm

Connections:
+12V: C110_U17p.2, C110_U18p.2, C110_U23p.2, C110_U24p.2, C110_U29p.2, C110_U68p.2, C110_U71p.2, C121.2, R120_2.2, R124_2.2, RV12.1, RV49.1, U17.14 (In+_B), U18.14 (In+_B), U23.4 (V-), U24.4 (V-), U68.14 (In+_B), U83.4 (V-)
-12V: C110_U17n.2, C110_U18n.2, C110_U23n.2, C110_U24n.2, C110_U29n.2, C110_U68n.2, C110_U71n.2, C122.2, R122_2.1, R123_2Lv1.1, R123_2Lv2.1, R123_2Rv1.1, R123_2Rv2.1, R126_2.1, RV49.3, U17.3 (In+_A), U18.3 (In+_A), U23.8 (V+), U24.8 (V+), U29.4 (SUB), U29.11 (SUB), U68.3 (In+_A), U71.4 (SUB), U71.11 (SUB), U83.8 (V+)
BP2_BANDOUT_L: U23.5 (In+), U23.7 (Out)
BP2_BANDOUT_R: U24.5 (In+), U24.7 (Out)
BP2_DISTOUT_L: R13_2L.2
BP2_DISTOUT_R: R13_2R.2
BP2_EXPO_BASE_L: R127_2L.1, RV11.1, U29.6 (Q3_B)
BP2_EXPO_BASE_R: R127_2R.1, RV25_2.1, U71.6 (Q3_B)
BP2_EXPO_EMIT_L: R126_2.2, U29.5 (Q3_E), U29.10 (Q4_E)
BP2_EXPO_EMIT_R: R122_2.2, U71.5 (Q3_E), U71.10 (Q4_E)
BP2_FOCUS_CV: R118_2.2
BP2_HP_L: R15_2L.1, U17.6 (V-), U23.1 (Out)
BP2_HP_R: R15_2R.1, U18.6 (V-), U24.1 (Out)
BP2_IABC_L: C108_2L.2, U17.8 (BufOut_A), U17.9 (BufOut_B), U29.7 (Q3_C)
BP2_IABC_R: C108_2R.2, U18.8 (BufOut_A), U18.9 (BufOut_B), U71.7 (Q3_C)
BP2_IREF_L: C109_2L.2, RV10.1, U29.8 (Q4_C), U29.9 (Q4_B)
BP2_IREF_R: C109_2R.2, RV24_2.1, U71.8 (Q4_C), U71.9 (Q4_B)
BP2_IREF_TR_L: R124_2.1, RV10.2 (Wiper), RV10.3
BP2_IREF_TR_R: R120_2.1, RV24_2.2 (Wiper), RV24_2.3
BP2_IRES_SUM: R117_2.1, R118_2.1, R119_2.2
BP2_LINA_L: R12_2La.2, U17.5 (Out_A)
BP2_LINA_R: R12_2Ra.2, U18.5 (Out_A)
BP2_LINB_L: R12_2Lb.2, U17.12 (Out_B)
BP2_LINB_R: R12_2Rb.2, U18.12 (Out_B)
BP2_QIABC_L: C107_2L.2, R116_2L.1, U68.8 (BufOut_A)
BP2_QIABC_R: C107_2R.2, R116_2R.1, U68.9 (BufOut_B)
BP2_SUMINV_L: R13_2L.1, R14_2L.1, R15_2L.2, U23.3 (In+), U68.4 (In-_A), U68.5 (Out_A)
BP2_SUMINV_R: R13_2R.1, R14_2R.1, R15_2R.2, U24.3 (In+), U68.12 (Out_B), U68.13 (In-_B)
BP2_TILTSUM: R141.1, R142.1, R143.1, R144.2, U83.3 (In+)
BP2_TILT_INVN: R145.1, R146.2, U83.5 (In+)
BP2_TILT_KNOB: R142.2, RV49.2 (Wiper)
BP2_TILT_NEG: R127_2R.2, R144.1, R145.2, U83.1 (Out)
BP2_TILT_POS: R127_2L.2, R146.1, U83.7 (Out)
BP2_V1CAP_L: C19_Lv1.2, U17.2 (DiodeBias_A), U17.4 (In-_A)
BP2_V1CAP_R: C19_Rv1.2, U18.2 (DiodeBias_A), U18.4 (In-_A)
BP2_V1_L: R123_2Lv1.2, U17.1 (Iabc_A), U17.11 (V+), U23.6 (In-), U68.6 (V-)
BP2_V1_R: R123_2Rv1.2, U18.1 (Iabc_A), U18.11 (V+), U24.6 (In-), U68.11 (V+)
BP2_V2CAP_L: C19_Lv2.2, U17.13 (In-_B), U17.15 (DiodeBias_B)
BP2_V2CAP_R: C19_Rv2.2, U18.13 (In-_B), U18.15 (DiodeBias_B)
BP2_V2_L: R14_2L.2, R123_2Lv2.2, U17.16 (Iabc_B)
BP2_V2_R: R14_2R.2, R123_2Rv2.2, U18.16 (Iabc_B)
BP2_VBIAS: R117_2.2, RV12.2 (Wiper)
BP2_VCTRL: R121_2.2, R125_2.2
BP2_VIRES: D13_2.A, R116_2L.2, R116_2R.2, R119_2.1
BP2_VOCT_TR_L: R125_2.1, RV11.2 (Wiper), RV11.3
BP2_VOCT_TR_R: R121_2.1, RV25_2.2 (Wiper), RV25_2.3
BP_TILT_CV: R141.2
GND: C19_Lv1.1, C19_Lv2.1, C19_Rv1.1, C19_Rv2.1, C107_2L.1, C107_2R.1, C108_2L.1, C108_2R.1, C109_2L.1, C109_2R.1, C110_U17n.1, C110_U17p.1, C110_U18n.1, C110_U18p.1, C110_U23n.1, C110_U23p.1, C110_U24n.1, C110_U24p.1, C110_U29n.1, C110_U29p.1, C110_U68n.1, C110_U68p.1, C110_U71n.1, C110_U71p.1, C121.1, C122.1, D13_2.K, R12_2La.1, R12_2Lb.1, R12_2Ra.1, R12_2Rb.1, RV12.3, U23.2 (In-), U24.2 (In-), U83.2 (In-), U83.6 (In-)
MOD_BP2_TILT: R143.2
