jeffmhopkins/POGO/kicad/pogo-block-6-svf3.kicad_sch

## KiCad design kicad/pogo-block-6-svf3.kicad_sch (2026-05-31)

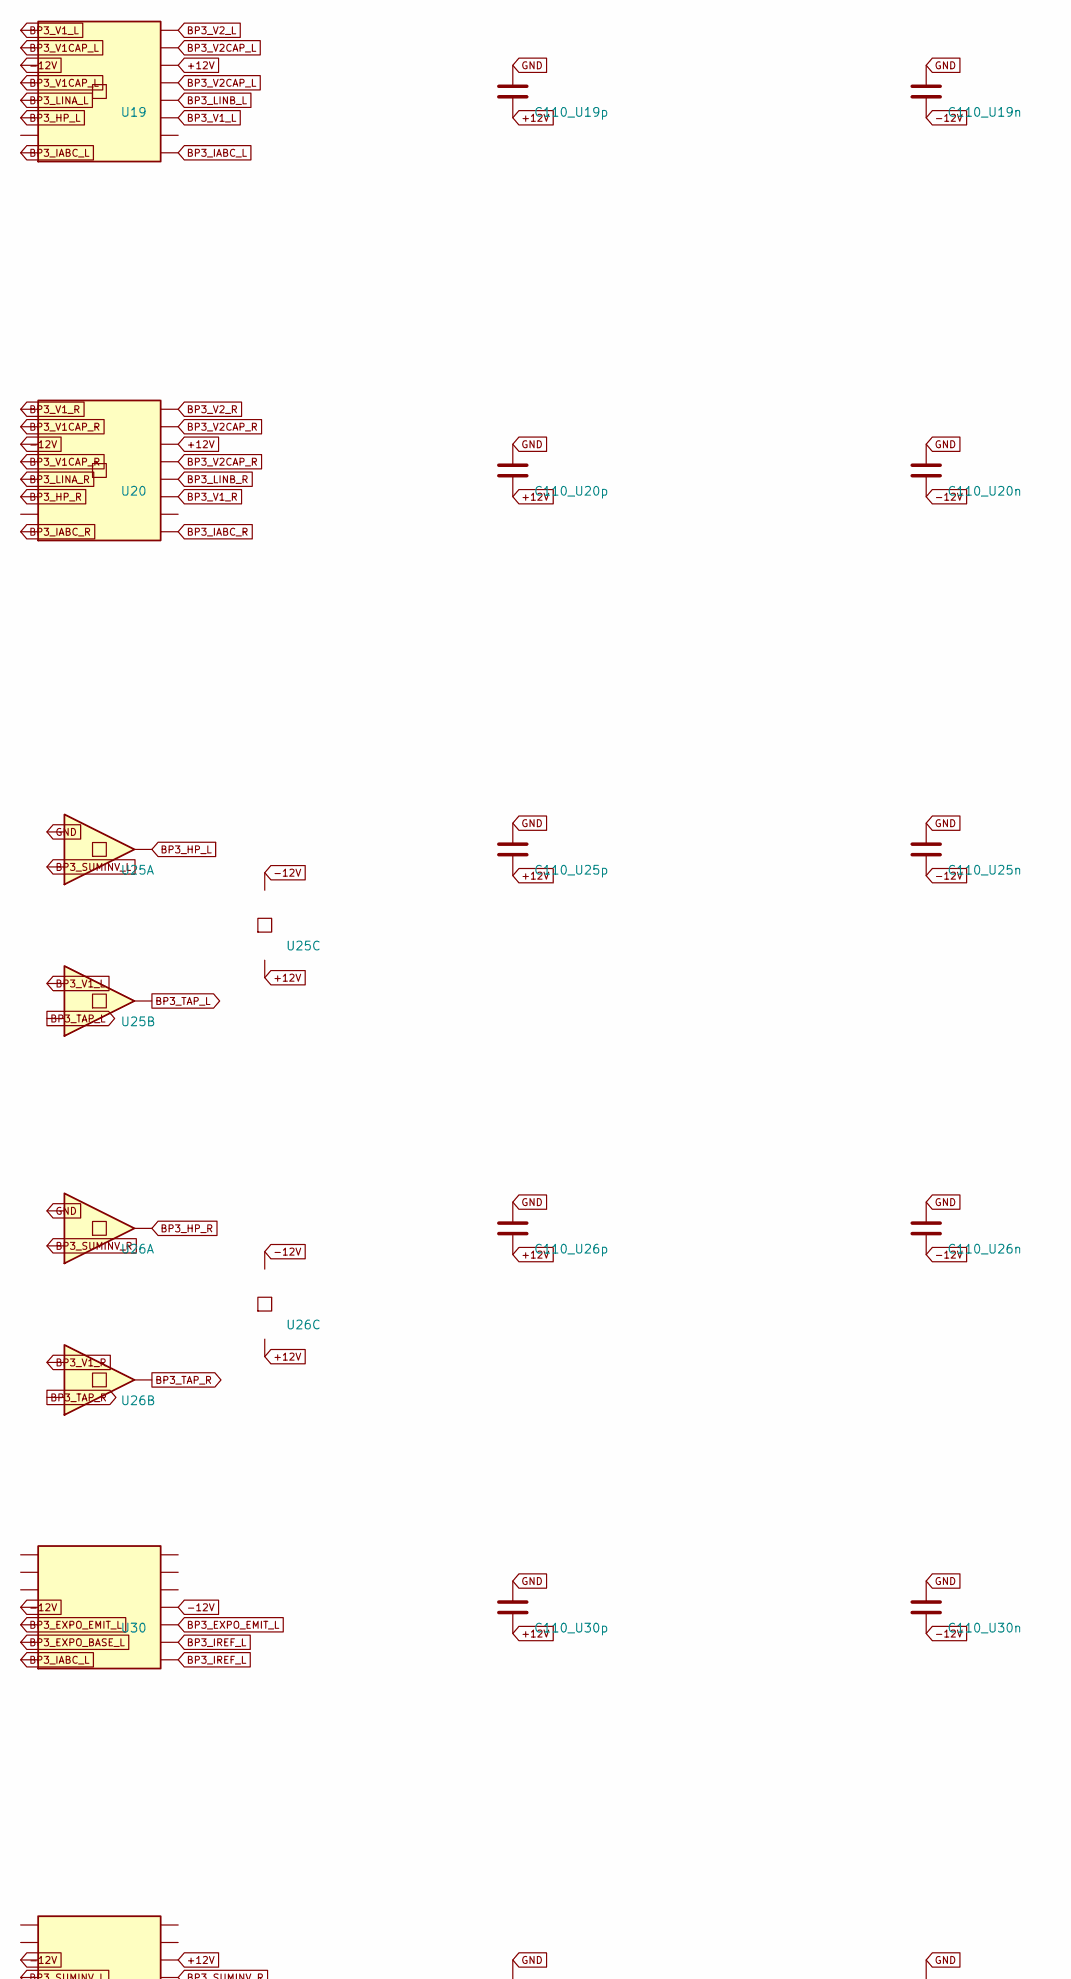
[picture p27: schematic pogo-block-6-svf3.kicad_sch, part in row 1, column 1]

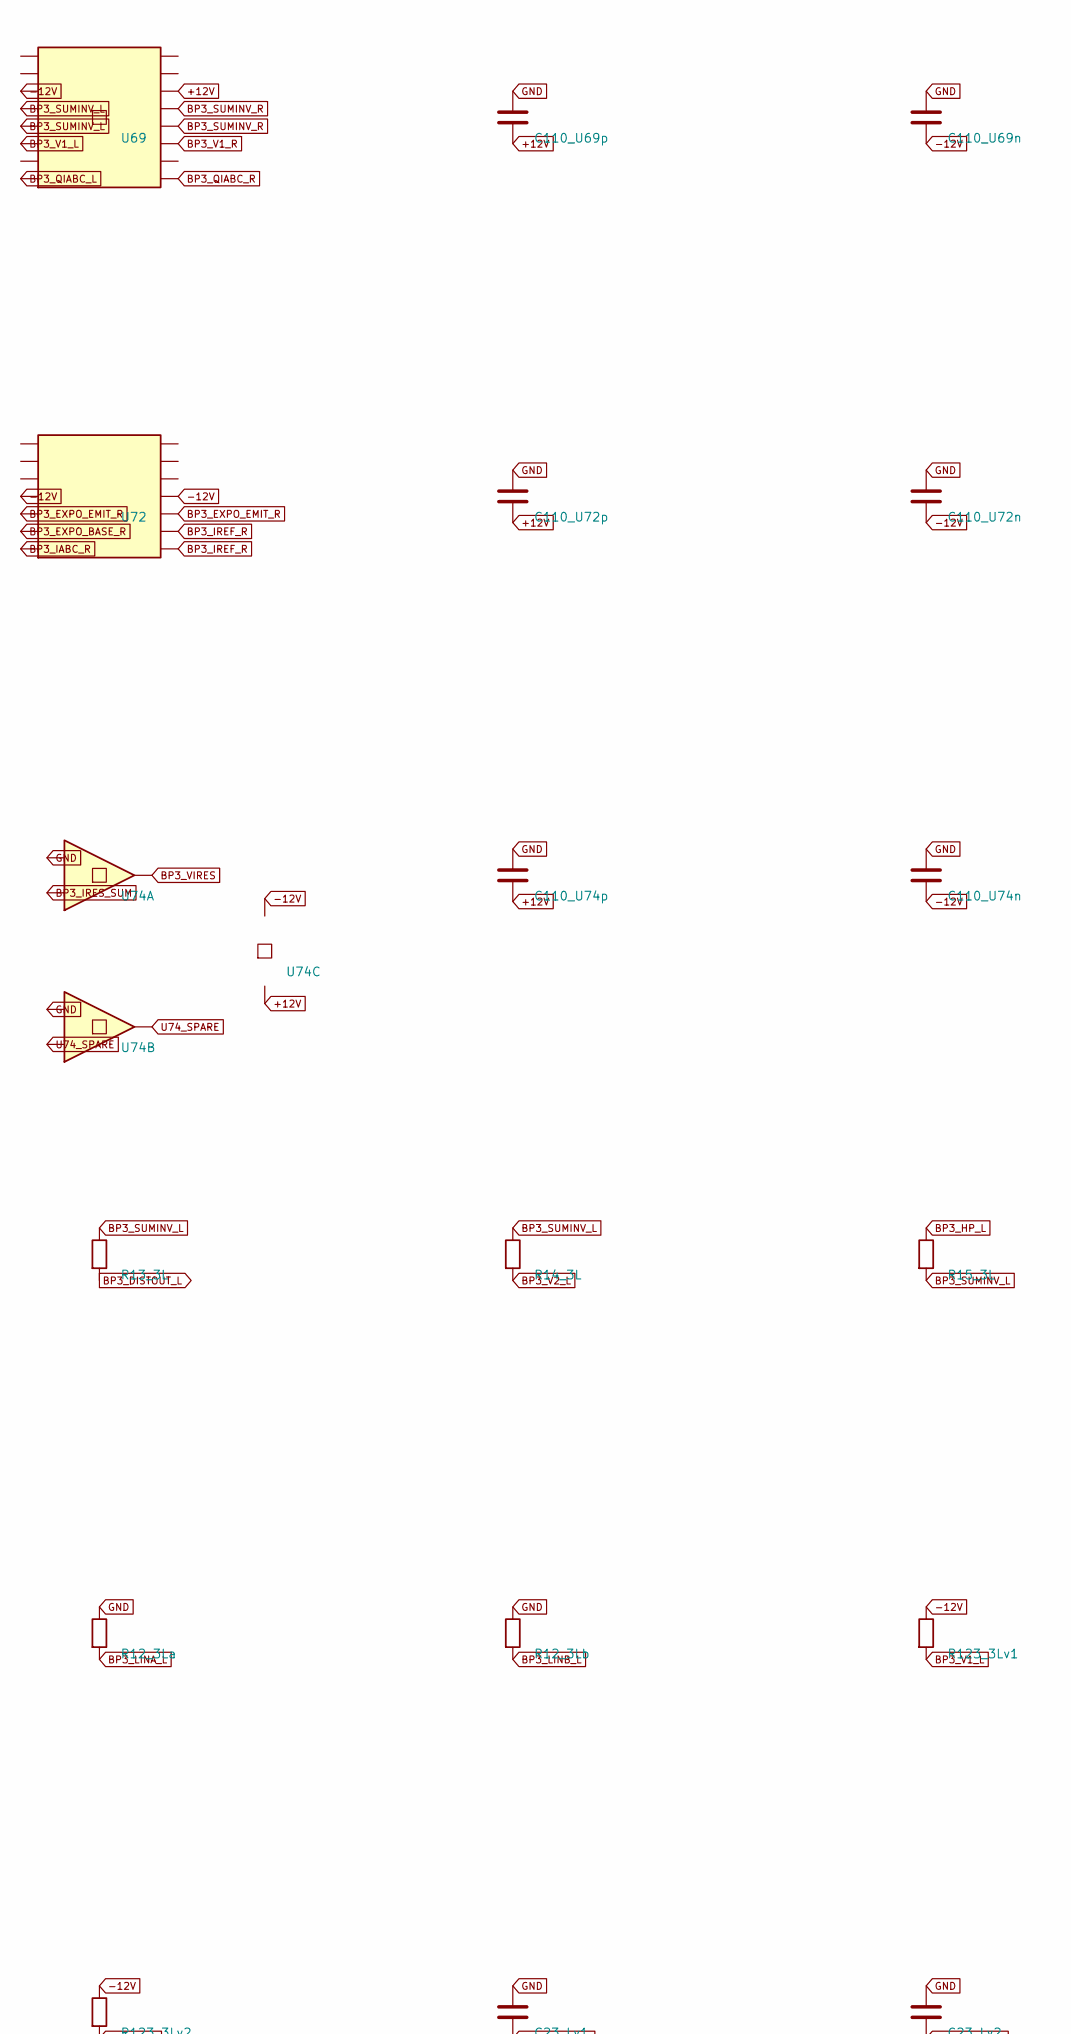
[picture p28: schematic pogo-block-6-svf3.kicad_sch, part in row 2, column 1]

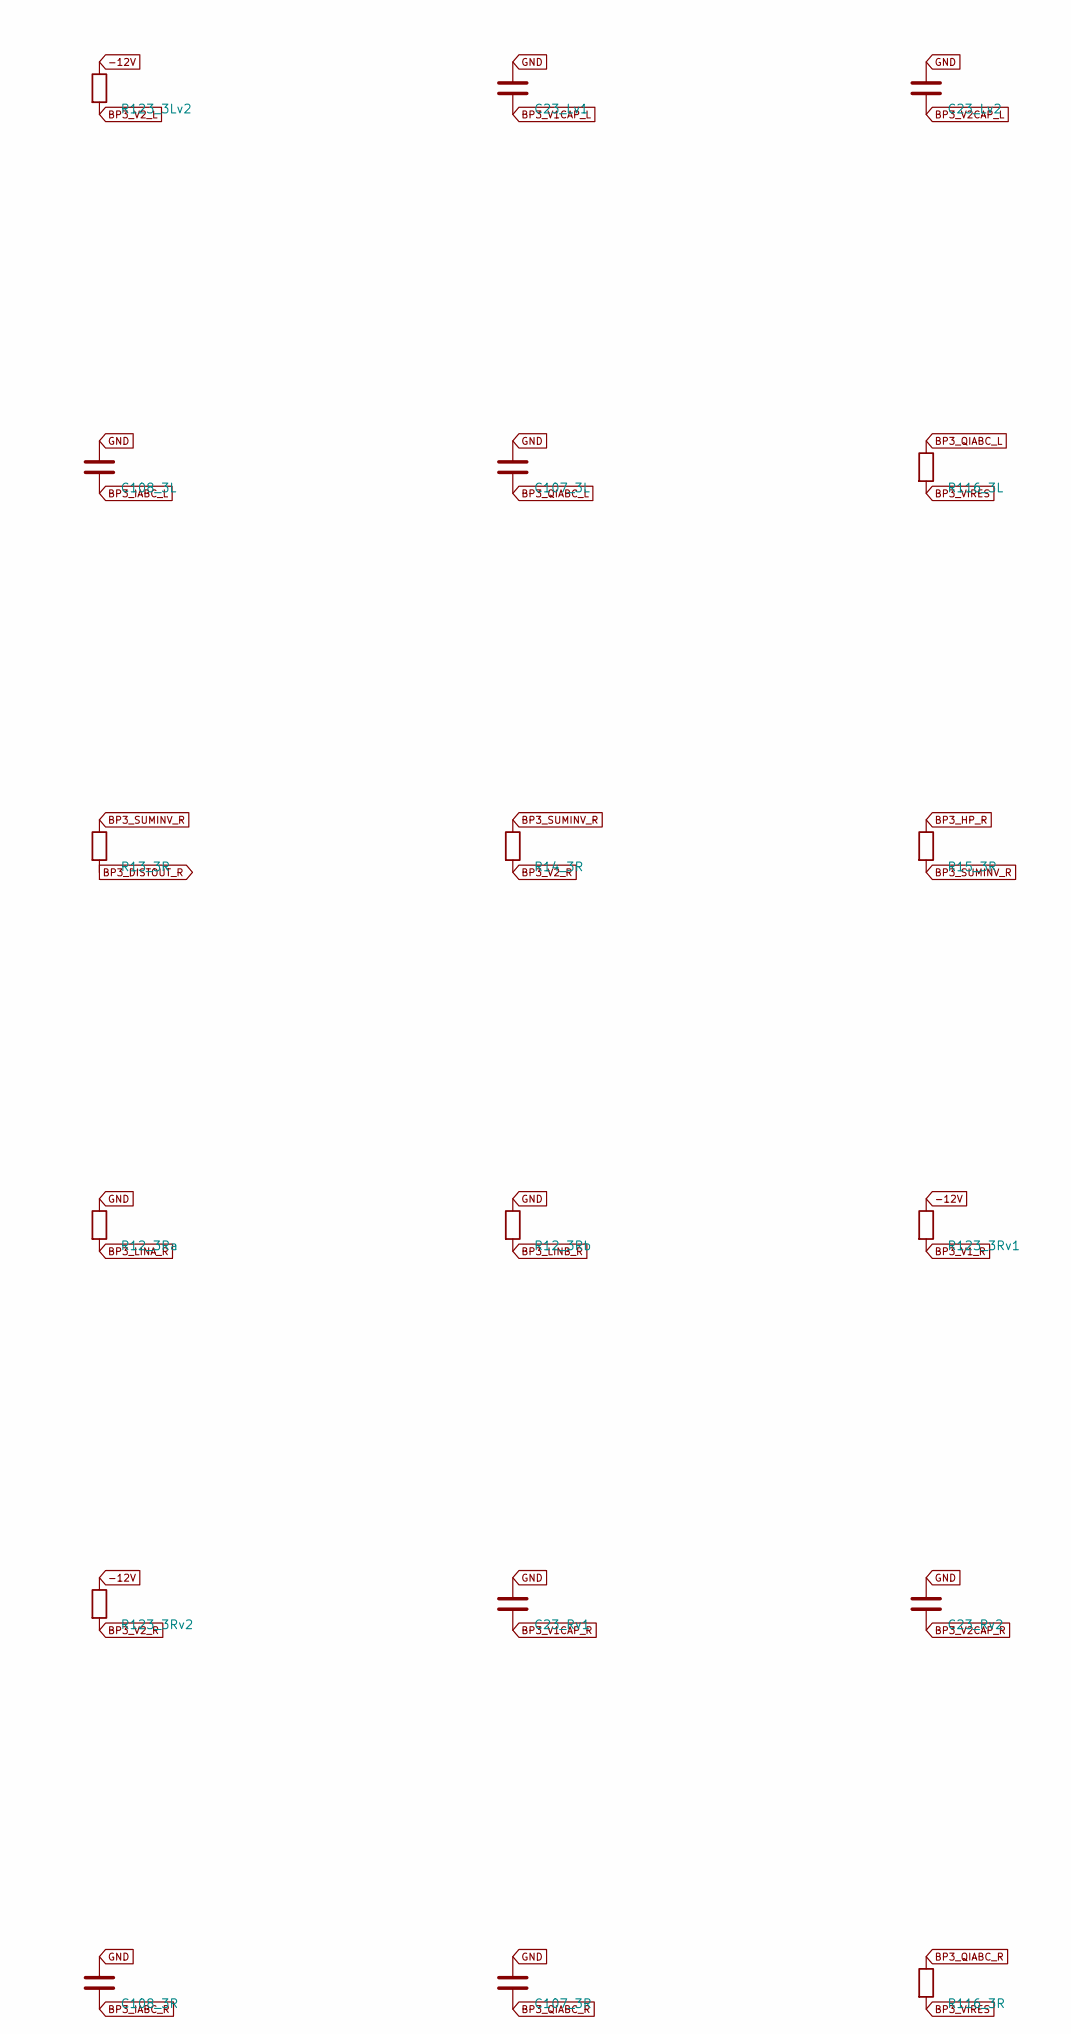
[picture p29: schematic pogo-block-6-svf3.kicad_sch, part in row 3, column 1]

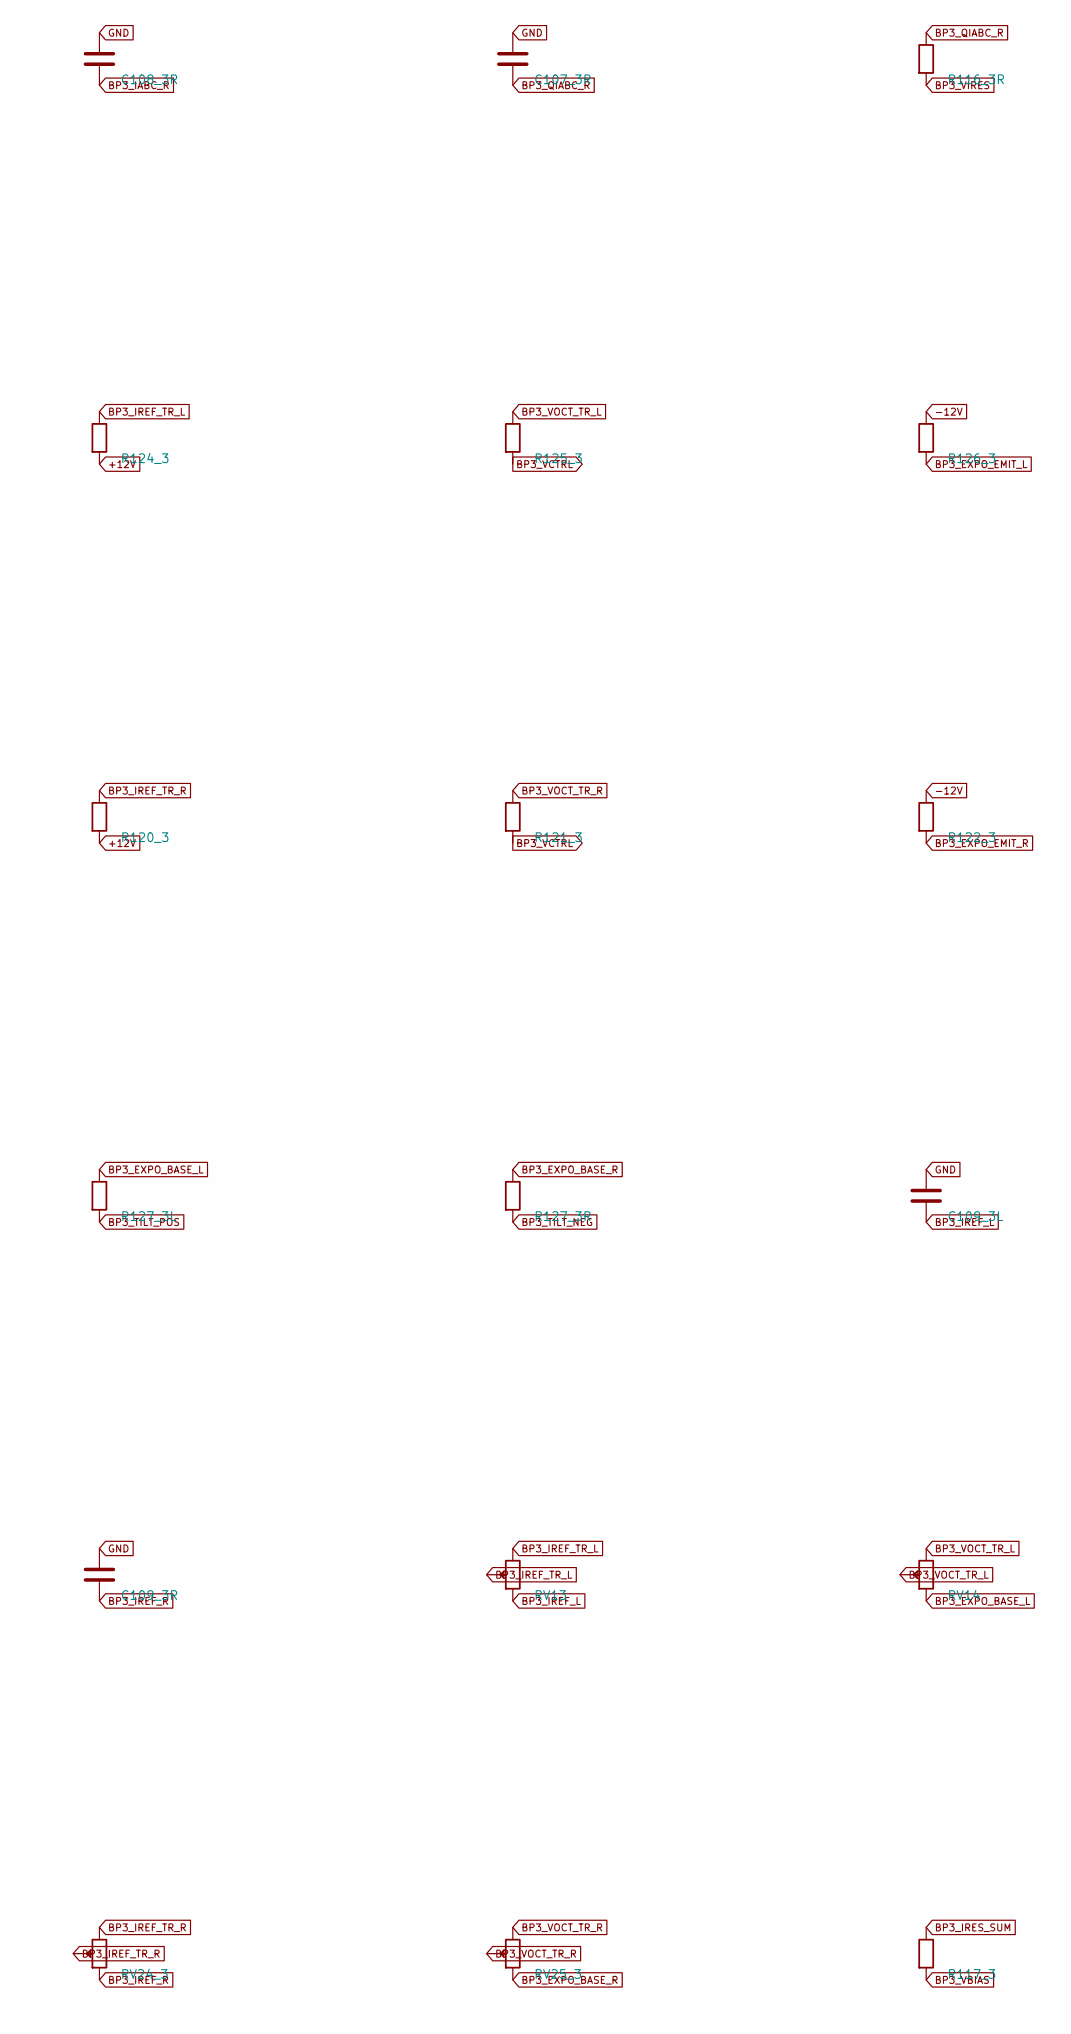
[picture p30: schematic pogo-block-6-svf3.kicad_sch, part in row 4, column 1]

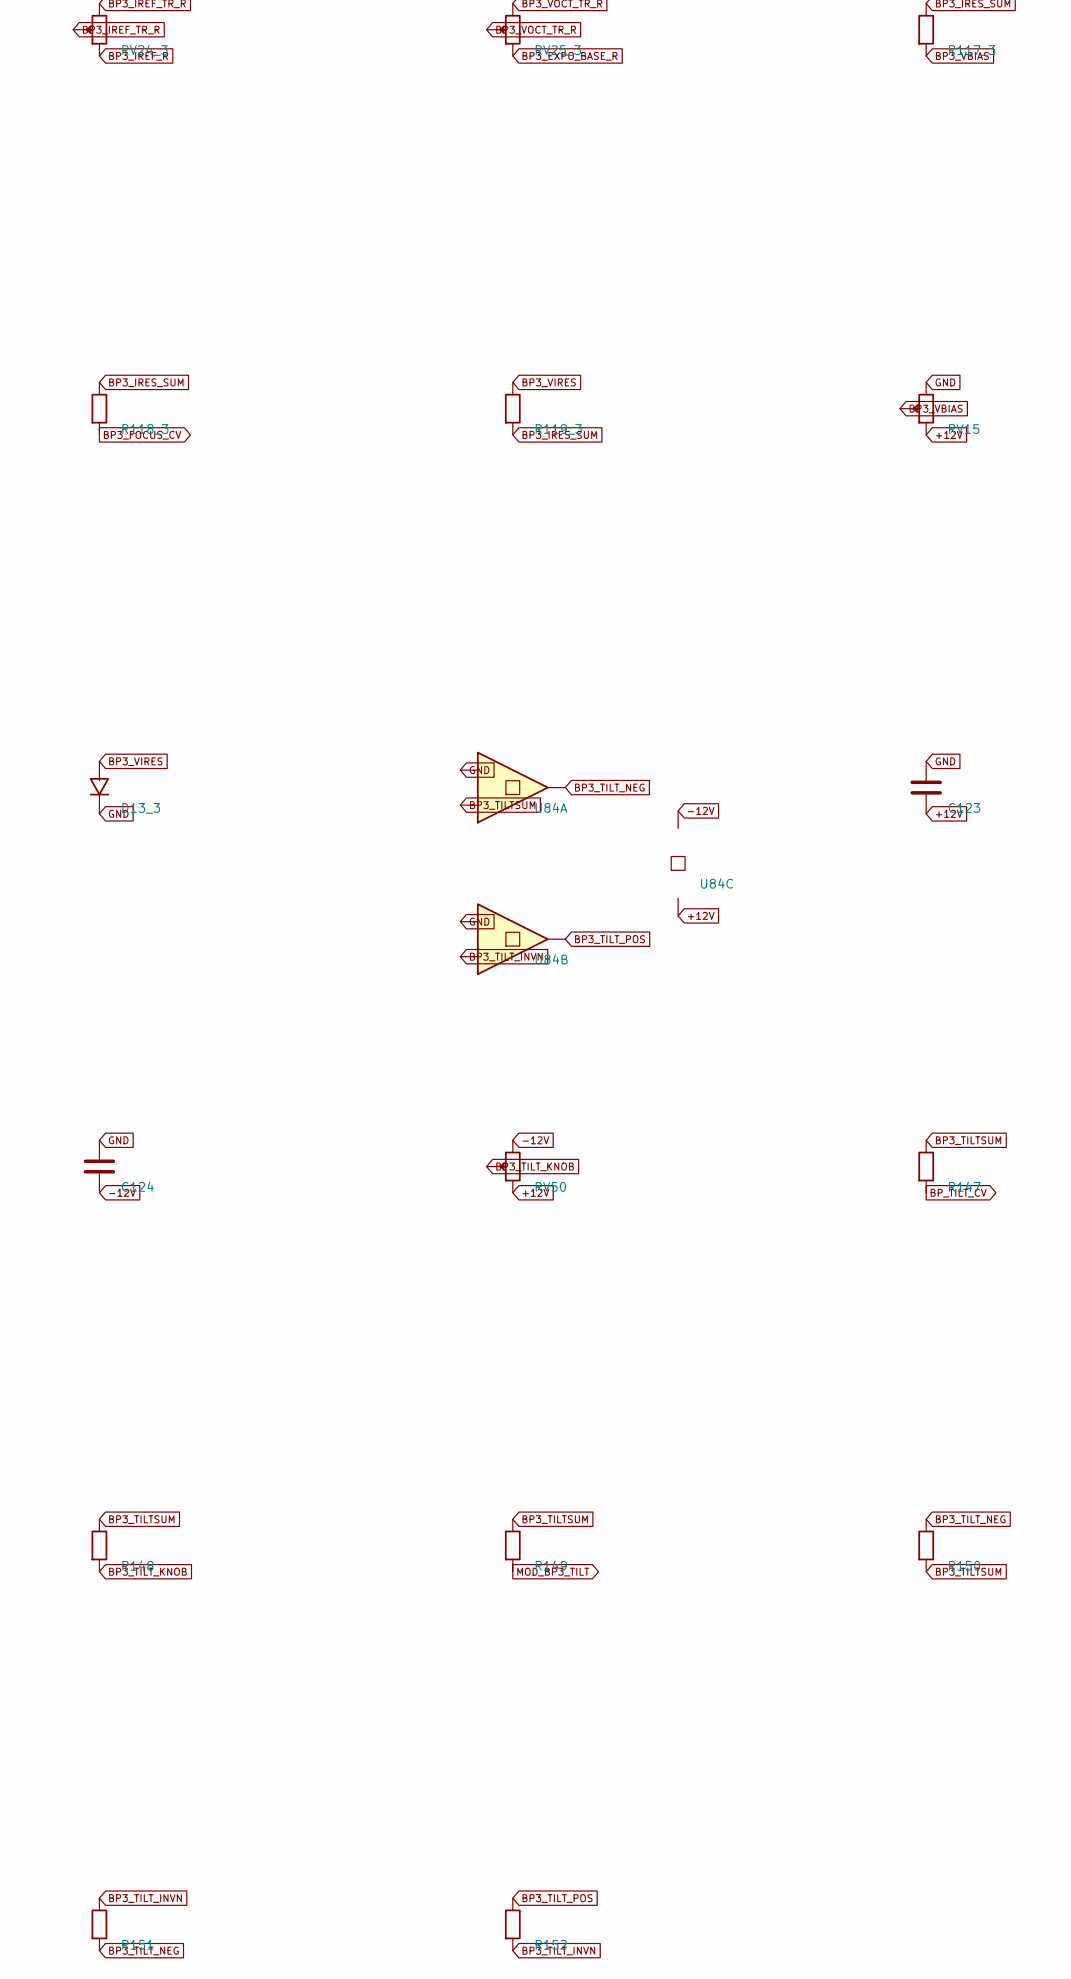
[picture p31: schematic pogo-block-6-svf3.kicad_sch, part in row 5, column 1]

Parts:
C23_Lv1, C23_Lv2, C23_Rv1, C23_Rv2: 68nF
C107_3L, C107_3R, C108_3L, C108_3R: 10nF
C109_3L, C109_3R, C110_U19n, C110_U19p, C110_U20n, C110_U20p, C110_U25n, C110_U25p, C110_U26n, C110_U26p, C110_U30n, C110_U30p, C110_U69n, C110_U69p, C110_U72n, C110_U72p, C110_U74n, C110_U74p, C123, C124: 100nF
D13_3: 1N4148W; D_SOD-123
R12_3La, R12_3Lb, R12_3Ra, R12_3Rb, R122_3, R126_3: 1k
R13_3L, R13_3R, R14_3L, R14_3R, R15_3L, R15_3R, R117_3, R118_3, R119_3, R127_3L, R127_3R, R147, R148, R150, R151, R152: 100k
R116_3L, R116_3R, R120_3, R124_3: 1M
R121_3, R125_3: 47k
R123_3Lv1, R123_3Lv2, R123_3Rv1, R123_3Rv2: 10k
R149: 470k
RV13: BP3_FREF_L; Potentiometer_Bourns_3224W
RV14: BP3_1VOCT_L; Potentiometer_Bourns_3224W
RV15: BP3_QMAX; Potentiometer_Bourns_3224W
RV24_3: BP3_FREF_R; Potentiometer_Bourns_3224W
RV25_3: BP3_1VOCT_R; Potentiometer_Bourns_3224W
RV50: BP3_TILT; Potentiometer_Songhuei_9mm_TallTrimmer_Vertical
U19, U20, U69: LM13700; SOIC-16_3.9x9.9mm_P1.27mm
U25, U26: OPA1612; SOIC-8_3.9x4.9mm_P1.27mm
U30, U72: THAT340; SOIC-14_3.9x8.7mm_P1.27mm
U74, U84: TL072; SOIC-8_3.9x4.9mm_P1.27mm

Connections:
+12V: C110_U19p.2, C110_U20p.2, C110_U25p.2, C110_U26p.2, C110_U30p.2, C110_U69p.2, C110_U72p.2, C110_U74p.2, C123.2, R120_3.2, R124_3.2, RV15.1, RV50.1, U19.14 (In+_B), U20.14 (In+_B), U25.4 (V-), U26.4 (V-), U69.14 (In+_B), U74.4 (V-), U84.4 (V-)
-12V: C110_U19n.2, C110_U20n.2, C110_U25n.2, C110_U26n.2, C110_U30n.2, C110_U69n.2, C110_U72n.2, C110_U74n.2, C124.2, R122_3.1, R123_3Lv1.1, R123_3Lv2.1, R123_3Rv1.1, R123_3Rv2.1, R126_3.1, RV50.3, U19.3 (In+_A), U20.3 (In+_A), U25.8 (V+), U26.8 (V+), U30.4 (SUB), U30.11 (SUB), U69.3 (In+_A), U72.4 (SUB), U72.11 (SUB), U74.8 (V+), U84.8 (V+)
BP3_DISTOUT_L: R13_3L.2
BP3_DISTOUT_R: R13_3R.2
BP3_EXPO_BASE_L: R127_3L.1, RV14.1, U30.6 (Q3_B)
BP3_EXPO_BASE_R: R127_3R.1, RV25_3.1, U72.6 (Q3_B)
BP3_EXPO_EMIT_L: R126_3.2, U30.5 (Q3_E), U30.10 (Q4_E)
BP3_EXPO_EMIT_R: R122_3.2, U72.5 (Q3_E), U72.10 (Q4_E)
BP3_FOCUS_CV: R118_3.2
BP3_HP_L: R15_3L.1, U19.6 (V-), U25.1 (Out)
BP3_HP_R: R15_3R.1, U20.6 (V-), U26.1 (Out)
BP3_IABC_L: C108_3L.2, U19.8 (BufOut_A), U19.9 (BufOut_B), U30.7 (Q3_C)
BP3_IABC_R: C108_3R.2, U20.8 (BufOut_A), U20.9 (BufOut_B), U72.7 (Q3_C)
BP3_IREF_L: C109_3L.2, RV13.1, U30.8 (Q4_C), U30.9 (Q4_B)
BP3_IREF_R: C109_3R.2, RV24_3.1, U72.8 (Q4_C), U72.9 (Q4_B)
BP3_IREF_TR_L: R124_3.1, RV13.2 (Wiper), RV13.3
BP3_IREF_TR_R: R120_3.1, RV24_3.2 (Wiper), RV24_3.3
BP3_IRES_SUM: R117_3.1, R118_3.1, R119_3.2, U74.3 (In+)
BP3_LINA_L: R12_3La.2, U19.5 (Out_A)
BP3_LINA_R: R12_3Ra.2, U20.5 (Out_A)
BP3_LINB_L: R12_3Lb.2, U19.12 (Out_B)
BP3_LINB_R: R12_3Rb.2, U20.12 (Out_B)
BP3_QIABC_L: C107_3L.2, R116_3L.1, U69.8 (BufOut_A)
BP3_QIABC_R: C107_3R.2, R116_3R.1, U69.9 (BufOut_B)
BP3_SUMINV_L: R13_3L.1, R14_3L.1, R15_3L.2, U25.3 (In+), U69.4 (In-_A), U69.5 (Out_A)
BP3_SUMINV_R: R13_3R.1, R14_3R.1, R15_3R.2, U26.3 (In+), U69.12 (Out_B), U69.13 (In-_B)
BP3_TAP_L: U25.5 (In+), U25.7 (Out)
BP3_TAP_R: U26.5 (In+), U26.7 (Out)
BP3_TILTSUM: R147.1, R148.1, R149.1, R150.2, U84.3 (In+)
BP3_TILT_INVN: R151.1, R152.2, U84.5 (In+)
BP3_TILT_KNOB: R148.2, RV50.2 (Wiper)
BP3_TILT_NEG: R127_3R.2, R150.1, R151.2, U84.1 (Out)
BP3_TILT_POS: R127_3L.2, R152.1, U84.7 (Out)
BP3_V1CAP_L: C23_Lv1.2, U19.2 (DiodeBias_A), U19.4 (In-_A)
BP3_V1CAP_R: C23_Rv1.2, U20.2 (DiodeBias_A), U20.4 (In-_A)
BP3_V1_L: R123_3Lv1.2, U19.1 (Iabc_A), U19.11 (V+), U25.6 (In-), U69.6 (V-)
BP3_V1_R: R123_3Rv1.2, U20.1 (Iabc_A), U20.11 (V+), U26.6 (In-), U69.11 (V+)
BP3_V2CAP_L: C23_Lv2.2, U19.13 (In-_B), U19.15 (DiodeBias_B)
BP3_V2CAP_R: C23_Rv2.2, U20.13 (In-_B), U20.15 (DiodeBias_B)
BP3_V2_L: R14_3L.2, R123_3Lv2.2, U19.16 (Iabc_B)
BP3_V2_R: R14_3R.2, R123_3Rv2.2, U20.16 (Iabc_B)
BP3_VBIAS: R117_3.2, RV15.2 (Wiper)
BP3_VCTRL: R121_3.2, R125_3.2
BP3_VIRES: D13_3.A, R116_3L.2, R116_3R.2, R119_3.1, U74.1 (Out)
BP3_VOCT_TR_L: R125_3.1, RV14.2 (Wiper), RV14.3
BP3_VOCT_TR_R: R121_3.1, RV25_3.2 (Wiper), RV25_3.3
BP_TILT_CV: R147.2
GND: C23_Lv1.1, C23_Lv2.1, C23_Rv1.1, C23_Rv2.1, C107_3L.1, C107_3R.1, C108_3L.1, C108_3R.1, C109_3L.1, C109_3R.1, C110_U19n.1, C110_U19p.1, C110_U20n.1, C110_U20p.1, C110_U25n.1, C110_U25p.1, C110_U26n.1, C110_U26p.1, C110_U30n.1, C110_U30p.1, C110_U69n.1, C110_U69p.1, C110_U72n.1, C110_U72p.1, C110_U74n.1, C110_U74p.1, C123.1, C124.1, D13_3.K, R12_3La.1, R12_3Lb.1, R12_3Ra.1, R12_3Rb.1, RV15.3, U25.2 (In-), U26.2 (In-), U74.2 (In-), U74.6 (In-), U84.2 (In-), U84.6 (In-)
MOD_BP3_TILT: R149.2
U74_SPARE: U74.5 (In+), U74.7 (Out)
