jeffmhopkins/POGO/kicad/pogo-block-7.kicad_sch

## KiCad design kicad/pogo-block-7.kicad_sch (2026-05-31)

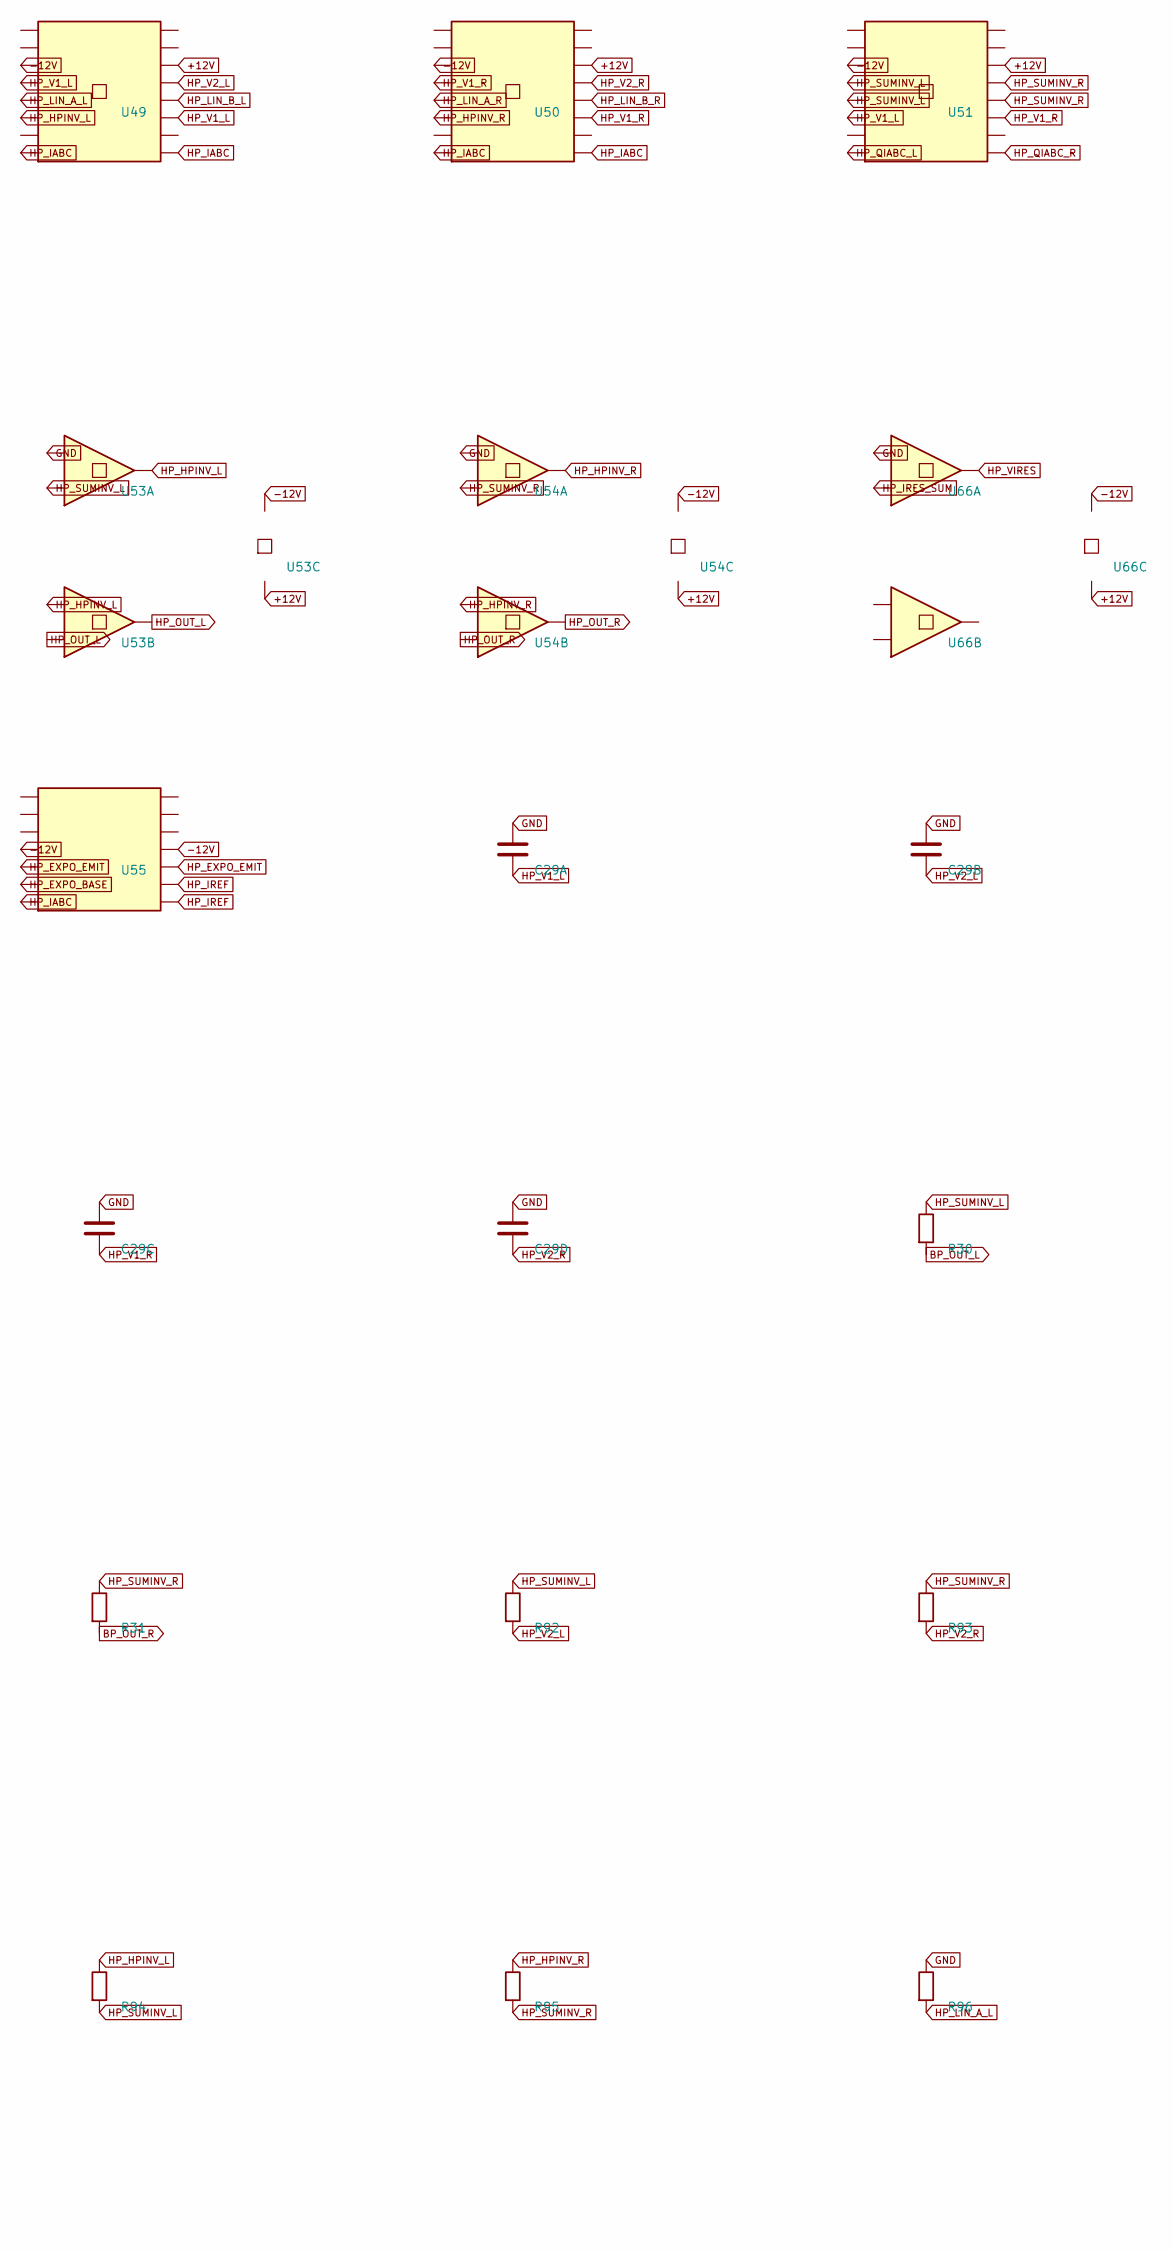
[picture p32: schematic pogo-block-7.kicad_sch, part in row 1, column 1]

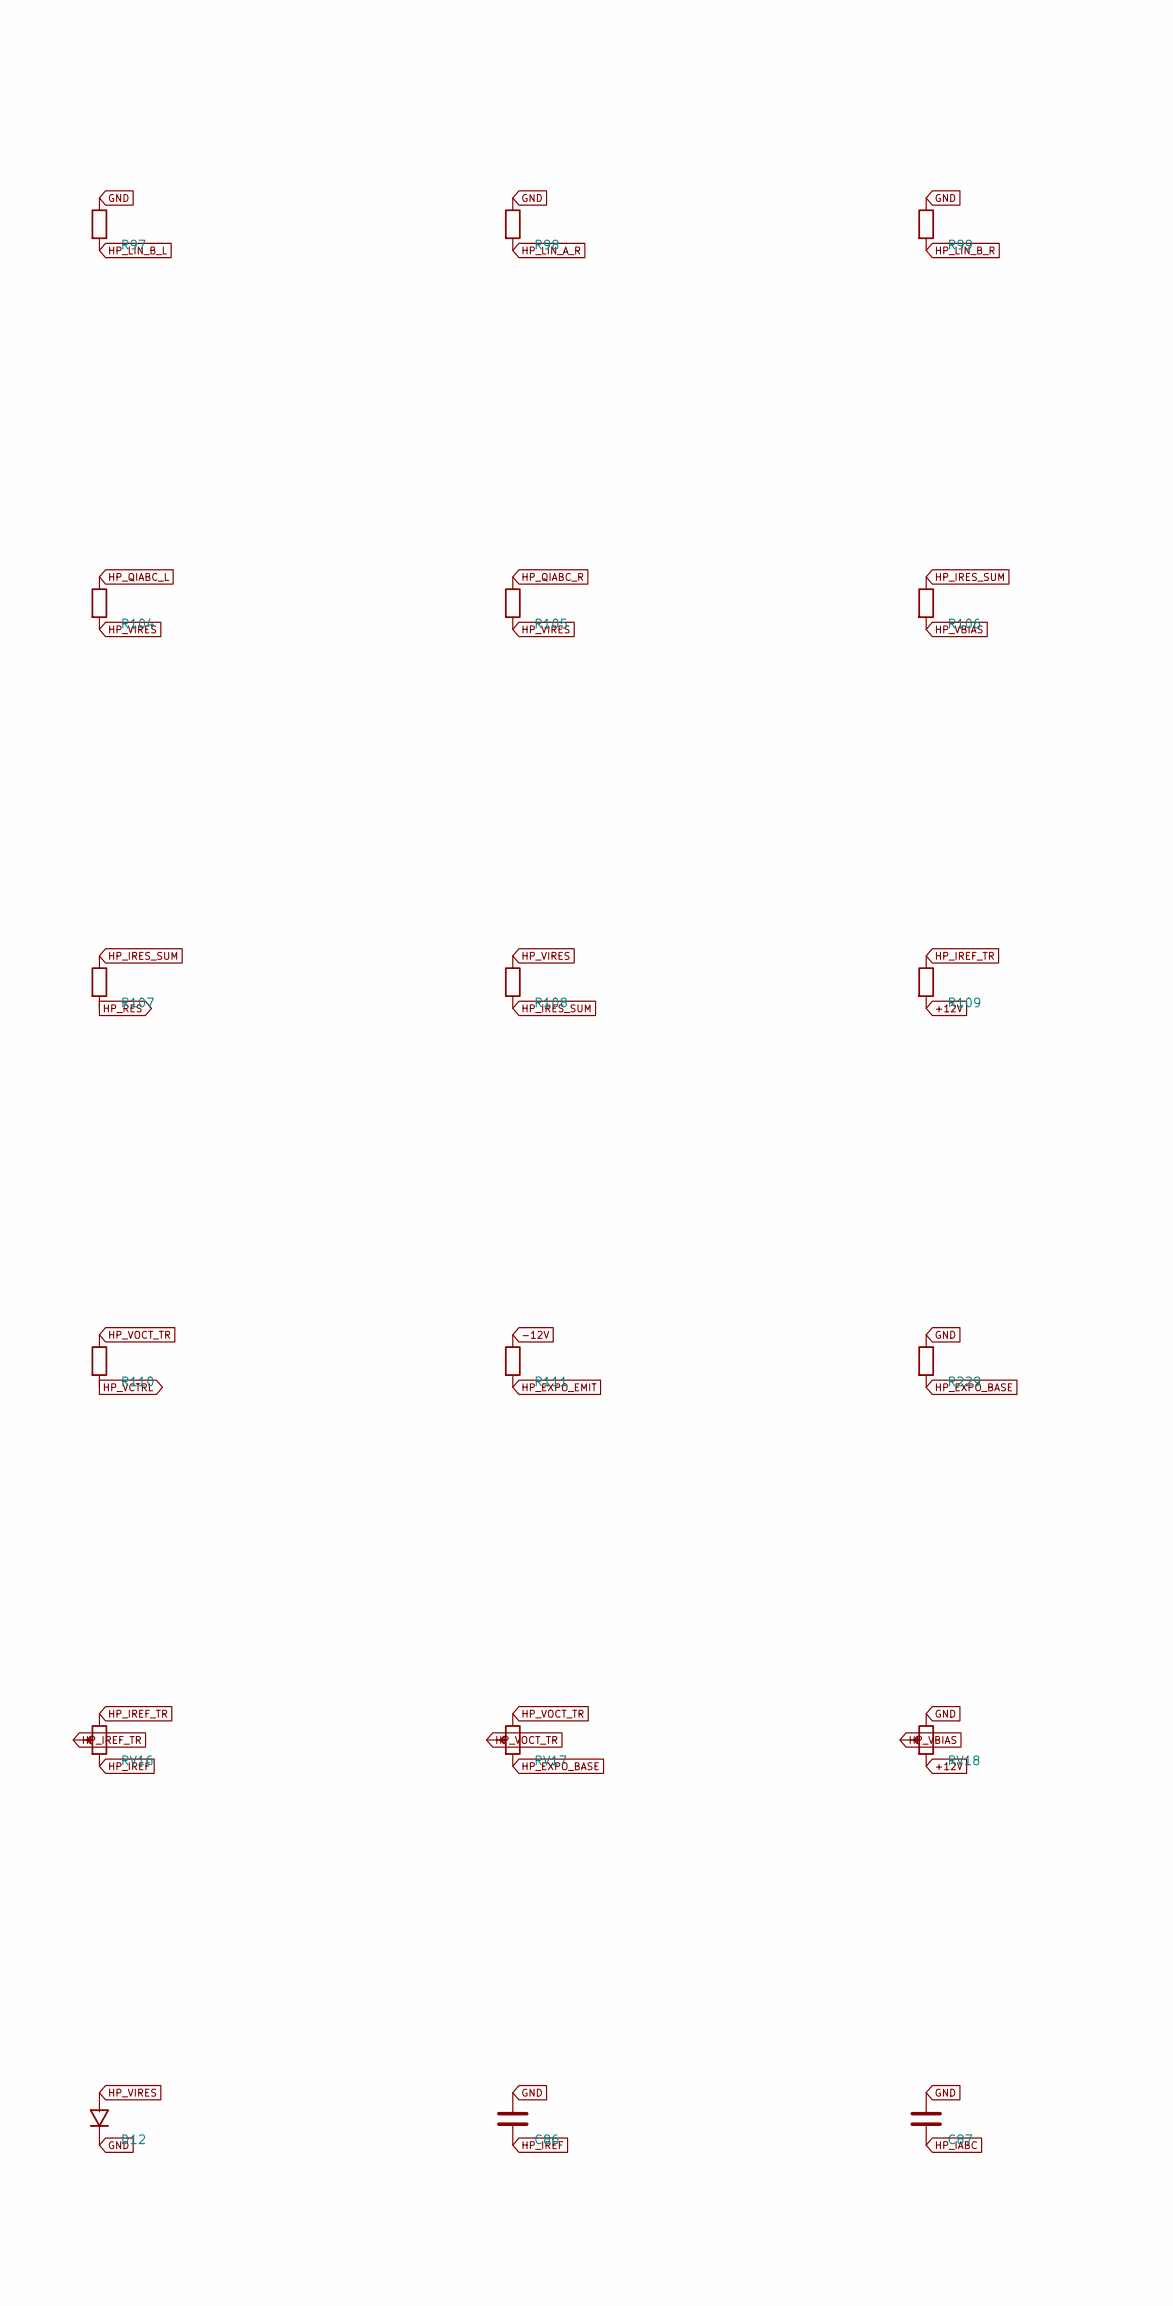
[picture p33: schematic pogo-block-7.kicad_sch, part in row 2, column 1]

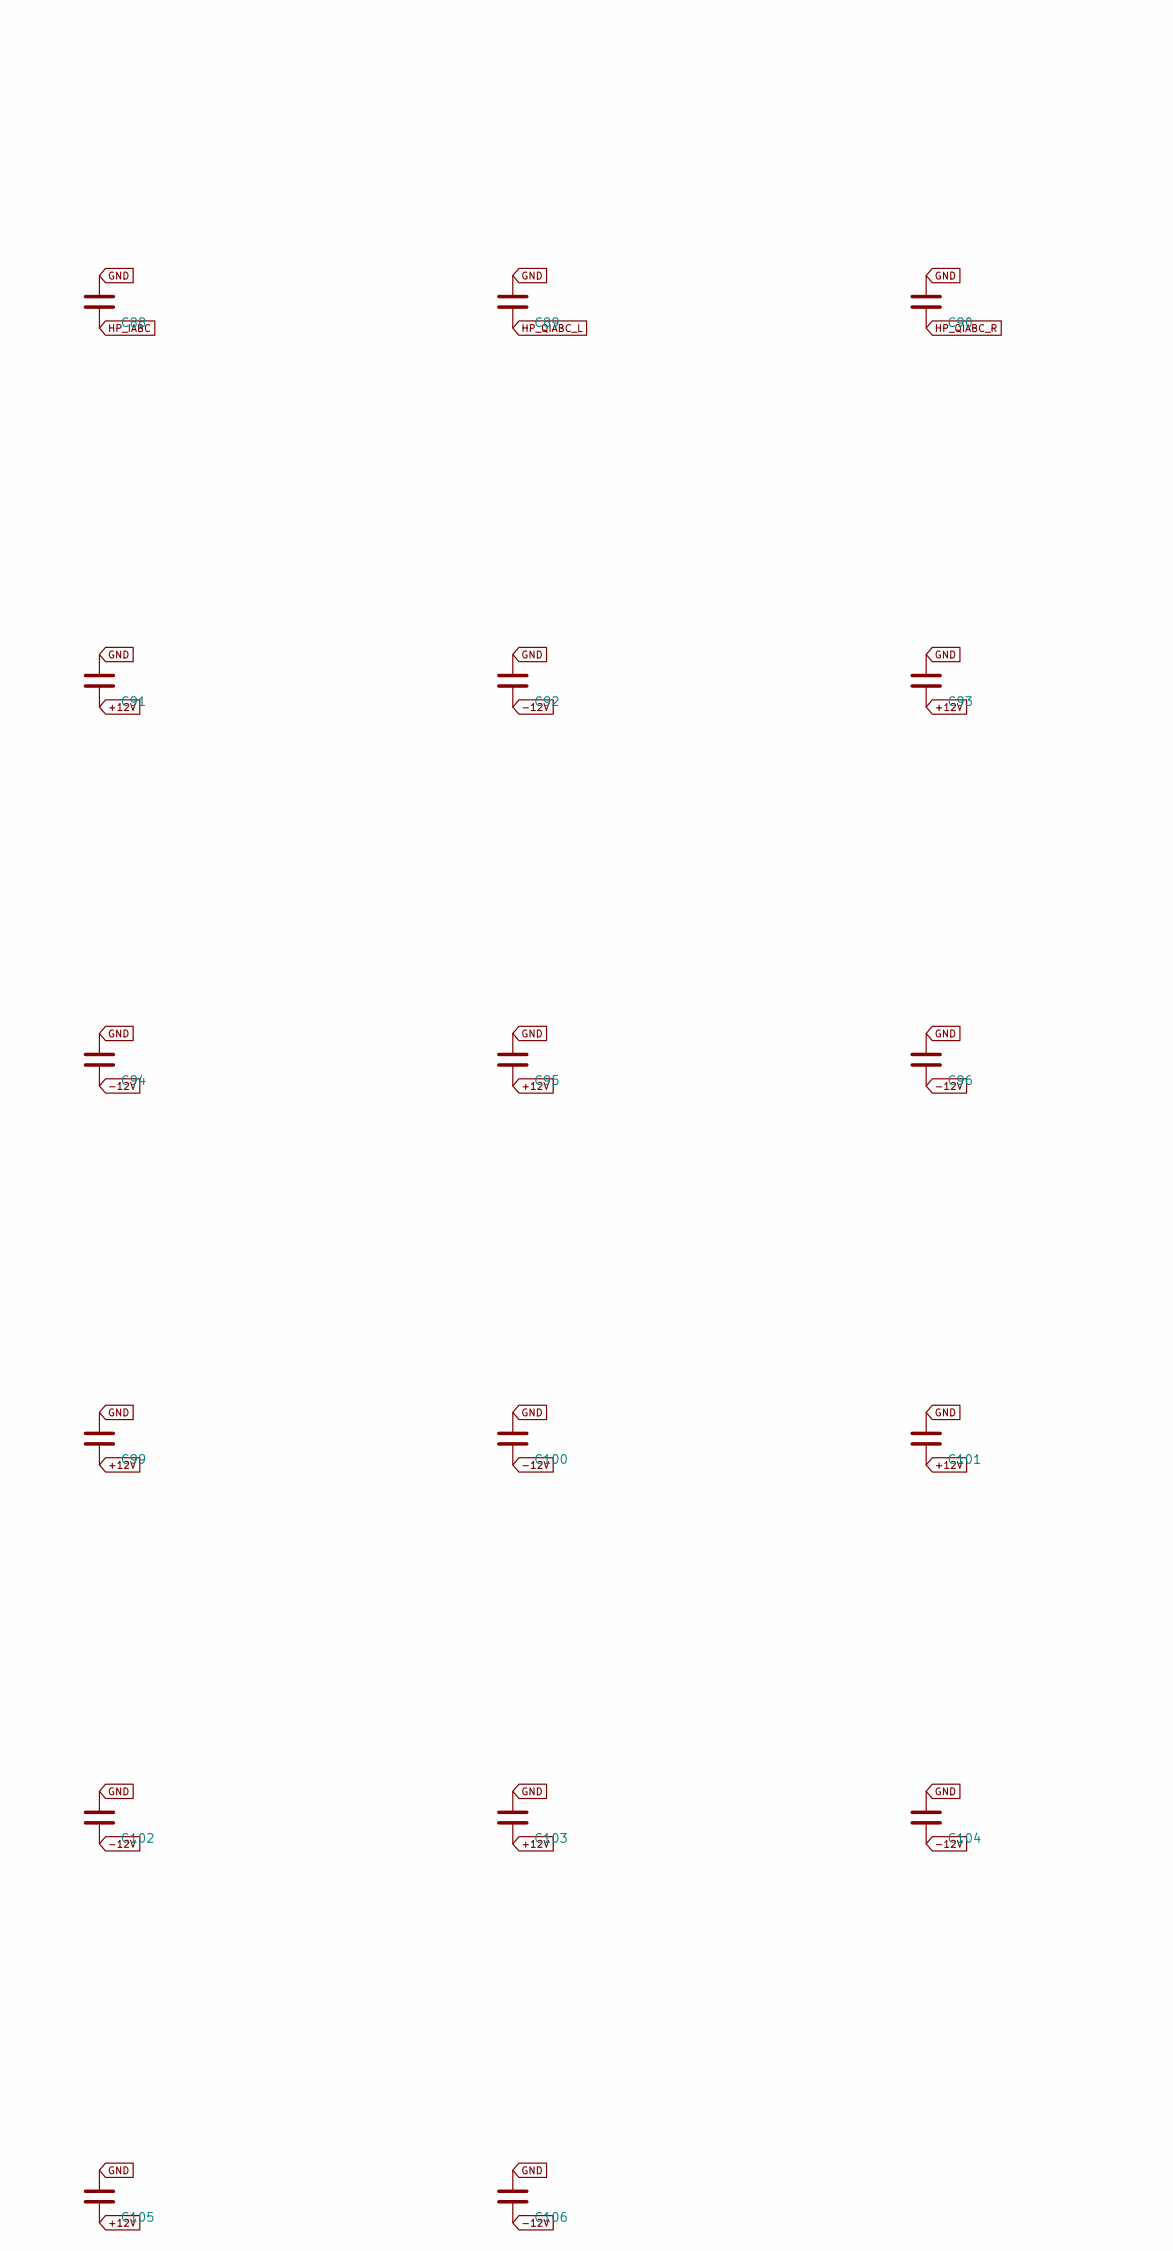
[picture p34: schematic pogo-block-7.kicad_sch, part in row 3, column 1]

Parts:
C29A, C29B, C29C, C29D: 47nF
C86, C91, C92, C93, C94, C95, C96, C99, C100, C101, C102, C103, C104, C105, C106: 100nF
C87, C88, C89, C90: 10nF
D12: 1N4148W; D_SOD-123
R30, R31, R92, R93, R94, R95, R104, R105, R106, R107, R108: 100k
R96, R97, R98, R99, R111: 1k
R109: 1M
R110: 49k9
R229: 1k; R_0805_2012Metric
RV16: HP_FREF; Potentiometer_Bourns_3224W
RV17: HP_1VOCT; Potentiometer_Bourns_3224W
RV18: HP_QMAX; Potentiometer_Bourns_3224W
U49, U50, U51: LM13700; SOIC-16_3.9x9.9mm_P1.27mm
U53, U54: OPA1612; SOIC-8_3.9x4.9mm_P1.27mm
U55: THAT340; SOIC-14_3.9x8.7mm_P1.27mm
U66: TL072; SOIC-8_3.9x4.9mm_P1.27mm

Connections:
+12V: C91.2, C93.2, C95.2, C99.2, C101.2, C103.2, C105.2, R109.2, RV18.1, U49.14 (In+_B), U50.14 (In+_B), U51.14 (In+_B), U53.4 (V-), U54.4 (V-), U66.4 (V-)
-12V: C92.2, C94.2, C96.2, C100.2, C102.2, C104.2, C106.2, R111.1, U49.3 (In+_A), U50.3 (In+_A), U51.3 (In+_A), U53.8 (V+), U54.8 (V+), U55.4 (SUB), U55.11 (SUB), U66.8 (V+)
BP_OUT_L: R30.2
BP_OUT_R: R31.2
GND: C29A.1, C29B.1, C29C.1, C29D.1, C86.1, C87.1, C88.1, C89.1, C90.1, C91.1, C92.1, C93.1, C94.1, C95.1, C96.1, C99.1, C100.1, C101.1, C102.1, C103.1, C104.1, C105.1, C106.1, D12.K, R96.1, R97.1, R98.1, R99.1, R229.1, RV18.3, U53.2 (In-), U54.2 (In-), U66.2 (In-)
HP_EXPO_BASE: R229.2, RV17.1, U55.6 (Q3_B)
HP_EXPO_EMIT: R111.2, U55.5 (Q3_E), U55.10 (Q4_E)
HP_HPINV_L: R94.1, U49.6 (V-), U53.1 (Out), U53.6 (In-)
HP_HPINV_R: R95.1, U50.6 (V-), U54.1 (Out), U54.6 (In-)
HP_IABC: C87.2, C88.2, U49.8 (BufOut_A), U49.9 (BufOut_B), U50.8 (BufOut_A), U50.9 (BufOut_B), U55.7 (Q3_C)
HP_IREF: C86.2, RV16.1, U55.8 (Q4_C), U55.9 (Q4_B)
HP_IREF_TR: R109.1, RV16.2 (Wiper), RV16.3
HP_IRES_SUM: R106.1, R107.1, R108.2, U66.3 (In+)
HP_LIN_A_L: R96.2, U49.5 (Out_A)
HP_LIN_A_R: R98.2, U50.5 (Out_A)
HP_LIN_B_L: R97.2, U49.12 (Out_B)
HP_LIN_B_R: R99.2, U50.12 (Out_B)
HP_OUT_L: U53.5 (In+), U53.7 (Out)
HP_OUT_R: U54.5 (In+), U54.7 (Out)
HP_QIABC_L: C89.2, R104.1, U51.8 (BufOut_A)
HP_QIABC_R: C90.2, R105.1, U51.9 (BufOut_B)
HP_RES: R107.2
HP_SUMINV_L: R30.1, R92.1, R94.2, U51.4 (In-_A), U51.5 (Out_A), U53.3 (In+)
HP_SUMINV_R: R31.1, R93.1, R95.2, U51.12 (Out_B), U51.13 (In-_B), U54.3 (In+)
HP_V1_L: C29A.2, U49.4 (In-_A), U49.11 (V+), U51.6 (V-)
HP_V1_R: C29C.2, U50.4 (In-_A), U50.11 (V+), U51.11 (V+)
HP_V2_L: C29B.2, R92.2, U49.13 (In-_B)
HP_V2_R: C29D.2, R93.2, U50.13 (In-_B)
HP_VBIAS: R106.2, RV18.2 (Wiper)
HP_VCTRL: R110.2
HP_VIRES: D12.A, R104.2, R105.2, R108.1, U66.1 (Out)
HP_VOCT_TR: R110.1, RV17.2 (Wiper), RV17.3
