jeffmhopkins/POGO/kicad/pogo-block-8.kicad_sch

## KiCad design kicad/pogo-block-8.kicad_sch (2026-05-31)

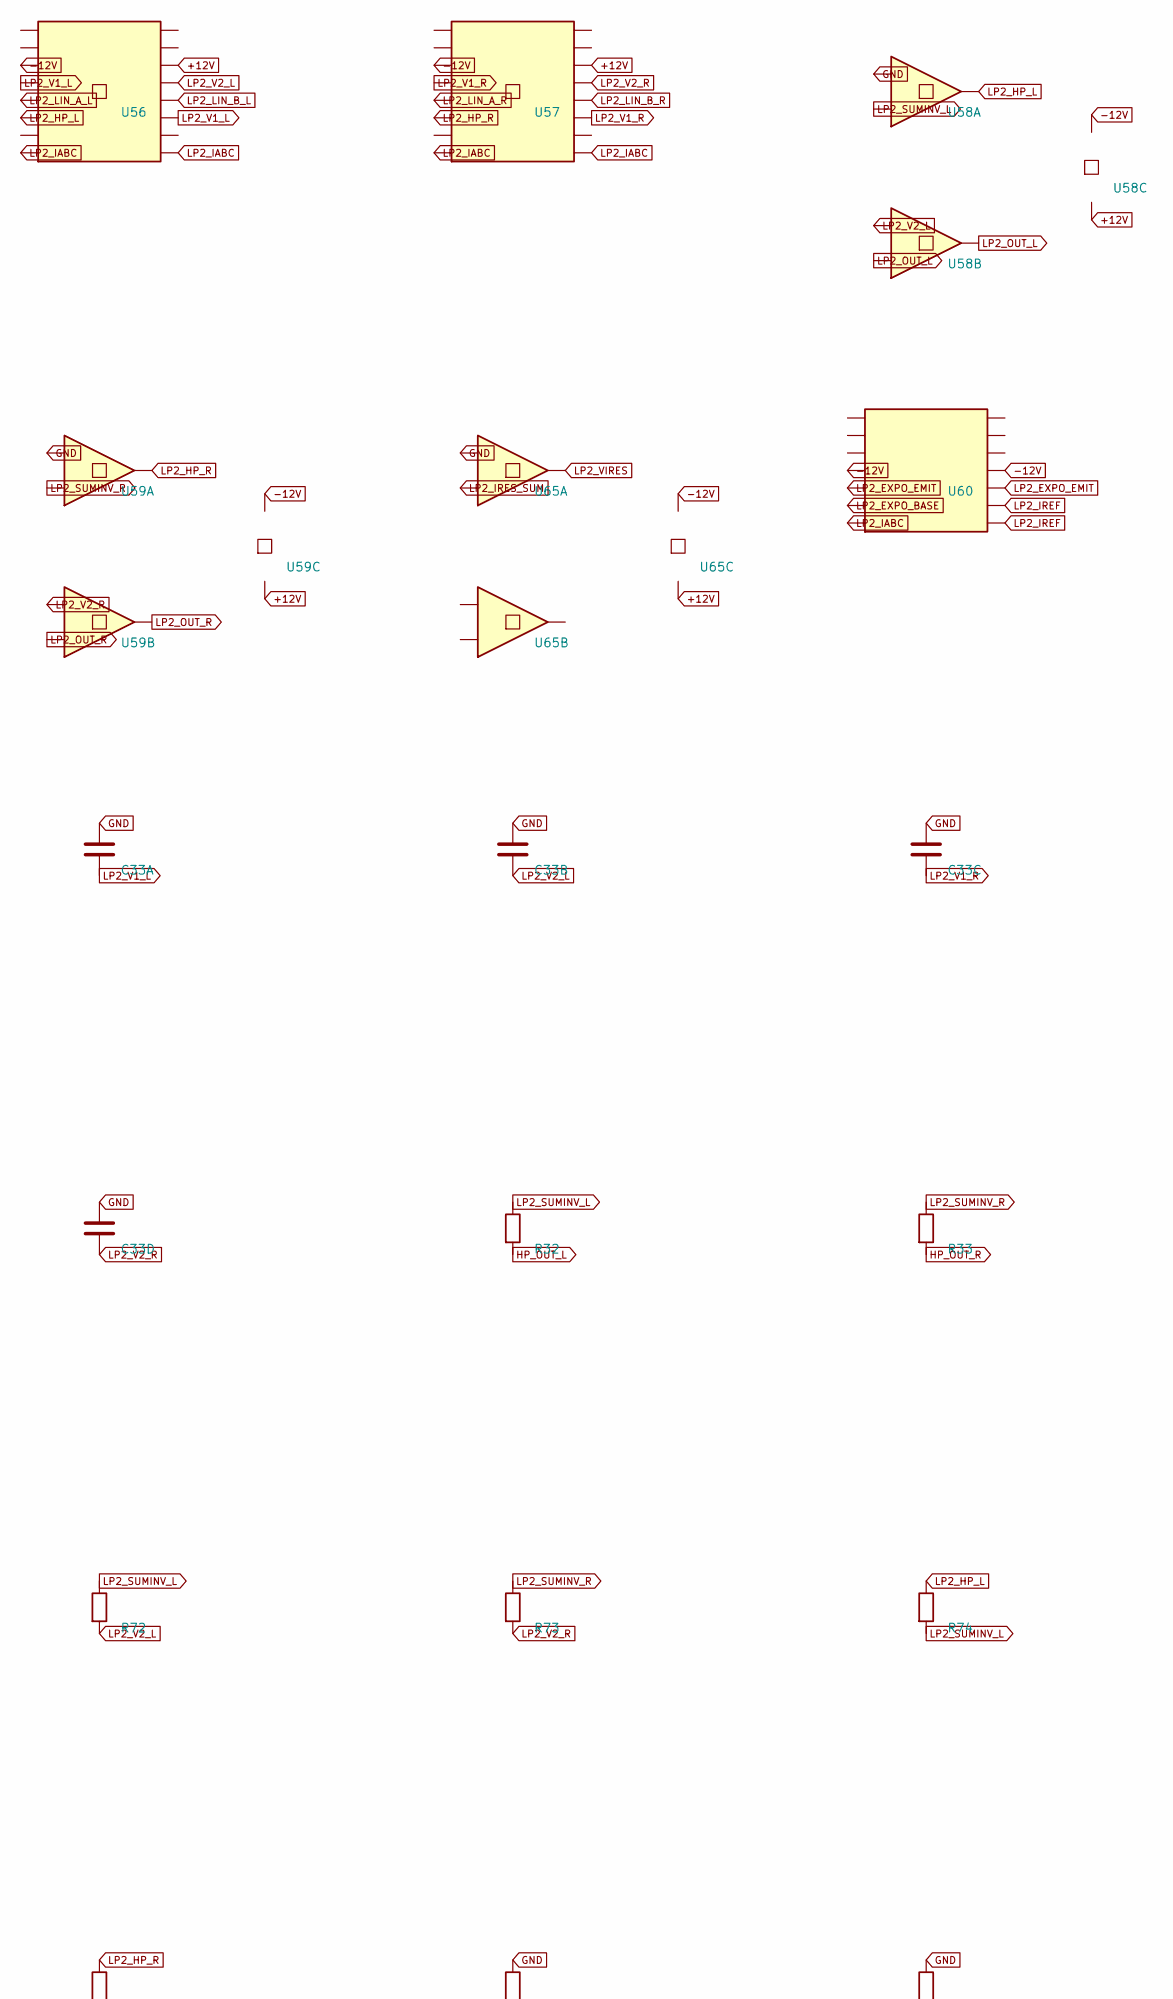
[picture p35: schematic pogo-block-8.kicad_sch, part in row 1, column 1]

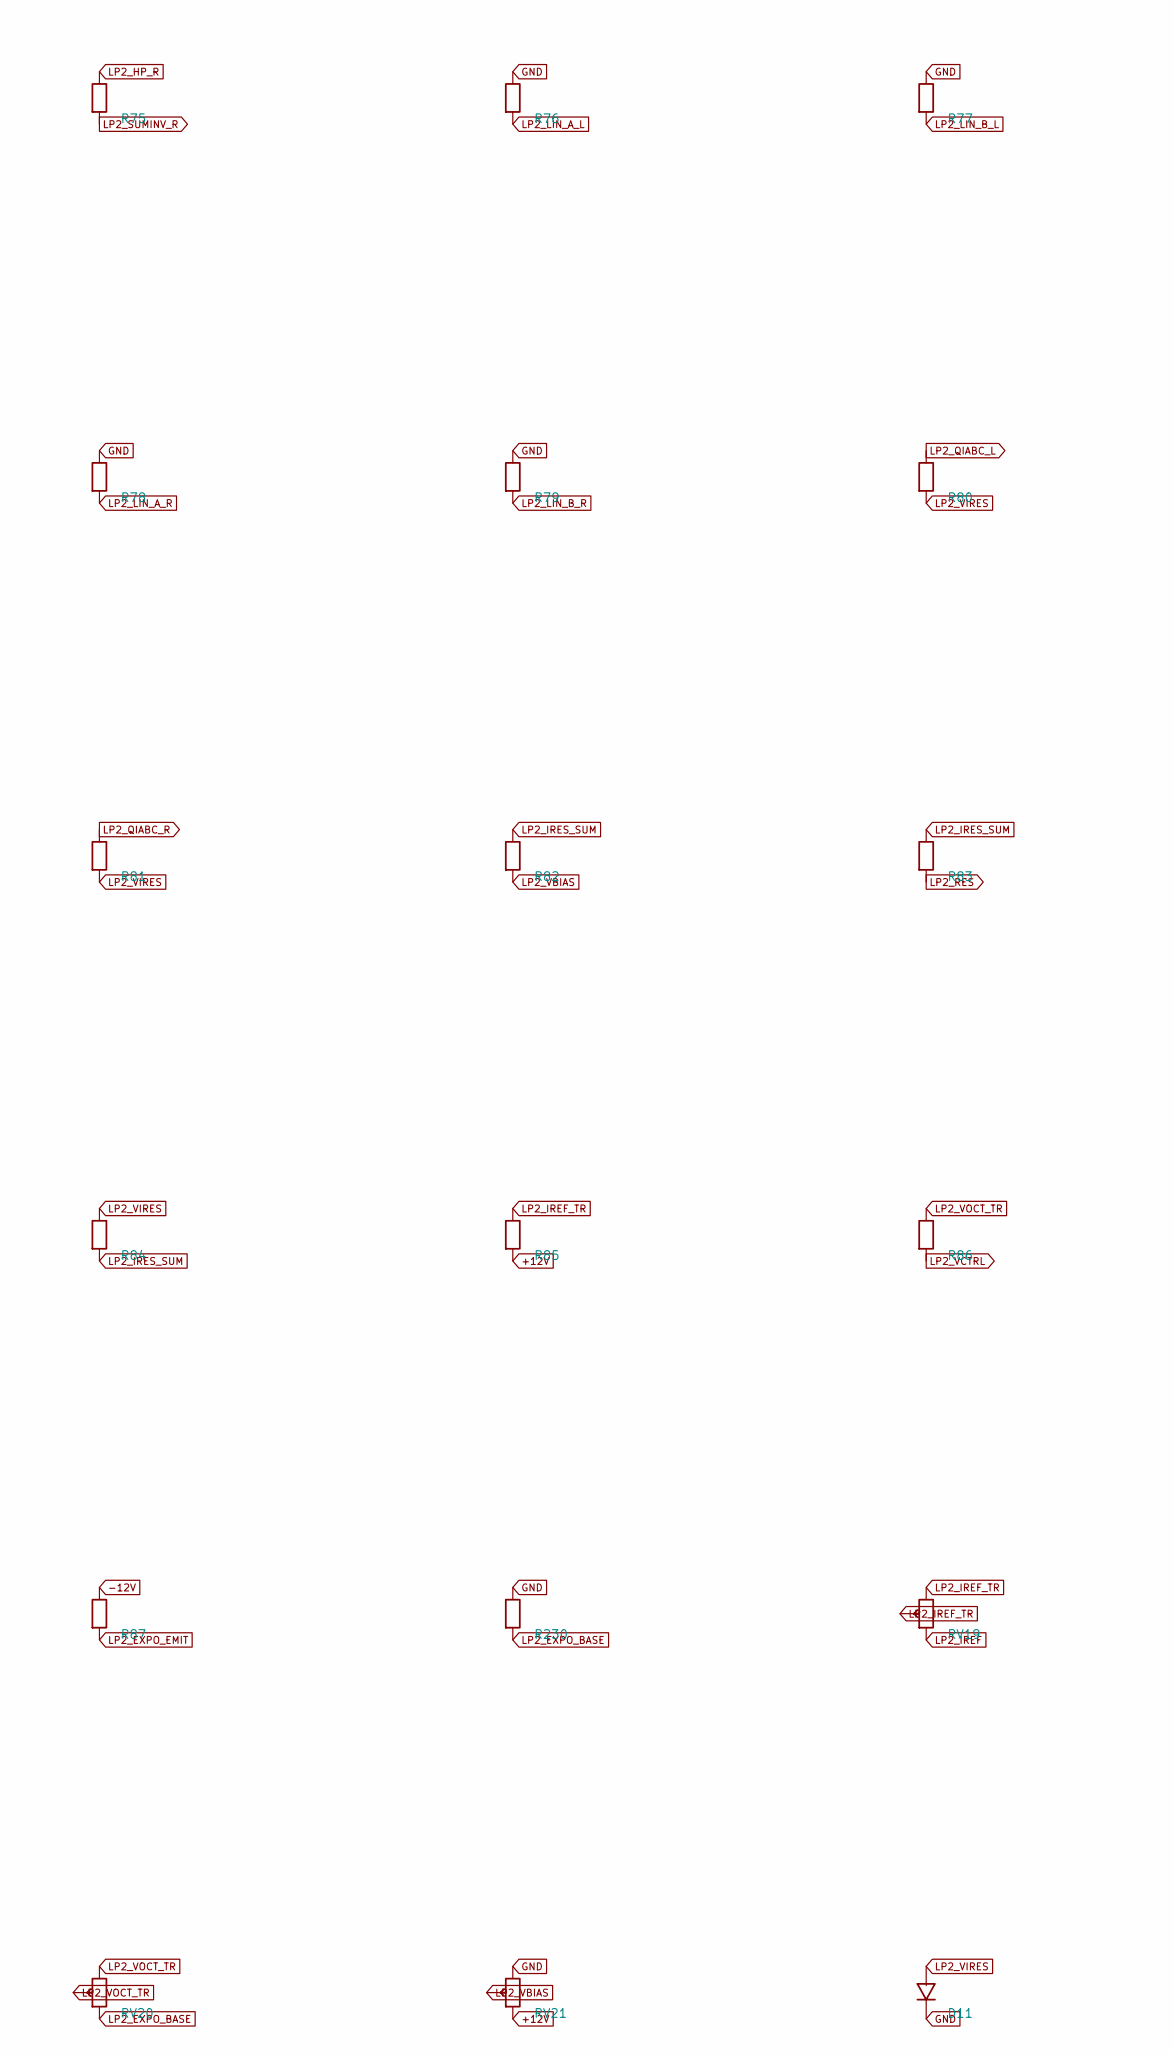
[picture p36: schematic pogo-block-8.kicad_sch, part in row 2, column 1]

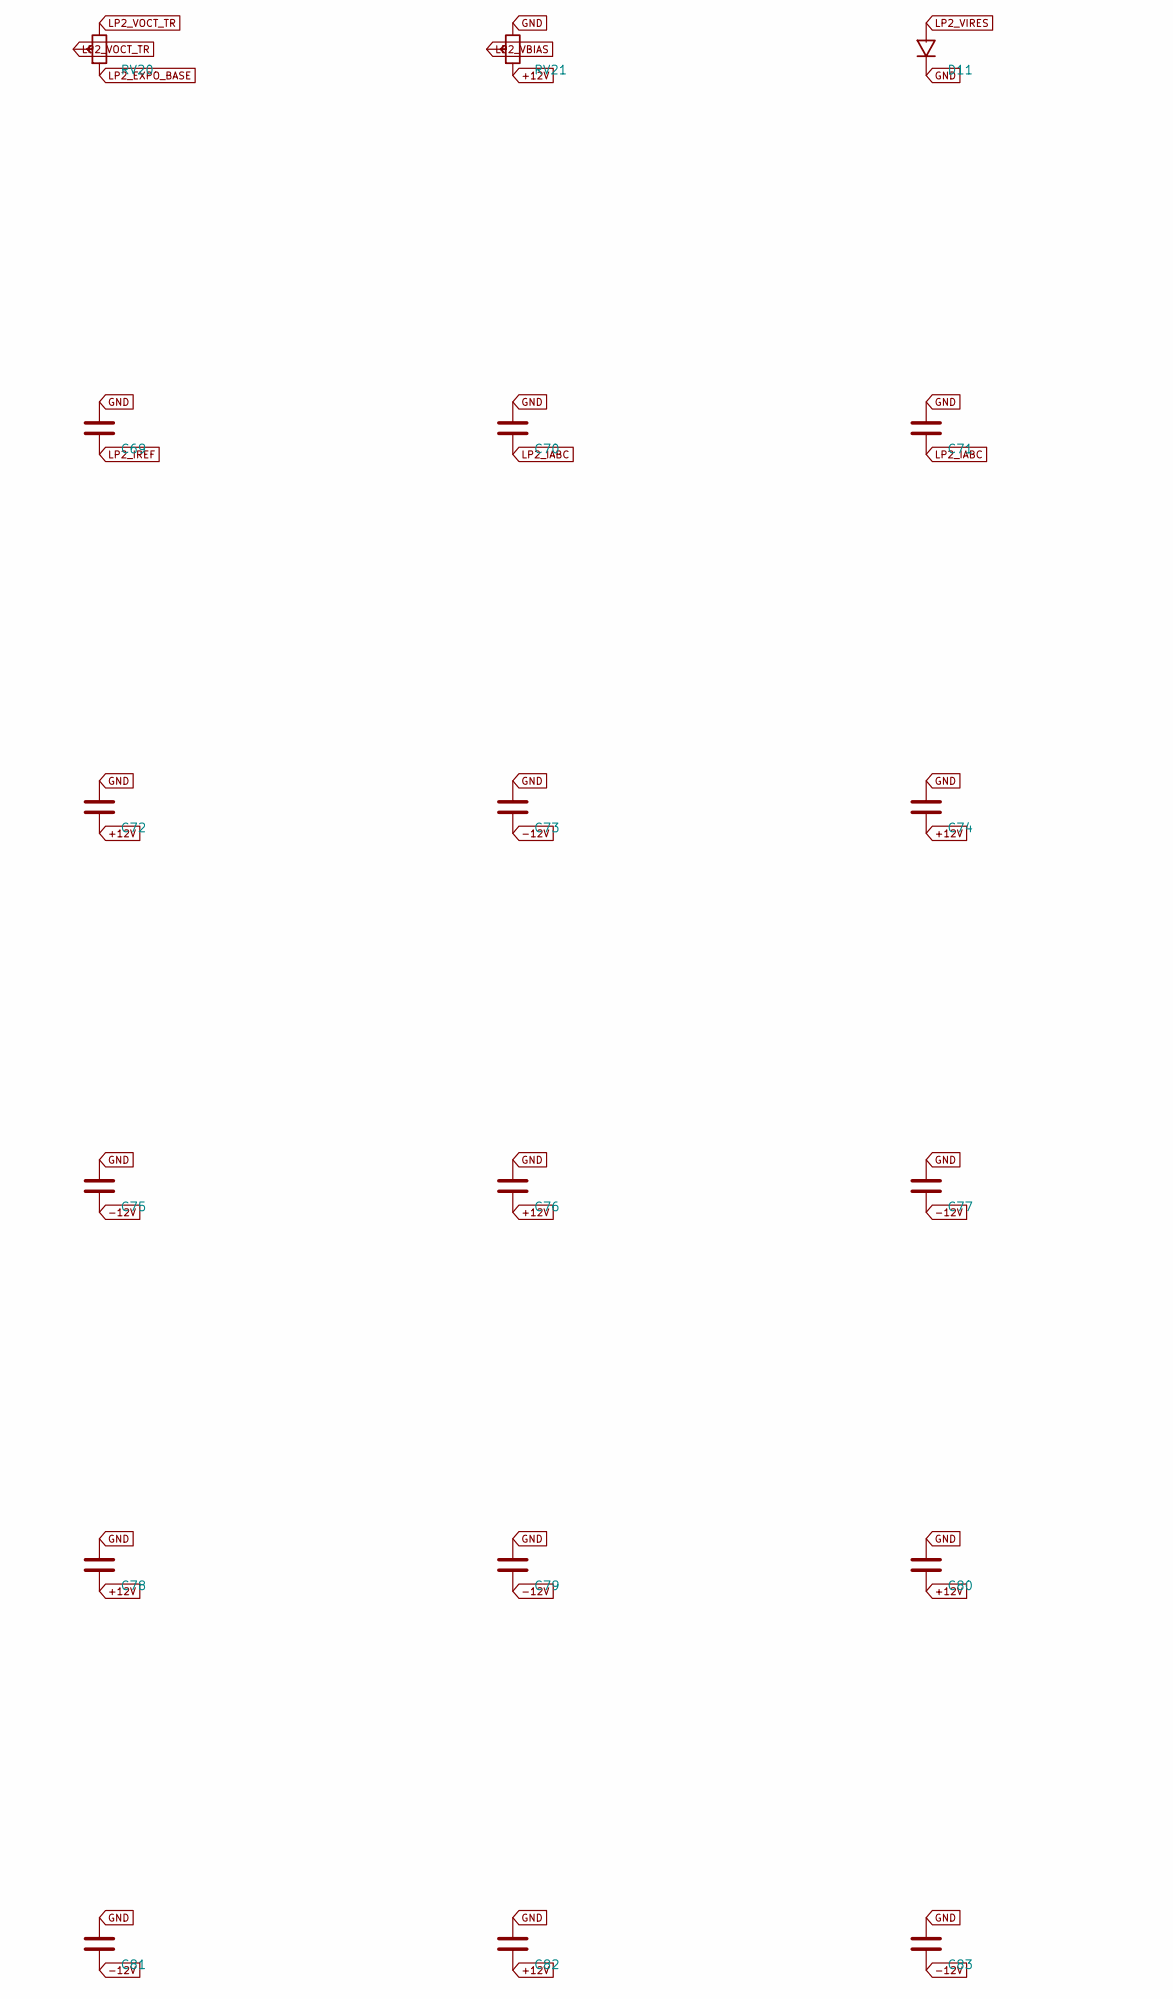
[picture p37: schematic pogo-block-8.kicad_sch, part in row 3, column 1]

Parts:
C33A, C33B, C33C, C33D: 47nF
C69, C72, C73, C74, C75, C76, C77, C78, C79, C80, C81, C82, C83: 100nF
C70, C71: 10nF
D11: 1N4148W; D_SOD-123
R32, R33, R72, R73, R74, R75, R80, R81, R82, R83, R84: 100k
R76, R77, R78, R79, R87: 1k
R85: 1M
R86: 49k9
R230: 1k; R_0805_2012Metric
RV19: LP2_FREF; Potentiometer_Bourns_3224W
RV20: LP2_1VOCT; Potentiometer_Bourns_3224W
RV21: LP2_QMAX; Potentiometer_Bourns_3224W
U56, U57: LM13700; SOIC-16_3.9x9.9mm_P1.27mm
U58, U59: OPA1612; SOIC-8_3.9x4.9mm_P1.27mm
U60: THAT340; SOIC-14_3.9x8.7mm_P1.27mm
U65: TL072; SOIC-8_3.9x4.9mm_P1.27mm

Connections:
+12V: C72.2, C74.2, C76.2, C78.2, C80.2, C82.2, R85.2, RV21.1, U56.14 (In+_B), U57.14 (In+_B), U58.4 (V-), U59.4 (V-), U65.4 (V-)
-12V: C73.2, C75.2, C77.2, C79.2, C81.2, C83.2, R87.1, U56.3 (In+_A), U57.3 (In+_A), U58.8 (V+), U59.8 (V+), U60.4 (SUB), U60.11 (SUB), U65.8 (V+)
GND: C33A.1, C33B.1, C33C.1, C33D.1, C69.1, C70.1, C71.1, C72.1, C73.1, C74.1, C75.1, C76.1, C77.1, C78.1, C79.1, C80.1, C81.1, C82.1, C83.1, D11.K, R76.1, R77.1, R78.1, R79.1, R230.1, RV21.3, U58.2 (In-), U59.2 (In-), U65.2 (In-)
HP_OUT_L: R32.2
HP_OUT_R: R33.2
LP2_EXPO_BASE: R230.2, RV20.1, U60.6 (Q3_B)
LP2_EXPO_EMIT: R87.2, U60.5 (Q3_E), U60.10 (Q4_E)
LP2_HP_L: R74.1, U56.6 (V-), U58.1 (Out)
LP2_HP_R: R75.1, U57.6 (V-), U59.1 (Out)
LP2_IABC: C70.2, C71.2, U56.8 (BufOut_A), U56.9 (BufOut_B), U57.8 (BufOut_A), U57.9 (BufOut_B), U60.7 (Q3_C)
LP2_IREF: C69.2, RV19.1, U60.8 (Q4_C), U60.9 (Q4_B)
LP2_IREF_TR: R85.1, RV19.2 (Wiper), RV19.3
LP2_IRES_SUM: R82.1, R83.1, R84.2, U65.3 (In+)
LP2_LIN_A_L: R76.2, U56.5 (Out_A)
LP2_LIN_A_R: R78.2, U57.5 (Out_A)
LP2_LIN_B_L: R77.2, U56.12 (Out_B)
LP2_LIN_B_R: R79.2, U57.12 (Out_B)
LP2_OUT_L: U58.5 (In+), U58.7 (Out)
LP2_OUT_R: U59.5 (In+), U59.7 (Out)
LP2_QIABC_L: R80.1
LP2_QIABC_R: R81.1
LP2_RES: R83.2
LP2_SUMINV_L: R32.1, R72.1, R74.2, U58.3 (In+)
LP2_SUMINV_R: R33.1, R73.1, R75.2, U59.3 (In+)
LP2_V1_L: C33A.2, U56.4 (In-_A), U56.11 (V+)
LP2_V1_R: C33C.2, U57.4 (In-_A), U57.11 (V+)
LP2_V2_L: C33B.2, R72.2, U56.13 (In-_B), U58.6 (In-)
LP2_V2_R: C33D.2, R73.2, U57.13 (In-_B), U59.6 (In-)
LP2_VBIAS: R82.2, RV21.2 (Wiper)
LP2_VCTRL: R86.2
LP2_VIRES: D11.A, R80.2, R81.2, R84.1, U65.1 (Out)
LP2_VOCT_TR: R86.1, RV20.2 (Wiper), RV20.3
