jeffmhopkins/POGO/kicad/pogo-block-A.kicad_sch

## KiCad design kicad/pogo-block-A.kicad_sch (2026-05-31)

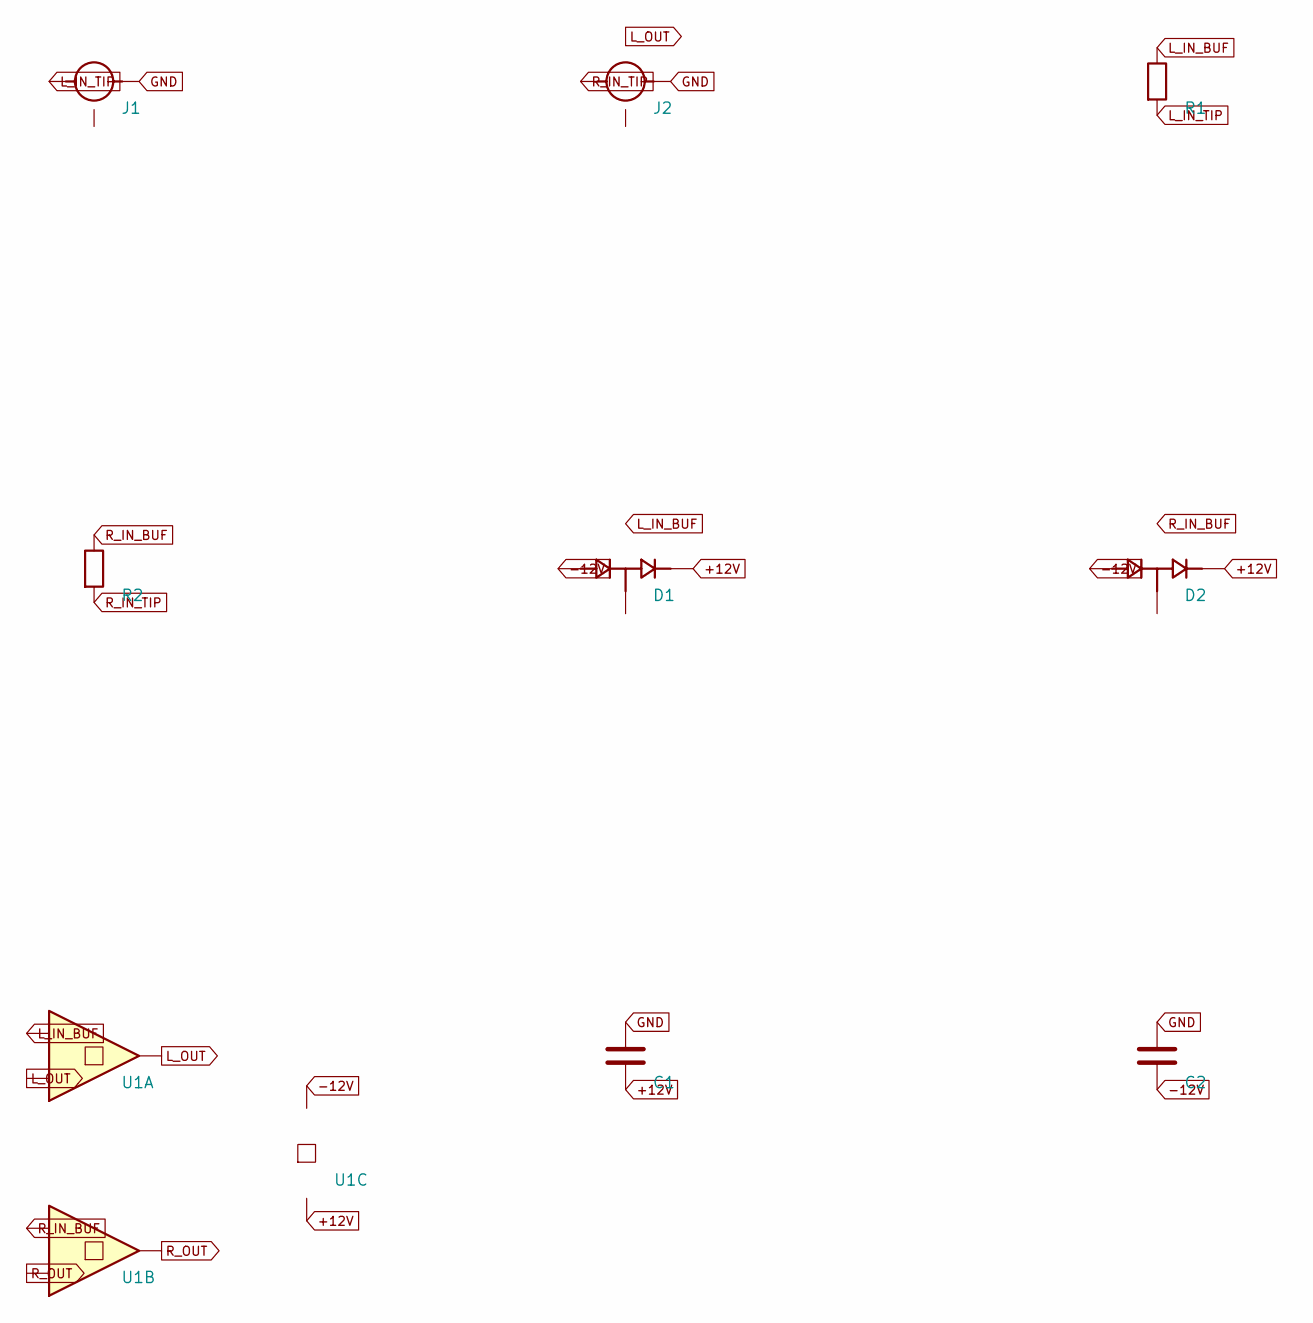
[picture p38: schematic pogo-block-A.kicad_sch]

Parts:
C1, C2: 100nF
D1, D2: BAT54S; SOT-23
J1: L_IN; Jack_3.5mm_QingPu_WQP-PJ398SM_Vertical_CircularHoles
J2: R_IN; Jack_3.5mm_QingPu_WQP-PJ398SM_Vertical_CircularHoles
R1, R2: 100R
U1: OPA1612; SOIC-8_3.9x4.9mm_P1.27mm

Connections:
+12V: C1.2, D1.2 (K2), D2.2 (K2), U1.4 (V-)
-12V: C2.2, D1.1 (A1), D2.1 (A1), U1.8 (V+)
GND: C1.1, C2.1, J1.2 (S), J2.2 (S)
L_IN_BUF: R1.1, U1.2 (In-)
L_IN_TIP: J1.1 (T), R1.2
L_OUT: U1.1 (Out), U1.3 (In+)
R_IN_BUF: R2.1, U1.6 (In-)
R_IN_TIP: J2.1 (T), R2.2
R_OUT: U1.5 (In+), U1.7 (Out)
