jeffmhopkins/POGO/kicad/pogo-block-B.kicad_sch

## KiCad design kicad/pogo-block-B.kicad_sch (2026-05-31)

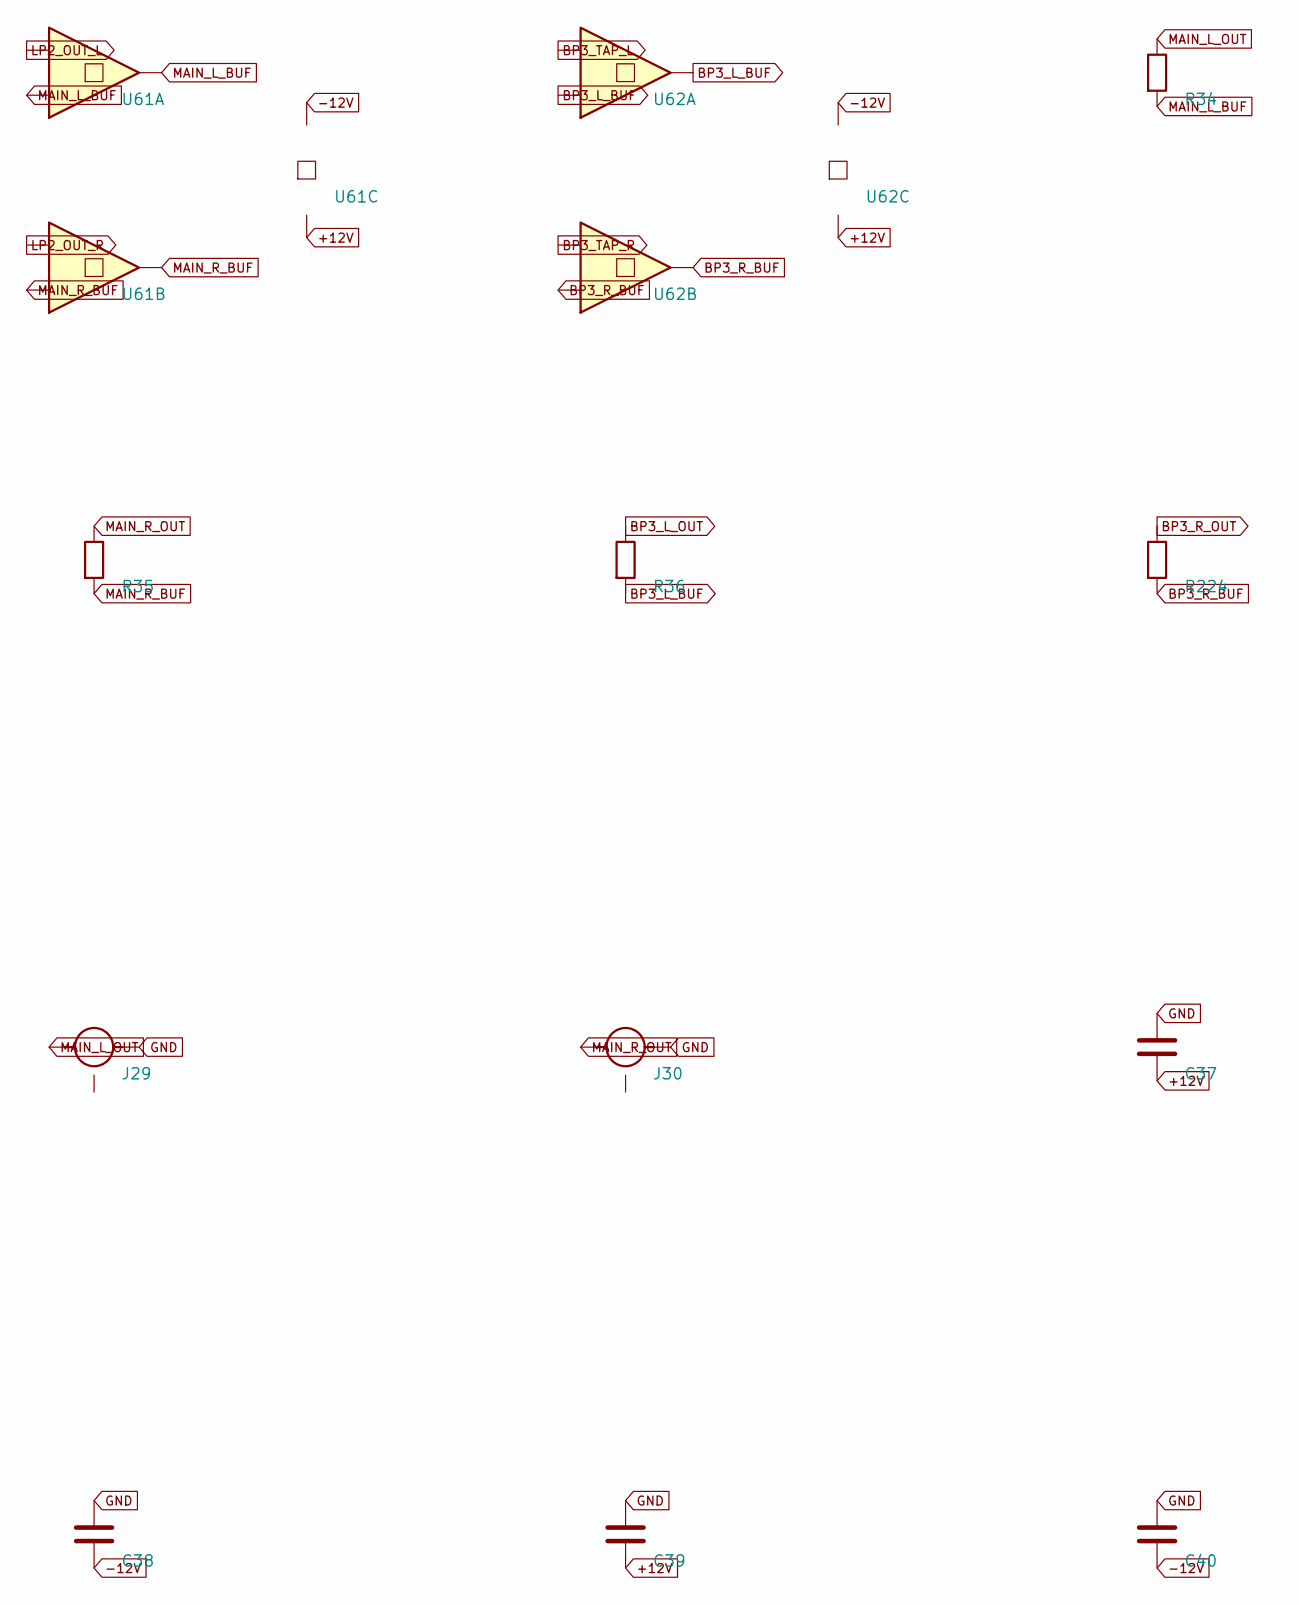
[picture p39: schematic pogo-block-B.kicad_sch]

Parts:
C37, C38, C39, C40: 100nF
J29: MAIN_L; Jack_3.5mm_QingPu_WQP-PJ398SM_Vertical_CircularHoles
J30: MAIN_R; Jack_3.5mm_QingPu_WQP-PJ398SM_Vertical_CircularHoles
R34, R35, R36, R224: 1k
U61, U62: TL072; SOIC-8_3.9x4.9mm_P1.27mm

Connections:
+12V: C37.2, C39.2, U61.4 (V-), U62.4 (V-)
-12V: C38.2, C40.2, U61.8 (V+), U62.8 (V+)
BP3_L_BUF: R36.2, U62.1 (Out), U62.3 (In+)
BP3_L_OUT: R36.1
BP3_R_BUF: R224.2, U62.5 (In+), U62.7 (Out)
BP3_R_OUT: R224.1
BP3_TAP_L: U62.2 (In-)
BP3_TAP_R: U62.6 (In-)
GND: C37.1, C38.1, C39.1, C40.1, J29.2 (S), J30.2 (S)
LP2_OUT_L: U61.2 (In-)
LP2_OUT_R: U61.6 (In-)
MAIN_L_BUF: R34.2, U61.1 (Out), U61.3 (In+)
MAIN_L_OUT: J29.1 (T), R34.1
MAIN_R_BUF: R35.2, U61.5 (In+), U61.7 (Out)
MAIN_R_OUT: J30.1 (T), R35.1
