jeffmhopkins/POGO/specs/block-6-dist3/block-6-dist3.nets.yaml

# POGO block-6-dist3 — split from block-6.nets.yaml (behavior-preserving 7-way partition)
# Auto-split: parts/nets identical to the block-6 monolith; cross-section wires are boundary nets.

block: block-6-dist3
board: audio
title: POGO Block 6 DIST3 - BP3 SC/HC/WF + CD4053 mux

parts:
  U33: { sym: cd4053, part: CD4053, value: CD4053 }
  C110_U33p: { sym: c, value: 100nF }
  C110_U33n: { sym: c, value: 100nF }
  U38: { sym: opamp2, part: TL072CDT, value: TL072 }
  C110_U38p: { sym: c, value: 100nF }
  C110_U38n: { sym: c, value: 100nF }
  U39: { sym: opamp2, part: TL072CDT, value: TL072 }
  C110_U39p: { sym: c, value: 100nF }
  C110_U39n: { sym: c, value: 100nF }
  U44: { sym: opamp2, part: TL072CDT, value: TL072 }
  C110_U44p: { sym: c, value: 100nF }
  C110_U44n: { sym: c, value: 100nF }
  U45: { sym: opamp2, part: TL072CDT, value: TL072 }
  C110_U45p: { sym: c, value: 100nF }
  C110_U45n: { sym: c, value: 100nF }
  U77: { sym: cd4053, part: CD4053, value: CD4053 }
  C110_U77p: { sym: c, value: 100nF }
  C110_U77n: { sym: c, value: 100nF }
  R18_3L: { sym: r, value: 10k }
  R19_3L: { sym: r, value: 10k }
  R20_3L: { sym: r, value: 10k }
  R21_3L: { sym: r, value: 10k }
  R22_3L: { sym: r, value: 10k }
  R23_3L: { sym: r, value: 10k }
  R24_3L: { sym: r, value: 10k }
  R25_3L: { sym: r, value: 10k }
  R_f_wf_3L: { sym: r, value: 10k }
  C_WF_3La: { sym: c, value: 47pF }
  C_WF_3Lb: { sym: c, value: 47pF }
  D4_3La: { sym: diode, part: 1N4148W, value: 1N4148W }
  D6_3La: { sym: diode, part: 1N4148W, value: 1N4148W }
  D4_3Lb: { sym: diode, part: 1N4148W, value: 1N4148W }
  D6_3Lb: { sym: diode, part: 1N4148W, value: 1N4148W }
  D4_3Lc: { sym: diode, part: 1N4148W, value: 1N4148W }
  D6_3Lc: { sym: diode, part: 1N4148W, value: 1N4148W }
  D4_3Ld: { sym: diode, part: 1N4148W, value: 1N4148W }
  D6_3Ld: { sym: diode, part: 1N4148W, value: 1N4148W }
  D5_3La: { sym: zener, part: BZX84C5V1, value: BZX84C5V1 }
  D5_3Lb: { sym: zener, part: BZX84C5V1, value: BZX84C5V1 }
  R18_3R: { sym: r, value: 10k }
  R19_3R: { sym: r, value: 10k }
  R20_3R: { sym: r, value: 10k }
  R21_3R: { sym: r, value: 10k }
  R22_3R: { sym: r, value: 10k }
  R23_3R: { sym: r, value: 10k }
  R24_3R: { sym: r, value: 10k }
  R25_3R: { sym: r, value: 10k }
  R_f_wf_3R: { sym: r, value: 10k }
  C_WF_3Ra: { sym: c, value: 47pF }
  C_WF_3Rb: { sym: c, value: 47pF }
  D4_3Ra: { sym: diode, part: 1N4148W, value: 1N4148W }
  D6_3Ra: { sym: diode, part: 1N4148W, value: 1N4148W }
  D4_3Rb: { sym: diode, part: 1N4148W, value: 1N4148W }
  D6_3Rb: { sym: diode, part: 1N4148W, value: 1N4148W }
  D4_3Rc: { sym: diode, part: 1N4148W, value: 1N4148W }
  D6_3Rc: { sym: diode, part: 1N4148W, value: 1N4148W }
  D4_3Rd: { sym: diode, part: 1N4148W, value: 1N4148W }
  D6_3Rd: { sym: diode, part: 1N4148W, value: 1N4148W }
  D5_3Ra: { sym: zener, part: BZX84C5V1, value: BZX84C5V1 }
  D5_3Rb: { sym: zener, part: BZX84C5V1, value: BZX84C5V1 }
  R128_3sc: { sym: r, value: 100k }
  R128_3wf: { sym: r, value: 100k }
  # BP3 input selector: CD4053 picks ALT-VCA vs LP1 per channel — X/L gated by ALT_L_DET (pin11/A),
  # Y/R gated independently by ALT_R_DET (pin10/B) (change 0020: ALT L/R fully independent)
  U81: { sym: cd4053, part: CD4053, value: CD4053 }   # BP3 sel: X=L, Y=R (Z spare)
  C110_U81p: { sym: c, value: 100nF }
  C110_U81n: { sym: c, value: 100nF }
  R133: { sym: r, value: 100k }                        # ALT_L_DET pull-up to +12V (X/L select HIGH when patched)
  R226: { sym: r, value: 100k }                        # ALT_R_DET pull-up to +12V (Y/R select; change 0020, mirrors R133)
  # ---- DRIVE VCA cell (mirrors block-4 THAT2180; see block-6-dist1 for prose) ----
  U89: { sym: vca, part: THAT2180, value: THAT2180 }   # BP3 DRIVE VCA L
  U90: { sym: vca, part: THAT2180, value: THAT2180 }   # BP3 DRIVE VCA R
  U93: { sym: opamp4, part: TL074CDT, value: TL074 }    # A=L I/V, B=R I/V, C=drive summer, D=spare unity buf
  R169: { sym: r, value: 20k }    # R_in L
  R170: { sym: r, value: 20k }    # R_in R
  R171: { sym: r, value: 20k }    # R_f L (I/V)
  R172: { sym: r, value: 20k }    # R_f R (I/V)
  R173: { sym: r, value: 100k }   # drive summer: DRIVE-knob input  (Phase-3R: knob->Ec+ dB scale)
  R174: { sym: r, value: 100k }   # drive summer: DRIVE-CV input (MOD_BP3_DIST)
  R175: { sym: r, value: 100k }   # drive summer: bias input (knob=0.20 ~ 0 dB unity; Phase-3R)
  R176: { sym: r, value: 100k }   # drive summer: feedback
  RV55: { sym: trimpot, part: "Bourns 3224W", value: BP3_DRIVE_UNITY_L }  # Ec+ L unity trim (HIGH-3 injection divider)
  RV56: { sym: trimpot, part: "Bourns 3224W", value: BP3_DRIVE_UNITY_R }  # Ec+ R unity trim
  # HIGH-3 (change 0020): Ec+ voltage-injection trim (mirrors dist1). See dist1 for prose.
  R255: { sym: r, value: 22k6 }   # ±ref divider +12V→REF_P3
  R256: { sym: r, value: 22k6 }   # ±ref divider -12V→REF_N3
  R257: { sym: r, value: 10k }    # R_ec L (V_DRIVE_CTRL_3→EC_BP3_DRIVE_L)
  R258: { sym: r, value: 10k }    # R_ec R
  R259: { sym: r, value: 1M }     # R_inj L (RV55 wiper→EC_BP3_DRIVE_L)
  R260: { sym: r, value: 1M }     # R_inj R (RV56 wiper→EC_BP3_DRIVE_R)
  RV39: { sym: trimpot, part: "knob", value: BP3_DIST }   # DRIVE knob (control board; existing ref)
  C110_U89p: { sym: c, value: 100nF }
  C110_U89n: { sym: c, value: 100nF }
  C110_U90p: { sym: c, value: 100nF }
  C110_U90n: { sym: c, value: 100nF }
  C110_U93p: { sym: c, value: 100nF }
  C110_U93n: { sym: c, value: 100nF }
  # ---- CLIP detector (change 0018, Stage 6): same cell as dist1, shared VREF_P4/N4 (boundary in) ----
  U96: { sym: opamp4, part: TL074CDT, value: TL074 }    # BP3 CLIP comparators
  C110_U96p: { sym: c, value: 100nF }
  C110_U96n: { sym: c, value: 100nF }
  R203: { sym: r, value: 100k }   # comp A in (DISTOUT_L -> in+)
  R204: { sym: r, value: 100k }   # comp B in (DISTOUT_L -> in-)
  R205: { sym: r, value: 100k }   # comp C in (DISTOUT_R -> in+)
  R206: { sym: r, value: 100k }   # comp D in (DISTOUT_R -> in-)
  R207: { sym: r, value: 2.2M }   # comp A hysteresis fb
  R208: { sym: r, value: 2.2M }   # comp B hysteresis fb
  R209: { sym: r, value: 2.2M }   # comp C hysteresis fb
  R210: { sym: r, value: 2.2M }   # comp D hysteresis fb
  R211: { sym: r, value: 1k }     # CLIP LED current-limit
  R212: { sym: r, value: 100k }   # comp B VREF_N4 series into in+
  R213: { sym: r, value: 100k }   # comp D VREF_N4 series into in+
  D16_3a: { sym: diode, part: 1N4148W, value: 1N4148W }
  D16_3b: { sym: diode, part: 1N4148W, value: 1N4148W }
  D16_3c: { sym: diode, part: 1N4148W, value: 1N4148W }
  D16_3d: { sym: diode, part: 1N4148W, value: 1N4148W }
  BP3_CLIP_LED: { sym: led, part: "LED 3mm", value: BP3_CLIP }

nets:
  V5LOGIC: [R128_3sc.1, R128_3wf.1, R175.1, RV39.3]
  # BP3 input = selector mux output (U81); now feeds ONLY the DRIVE VCA R_in
  BP3IN_L: [U81.14, R169.1]   # CD4053 X out -> DRIVE VCA L R_in
  BP3IN_R: [U81.15, R170.1]   # CD4053 Y out -> DRIVE VCA R R_in
  # DRIVE VCA L/R: V->I -> THAT2180 -> I/V (TL074 A/B). I/V out = the new BP3_DRIVEOUT band node.
  BP3_DRIVEIN_L: [R169.2, U89.1]
  BP3_DRIVEIN_R: [R170.2, U90.1]
  BP3_DRIVEIV_L: [U89.8, U93.2, R171.1]
  BP3_DRIVEIV_R: [U90.8, U93.6, R172.1]
  BP3_DRIVEOUT_L: [U93.1, R171.2, R18_3L.1, R20_3L.1, R22_3L.1, C_WF_3La.1, C_WF_3Lb.1]   # -> SC/HC/WF
  BP3_DRIVEOUT_R: [U93.7, R172.2, R18_3R.1, R20_3R.1, R22_3R.1, C_WF_3Ra.1, C_WF_3Rb.1]   # -> SC/HC/WF
  EC_BP3_DRIVE_L: [U89.2, R257.2, R259.2]        # Ec+ L: R_ec from V_DRIVE_CTRL_3 + R_inj from RV55 wiper (HIGH-3)
  EC_BP3_DRIVE_R: [U90.2, R258.2, R260.2]
  REF_P3: [R255.2, RV55.1, RV56.1]
  REF_N3: [R256.2, RV55.3, RV56.3]
  TRIMW_BP3_L: [RV55.2, R259.1]
  TRIMW_BP3_R: [RV56.2, R260.1]
  MOD_BP3_DIST: [R174.1]
  BP3_DRIVE_KNOB: [RV39.2, R173.1]
  BP3_DRIVE_SUM: [U93.9, R173.2, R174.2, R175.2, R176.1]
  V_DRIVE_CTRL_3: [U93.8, R176.2, R257.1, R258.1] # summer out (low-Z) -> both R_ec (HIGH-3)
  BP3_DRIVE_SPARE: [U93.14, U93.13]
  # selector inputs: X0/Y0 = LP1 band (ALT unpatched), X1/Y1 = ALT-VCA (ALT patched)
  LP1_OUT_L: [U81.12]                     # <- block-5 LP1 band L (boundary) -> mux X0
  LP1_OUT_R: [U81.2]                      # <- block-5 LP1 band R -> mux Y0
  ALT_VCA_OUT_L: [U81.13]                 # <- block-4 ALT-VCA L (boundary) -> mux X1
  ALT_VCA_OUT_R: [U81.1]                  # <- block-4 ALT-VCA R -> mux Y1
  ALT_L_DET: [U81.11, R133.2]             # <- block-1 ALT_BP_L detect (boundary); X/L select (A, pin11); pull-up R133
  ALT_R_DET: [U81.10, R226.2]             # <- block-1 ALT_BP_R detect (boundary); Y/R select (B, pin10); pull-up R226 (change 0020)
  BP3_SCVG_L: [U38.2, R18_3L.2, R19_3L.1, D4_3Lb.K, D4_3Lc.A]
  BP3_SCOUT_L: [U38.1, R19_3L.2, D4_3La.A, D4_3Ld.K, U33.13]
  BP3_SCM1_L: [D4_3La.K, D4_3Lb.A]
  BP3_SCM2_L: [D4_3Lc.K, D4_3Ld.A]
  BP3_HCVG_L: [U38.6, R20_3L.2, R21_3L.1]
  BP3_HCOUT_L: [U38.7, R21_3L.2, D5_3La.3, U77.12]
  BP3_HCZMID_L: [D5_3La.1, D5_3Lb.1]
  BP3_WFVG_L: [U44.2, R22_3L.2, R23_3L.1]
  BP3_VFOLDIN_L: [U44.1, R23_3L.2, R24_3L.1, R25_3L.1]
  BP3_WFCLAMP_L: [R24_3L.2, D6_3La.A, D6_3Ld.K, U44.5]
  BP3_WFCM1_L: [D6_3La.K, D6_3Lb.A]
  BP3_WFCM2_L: [D6_3Lc.K, D6_3Ld.A]
  BP3_WFFVG_L: [U44.6, R25_3L.2, R_f_wf_3L.1]
  BP3_WFOUT_L: [U44.7, R_f_wf_3L.2, U77.13]
  BP3_SCVG_R: [U39.2, R18_3R.2, R19_3R.1, D4_3Rb.K, D4_3Rc.A]
  BP3_SCOUT_R: [U39.1, R19_3R.2, D4_3Ra.A, D4_3Rd.K, U33.1]
  BP3_SCM1_R: [D4_3Ra.K, D4_3Rb.A]
  BP3_SCM2_R: [D4_3Rc.K, D4_3Rd.A]
  BP3_HCVG_R: [U39.6, R20_3R.2, R21_3R.1]
  BP3_HCOUT_R: [U39.7, R21_3R.2, D5_3Ra.3, U77.2]
  BP3_HCZMID_R: [D5_3Ra.1, D5_3Rb.1]
  BP3_WFVG_R: [U45.2, R22_3R.2, R23_3R.1]
  BP3_VFOLDIN_R: [U45.1, R23_3R.2, R24_3R.1, R25_3R.1]
  BP3_WFCLAMP_R: [R24_3R.2, D6_3Ra.A, D6_3Rd.K, U45.5]
  BP3_WFCM1_R: [D6_3Ra.K, D6_3Rb.A]
  BP3_WFCM2_R: [D6_3Rc.K, D6_3Rd.A]
  BP3_WFFVG_R: [U45.6, R25_3R.2, R_f_wf_3R.1]
  BP3_WFOUT_R: [U45.7, R_f_wf_3R.2, U77.1]
  BP3_SEL_WF: [U77.11, U77.10, R128_3wf.2]
  BP3_MID_L: [U77.14, U33.12]
  BP3_MID_R: [U77.15, U33.2]
  BP3_SEL_SC: [U33.11, U33.10, R128_3sc.2]
  BP3_DISTOUT_L: [U33.14, R203.1, R204.1]
  BP3_DISTOUT_R: [U33.15, R205.1, R206.1]
  # ---- CLIP detector nets (change 0018, Stage 6); VREF_P4/N4 are boundary inputs from dist1 ----
  BP3_CLIP_A_INP: [U96.3, R203.2, R207.2]
  BP3_CLIP_C_INP: [U96.10, R205.2, R209.2]
  BP3_CLIP_B_INN: [U96.6, R204.2]
  BP3_CLIP_B_INP: [U96.5, R212.2, R208.2]
  BP3_CLIP_D_INN: [U96.13, R206.2]
  BP3_CLIP_D_INP: [U96.12, R213.2, R210.2]
  BP3_CLIP_A_OUT: [U96.1, R207.1, D16_3a.A]
  BP3_CLIP_B_OUT: [U96.7, R208.1, D16_3b.A]
  BP3_CLIP_C_OUT: [U96.8, R209.1, D16_3c.A]
  BP3_CLIP_D_OUT: [U96.14, R210.1, D16_3d.A]
  BP3_CLIP_OR: [D16_3a.K, D16_3b.K, D16_3c.K, D16_3d.K, R211.1]
  BP3_CLIP_LEDA: [R211.2, BP3_CLIP_LED.A]
  VREF_P4: [U96.2, U96.9]              # <- dist1 shared +4V (boundary)
  VREF_N4: [R212.1, R213.1]            # <- dist1 shared -4V (boundary)
  "+12V": [U33.16, C110_U33p.1, U38.8, C110_U38p.1, U39.8, C110_U39p.1, U44.8, C110_U44p.1, U45.8, C110_U45p.1, U77.16, C110_U77p.1, U81.16, C110_U81p.1, R133.1, R226.1,
           U89.7, U90.7, U93.4, C110_U89p.1, C110_U90p.1, C110_U93p.1,
           U96.4, C110_U96p.1, R255.1]
  "-12V": [U33.7, C110_U33n.1, U38.4, C110_U38n.1, U39.4, C110_U39n.1, U44.4, C110_U44n.1, U45.4, C110_U45n.1, U77.7, C110_U77n.1, U81.7, C110_U81n.1,
           U89.5, U90.5, U93.11, C110_U89n.1, C110_U90n.1, C110_U93n.1,
           U96.11, C110_U96n.1, R256.1]
  GND: [U33.8, U33.6, C110_U33p.2, C110_U33n.2, C110_U38p.2, C110_U38n.2, C110_U39p.2, C110_U39n.2, C110_U44p.2, C110_U44n.2, C110_U45p.2, C110_U45n.2, U77.8, U77.6, C110_U77p.2, C110_U77n.2, U38.3, D5_3Lb.3, U38.5, U44.3, D6_3Lb.K, D6_3Lc.A, C_WF_3La.2, C_WF_3Lb.2, U39.3, D5_3Rb.3, U39.5, U45.3, D6_3Rb.K, D6_3Rc.A, C_WF_3Ra.2, C_WF_3Rb.2, U81.8, U81.6, U81.5, U81.3, U81.4, U81.9, C110_U81p.2, C110_U81n.2,
        U89.3, U89.4, U89.6, U90.3, U90.4, U90.6, U93.3, U93.5, U93.10, U93.12, RV39.1,
        C110_U89p.2, C110_U89n.2, C110_U90p.2, C110_U90n.2, C110_U93p.2, C110_U93n.2,
        C110_U96p.2, C110_U96n.2, BP3_CLIP_LED.K]

no_connect:
  - U33.3
  - U33.4
  - U33.5
  - U33.9
  - U77.3
  - U77.4
  - U77.5
  - U77.9

boundary:
  - VREF_P4          # <- dist1 shared +4V CLIP threshold
  - VREF_N4          # <- dist1 shared -4V CLIP threshold
  - V5LOGIC
  - LP1_OUT_L        # <- block-5 (mux X0)
  - LP1_OUT_R        # <- block-5 (mux Y0)
  - ALT_VCA_OUT_L    # <- block-4 ALT-VCA (mux X1)
  - ALT_VCA_OUT_R    # <- block-4 ALT-VCA (mux Y1)
  - ALT_L_DET        # <- block-1 ALT_BP_L insertion detect (X/L select)
  - ALT_R_DET        # <- block-1 ALT_BP_R insertion detect (Y/R select, change 0020)
  - MOD_BP3_DIST     # <- block-3 DRIVE CV (drive-control summer)
  - BP3_DISTOUT_L
  - BP3_DISTOUT_R
  - BP3_SEL_SC
  - BP3_SEL_WF
