jeffmhopkins/POGO/specs/block-7/block-7.nets.yaml

# POGO Block 7 — HP Filter (stereo 2-pole OTA-C SVF, highpass, mono/no tilt)
#
# Source of truth, transcribed from:
#   specs/components.yaml (block-7 rows; BOM authoritative, refs exact)
#   specs/block-7/spec.md (§2-§4) ; aux-ota-c-svf / aux-q-control / aux-expo-converter
#   datasheet-corrected pinouts: kicad_common.py sym_lm13700 / sym_that340 / sym_opa1612
#
# Structure = LP2 (block-8) topology with two HP differences:
#   1. OUTPUT IS HP: the SUM_AMP output node (HP_inv = -(x-k*v1-v2)) IS the HP tap —
#      it already equals the plugin's return (HPFilter pre-negates to match this node).
#      It is taken through a UNITY NON-INVERTING buffer (OPA1612 half B, follower) for
#      drive isolation -> HP_OUT, matching LP1's LP buffer. (change 0018: an earlier
#      G=-1 inverting buffer was a DOUBLE-INVERSION bug — HP_OUT came out phase-flipped
#      vs the plugin; R100-R103 removed, half B re-wired as a follower.)
#   2. Q VCA: ONE LM13700 (U51) — cell A = HP Q L, cell B = HP Q R (mono Q, same Iabc
#      both channels). (change 0018: was 2 ICs U51/U52 each cell-A; collapsed to 1,
#      matching the aux + LP1/LP2 shared-Q precedent. U52 freed.)
# Single shared expo (U55) drives both integrator channels (HP has no tilt).
# Own IRES_AMP (U66). Integrator Darlington buffers (v1/v2) get pulldowns to V-.
# Input = BP block output; output -> LP2 (block-8).

block: block-7
board: audio
title: POGO Block 7 - HP Filter (OTA-C SVF, mono)

parts:
  U49: { sym: ota, part: LM13700M, value: LM13700 }   # HP integrators L
  U50: { sym: ota, part: LM13700M, value: LM13700 }   # HP integrators R
  U51: { sym: ota, part: LM13700M, value: LM13700 }   # HP Q VCA: cell A = L, cell B = R (mono Q)
  U53: { sym: opamp2, part: OPA1612, value: OPA1612 } # L: A=SUM_AMP, B=HP output follower
  U54: { sym: opamp2, part: OPA1612, value: OPA1612 } # R: A=SUM_AMP, B=HP output follower
  U66: { sym: opamp2, part: TL072CDT, value: TL072 }  # A=IRES_AMP, B=spare
  U55: { sym: expo, part: THAT340S14-U, value: THAT340 }  # shared L+R expo (no tilt)

  C29A: { sym: c, value: 47nF }   # C1 L
  C29B: { sym: c, value: 47nF }   # C2 L
  C29C: { sym: c, value: 47nF }   # C1 R
  C29D: { sym: c, value: 47nF }   # C2 R

  R30: { sym: r, value: 100k }    # R_in L
  R31: { sym: r, value: 100k }    # R_in R
  R92: { sym: r, value: 100k }    # R_FB L (v2 feedback)
  R93: { sym: r, value: 100k }    # R_FB R
  R94: { sym: r, value: 100k }    # R_f L (SUM_AMP feedback)
  R95: { sym: r, value: 100k }    # R_f R
  R96: { sym: r, value: 1k }      # R_LIN OTA1 L
  R97: { sym: r, value: 1k }      # R_LIN OTA2 L
  R98: { sym: r, value: 1k }      # R_LIN OTA1 R
  R99: { sym: r, value: 1k }      # R_LIN OTA2 R
  # (HP output buffer is now a unity follower — R100-R103 inverting-buffer resistors removed, change 0018)
  R104: { sym: r, value: 100k }   # R_Iabc L (V_ires -> U51 cell A Iabc); change 0020 §D/M5: 1M→100k
  R105: { sym: r, value: 100k }   # R_Iabc R (V_ires -> U51 cell B Iabc); change 0020 §D/M5: 1M→100k
  R106: { sym: r, value: 100k }   # R_QBIAS
  R107: { sym: r, value: 100k }   # R_QINV
  R108: { sym: r, value: 100k }   # R_f_q
  R109: { sym: r, value: 1M }     # R_IREF_A
  R110: { sym: r, value: 49k9 }   # R_VOCT (change 0020 §A: 47k→49.9k centers 17.92mV/oct at mid-trim)
  R111: { sym: r, value: 1k }     # R_E
  R229: { sym: r, part: "Vishay TFPT", value: 1k }  # tempco shunt (change 0020 §A): HP_EXPO_BASE→GND, +4110ppm/K V/oct temp-comp
  # R112-R115 (Darlington-buffer pulldowns) removed — change 0020 §C: state vars now tap the
  # unbuffered OTA outputs (pins 5/12); the on-chip buffers (pins 7/8/9/10) are unused.
  # (no spare Q cells now — U51 cell A = L Q, cell B = R Q; cell-B termination resistors removed)

  RV16: { sym: trimpot, part: "Bourns 3224W", value: HP_FREF }
  RV17: { sym: trimpot, part: "Bourns 3224W", value: HP_1VOCT }
  RV18: { sym: trimpot, part: "Bourns 3224W", value: HP_QMAX }

  D12: { sym: diode, part: 1N4148W, value: 1N4148W }

  C86: { sym: c, value: 100nF }   # C_IREF
  C87: { sym: c, value: 10nF }    # C_IABC L
  C88: { sym: c, value: 10nF }    # C_IABC R
  C89: { sym: c, value: 10nF }    # C_IABC_Q L (U51 cell A)
  C90: { sym: c, value: 10nF }    # C_IABC_Q R (U51 cell B)
  C91: { sym: c, value: 100nF }   # U49 V+
  C92: { sym: c, value: 100nF }   # U49 V-
  C93: { sym: c, value: 100nF }   # U50 V+
  C94: { sym: c, value: 100nF }   # U50 V-
  C95: { sym: c, value: 100nF }   # U51 V+
  C96: { sym: c, value: 100nF }   # U51 V-
  # (C97/C98 removed — U52 eliminated)
  C99: { sym: c, value: 100nF }   # U53 V+
  C100: { sym: c, value: 100nF }  # U53 V-
  C101: { sym: c, value: 100nF }  # U54 V+
  C102: { sym: c, value: 100nF }  # U54 V-
  C103: { sym: c, value: 100nF }  # U55 +12V rail bypass
  C104: { sym: c, value: 100nF }  # U55 -12V rail bypass
  C105: { sym: c, value: 100nF }  # U66 V+
  C106: { sym: c, value: 100nF }  # U66 V-

nets:
  "+12V":
    [U49.11, U50.11, U51.11, U53.8, U54.8, U66.8,
     R109.1, RV18.3,
     C91.1, C93.1, C95.1, C99.1, C101.1, C103.1, C105.1]
  "-12V":
    [U49.6, U50.6, U51.6, U53.4, U54.4, U66.4,
     U55.4, U55.11, R111.2,
     C92.1, C94.1, C96.1, C100.1, C102.1, C104.1, C106.1]
  GND:
    [U53.3, U54.3, U66.3, RV18.1,
     R96.2, R97.2, R98.2, R99.2,
     C29A.2, C29B.2, C29C.2, C29D.2,
     D12.A,
     C86.2, C87.2, C88.2, C89.2, C90.2,
     C91.2, C92.2, C93.2, C94.2, C95.2, C96.2,
     C99.2, C100.2, C101.2, C102.2, C103.2, C104.2, C105.2, C106.2,
     R229.2]

  # ---- L channel SVF ----
  BP_OUT_L:     [R30.1]                       # <- block-6 BP out L (boundary)
  HP_SUMINV_L:  [U53.2, R30.2, R92.2, R94.1, U51.4, U51.5]  # SUM_AMP virtual ground (+ Q-cell A In-/Out)
  HP_HPINV_L:   [U53.1, R94.2, U49.3, U53.5]  # SUM_AMP out (HP_inv = HP tap) -> OTA1 In+ + follower In+
  # §C (change 0020): tap state variables from the UNBUFFERED OTA outputs (pins 5/12),
  # NOT the Darlington buffer (8/9) which sits ~1.2V below + temp-dependent (SPICE ota_svf_loop.cir:
  # 1.26V offset into the next OTA's ±30mV input). Buffers (7→8, 10→9) left unused; pulldowns removed.
  HP_V1_L:      [U49.5, C29A.1, U49.14, U51.3]  # v1 = OTA1 unbuffered out (pin5) + cap -> OTA2 In+ + Q-cell A In+ (§C)
  HP_V2_L:      [U49.12, C29B.1, R92.1]         # v2 = OTA2 unbuffered out (pin12) + cap -> R_FB feedback (§C)
  HP_OUT_L:     [U53.7, U53.6]                # HP unity follower out (= HP_inv tap) -> block-8 (boundary)

  # ---- R channel SVF ----
  BP_OUT_R:     [R31.1]                        # <- block-6 BP out R (boundary)
  HP_SUMINV_R:  [U54.2, R31.2, R93.2, R95.1, U51.13, U51.12]  # SUM_AMP v-ground + Q-cell B In-/Out
  HP_HPINV_R:   [U54.1, R95.2, U50.3, U54.5]  # SUM_AMP out (HP tap) -> OTA1 In+ + follower In+
  HP_V1_R:      [U50.5, C29C.1, U50.14, U51.14]  # v1 = OTA1 unbuffered out (pin5) + cap -> OTA2 In+ + Q-cell B In+ (§C)
  HP_V2_R:      [U50.12, C29D.1, R93.1]          # v2 = OTA2 unbuffered out (pin12) + cap -> R_FB feedback (§C)
  HP_OUT_R:     [U54.7, U54.6]                # HP unity follower out -> block-8 (boundary)

  # ---- OTA linearizing R (integrator In- pins) ----
  HP_LIN_A_L:   [U49.4, R96.1]
  HP_LIN_B_L:   [U49.13, R97.1]
  HP_LIN_A_R:   [U50.4, R98.1]
  HP_LIN_B_R:   [U50.13, R99.1]

  # ---- Q Iabc: U51 cell A = L, cell B = R (mono Q, both from V_ires) ----
  HP_QIABC_L:   [U51.1, R104.2, C89.1]        # U51 cell A Iabc (HP Q L)
  HP_QIABC_R:   [U51.16, R105.2, C90.1]       # U51 cell B Iabc (HP Q R)

  # ---- expo converter (single shared L+R; no tilt) ----
  HP_VCTRL:     [R110.1]                       # <- control: HP V/oct CV (boundary)
  HP_VOCT_TR:   [R110.2, RV17.1, RV17.2]
  HP_EXPO_BASE: [U55.2, RV17.3, R229.1]   # Q1 base: V/oct via R110+RV17, tempco shunt R229 to GND (change 0020 §A)
  HP_IABC:      [U55.1, U49.1, U49.16, U50.1, U50.16, C87.1, C88.1]  # shared Iabc -> both OTAs
  HP_EXPO_EMIT: [U55.3, U55.12, R111.1]
  HP_IREF:      [U55.14, U55.13, RV16.3, C86.1]
  HP_IREF_TR:   [R109.2, RV16.1, RV16.2]

  # ---- IRES_AMP / Q driver (U66 half A) ----
  # §D/M5 (change 0020): R_Iabc 1M→100k applied (R104/R105). The deeper IRES_AMP redesign — driving
  # V_ires into the NEGATIVE ~−10.0..−10.8V window required because the LM13700 Iabc pin sits ~2·Vbe
  # above V− (≈ −10.8V), NOT GND (SPICE q_cell.cir: Q≈0.74 at V_ires≈−10.73V; useful Q in a steep ~0.8V
  # window just above the pin) — plus the matching V_bias reference + clamp-polarity flip, is a
  # Phase-3R/trim-backed bring-up item ([NV]); RV18 (V_bias) needs fine/multi-turn resolution near the
  # rail. Topology of the negative-drive bias network left for the block-5 combined-edit pass (shares
  # the same IRES_AMP pattern) — see change-file §D. The clamp D12 stays as-is pending that redesign.
  HP_VBIAS:     [RV18.2, R106.1]
  HP_RES:       [R107.1]                       # resonance CV in (boundary)
  HP_IRES_SUM:  [U66.2, R106.2, R107.2, R108.1]
  HP_VIRES:     [U66.1, R108.2, D12.K, R104.1, R105.1]  # V_ires -> R_Iabc L+R (clamp D12 unchanged pending §D bias redesign)

no_connect:
  # LM13700 integrator linearizing-diode bias pins unused.
  - U49.2
  - U49.15
  - U50.2
  - U50.15
  # §C (change 0020): integrator Darlington buffers unused (state vars tap unbuffered pins 5/12).
  - U49.7
  - U49.8
  - U49.9
  - U49.10
  - U50.7
  - U50.8
  - U50.9
  - U50.10
  # Q-cell LM13700 (U51, both cells active): Darlington buffers + diode-bias pins unused.
  - U51.2
  - U51.7
  - U51.8
  - U51.9
  - U51.10
  - U51.15
  # THAT340 PNP transistors Q3 (5,6,7) and Q4 (8,9,10) unused.
  - U55.5
  - U55.6
  - U55.7
  - U55.8
  - U55.9
  - U55.10
  # U66 half B spare.
  - U66.5
  - U66.6
  - U66.7

boundary:
  - BP_OUT_L      # <- block-6 (BP out L = HP input)
  - BP_OUT_R      # <- block-6 (BP out R)
  - HP_OUT_L      # -> block-8 (HP out L = LP2 input)
  - HP_OUT_R      # -> block-8 (HP out R)
  - HP_VCTRL      # <- control: HP V/oct frequency CV
  - HP_RES        # <- control/mod: HP resonance CV
