jeffmhopkins/POGO/components/symbols/expo.yaml

# components/symbols/expo.yaml — AUTHORED symbol primitive (the nets `sym:` token = filename).
# Pin `at` is the connection point; one source drives both the emitted symbol and the pin map.
# Loaded dynamically by tools/symbols.py (globs components/symbols/*.yaml).
lib_id: POGO:THAT340
properties:
- key: Reference
  val: U
  at: [9.144, 9.144, 0.0]
  font: [1.27, 1.27]
- key: Value
  val: THAT340
  at: [9.144, -9.144, 0.0]
  font: [1.27, 1.27]
units:
- unit: 0
  style: 1
  graphics:
  - kind: rectangle
    width: 0.254
    fill: background
    start: [-8.89, -8.89]
    end: [8.89, 8.89]
  pins: []
- unit: 1
  style: 1
  graphics: []
  pins:
  - type: output
    style: line
    at: [-11.43, 7.62]
    angle: 0.0
    len: 2.54
    name: Q1_C
    number: '1'
    name_font: [1.016, 1.016]
    num_font: [1.016, 1.016]
  - type: input
    style: line
    at: [-11.43, 5.08]
    angle: 0.0
    len: 2.54
    name: Q1_B
    number: '2'
    name_font: [1.016, 1.016]
    num_font: [1.016, 1.016]
  - type: passive
    style: line
    at: [-11.43, 2.54]
    angle: 0.0
    len: 2.54
    name: Q1_E
    number: '3'
    name_font: [1.016, 1.016]
    num_font: [1.016, 1.016]
  - type: power_in
    style: line
    at: [-11.43, 0.0]
    angle: 0.0
    len: 2.54
    name: SUB
    number: '4'
    name_font: [1.016, 1.016]
    num_font: [1.016, 1.016]
  - type: passive
    style: line
    at: [-11.43, -2.54]
    angle: 0.0
    len: 2.54
    name: Q3_E
    number: '5'
    name_font: [1.016, 1.016]
    num_font: [1.016, 1.016]
  - type: input
    style: line
    at: [-11.43, -5.08]
    angle: 0.0
    len: 2.54
    name: Q3_B
    number: '6'
    name_font: [1.016, 1.016]
    num_font: [1.016, 1.016]
  - type: output
    style: line
    at: [-11.43, -7.62]
    angle: 0.0
    len: 2.54
    name: Q3_C
    number: '7'
    name_font: [1.016, 1.016]
    num_font: [1.016, 1.016]
  - type: output
    style: line
    at: [11.43, -7.62]
    angle: 180.0
    len: 2.54
    name: Q4_C
    number: '8'
    name_font: [1.016, 1.016]
    num_font: [1.016, 1.016]
  - type: input
    style: line
    at: [11.43, -5.08]
    angle: 180.0
    len: 2.54
    name: Q4_B
    number: '9'
    name_font: [1.016, 1.016]
    num_font: [1.016, 1.016]
  - type: passive
    style: line
    at: [11.43, -2.54]
    angle: 180.0
    len: 2.54
    name: Q4_E
    number: '10'
    name_font: [1.016, 1.016]
    num_font: [1.016, 1.016]
  - type: power_in
    style: line
    at: [11.43, 0.0]
    angle: 180.0
    len: 2.54
    name: SUB
    number: '11'
    name_font: [1.016, 1.016]
    num_font: [1.016, 1.016]
  - type: passive
    style: line
    at: [11.43, 2.54]
    angle: 180.0
    len: 2.54
    name: Q2_E
    number: '12'
    name_font: [1.016, 1.016]
    num_font: [1.016, 1.016]
  - type: input
    style: line
    at: [11.43, 5.08]
    angle: 180.0
    len: 2.54
    name: Q2_B
    number: '13'
    name_font: [1.016, 1.016]
    num_font: [1.016, 1.016]
  - type: output
    style: line
    at: [11.43, 7.62]
    angle: 180.0
    len: 2.54
    name: Q2_C
    number: '14'
    name_font: [1.016, 1.016]
    num_font: [1.016, 1.016]
pin_names: {offset: 0.254, hide: true}
pin_numbers_hide: true
name: THAT340
pinout_datasheet: THAT 340 (Doc 600041) Pin Assignments
