jeffmhopkins/POGO/(commit log)

2026-05-18 Add comprehensive CLAUDE.md documenting POGO module design and workflow
    Establishes the design-first process for POGO, a complex stereo Eurorack
    filter module. Documents the full signal chain, modulation architecture,
    four-phase design gate (audio spec → analog behavior → circuit design → code),
    specs/ file structure with per-block templates, HTML design doc requirements,
    Eurorack/Doepfer hardware standards, and VCV Rack SDK conventions.
    https://claude.ai/code/session_01VTKt9GqvM69tbmekqFyCaN
2026-05-18 Add complete Phase 1-3 specs for all signal chain blocks
    Documents all 10 blocks (A, 1-7, B) plus modulation architecture
    through audio spec, analog behavior model, and circuit design phases.
    Covers signal chain, transfer functions, IC selection, component values,
    trim pot procedures, and known circuit challenges per block.
    LP1/LP2 circuit topology decision deferred pending VCV prototype testing;
    three candidates documented with pros/cons in block-5-lp1/spec.md.
    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
2026-05-18 Confirm SVF topology for LP1 and LP2; mark all Phase 3 complete
    LP1 and LP2 use OTA-C state-variable filter (LM13700 integrators +
    TL074 summing amp + V2164 Q VCA). LP and BP/HP outputs all available.
    Both stages share one V2164 quad VCA and one PCB layout. STATUS.md
    now shows all 10 blocks ✅ through Phase 3.
    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
2026-05-18 APF: independent feedback CVs, SOURCE/POLARITY switches, BLEND CV
    Three independent FEEDBACK CVs replace one shared CV. Feedback path
    now has three stages: SOURCE switch (Internal/Blend/Post-Dist) with
    BLEND knob + CV, then POLARITY switch (Positive/Off/Negative, mechanical
    only, no CV), then per-group feedback amount. Post-Dist taps Block 4
    output into the APF feedback loop. Mod destination count updated from
    14 to 17 across CLAUDE.md and mod-architecture.md.
    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
2026-05-18 Distortion: per-chain instances independent of APF group outputs
    Block 4 is now three independent distortion instances (one per APF
    group) each with its own MODE switch and DRIVE knob, both L/R linked.
    Chain outputs sum before LP1. Each chain taps its post-distortion
    signal back to the APF SOURCE selector for that group. Removed MODE
    CV; added Drive CV 1/2/3 per chain. Mod destination count: 19.
    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
2026-05-18 Add HTML design documents for all blocks and modulation architecture
    Creates design/ directory with 11 HTML files covering every block and
    the modulation system. Each file contains:
    - Block diagram (ASCII signal flow with voltage levels)
    - Schematic description with IC pin assignments and component values
    - Parts list (reference, part number, package, qty, notes)
    - Design notes: Phase 1–3 summary, trim pot procedures, circuit challenges
    Files created:
    design/index.html - Module overview, signal chain, power budget, status
    design/block-A-input-buffer.html
    design/block-1-pregain.html
    design/block-2-envelope-follower.html
    design/block-3-apcf.html
    design/bloc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
2026-05-18 Convert ASCII schematics to inline SVG in block-A, block-1, block-2 design docs
    Replaces <pre> ASCII art schematics with inline SVG diagrams in all three
    HTML design files, matching the visual style of the block diagram SVGs
    already present. Improves readability and meets the design/HTML doc standard.
    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
2026-05-18 Change MOD SOURCE SEL switch to L / max(L,R) / avg(L,R)
    Replaces the previous L / L+R avg / R positions with a more musically
    useful set. max(L,R) uses a BAT54 diode-OR (EF2_D buffer) to track
    whichever channel is louder at any moment. avg(L,R) uses two equal 20 kΩ
    resistors into EF1_D for a smooth channel-averaged CV. The R-only position
    is dropped — max(L,R) covers the "catch everything" use case better.
    Updates spec.md, block-2 HTML design doc, and CLAUDE.md.
    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
2026-05-18 Add Phase 4 (Panel Design) and Phase 5 (Board Layout) before code
    Inserts two new module-level phases between circuit design and VCV Rack
    code. Phase 4 covers HP width, control placement, sub-panel/multi-board
    decision, and silk-screen/labeling. Phase 5 covers board split strategy,
    ground plane approach, component placement rules, and connector pinout.
    VCV Rack implementation is renumbered Phase 6.
    Updates STATUS.md template, repo structure, design-first rule summary,
    and Where to Start guide accordingly.
    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
2026-05-19 Remove pre-gain CV modulation destination — switch only
    Pre-gain boost is a mechanical toggle with no CV input. Removes the
    Pre-Gain level mod destination from CLAUDE.md, mod-architecture.md,
    module-overview.md (now 13 destinations), block-1 spec, and panel-notes.
    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
2026-05-19 Complete panel-notes.md with full zone-by-zone layout decisions
    Documents all zones: stacked left section (input/env/modbus), shared,
    comb/distortion (24HP unified), LP1, LP2, HP+out. Captures knob size
    tiers, attenuverter placement, jack row paradigm, switch labeling, and
    control inventory per zone. 50HP target locked.
    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
2026-05-19 Redesign panel layout docs: 50→46 HP, add Comb Master Offset, reorganize Shared zone
    - panel-notes.md: full rewrite — 46 HP, stacked zone with 20% shorter input/gain, Shared
    split into Comb/Dist subsections with MASTER OFFSET large knob, comb 1/2/3 at 6 HP each
    with vertical knob stacks, combined LP2+HP+OUT zone with vertical cutoff sliders
    - block-3-apcf/spec.md: add MASTER OFFSET (FREQ OFFSET) to CV modulation targets table
    - mod-architecture.md: add APF Master Offset destination, update destination count to 18
    - module-overview.md: update panel width from TBD to 46 HP, update mod destination count
    - STATUS.md: update Phase 4 deliverables path and date
    https://claude.ai/code/sessi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
2026-05-19 Add panel.html Step 1: module structure, zone separators, and labels
    46 HP SVG from scratch. Includes panel background, rail bands, mounting holes,
    all cyan zone separator lines, dim-gray sub-dividers (comb groups, LP2/HP split,
    Shared COMB/DIST divider), OUT subsection box outline, and all zone/subsection
    labels. No controls yet — structure review step before placing knobs and jacks.
    https://claude.ai/code/session_01JzWGptzLTqFkAZDHVU6Z8A
2026-05-19 Add BAND OUT + OUT top strip to LP2+HP zone; expand Block B to 6 outputs
    Panel: Zone 4+5 top strip (y=4.5–44mm) split into BAND OUT (left, 5HP) and OUT (right, 6HP).
    BAND OUT provides LP2 L/R and HP L/R auxiliary bandpass tap outputs.
    LP2/HP vertical divider doubles as BAND OUT/OUT separator.
    - panel-notes.md: document top strip layout, two-row BAND OUT jacks, OUT placement
    - block-B-output-buffer/spec.md: expand from 2 to 6 output buffers; document LP2 AUX,
    HP AUX, and main OUT pairs; update IC count to 3× TL072, power to 6mA/rail
    - module-overview.md: update signal chain to note 6 output jacks and aux bandpass taps
    - panel.html: Step 1 rev2 — add horizontal strip divider, BAND OUT/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
2026-05-19 Tighten BAND OUT strip to minimum height; remove sub-labels
    - Horizontal divider moves from y=44 to y=28 (minimum for 2 jack rows at y=15 and y=23)
    - Remove LP 2 / HP row sub-labels from inside BAND OUT section
    - Filter section labels shift from y=50 to y=34
    - panel-notes.md updated to reflect new strip height and jack y-positions
    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
2026-05-19 Standardize panel to 1 jack per 2 HP — 46 HP → 40 HP
    Apply uniform jack spacing rule: zone width = (max jacks in one
    horizontal row) × 2 HP = 10.16 mm pitch. Comb 1/2/3 already
    complied at 6 HP; all other zones adjusted:
    Zone 0 (stacked): 5 HP → 4 HP (2-jack rows)
    Zone 1 (shared): 7 HP → 6 HP (unified 3-jack bottom row;
    MASTER OFFSET / DRY/WET / BLEND CV)
    LP 1: 5 HP → 4 HP (2-jack rows)
    LP 2: 5 HP → 4 HP (2-jack rows; was part of 11 HP)
    HP + OUT: 6 HP → 4 HP (2-jack rows; was part of 11 HP)
    All cyan zone separators fall on exact HP boundaries (jack midpoints
    always equal the HP bou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
2026-05-19 Add Section 1 controls: Zone 0a INPUT / GAIN
    L IN and R IN audio input jacks, GAIN 2-position vertical switch
    with 1× / 5× position labels.
    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
2026-05-19 Add Section 2 controls: Zone 0b ENVELOPE
    MOD SRC 3-position switch (L/MAX/AVG, shifted up between knobs),
    ATTACK and RELEASE medium knobs, ENV L/R output jacks.
    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
2026-05-19 Revise Zone 0b: MOD SRC switch horizontal, knobs/jacks lower
    MOD SRC switch changed from vertical to horizontal 3-pos layout
    across the top of the section. ATTACK/RELEASE knobs moved to
    middle (y=67). ENV L/R jacks pushed to bottom of section (y=83).
    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
2026-05-19 Increase jack label separation — 3.5mm gap from jack bottom to label
    Applied to L IN / R IN (Section 1) and ENV L / ENV R (Section 2).
    Will use this gap rule for all remaining jack labels.
    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
2026-05-19 Apply 3mm label gap rule to knobs (ATTACK, RELEASE)
    Label baseline = control_center + radius + 3mm for all controls.
    Rule now consistent: medium knob label at y+7.5, jack label at y+6.5.
    Will apply to all remaining sections.
    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
2026-05-19 Recenter ATTACK/RELEASE knobs after label gap change
    Moved knobs from y=67 to y=64 so the knob+label block sits
    centered between the MOD SRC switch and ENV L/R jacks.
    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
2026-05-19 Add Section 3 controls: Zone 0c MOD BUS
    AMOUNT and OFFSET medium knobs, MOD IN input jack.
    Control+label block centered in available space with ~3.5mm
    margins top and bottom.
    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
2026-05-19 Add LP 1 controls to panel SVG (Section 8)
    CUTOFF large knob, RESONANCE medium knob, CUTOFF/RES attenuverters,
    and CUTOFF CV / RES CV jacks with labels placed in zone x=142.24–162.56.
    Positions evenly centered with ~14.9mm margins top and bottom.
    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
2026-05-19 Move LP1 CV jacks to common bottom row, redistribute knobs
    CV jacks anchored at cy=118 / label y=124.5 to match the Zone 0c
    MOD IN bottom position. ATT row at cy=109. CUTOFF (cy=40) and
    RESONANCE (cy=77) redistributed with equal ~20.5mm gaps above the ATT row.
    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
2026-05-19 Add LP2 and HP sections to panel SVG (Sections 9–10)
    BAND OUT top strip: LP2 AUX L/R at cy=13, HP AUX L/R at cy=23 with
    tiny labels. LP2 and HP filter sections use identical vertical layout:
    CUTOFF cy=56, RESONANCE cy=85, ATT cy=109, CV cy=118 — matching the
    common bottom anchor established in LP1.
    OUT top strip: L/R output jacks at cy=15 in the HP zone header.
    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
2026-05-19 LP1 SPREAD knob, LP2/HP CUTOFF sliders
    LP1: add SPREAD knob (medium, bipolar, no CV) between CUTOFF and
    RESONANCE; redistribute three knobs with equal ~12mm gaps (cy=31/60/86).
    LP2/HP: replace CUTOFF large knob with 40mm vertical slider
    (track y=38–78, thumb at midpoint y=58); RESONANCE drops to cy=86.
    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
2026-05-19 Move LP2/HP top divider to y=42, realign output jacks
    Divider shifted from y=28 to y=42 giving 37.5mm for the top strip.
    LP2 AUX L/R and OUT L/R aligned at cy=16; HP AUX L/R at cy=31 with
    full-size (1.8) labels and 3mm gap. Filter section labels moved to
    y=47; LP2/HP sliders and RESONANCE knobs shifted to fill new space.
    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
2026-05-19 Size LP2/HP sliders to ALPS RS3015N (30mm travel)
    Update slider SVG representation to match physical part dimensions:
    aperture 4mm W × 30mm H, knob cap 13mm W × 7mm H. Document part
    reference in SVG comments. 45mm travel excluded — won't fit alongside
    RESONANCE knob + ATT + CV jacks in a 4HP section.
    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
2026-05-19 BAND OUT to LP1 pair only, upgrade LP2/HP to 45mm sliders
    Remove HP AUX jacks from BAND OUT; keep single LP1 AUX L/R pair
    (tap at LP1 output, pre-LP2). Divider restored to y=28, freeing
    enough space to upgrade LP2/HP CUTOFF sliders from 30mm to 45mm
    travel (ALPS RS4515N). RESONANCE knobs shift to cy=93, label y=101.
    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
2026-05-19 Add Comb 2 and Comb 3 controls to panel SVG (Sections 6–7)
    Identical layout to Comb 1 (FREQ/FEED/DRIVE knobs, ATT row, CV row)
    replicated at x-offsets for zones 81.28–111.76 and 111.76–142.24.
    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
2026-05-19 Add SHARED COMB subsection controls to panel SVG (Section 4a)
    DRY/WET and WIDTH medium knobs at cy=26, POLARITY 3-pos switch
    (POS/OFF/NEG) centered at y=42, MASTER OFFSET large knob at cy=62.
    All controls above the y=74 COMB/DIST divider.
    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
2026-05-19 Fix POLARITY switch to horizontal orientation in SHARED COMB
    Switch was vertical; changed to 3-pos horizontal (POS–OFF–NEG
    left to right), matching MOD SRC switch convention. 12mm body
    centered at x=35.56, labels below.
    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
2026-05-19 Even-space DRY/WET and WIDTH knobs in SHARED COMB section
    Moved from outer jack positions to evenly distributed spacing:
    4.16mm gaps between each knob edge and zone boundary. DRY/WET
    cx=29.0, WIDTH cx=42.14.
    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
2026-05-19 Add SHARED DIST section and even-space COMB knobs
    - Reposition DRY/WET (cx=29.0) and WIDTH (cx=42.14) with equal 4.16mm gaps
    - Add DIST subsection: SOURCE 3-pos switch (INT/BLD/PST), BLEND knob,
    MODE 3-pos switch (SFT/HRD/WFD)
    - Unified bottom ATT (cy=109) and CV (cy=118) row for M.OFF / DRY/W / BLEND
    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
2026-05-19 Add frequency range sub-labels under comb section titles
    COMB 1: 20Hz–2kHz · COMB 2: 200Hz–8kHz · COMB 3: 1kHz–20kHz
    Matches ranges from specs/block-3-apcf/spec.md FREQ parameter table.
    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
2026-05-19 Upsize MASTER OFFSET knob to XL (r=9)
    Shifted cy 62→61 so label at y=73 clears the COMB/DIST
    divider at y=74. 3mm clearance from POLARITY label above.
    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
2026-05-19 Rename SHARED→CONTROL; reorder bottom jacks to WET/OFFSET/BLEND
    Bottom CV row: M.OFF→WET (x=25.40), DRY/W→OFFSET (x=35.56), BLEND unchanged.
    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
2026-05-19 Redistribute CONTROL comb subsection vertically
    Equal ~3.5mm gaps across 60mm zone (y=13–73):
    knobs cy=21 · switch body y=34 · MASTER OFFSET cy=57 (label y=69)
    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
2026-05-19 Even out comb knob vertical spacing (~9.5mm gaps throughout)
    Old gaps: 4.5 / 9 / 11 / 13.5mm (very uneven)
    New gaps: 9.5 / 10 / 9 / 9.5mm (uniform)
    FREQ cy 27→32 label y 39→44
    FEED cy 55→61 label y 65→71
    DRIVE cy 83→87 label y 93→97
    Applied identically to COMB 1, 2, and 3.
    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
2026-05-19 Align LP1 SPREAD+RESONANCE with comb FEED+DRIVE row heights
    SPREAD cy 60→61, RESONANCE cy 86→87 to match comb cy=61/87.
    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
2026-05-19 Align L/R IN jacks with outputs; make GAIN switch horizontal
    IN jacks cy 14→16 to match L OUT / R OUT / LP1 L / LP1 R row.
    GAIN switch converted from 2-pos vertical to 2-pos horizontal,
    labels (1× / 5×) now below the body.
    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
2026-05-19 Rename comb feedback abbreviation FEED→FB
    Knob labels and CV jack labels updated across COMB 1, 2, 3.
    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
2026-05-19 Remove SOURCE switch; BLEND knob now covers full clean→dist range
    SOURCE switch (INT/BLD/PST) eliminated — BLEND alone selects feedback
    source continuously: 0%=clean APF, 100%=post-dist, middle=crossfade.
    Simplifies circuit (CD4053 mux removed). MODE and BLEND repositioned
    with equal gaps (MODE cx=28, BLEND cx=40).
    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
2026-05-19 Add rounded border around output jack labels
    ENV L, ENV R, LP1 L, LP1 R, L, R — stroke #888 (matches text),
    fill none, rx=0.6, stroke-width=0.3, 0.8mm H / 0.5mm V padding.
    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
2026-05-19 Vertically center output jack labels between jack and section border
    Top strip (LP1 L/R, L, R): y 22.5→24.5, rects updated to match.
    (centered in 8.5mm gap between jack bottom y=19.5 and divider y=28)
    BYPASS CV label: y 124.5→125.8.
    (centered in 7.35mm gap between jack bottom y=121.5 and panel y=128.85)
    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
2026-05-19 Add Option E module labeling: POGO + subtitle top strip, company bottom strip
    Two-line stacked top strip with POGO bold cyan and STEREO TRIPLE COMB FILTER
    subtitle. Centered company/SCS line in bottom strip. Removes grey watermark.
    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
2026-05-19 Move VCA to LP1 top strip (pre-LP1); restore LP2 BAND OUT
    VCA (AMT attenuverter + CV IN jack normals to mod bus) now lives in LP1's
    top strip y=4.5–28. Horizontal divider extended left to x=142.24. LP1 filter
    label moved below divider to y=33. LP2 top strip reverted to BAND OUT with
    LP1 L / LP1 R aux output jacks.
    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
2026-05-19 Refit LP1 knobs to new section bounds (y=28–128.85)
    CUTOFF cy=31→42, SPREAD cy=61→69, RESONANCE cy=87→96.
    Equal ~27mm gaps; labels updated to match.
    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
2026-05-19 Align LP1 resonance with LP2/HP (cy=93), equal-space CUTOFF and SPREAD
    RESONANCE cy=96→93 matches LP2/HP row. SPREAD cy=69→67.5 gives equal
    25.5mm steps: CUTOFF(42)→SPREAD(67.5)→RESONANCE(93).
    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
2026-05-19 Lower LP1 cutoff so top aligns with LP2 slider top (y=40), recenter spread
    CUTOFF cy=42→47 (top edge y=40 matches LP2/HP slider track top).
    SPREAD cy=67.5→70, centered between CUTOFF(47) and RESONANCE(93).
    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
2026-05-19 Sync all documentation to match panel.html as source of truth
    Key changes across specs/ and design/:
    - Add Block VCA (pre-LP1 VCA): new spec, new design doc, wired into all signal
    chain descriptions; V2164 cells 3+4 for VCA L/R (cells 1+2 shared with LP1 Q)
    - Remove SOURCE switch from CONTROL section; replace with FB DIST BLEND continuous
    knob (0% = clean APF fb, 100% = post-dist fb via resistive crossfade + op-amp)
    - Rename DRY/WET → COMB BYPASS (pre-comb VCA level control)
    - Rename FEEDBACK/FEED → FB throughout comb sections
    - Rename BLEND → FB DIST BLEND throughout
    - Add STEREO SPREAD OFFSET to LP1: bipolar knob skews R cutoff relative to L;
    DC offset on R expo converter input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
2026-05-20 Phase 5 board layout: 4-board split strategy and connector pinout
    Creates specs/board-layout/layout-notes.md with the full 4-board PCB
    architecture (control, utility/HW-connect, left audio, right audio).
    Documents board inventories, inter-board connector pinouts (CN_CTRL_1/2,
    CN_UTIL_L, CN_UTIL_R), ground plane strategy, and placement rules.
    Updates V2164 cell allocation across block-VCA and block-5-lp1 specs to
    reflect the L/R board split: 4× V2164 total (2 per audio board), each IC
    handling one channel only, shared with LP1 Q on the same board.
    Marks Phase 4 and Phase 5 ✅ in specs/STATUS.md.
    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
2026-05-20 Remove V2164D: replace with THAT 2180 + LM13700 throughout
    V2164D sourcing concern resolved by eliminating it entirely:
    - Block VCA: THAT 2180 single-channel VCA (SOIC-8, Mouser stock), 1 per audio board
    - LP1/LP2/HP Q feedback: LM13700 OTA current injection into SUM_AMP virtual ground
    - IC_Q_AB (cell A = LP1 Q, cell B = LP2 Q) per audio board
    - IC_Q_C (cell A = HP Q, cell B = spare) per audio board
    - Block 3 COMB BYPASS: 2x LM13700 with complementary Iabc driver (utility board)
    Updated all 5 spec files and 6 design HTML files. Board layout notes revised:
    Section 4 now documents THAT 2180 + LM13700 Q VCA allocation instead of V2164 table.
    CN_UTIL_L/R pin descriptions updated to referenc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
2026-05-20 Circuit audit fixes: Q formula, APF caps, polarity, VCA trim, inventory
    Critical:
    - C1: APF integrator caps corrected (1000x unit error; Group 1: 33nF, Group 2: 6.8nF, Group 3: 1.5nF)
    - C2: OTA-SVF Q formula inverted in LP1/LP2/HP — corrected to Q=52mV/(Iabc×R_in); added inverting
    Iabc driver (IRES_AMP) description and timing constants to all three filter specs and HTML files
    - C3: HP output polarity resolved — HP_SUM half B configured as G=-1 inverting buffer (no extra IC)
    - C4: Block VCA R_gain set to 15kΩ nominal; added RV_VCA_UNITY_L/R trim pots (Bourns 3224W 500Ω)
    - C5: CD4053 V_EE=-12V warning added to Block 4 spec and HTML
    Significant:
    - S1: LM13700 board inventory corrected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
2026-05-20 Update CLAUDE.md to reflect current project state
    - STATUS.md template: add Block VCA row; expand to 6 columns including Phase 4/5
    - Repository structure: add block-VCA/ spec path and block-VCA.html design path; add VcaBlock.hpp to src/dsp/
    - Mechanical specs: 28-34 HP estimate → 40 HP (finalized)
    - Phase 4 Sub-Panel section: 2-board generic → 4-board actual split (control + utility + left audio + right audio)
    - Phase 5 board split table: updated to match 4-board architecture with correct contents and connections
    - Where to Start: rewritten to reflect all Phases 1-5 complete; Phase 6 is the current next step
    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
2026-05-20 Stage 0: VCV Rack plugin scaffold (blank panel)
    Create all Phase 6 scaffolding files:
    - plugin.json: slug POGO, version 2.0.0, Space Coast Synthesizers
    - Makefile: RACK_DIR-based build with plugin.mk
    - src/plugin.hpp + plugin.cpp: pluginInstance + modelPogo registration
    - src/Pogo.cpp: complete Pogo Module + PogoWidget
    - 47 params (all knobs, switches, attenuverters)
    - 22 inputs (2 audio + 1 mod source + 19 CV override jacks)
    - 6 outputs (ENV L/R, BAND L/R, main L/R)
    - All widget controls positioned at exact SVG mm coordinates
    - LP2/HP cutoff sliders stubbed as knobs at track midpoint
    - process(): audio pass-through only; all DSP stubbed
    - res/Pogo.svg: panel SVG with width/heigh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
2026-05-20 Add README.md
    Covers: module overview, full signal chain, project state table with
    Phase 6 stage checklist, repo structure, GitHub Actions build instructions
    (artifact download + manual trigger), local build steps, and hardware notes.
    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
2026-05-20 CI: fix jq null error in SDK download step
    Remove prerelease==false filter — Rack 2.x releases are tagged prerelease
    on GitHub, so the filter produced an empty array and [0] returned null.
    Switch to jq first() which traverses all v2.x releases regardless of
    flag, add per_page=20, and print diagnostic release list + asset names
    on failure so future breakage is easy to diagnose.
2026-05-20 CI: add full diagnostics + two-strategy SDK download
    Strategy 1: GitHub Releases API — find asset matching sdk+lin+x64+.zip.
    Strategy 2: GitHub Tags API — find latest v2.x tag, construct the
    canonical release download URL from it.
    Both strategies now print full raw API output (type, content) so the
    next failure will show exactly what the API returned and why neither
    strategy matched.
2026-05-20 CI: download SDK from vcvrack.com (VCVRack/Rack has no GitHub Releases)
    Diagnostic run confirmed: VCVRack/Rack uses git tags only, zero GitHub
    Release assets. Latest tag is v2.6.6. Switch to downloading the SDK zip
    directly from vcvrack.com/downloads/. Try the latest tagged version
    first, then fall back to 2.5.2 and 2.4.1 in case the newest hasn't
    been posted to the CDN yet.
2026-05-20 CI: pin to vcvrack.com/downloads/Rack-SDK-2.6-lin-x64.zip
    VCV Rack SDK uses short version numbers (2.6) not git tag versions
    (2.6.6). The canonical approach (per qno/vcv-plugin-github-actions-example)
    is a direct pinned download from vcvrack.com. Replace all API-probing
    logic with a single curl call to the stable SDK URL.
2026-05-21 DRIVE knob: dual-zone volume/distortion redesign
    CCW = mute, 9am (20% rotation) = unity/clean, CW = full distortion. Linear
    (B-taper) 50kΩ pot replaces log taper; unity at R_in = R_f = 10kΩ. Two-zone
    mapping added to Phase 2 model (0–20% = volume attenuation, 20–100% =
    distortion drive factor 0→1). CV range unchanged (0V=mute, 2V=unity,
    10V=full drive). DRIVE_1/2/3 defaults updated to 0.20f in Pogo.cpp. All
    spec, design HTML, and panel-notes files updated to mirror changes.
    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
2026-05-24 Noise and inter-block connection audit: IC upgrades + board design rules
    Full audit of the POGO IC-level circuit design for noise and impedance.
    Key changes:
    IC upgrades:
    - Block A: TL072CDT → LM4562MA (2.7 nV/√Hz; 6.7× quieter first stage)
    - Block 1: TL072CDT → NE5532D (5 nV/√Hz; reduces 5× boost noise floor 3.6×)
    Block 3 (APF):
    - Added 10 nF C0G Iabc bypass caps at each LM13700 Iabc pin (H3)
    - Added 10 kΩ POLARITY "Off" bleeder resistor to eliminate switch leakage
    feedback bleed-through at high resonance settings (H4)
    Block 5 (LP1):
    - Added 10 nF C0G Iabc bypass caps at integrator and Q-VCA Iabc pins
    - Documented OTA-C noise increase at high Q (accepted limitation D1)
    - Do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
2026-05-24 DRIVE knob: dual-zone volume + distortion (linear taper, CCW=mute, 9am=unity)
    Switch DRIVE 1/2/3 from log-taper to linear B-taper (50kΩ). The pot now has
    two zones: 0–20% rotation is a clean volume ramp (mute to unity gain); above
    9am (>20%) is the distortion drive zone (d = 0→1 mapped to the mode transfer
    function). Default knob position set to 0.20 (9am) so the module powers up at
    unity gain, not mute. Updates Phase 1 parameters, Phase 2 two-zone mapping,
    Phase 3 component values (R_f=10kΩ, R_min=470Ω), trim pot rationale, and all
    mirrored HTML design files plus mod architecture CV notes.
    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
2026-05-24 Add KiCad 7 control board schematic + generator + process doc
    - kicad/pogo-control-board.kicad_sch: KiCad 7 S-expression schematic for
    the control board (78 components: 28 jacks, 43 pots/sliders, 6 switches,
    3 IDC connectors). All connectivity via global net labels; parenthesis-
    balanced and ready for KiCad ERC or Flux.ai import.
    - kicad/generate_control_board.py: Python generator that produces the .kicad_sch
    from the POGO specs. Re-run after any pinout or control changes.
    - kicad/pogo.kicad_pro: Minimal KiCad 7 project file.
    - specs/kicad-process.md: Process document covering symbol library mapping,
    net naming convention, reference designator scheme, the CN_CTRL_3 connector
    g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
    [pogo-control-board.kicad_sch]
2026-05-24 Fix three net/connector bugs in KiCad control board generator
    1. CN2 pin 28 duplicate: NET_WPR_ATT_VCA_AMT was assigned to both pin 12
    (attenuverter wiper, correct) and pin 28 (duplicate, wrong). Pin 28 is
    now SPARE_CN2_28. VCA AMT is destination #4 of 19 — it was already on pin 12.
    2. CN3 overflow: extended from 20-pin to 24-pin (2×12). LP2_RES, HP_CUT, and
    HP_RES wipers were falling off the end of the 20-pin connector with only a
    comment. All 23 signals now fit with 1 spare.
    3. MODE switch pins on CN2: pins 6–8 previously carried NET_SW_MODE_COM (the
    switch common — useless to the utility board). Now carry the 3 position
    outputs: NET_SW_MODE_SFT / _HRD / _WFD, wh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
    [pogo-control-board.kicad_sch]
2026-05-24 Fix layout-notes.md: correct CN_CTRL_2 pinout + add CN_CTRL_3 table
    - CN_CTRL_2 pins 9–27 (not 9–28): exactly 19 attenuverter wipers; VCA AMT is
    destination #4, not a separate 20th knob. Pin 28 = SPARE.
    - CN_CTRL_2 pins 6–8: now documents MODE position outputs (SFT/HRD/WFD) for the
    single shared SW4, not "3-pos switch per distortion chain". Adds explicit note
    that "1 vs 3 MODE switches" is an unresolved design decision (panel-notes shows
    1 shared switch; earlier layout-notes language implied 3 separate switches).
    - CN_CTRL_2 pins 32–33: MOD SRC common and POLARITY common (were spare).
    - CN_CTRL_3 pinout table added (was completely missing): 24-pin (2×12) connector,
    pins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
2026-05-24 Resolve MODE switch ambiguity: 1 shared switch, per panel.svg
    panel.svg is authoritative: exactly one 3-pos MODE switch (SW4) exists,
    at cx=28 in Zone 1 DIST. No per-group switches in Comb 1/2/3 zones.
    - layout-notes.md: remove "unresolved design decision" note; state definitive
    answer; correct switch orientations (GAIN/MOD SRC/POLARITY = horizontal,
    MODE = vertical) to match SVG
    - kicad-process.md: remove ambiguity language; document 1-switch design with
    CN_CTRL_2 pins 6–8 encoding (SFT/HRD/WFD position outputs)
    Generator and schematic were already correct (1 shared SW4). Only docs updated.
    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
2026-05-24 Fix control board schematic: expand CN2 to 40-pin, wire all switch nets
    All switch commons now tie to +12V power symbols on the control board
    (no orphan global labels). SP3T position outputs (MODE, MOD SRC, POLARITY)
    each get 3 individual connector pins instead of sending the common pin:
    CN_CTRL_2 expanded from 34-pin to 40-pin (2×20):
    - Pins 32–34: MOD SRC L/MAX/AVG position outputs (SW2)
    - Pins 35–37: POLARITY POS/OFF/NEG position outputs (SW3)
    - Pin 38: ENV NORM return (utility board → MOD IN jack SW lug for normalling)
    CN_CTRL_1 pin 34 changed from SPARE to NET_MOD_IN (MOD IN jack tip).
    Result: zero problematic floating nets. Remaining 23 single-occurrence
    nets are all intentio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
    [pogo-control-board.kicad_sch]
2026-05-24 Collapse 19 MODBUS_NORM_* nets into single NET_MODBUS_NORM (1 connector pin)
    All 19 CV override jack SW lugs now share one net (NET_MODBUS_NORM) wired
    together on the control board PCB. The utility board drives CN_CTRL_2 pin 39
    with the processed Mod Bus output (post-AMOUNT/OFFSET, buffered). When no
    cable is plugged into any CV override jack, its Thonkiconn switch connects
    tip to SW, so the attenuverter input sees the Mod Bus.
    This saves 18 connector pins vs. individual normalling signals and eliminates
    all 19 previously-floating NET_MODBUS_NORM_* labels.
    Result: only 3 single-occurrence nets remain — all are intentional spare pins
    (SPARE_CN2_28, SPARE_CN2_40, SPARE_CN3_24).
    Updated la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
    [pogo-control-board.kicad_sch]
2026-05-24 Refactor: extract shared KiCad generation infrastructure into kicad_common.py
    All reusable functions (lib_symbol generators, pin coordinate helpers, emitters,
    IDC placement) moved to kicad_common.py for use by all 4 board generators.
    generate_control_board.py now imports from kicad_common and retains only
    board-specific code: sym_jack, sym_spdt, sym_sp3t, place_jack, place_pot,
    place_spdt, place_sp3t, emit_lib_symbols, build_schematic.
    Schematic output unchanged: 78 components, 3 intentional spare nets,
    parens balanced. kicad_common.py includes IC lib_symbols for utility and
    audio boards (TL072, LM4562, NE5532, TL074, LM13700, THAT340, THAT2180,
    CD4053) plus all shared helpers needed by the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
    [pogo-control-board.kicad_sch]
2026-05-24 docs(README): add KiCad board design system section
    Documents the kicad/ generator infrastructure: board order, how to run
    generate_control_board.py, what kicad_common.py provides, the 3-connector
    architecture (CN1/CN2/CN3), the NET_MODBUS_NORM single-pin consolidation
    design decision, and the Flux.ai import workflow.
    Also updates the repository structure map to include the kicad/ directory.
    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
2026-05-24 Add schematic validator (kiutils-based) + wire into generator
    validate_schematic.py uses kiutils to parse pogo-control-board.kicad_sch
    and checks 5 things:
    1. Component prefix counts match spec (J×28, RV×43, SW×4, CN×3)
    2. No duplicate reference designators
    3. No unexpected floating (single-occurrence) nets; known spares listed
    4. All 86 required nets present (audio, CV, wipers, switches, power)
    5. NET_MODBUS_NORM appears exactly 20× (19 SW lugs + 1 CN2 pin)
    generate_control_board.py now runs the validator automatically after
    writing the schematic. Gracefully skips if kiutils not installed.
    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
2026-05-24 Regenerate control board schematic (UUID refresh from validator test run)
    Functionally identical — same 78 components, same nets, same connectivity.
    UUIDs differ because each generator run produces fresh UUIDs per KiCad spec.
    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
    [pogo-control-board.kicad_sch]
2026-05-24 docs(README): document validate_schematic.py in KiCad section
    Adds validate_schematic.py to the repo structure map, updates the
    generator run instructions to mention auto-validation, and adds a
    dedicated "Validating a schematic" subsection with a check table,
    usage examples, CI note, and callout for what KiCad ERC covers beyond
    the Python validator.
    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
2026-05-25 Expand validator: add pin-level checks 6–11 (326 assignments)
    Checks added on top of the original 5 structural checks:
    6. Jack pin assignments — tip / sleeve / SW-lug net per J1–J28
    7. Pot pin assignments — CCW / wiper / CW net per RV1–RV43
    8. Switch pin assignments — all throws + common per SW1–SW4
    9. CN1 pinout — 34-pin IDC vs. layout-notes.md §5
    10. CN2 pinout — 40-pin IDC vs. layout-notes.md §5
    11. CN3 pinout — 24-pin IDC vs. layout-notes.md §5
    All 9 checks pass; 326 individual pin assignments verified against the
    ground-truth JACK_RULES / POT_RULES / SWITCH_RULES / CN*_PINOUT tables
    embedded in the validator. Val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
2026-05-25 docs: audit and clean up all 21 markdown files
    Fixes stale content, reconciles conflicting numbers, and trims the
    largest redundancy. No code changes.
    Stale content fixed:
    - README.md: validator section updated from "five checks" to nine checks
    + 326 pin assignments; new 9-row table added; LM4562/NE5532 added to
    Hardware Notes IC list
    - kicad-process.md: §Known Gaps renamed §Design Decisions (Resolved);
    both subsections rewritten to reflect finalized state (CN_CTRL_3
    24-pin pinout implemented + verified; SW4 MODE decision documented)
    - layout-notes.md: CN_CTRL_3 status line changed from "placeholder —
    must be finalized" to "finalized — implemented + verified by validator"
    I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
2026-05-25 ci: add KiCad schematic generation and validation job
    New parallel job generates pogo-control-board.kicad_sch from source and
    runs the 9-check/326-pin validator on every push, failing the build if
    the schematic is invalid. Artifact uploaded as POGO-kicad-<run_number>.
    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
2026-05-25 ci: add Windows and macOS plugin build jobs
    Windows: cross-compiled via MinGW using the existing toolchain container
    (plugin-build-win-x64 target). macOS: native macos-latest runner downloads
    the Rack SDK and runs make dist. SDK version pinned via RACK_SDK_VERSION env
    var for easy updates. All four jobs (Linux, Windows, macOS, KiCad) now run
    in parallel on every push.
    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
2026-05-25 ci: fix Rack SDK version — drop prerelease filter, use .[0] directly
    All VCV Rack releases are marked prerelease:true, so select(.prerelease==false)
    returned an empty array. Simplified to .[0].tag_name on a per_page=1 request —
    no filtering needed, just take the most recent release.
    Logic verified locally against mock data before commit.
    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
2026-05-25 ci: include .kicad_pro in KiCad artifact alongside .kicad_sch
    The project file is needed to open the schematic directly in KiCad.
    Artifact now bundles all *.kicad_sch and *.kicad_pro files, so future
    boards are picked up automatically.
    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
2026-05-25 ci: extract vcvplugin and upload POGO folder structure directly
    The toolchain and make dist both produce .vcvplugin/.zip archives
    containing a POGO/ folder (plugin binary + plugin.json + res/). Previously
    the artifact was a zip-of-a-zip. A 'Stage artifact' step now extracts the
    package and uploads the POGO/ folder directly so the downloaded artifact
    contains plugin.so/.dll/.dylib, plugin.json, and res/ at the top level.
    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
2026-05-25 gui: fix text labels, LP2/HP sliders, and horizontal switches
    - Add ~85 ui::Label widgets to replace SVG <text> elements that NanoSVG
    ignores; all labels colored to match the SVG palette (cyan zone headers,
    gray control names, dim-blue switch position labels)
    - Replace RoundBlackKnob placeholders for LP2_CUTOFF and HP_CUTOFF with
    PogoSlider — a custom SliderKnob subclass that draws a 13x45 mm
    NanoVG track+handle matching the SVG slider track geometry
    - Replace CKSS/CKSSThree for GAIN, MOD_SRC, and POLARITY with
    PogoSwitchH2 / PogoSwitchH3 — custom app::Switch subclasses that draw
    horizontal capsule+slug matching the SVG switch body artwork;
    DIST_MODE remains CKSSThree (corr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
2026-05-25 feat(dsp): implement Phase 6 signal chain DSP (Blocks A–B)
    Add nine DSP headers covering the full POGO signal chain:
    - InputBuffer.hpp — Block A: unity-gain clamp (LM4562 model)
    - PreGain.hpp — Block 1: 1×/5× gain switch with tanh soft limit
    - EnvelopeFollower.hpp — Block 2: asymmetric peak detector (0.1ms–2s AR)
    - ModBus.hpp — Mod bus processor (0.2×–5× AMOUNT, ±5V OFFSET) +
    applyDestination() for all 19 CV destinations
    - AllPassComb.hpp — Block 3: triple 6-stage APF comb filter with
    per-group feedback, polarity, and FB Dist Blend
    crossfade; bilinear-transform APF stages
    - Distortion.hpp —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
2026-05-25 feat(dsp): Phase 6 signal chain + fix Label::CENTER_ALIGNMENT compile error
    Port full DSP implementation from feature branch to dev:
    DSP headers (src/dsp/):
    - InputBuffer.hpp — Block A: ±11.5 V clamp
    - PreGain.hpp — Block 1: 1×/5× gain, tanh soft limit
    - EnvelopeFollower.hpp — Block 2: asymmetric peak detector, 0.1ms–2s AR
    - ModBus.hpp — mod bus processor + applyDestination() for 19 CVs
    - AllPassComb.hpp — Block 3: triple 6-stage bilinear APF comb filter
    - Distortion.hpp — Block 4: dual-zone SC/HC/WF drive
    - VcaBlock.hpp — Block VCA: bipolar attenuverter linear VCA
    - LPFilter.hpp — Blocks 5 & 6: Simper trapezoidal SVF LP, 1V/oct
    - HPFilter.hpp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
2026-05-25 fix: resolve Windows linker ODR error and comb bypass architecture
    AllPassComb.hpp: static constexpr float F_REF[3] is ODR-used by the
    MinGW linker (array subscript forces address emission). Replace with a
    function-local static const, which is always safe in header-only code
    under C++11.
    Pogo.cpp: combBypass crossfade was applied inside TripleAPF::process()
    (pre-distortion), leaving combOutL/combOutR unused and bypassing the
    dry/wet blend before distortion rather than after. Fix: call APF with
    combBypass=1.0 for full wet output, then apply the crossfade after the
    per-group distortion sum — correct per the signal chain spec.
    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
2026-05-25 feat: 2× oversampling on Blocks 3+4, onSampleRateChange, STATUS.md ✅
    src/Pogo.cpp:
    - Add dsp::Upsampler<2,8> + dsp::Decimator<2,8> for Blocks 3+4.
    Upsample pre-APF signal, run APF comb + distortion at 2× rate
    (coefficients computed at 2*sampleRate), decimate back. Eliminates
    aliasing from the nonlinear distortion stage as required by Phase 2 spec.
    - distTapL/R updated each oversample step so APF feedback blend path
    is coherent at 2× rate.
    - Add onSampleRateChange() — calls onReset() to flush frequency-
    dependent filter state on rate transitions.
    - upL/upR/decL/decR included in onReset().
    specs/STATUS.md:
    - Mark Phase 6 ✅ for all 11 blocks + mod architecture.
    - Update Next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
2026-05-25 docs: correct STATUS.md — res/Pogo.svg is complete, not a placeholder
    Audit confirmed all 56 widget positions in the SVG match the C++ layout
    exactly. All zones, labels, dividers, and switch position markers are
    present. No remaining items before hardware validation.
    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
2026-05-25 fix: remove duplicate labels, fix slider SVG conflict, set PogoSlider horizontal=false
    - Remove addLabel() function and all ~80 call sites; all text labels are
    authoritative in res/Pogo.svg and were double-rendering before this change
    - Remove static SVG <rect> track+handle elements for LP2 and HP sliders
    that conflicted with the interactive PogoSlider widget
    - Explicitly set horizontal = false in PogoSlider constructor for clarity
    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
2026-05-25 fix: correct SVG panel height from 133.35mm to 128.5mm (VCV Rack 3U = 380px)
    133.35mm is the full Eurorack mechanical height (including rail-mounting zone).
    VCV Rack expects 128.5mm (380px at 75 DPI) for a 3U panel — it draws its own
    rails on top. The 4.85mm excess caused the module to overflow the rack slot.
    - SVG width/height and viewBox updated to 203.20 × 128.5mm
    - Background rect height updated to 128.5
    - Bottom dark stripe moved from y=128.85 → y=124.0 (4.5mm before new bottom)
    - Bottom mounting hole circles moved from cy=128.25 → cy=123.4 (5.1mm from bottom)
    - Zone separator lines clipped from y2=128.85 → y2=124.0
    All widget positions (y=16–118mm) unchanged — they're we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
2026-05-25 DSP audit: align all blocks with hardware circuit specs
    - InputBuffer: clamp ±11.5→±11.0 V (LM4562 swing on ±12V rails)
    - PreGain: replace tanh with hard clip per spec Phase 2 (clamp(5×v, ±10.5))
    - AllPassComb: F_REF {200,2000,10000}→{200,1500,6000} Hz (spec Phase 1 defaults)
    - Distortion: softClip drive=exp(d×4)-1 so d=0 is unity gain (spec 9am=clean)
    - VcaBlock: rewrite accent/duck law — AMT=0→G=1 always (spec Phase 1 edge cases)
    - LPFilter: replace static F_REF with instance fref member; LP2 sets fref=2500 Hz
    - Pogo: fix envelope routing (each ch follows its own audio, MOD SRC selects combo)
    - Pogo: LP1/LP2/HP cutoff param range ±4→±5 V/oct; LP2 default 0→2.0 V
    - Pogo: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
2026-05-25 Panel: shift 19 CV jack row down 5 mm to prevent PCB body collisions
    ATT row (cy=109) and CV jack row were 9 mm apart center-to-center.
    9 mm pot + 11–13 mm Thonkiconn bodies cannot coexist on a 1.2 mm PCB.
    Moving the jack row to cy=123 (14 mm spacing) resolves the conflict.
    ATT positions unchanged. Labels shifted to y=128 (still within 128.5 mm panel).
    MOD IN (primary mod source, not a mod destination) stays at cy=118.
    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
2026-05-25 Redesign hardware from 4-board to 3-board architecture
    Replace separate left/right audio boards with a single combined audio board
    (~200×100mm, 4-layer). L-channel occupies the left half, R-channel the right
    half, separated by a 4mm center GND guard strip on all copper layers.
    Utility→Audio connection changes from two 40-pin IDC ribbon cables (CN_UTIL_L/R)
    to two 40-pin face-to-face stacking headers (STK_AUDIO_L/R) with 8mm M3 standoffs.
    Pin assignments are identical; connector technology changes only. Stacking headers
    eliminate ribbon cable coupling for I_abc lines (further improving H2/H3 noise
    margins) and reduce total module depth from ~55mm to ~31mm — within standard
    Doepfer case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
2026-05-25 Add KiCad utility board schematic generator and validator
    generate_utility_board.py produces pogo-utility-board.kicad_sch — the
    second board in the 3-board POGO architecture. Covers 22 ICs:
    CN1/2/3/6: control board IDC ribbon inputs + Eurorack power header
    U1 TL074: L/R audio input buffers + ENV source selector
    U2 TL072: mod bus AMOUNT scaler + OFFSET adder
    U3 TL072: COMB BYPASS summing amp (main wiper + mod att) + MODBUS_NORM drive
    U4 TL072: FB DIST BLEND crossfade (3 post-dist chains × L+R)
    U5 TL074: WIDTH buffer + POLARITY switch processing
    U6–U10 TL074: 19 mod-destination attenuverters (4 per IC)
    U21 TL074 + U22 TL072: FB1/2/3 and DRIVE1/2/3 main-wiper + att su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
    [pogo-control-board.kicad_sch, pogo-utility-board.kicad_sch]
2026-05-25 Replace occurrence-counting validator with coordinate-based pin verification
    validate_utility_board.py now monkey-patches generate_utility_board's
    connect_pin and place_symbol to capture every expected (ref, net, x, y)
    tuple from the generator itself, then verifies each one exists at the
    exact coordinate in the actual schematic.
    Coverage: 477 pin assignments across 28 components (CN6/CN1/CN2/CN3,
    STK_L/STK_R, U1–U22). Catches pin swaps, wrong nets, missing labels,
    and connector pinout mismatches that occurrence-counting cannot detect.
    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
2026-05-25 docs: update README with current file structure and accurate status
    - File tree: add utility board generator/validator, noise-audit.md,
    all DSP headers, panel.html, kicad-process.md correct location
    - Phase 6 stages: all DSP blocks marked complete (matches STATUS.md)
    - KiCad board table: utility board ✅ complete, audio board ⬜ next
    - CI triggers: add dev branch
    - Add utility board coordinate-based validator description
    - Fix repo structure kicad-process.md was listed inside kicad/
    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
2026-05-25 Add KiCad footprints from primary sources (github.com/KiCad/kicad-footprints)
    10 footprints fetched verbatim from official KiCad library and committed:
    Package_SO.pretty/
    SOIC-8_3.9x4.9mm_P1.27mm.kicad_mod (TL072, LM4562, NE5532, THAT2180)
    SOIC-14_3.9x8.7mm_P1.27mm.kicad_mod (TL074 quad op-amp)
    SOIC-16_3.9x9.9mm_P1.27mm.kicad_mod (LM13700 OTA, CD4053, THAT340)
    Connector_IDC.pretty/
    IDC-Header_2x08_P2.54mm_Vertical.kicad_mod (16-pin power header)
    IDC-Header_2x12_P2.54mm_Vertical.kicad_mod (CN3 24-pin)
    IDC-Header_2x17_P2.54mm_Vertical.kicad_mod (CN1/CN2 34-pin)
    IDC-Header_2x20_P2.54mm_Vertical.kicad_mod (CN_UTIL 40-pin)
    Connector_PinHeader_2.54mm.pretty/
    PinHe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
2026-05-26 Add ALPS RS4515N slide potentiometer footprint from datasheet
    Source: ALPS Alpine product catalog RV06_RS1 series (RS**1 Series),
    Drawing No.1 — confirmed as the 15mm travel, single-unit vertical variant.
    All dimensions read directly from the PDF mechanical drawings.
    Dimensions extracted (unit: mm):
    Body: 30 x 8 mm
    Travel: 15 mm
    Terminal pins: 3 x φ1.5 mm drill holes
    Pin conductor: 0.4 mm square
    Pin span: 20 mm (pin 1 CCW to pin 3 CW, along travel axis)
    Pin col offset: 5 mm from each body end
    Row separation: 2 mm (pin 2 wiper offset from pin 1/3 row, perpendicular to travel)
    Front-edge to pin 2 row: 3.75 mm (from mounting hole dimension diagram)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
2026-05-26 Convert panel SVG text to paths for VCV Rack compatibility
    VCV Rack's nanosvg renderer does not support <text> elements — they are
    silently ignored, causing all labels to disappear at runtime.
    Converted all 89 <text> elements to <path> outlines using:
    inkscape --export-text-to-path --export-plain-svg
    Result: 0 text elements, 470 paths. Panel dimensions unchanged (203.2×128.5mm,
    40HP×3U). All labels (POGO title, zone headers, knob/jack names, footer) are
    now rendered as filled vector paths and will display correctly in VCV Rack 2.
    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
2026-05-26 Fix panel SVG height/viewBox to prevent vertical offset in VCV Rack
    The footer text sits at y=132.0, outside the old viewport (128.5mm),
    causing SVG renderers to expand/shift the viewport downward and producing
    a visible vertical offset when the panel loads in VCV Rack.
    Corrected to match specs/panel-design/panel.svg (the authoritative source):
    height: 128.5mm → 133.35mm
    viewBox: 0 0 203.20 128.5 → 0 0 203.20 133.35
    No element positions changed. Width (203.20mm, 40HP) unchanged.
    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
2026-05-26 Set f_ref = 632 Hz for LP1, LP2, and HP filter (all three filters unified)
    All three filters (LP1/LP2/HP) now use 632 Hz as the 1V/oct reference frequency
    at 0 V, giving a consistent ±5 V sweep of ~20 Hz to ~20 kHz across the full
    practical audio range.
    Code changes:
    - LPFilter.hpp: fref default 630 → 632; update comment (both LP1 and LP2)
    - HPFilter.hpp: F_REF 300 → 632; update comment range
    - Pogo.cpp: remove lp2L/lp2R fref=2500 override (LP2 now uses struct default);
    HP_CUTOFF_PARAM default 0.0 → -3.0 V (632 × 2^-3 ≈ 79 Hz ≈ spec 80 Hz default)
    Spec updates:
    - block-5-lp1/spec.md: f_ref 630 → 632 Hz in derivation and trim pot target
    - block-6-lp2/spec.md: default "8 kHz"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
2026-05-26 Replace Block 3 APF comb with triple SVF bandpass resonators (F1/F2/F3)
    Replaces three 6-stage all-pass comb chains with three independent 2-pole
    OTA-C SVF bandpass resonators — one per formant group — to produce strong,
    independent vocal formant peaks instead of a phaser/comb sound.
    DSP changes:
    - src/dsp/BandpassSVF.hpp: new TripleBandpass/SVFGroup using Andrew Simper
    trapezoidal SVF, tapping v1 (BP output). f_ref = {200, 1500, 6000} Hz at 0V.
    fbParam [0,1] → Q ∈ [0.5, 50]. POLARITY = output inversion. FB_DIST_BLEND
    adds post-dist signal additively to SVF input (not a crossfade feedback loop).
    - src/dsp/AllPassComb.hpp: deleted
    - src/Pogo.cpp: swap TripleAPF→TripleBandpass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
2026-05-26 Update all markdown docs for Block 3 APF → SVF bandpass topology change
    - STATUS.md: rename Block 3 row to "Triple Bandpass SVF"
    - CLAUDE.md: AllPassComb.hpp → BandpassSVF.hpp; update modulation destination
    names (APF Feedback → SVF Resonance, APF FB Dist Blend → FB Dist Blend);
    remove stale APF/comb template bullet; update power budget
    - README.md: title, signal chain ASCII art, Stage 6 description, DSP file
    tree, cap values (150/22/4.7 nF), IC count (15→11 per channel)
    - module-overview.md: Block 3 description, Block VCA (V2164→THAT 2180),
    LP1/LP2 topology label (Sallen-Key→OTA-C SVF), destination names, power budget
    - mod-architecture.md: SOURCE switch note, all APF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
2026-05-26 TESTING: 4-pole bandpass SVF (2x cascaded stages per group)
    SVFGroup now runs two 2-pole SVF stages in series (shared coefficients,
    independent state). Rolloff doubles to 12 dB/oct per side; effective
    bandwidth at same Q setting narrows to ~64% of the 2-pole width.
    Spec still says 2-pole. See STATUS.md divergence table for the full
    delta before deciding whether to update specs + hardware docs.
    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
2026-05-26 Normalize 4-pole BP output by 1/Q² — Q controls bandwidth, not gain
    4-pole cascaded BP has peak gain Q². Without normalization, anything
    above Q~2 saturates the ±10.5V clamp before distortion, making the
    clamp itself the dominant distortion source. Dividing by Q² gives
    unity peak gain at all Q settings: Q knob shapes bandwidth only,
    and distortion receives a clean bandpass-filtered signal.
    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
2026-05-26 Exponential Q taper 0.5–200; 1/Q² normalization retained
    Linear Q 0.5–50 cramped the useful string (Q 5–30) and woodwind
    (Q 30–100) ranges into awkward knob positions. Exponential taper
    Q = 0.5 × 400^qParam spreads the full musical range across the knob:
    25% → Q 5 (string body), 50% → Q 10, 75% → Q 44 (woodwind bore),
    100% → Q 200 (very tight). 1/Q² normalization unchanged — output
    peak stays at unity, Q only shapes bandwidth.
    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
2026-05-26 Show Hz in formant FREQ knob tooltips; rename Comb→Formant params
    FormantFreqQuantity overrides getDisplayValueString() to convert the
    V/oct knob value to Hz (or kHz) using each group's reference frequency
    (200 / 1500 / 6000 Hz). Tooltip now reads e.g. "280.0 Hz" or "1.50 kHz"
    instead of "0.00 V/oct". Also renames configParam labels from "Comb N"
    to "Formant N" and "Feedback" to "Q" throughout Block 3.
    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
2026-05-26 Fix HP filter output formula — v3 → x in Simper SVF HP tap
    HP output must be x - k*v1 - v2 (standard Simper SVF). v3 = x - ic2
    is an intermediate scratch variable, not the input. Using v3 produced
    a near-zero signal at low frequencies (derivative-of-LP behavior),
    which explained the slider appearing to do almost nothing but cause
    phase artifacts.
    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
2026-05-26 Panel layout: fix viewBox height and reposition all controls
    - SVG viewBox: 133.35mm → 128.5mm (match VCV Rack RACK_GRID_HEIGHT)
    - Bottom CV jacks (21): y=123mm → y=118mm; 7mm clearance to rail
    - All middle controls shifted +2mm to vertically center between
    top jacks (y=16) and bottom jacks (y=118), 7mm padding each side
    - All 18 attenuverters: y=109mm → y=111mm (1mm gap to new jacks)
    - SVG text labels shifted to match: +2mm middle, -5mm jack labels,
    branding moved from dead zone (130mm) into bottom strip (~126.5mm)
    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
2026-05-26 LP1/LP2/HP: exponential Q taper for self-oscillation at max resonance
    Switch LP and HP filters from linear Q (0.5–50, no self-osc) to
    exponential Q = 0.5 × 4000^resParam (0.5–2000). At max resonance,
    ring time at 1 kHz is ~637 ms — clearly self-oscillating. Top ~5% of
    the knob travel is self-oscillation territory; the 0–90% range remains
    musically useful (Q 0.5–872, ring < 280 ms).
    Bandpass SVF is unchanged (1/Q² normalization is intentional — formant
    shaper, not resonator). Fix stale BandpassSVF.hpp comment (Q range is
    [0.5, 200], not [0.5, 50]).
    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
2026-05-26 VCA: 5 V = unity at full CW (was 10 V)
    Normalize CV against 5 V instead of 10 V so that a typical envelope
    peak (5 V) fully opens the VCA at AMT = +1. Values above 5 V saturate
    at G = 1 (no overshoot). Duck mode symmetrically closes at 5 V.
    AMT = 0 center-detent unity behavior is unchanged.
    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
2026-05-26 BAND OUT: tap HP bandpass (v1) instead of LP1 output
    HPFilter now stores prevBP = v1 after each process() call.
    BAND_L/R_OUTPUT reads hpL/hpR.prevBP — the bandpass output of the
    HP SVF stage (full signal chain: formants → dist → VCA → LP1 → LP2 → HP).
    Updated enum comment and configOutput labels to match.
    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
2026-05-26 STATUS: freeze specs during topology investigation
    Active experiment on topology_change: routing candidate is
    VCA → LP1 → Triple BP → HP → LP2. Spec/audio-intent updates
    for affected blocks are frozen until plugin experiments resolve.
    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
2026-05-26 Replace envelope follower with dual LFOs, add alt BP3 inputs, SVG dual-versioning
    - Block 2 (envelope follower) removed; replaced with two independent triangle-wave
    LFOs (LFO1 normalizes to mod bus when MOD_IN unpatched; LFO2 is standalone)
    - MOD_SRC_PARAM switch removed; LFO1 auto-normalizes to mod bus
    - LFO1/LFO2 SPEED knobs (±5V output, 0.05–20 Hz exponential taper)
    - Red LEDs for LFO1, LFO2 values and live MOD bus signal
    - ALT_BP_L/R input jacks at y=24: when patched, replace pgL/pgR as Triple BP3
    input only; R normalizes to L alt if only L patched; COMB BYPASS dry path
    always uses pgL/pgR
    - src/dsp/LFO.hpp: new triangle-wave phase-accumulator LFO DSP class
    - res/Pogo-source.svg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
2026-05-26 Topology reorder: VCA → LP1 → Triple BP+Dist → HP → LP2
    Previous chain: PreGain → [BP+Dist] → VCA → LP1 → LP2 → HP
    New chain: PreGain → VCA → LP1 → [BP+Dist] → HP → LP2
    VCA and LP1 now shape the signal before it hits the formant filters,
    so the bandpass acts as a spectral insert rather than a pre-drive stage.
    HP comes immediately after the oversampled section, LP2 is the final
    low-pass output stage.
    Alt BP3 jacks now bypass VCA+LP1 (not just PreGain) when patched.
    COMB BYPASS dry is the LP1 output (or alt BP if patched).
    BAND OUT tap remains hpL/hpR.prevBP.
    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
2026-05-26 MOD BUS: move jack to left column, LED inline to right at same row
    MOD IN jack: x=5.08 cy=118 (was centered at x=10.16)
    MOD LED: x=15.24 cy=118 (was above jack at cy=113)
    Both sit on the same horizontal row, matching standard jack-row layout.
    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
2026-05-26 MOD BUS: center section title vertically between separator and knob top
    Shift separator (91→94.2) and title (y=96→99.2) down 3.2mm so the
    gap above the label equals the gap below it to the AMOUNT knob top.
    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
2026-05-26 LFO section panel layout: 13mm LED→knob→jack spacing, remove small labels
    - LED cy: 61 → 56, SPEED knob cy: 66 → 69 (13mm center-to-center each tier)
    - Remove small "LFO 1"/"LFO 2" text labels above LEDs and below jacks
    - LFO section title y: 45.5 → 49.5 (symmetric gap with separator at 42.5)
    - Update Pogo.cpp widget positions to match (LFO1/2_LIGHT y=56, SPEED y=69)
    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
2026-05-26 LFO section: swap LED/knob order, reduce c-to-c to 2/3 (8.67mm)
    SPEED knob at cy=64.7, LED at cy=73.3, jack at cy=82. Knob now
    above LED with label between them, LED adjacent to output jack.
    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
2026-05-26 LFO section: balance text-to-LED and LED-to-jack gaps (4mm each)
    Knob cy 64.7→62.6, SPEED label y 70.2→68.1. Gap from SPEED baseline
    to LED top equals gap from LED bottom to jack top (both 4.0mm).
    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
2026-05-26 LFO section: center title/divider with symmetric 3.32mm gaps
    Separator y 42.5→51.78, title y 49.5→56.78. Gap from divider line to
    title top equals gap from title baseline to SPEED knob top (3.32mm each),
    matching the MOD BUS section treatment.
    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
2026-05-26 INPUT/GAIN section: reorder to L IN/R IN → GAIN switch → ALT L/ALT R
    All four jacks labeled (L IN, R IN, ALT L, ALT R). GAIN switch moves
    between the two jack rows (cy=26), ALT BP jacks move to cy=38 with
    labels below. GAIN label above switch, 1×/5× position labels below.
    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
2026-05-26 INPUT/GAIN: align L/R IN labels with L/R OUT style, relabel BP3, brighten
    - L IN/R IN labels move below jack (y=24.5) with border rects, matching
    L OUT/R OUT treatment (cy=16 jacks were already aligned)
    - GAIN switch cy 26→32, labels bright #888 (was dim #3d5260)
    - ALT jacks cy 38→43, relabeled ALT L/R → BP3 L/BP3 R at y=49.5
    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
2026-05-26 Standardize all jack label spacing to cy+6.5 (3mm jack-bottom-to-baseline)
    Matches BP3 L/R reference spacing across all 30 jacks:
    - cy=16 inputs (L IN, R IN, CV IN): y 24.5→22.5
    - cy=16 outputs with rect (HP BP L/R, LEFT, RIGHT): text y 24.5→22.5, rect y 22.74→20.74
    - cy=82 LFO outputs: text y 89.0→88.5, rect y 87.24→86.74
    - cy=118 CV jacks: y 123/123.5→124.5, fill #777→#888
    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
2026-05-26 Attenuverter spacing: cy=111→102 (16mm above jacks); jack labels +0.5mm
    Research: Thonkiconn nut OD ~8.5mm, Alpha 9mm bushing OD 7mm,
    practical min c-t-c 15mm, minimum+1mm = 16mm → att cy = 118-16 = 102.
    All 18 attenuverter params and SVG circles/indicator lines updated.
    Also increased all jack label spacing by 0.5mm (jack bottom to text top
    now 2.38mm) so output border rects have more clearance from jack bodies.
    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
2026-05-26 panel: tighten attenuverter-to-jack spacing to 10.75mm
    Moved all 18 attenuverters from cy=102 to cy=107.25 in SVG and Pogo.cpp.
    Spacing is now nut-to-nut minimum (Thonkiconn 5mm radius + Alpha 9mm hex nut
    5.5mm radius = 10.5mm) plus 0.25mm safety margin. Indicator lines updated
    from y1=102/y2=99.5 to y1=107.25/y2=104.75.
    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
2026-05-26 design: add rail keep-out zone visualization
    panel-keepout.html overlays Eurorack mounting rail keep-out zones (10mm
    from each panel edge) with Thonkiconn nut and Alpha 9mm hex nut footprint
    circles, revealing that the bottom jack row at cy=118 extends 4.5mm into
    the bottom rail keep-out zone.
    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
2026-05-26 tools: add data-driven panel build tool
    Introduces tools/build_panel.py and supporting modules to replace hand-editing
    of res/Pogo-source.svg. All component positions are now defined in
    tools/panel-data.yaml; SVG, debug HTML, manufacturing SVG, and C++ widget stubs
    are generated outputs.
    - tools/panel-data.yaml — source of truth for all component positions and design rules
    - tools/build_panel.py — CLI: --resource, --design, --mfr, --cpp, --check
    - tools/panel_svg.py — SVG primitive functions (jack, knob, att, switch, LED, slider)
    - tools/panel_rules.py — DesignRules class + DRC violation checker
    - tools/panel_cpp.py — C++ widget stub generator (Pogo.cpp style)
    - desig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
    [panel-data.yaml]
2026-05-26 Fix keep-out layer coordinates; add nuts and PCB footprint overlay layers
    - _wrap_svg_in_layers: use raw mm values (10.0, 118.5, 203.2, 128.5) instead of
    scale-multiplied pixel values — keep-out rects were rendering 4× too large
    - Add _collect_overlay_positions to gather jack/pot/knob centers from resolved components
    - Add layer-nuts: yellow circles r=5mm (jacks), blue r=5.5mm (pots), orange r=knob_r (knobs)
    - Add layer-pcb: KiCad courtyard rects — Thonkiconn x∈[-5,5] y∈[-1.42,12.98],
    Alpha 9mm shaft-relative x∈[-8.65,5.1] y∈[-6.67,6.67]
    - build_html accepts data kwarg; main() passes it through
    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
2026-05-26 Add PCB placement DRC: courtyard overlap and mounting hole clearance checks
    panel_rules.py:
    - Add JACK_CY and POT_CY courtyard constants from KiCad footprints
    (Thonkiconn: x±5 y[-1.42,+12.98]; Alpha 9mm shaft-relative: x[-8.65,+5.1] y±6.67)
    - Add _get_courtyard(), _rect_overlap(), _comp_label() module-level helpers
    - Add _check_nut_keepout(), _check_pcb_overlaps(), _check_mounting_clearance() passes
    - check_all() now accepts mounting_holes and runs all three passes
    - Violations tagged: [NUT KEEPOUT], [PCB OVERLAP], [MH CLEARANCE]
    build_panel.py:
    - run_drc() passes mounting_holes from YAML data
    - HTML DRC report groups violations by tag in collapsible <details> sections
    with per-catego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
2026-05-26 Fresh start: 60HP skeleton panel; fix hardcoded panel dimensions in build tool
    panel-data.yaml: replace 40HP POGO data with clean 60HP skeleton.
    Empty zones/separators/zone_labels — ready for section-by-section build.
    Mounting holes at x=7.5 and x=297.30 for 60HP.
    - _scale_svg_for_html: extract W/H from SVG width="Xmm" instead of hardcoding 203.20
    - _wrap_svg_in_layers: derive W/H from scaled px attributes instead of hardcoding
    - _build_svg_lines: replace hardcoded zone-map comment with generic spacing reference
    - mounting hole comment no longer hardcodes x values
    Tool now works correctly for any HP width.
    https://claude.ai/code/session_01JzWGptzLTqFkAZDHVU6Z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
    [panel-data.yaml]
2026-05-26 Set standard jack pitch to 3HP (15.24mm)
    Gives 5.24mm gap between Thonkiconn courtyards and 1.49mm gap between
    Alpha 9mm pot courtyards — both clean with no DRC violations.
    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
2026-05-26 Add Section 0 (INPUT / LFO / MOD BUS) to 60HP panel — DRC PASS
    Section occupies HP 3–9 (x=15.24–45.72mm), two columns at cx=20.32 and cx=35.56 (3HP pitch).
    Zone 0a INPUT/GAIN: L_IN, R_IN stereo inputs (cy=16), GAIN switch 1×/5× (cy=32),
    BP3_L/R alternate bandpass inputs (cy=44).
    Zone 0b LFO: LFO1/2 speed trimpots (cy=66), activity LEDs (cy=75),
    LFO1/2 output jacks (cy=82).
    Zone 0c MOD BUS: AMOUNT/OFFSET trimpots (att_cy=101.75),
    MOD IN jack + activity LED (cv_jack_cy=112.5).
    All PCB courtyard clearances verified: tightest gap is 0.10mm between
    LFO output jacks and MOD att row. Mounting hole clearance 7.82mm. Zero violations.
    https://claude.ai/code/session_01JzWGptzLTqFkAZDHV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
    [panel-data.yaml]
2026-05-26 Add column-relative positioning, --list/--next query, switch/LED DRC, rail overlap fix
    - Column-relative zones: col: N in YAML resolves to cx = x_start + (N+0.5)*col_pitch
    (no more manual cx arithmetic when building section by section)
    - --list: print table of all resolved component positions
    - --next ZONE_ID: print right boundary of a zone = x_start for the next section
    - Switch/LED PCB footprints: SWITCH_CY, SWITCH_PANEL_R, LED_CY, LED_PANEL_R added to
    panel_rules.py; _check_nut_keepout and _check_pcb_keepout cover switches and LEDs;
    visual overlays added in debug HTML (magenta = switch, green = LED)
    - [PCB KEEPOUT] is informational (non-blocking): --check exits 0; HTML renders in bl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
    [panel-data.yaml]
2026-05-26 Fix PCB keepout to be a real error; recalculate bottom-row component positions
    PCB is bounded by the Eurorack rail at y=118.5mm. [PCB KEEPOUT] is now a blocking
    DRC error, not informational.
    The Thonkiconn PCB courtyard extends 12.98mm below the panel hole, so:
    cv_jack_cy ≤ 118.5 - 12.98 = 105.52mm (was 112.5, courtyard was at 125.48mm)
    With the corrected cv_jack_cy=105.0, the Alpha 9mm pot at att_cy must also clear
    the LFO output jacks above it (requires 19.65mm gap, jack+pot courtyard combined).
    This forced att_offset from -10.75 to -8.5 (att_cy=96.5) and LFO_OUT from cy=82
    to cy=76.
    LEDs moved to the same cy as the output jacks with 5.5mm lateral offset inward
    (cx=28.36/32.60) —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
    [panel-data.yaml]
2026-05-26 Add distance queries, snap-to, zone-bbox, and component rotation support
    - _rotate_rect(): rotate a (x1,y1,x2,y2) courtyard constant 0/90/180/270° CW
    - _get_courtyard(): now accepts rotate= param; applies _rotate_rect before positioning
    Key use case: jack rotate=180 flips body above hole (cy+1.42) instead of below
    (cy+12.98), enabling bottom-row jacks without hitting rail PCB keepout
    - _rect_min_gap(): signed min edge-to-edge gap; positive=clear, negative=overlap depth
    - get_panel_r(): panel-face nut/hole radius for any component type
    - All DRC methods pass int(comp.get("rotate", 0)) to _get_courtyard
    --dist ID1 ID2 Center-to-center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
2026-05-26 Add panel tool guide and Claude Code skills
    tools/panel-tool-guide.md:
    - Full CLI reference with real output examples
    - YAML field reference (zone structure, component types, separators)
    - PCB constraint tables (courtyard dimensions, min gap formulas)
    - Section addition workflow
    - Pre-engineered sub-agent prompt templates:
    * Add a generic 6HP section
    * Fix DRC violations
    * Add a CV jack + attenuverter pair
    * Verify clearance before placing a component
    .claude/commands/panel-section.md (/panel-section skill):
    - Injects full context for section-addition workflow
    - Hard constraints table, column-relative YAML examples
    - Step-by-step DRC-gated workflow
    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
2026-05-26 Add panel-face nut clearance DRC; fix Section 0 layout violations
    [NUT CLEARANCE] is a new DRC category checking that panel-face nut/hole
    circles do not overlap. Three violations existed in Section 0:
    - LFO1/2_LED ↔ LFO1/2_OUT: LEDs at same cy as jacks, 5.5mm apart
    (need ≥6.6mm). Fix: move LEDs to col=0/1, cy=82 (below jacks).
    - MOD_AMOUNT ↔ MOD_IN: att_cy=96.5 gave 8.5mm gap (need ≥10.5mm).
    Fix: att_offset -8.5→-10.75 (att_cy=94.25, 10.75mm gap).
    LFO_OUT moved from cy=76 to cy=74.5 to maintain ≥19.65mm PCB courtyard
    gap above MOD_AMOUNT pots (jack-above-pot PCB constraint).
    All violations are now verbose: include cx/cy of each component and a
    specific fix suggestio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
    [panel-data.yaml]
2026-05-26 Add KiCad footprint overlay layer to panel debug viewer
    New 'KiCad Footprints (actual)' overlay layer renders the real .kicad_mod
    geometry (F.CrtYd courtyard, F.Fab body outline, F.SilkS silkscreen, and
    through-hole pad markers) for all jack and pot components.
    - tools/panel_kicad.py: parses fp_line, fp_circle, pad primitives from
    .kicad_mod files and emits positioned, rotated SVG <g> groups
    - Jack origin = panel hole centre (no offset needed)
    - Pot origin = pin 1; shaft centre is at (7.5, 2.5) in footprint coords,
    so tx/ty are adjusted so the shaft lands at the component's cx,cy
    - 15 components rendered (187 lines + 59 circles per build)
    Overlay legend updated to explain all KiCad lay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
2026-05-26 Fix jack footprint alignment; add LED and switch footprints
    - panel_kicad.py: change jack offset from (0,0) to (0,6.48) so the
    F.Fab/F.SilkS barrel body circle aligns with the panel hole symbol in
    the SVG overlay, matching user expectation. DRC (panel_rules.py) is
    unaffected — JACK_CY remains measured from the sleeve/panel hole centre.
    - panel_kicad.py: add LED (led, led_labeled) and switch (switch_H2/H3/V3)
    entries to _FOOTPRINT_MAP, referencing new custom footprints.
    - panel_kicad.py: add green cross-hair origin marker at each component's
    panel anchor (cx, cy) in the KiCad overlay layer for clarity.
    - kicad/footprints/LED_THT.pretty/LED_D3.0mm.kicad_mod: new footprint.
    F.C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
2026-05-26 Remove F.CrtYd from KiCad layer; courtyard from layer-pcb only
    The KiCad layer uses a visual anchor (barrel body centre for jacks) that
    differs from the DRC courtyard reference (sleeve/panel hole centre). Keeping
    F.CrtYd in both layers caused them to render at different positions for the
    same component, creating confusing boundary overlap.
    Fix: suppress F.CrtYd rendering in panel_kicad.py entirely. The layer-pcb
    overlay (panel_rules.py JACK_CY / POT_CY / etc.) remains the single
    authoritative courtyard source. Also remove the stale legend entry.
    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
2026-05-26 Fix PCB overlap detection and resolve 4 missed violations
    panel_rules.py: _check_pcb_overlaps previously filtered to only jack and
    pot types, silently ignoring switch↔jack and led↔jack conflicts. Remove
    the type filter — the function now checks every component that has a PCB
    courtyard via _get_courtyard().
    panel-data.yaml: fix the 4 violations that were undetected:
    GAIN switch (cy=32): PCB body bottom at y=39.5 overlapped L_IN and
    R_IN jack bodies (bottom y=28.98) by 0.48mm. Move to cy=34 giving
    1.52mm clearance above and 1.08mm to BP3_L/R below.
    LFO1_LED / LFO2_LED (cy=82, col 0/1): placed directly below
    LFO1_OUT / LFO2_OUT jacks at cy=74.5, falling 5.5mm deep inside
    ea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
    [panel-data.yaml]
2026-05-26 Revert jack KiCad offset to (0,0) — sleeve at panel hole
    Offset (0, 6.48) moved the sleeve pad and F.Fab body lines 6.48mm above
    cy in panel space. For MOD_IN at cy=105 this placed the S pad at y=98.52,
    visually inside MOD_AMOUNT's trimpot footprint area (y=87.58–100.92),
    making it look like a real conflict even though no physical overlap exists.
    Reverting to (0, 0): sleeve S pad renders at (cx, cy) = the actual panel
    hole centre. The F.Fab barrel body circle at footprint (0, 6.48) naturally
    appears 6.48mm below the hole — correct, since the barrel body sits behind
    the panel. The green origin cross-hair continues to mark the panel anchor.
    https://claude.ai/code/session_01JzWGptzLTqFk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
2026-05-26 fix jack panel-hole anchor: barrel centre at footprint (0, 6.48)
    Per WQP-PJ398SM datasheet the 6mm barrel opening is at footprint
    coord (0, 6.48), not at the sleeve pad origin (0, 0).
    panel_kicad.py: set jack offset to (0, 6.48) so the F.Fab barrel
    circle aligns with the green origin cross-hair at (cx, cy).
    panel_rules.py: shift JACK_CY y by -6.48 → (-5,-7.90,5,6.50) so
    PCB courtyard is relative to the barrel-centre anchor.
    panel-data.yaml layout adjustments to restore DRC PASS:
    - L_IN/R_IN cy 16→18 (PCB keepout: CrtYd top was 8.1mm, now 10.1mm)
    - GAIN switch cy 34→28, label/pos coords adjusted (gap to BP3 jacks)
    - LFO1_OUT/LFO2_OUT cy 74.5→79 (gap to LFO speed trimpots)
    -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
    [panel-data.yaml]
2026-05-26 zone_input: reduce jack-to-jack pitch to 2.25 HP (11.43 mm)
    col_pitch 15.24→11.43 mm; col 0 cx 22.86→20.955 mm, col 1 cx
    38.10→32.385 mm. GAIN switch cx and pos_xs updated to midpoint
    of new column centres (26.67 mm). DRC PASS.
    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
2026-05-26 zone_lfo: inline LEDs with their columns; raise cv_jack_cy to 112
    Each LFO now stacks vertically in one column: SPEED trimpot (cy=60)
    → LED (cy=69) → output jack (cy=82). Replaces the previous layout
    that placed both LEDs at a shared cx=30.48 centre position.
    cv_jack_cy 108→112 to give MOD trimpots (att_cy=97) sufficient
    clearance above the LFO output jacks (PCB CrtYd bottom = 118.50 mm).
    att_offset unchanged at -15.0. DRC PASS.
    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
    [panel-data.yaml]
2026-05-26 align all section-0 zones to 2.25 HP (11.43 mm) column pitch
    zone_lfo and zone_modbus col_pitch 15.24→11.43 so all three zones
    share the same column centrelines (col 0 cx=20.955, col 1 cx=32.385).
    Alpha RD901F courtyard is 13.75 mm wide (asymmetric, pins left of
    shaft). At 11.43 mm pitch two same-orientation pots overlap 2.32 mm.
    Fix: rotate col-1 pots 180° so pins face outward, giving a 1.23 mm
    gap between adjacent courtyards. DRC PASS.
    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
    [panel-data.yaml]
2026-05-26 fix: rotate footprint around visual anchor, not pin-1 origin
    _prims_to_svg was using translate(tx,ty) rotate(r) which rotates
    around the footprint pin-1 origin. For a pot with ox=7.5mm this
    placed the F.Fab body 15 mm off-screen when rotate=180.
    Correct transform: translate(cx,cy) rotate(r) translate(-ox,-oy)
    This keeps the visual anchor (shaft/barrel centre) fixed at (cx,cy)
    for all rotation values.
    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
2026-05-26 start fresh: zone_input only + LFO label placeholder
    Wipe zone_lfo and zone_modbus. Keep zone_input as-is (L_IN, R_IN,
    GAIN switch, BP3_L, BP3_R). Add INPUT→LFO separator at y=56mm and
    LFO zone label at y=60mm. No LFO components yet.
    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
2026-05-26 zone_input: push columns to left edge — col 0 at 2.25 HP (11.43mm)
    x_start 15.24→5.715mm so col 0 cx = 11.43mm (2.25 HP from panel
    left edge). col 1 cx = 22.86mm. GAIN switch and zone label x values
    updated to match. MH clearance: nearest point on L_IN CrtYd to top
    mounting hole = 5.0mm > 3.5mm minimum. DRC PASS.
    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
    [panel-data.yaml]
2026-05-26 zone_input: col 0 at 1.125 HP (5.715mm) from panel left edge
    x_start 5.715→0mm; col 0 cx=5.715mm, col 1 cx=17.145mm.
    GAIN cx=11.43mm, pos_xs updated. Zone labels and separator
    x1 updated to match. DRC PASS.
    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
2026-05-26 zone_input: center GAIN switch between jack rows, remove label_above
    - Remove label_above "GAIN" text (was at absolute y=22, far above switch)
    - Move GAIN switch to cy=34, centered between L_IN (cy=18) and BP3 (cy=50)
    - Move BP3_L/R down to cy=50 to achieve minimum safe clearance (0.6mm gap)
    - Update pos_y to 43.0 (just below switch CrtYd bottom at cy+7=41mm)
    - Move INPUT/GAIN→LFO separator from y=56 to y=62 (BP3 labels land at y=57)
    - Move LFO zone label from y=60 to y=66
    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
    [panel-data.yaml]
2026-05-26 zone_input: rotate all jacks 180°, tighten layout to cy=17/32/47
    Rotating jacks 180° flips the PCB body to the opposite side of the barrel,
    allowing the top row to sit at cy=17 (CrtYd top=10.5mm, 0.5mm above keepout)
    and the switch to be exactly centered at cy=32 between the two jack rows.
    - L_IN/R_IN: cy=17, rotate=180 (CrtYd bottom=24.9mm)
    - GAIN switch: cy=32 (centered, CrtYd top=28.5, bottom=39.5)
    - BP3_L/R: cy=47, rotate=180 (CrtYd top=40.5mm, 1.0mm gap from switch)
    - pos_y=41.5 (switch position labels just below switch body)
    - Separator moved to y=58, LFO label to y=62
    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
    [panel-data.yaml]
2026-05-26 zone_input: push GAIN switch to minimum clearance (cy=28.5)
    Switch CrtYd top (25.0mm) is now 0.1mm from L_IN CrtYd bottom (24.9mm) —
    the absolute minimum. Leaves 4.5mm gap above BP3. pos_y updated to 38.0.
    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
    [panel-data.yaml]
2026-05-26 zone_input: center GAIN switch — switch cy=31, BP3 cy=45
    Centering constraint: switch_cy = (L_IN_cy + BP3_cy)/2 = (17+45)/2 = 31.
    CrtYd boundaries just touch at both ends (0mm gap), DRC clean.
    Separator pulled to y=56, LFO label to y=60.
    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
2026-05-26 zone_input: remove hardcoded pos_y, use default cy+4 (2.8mm below switch body)
    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
2026-05-26 zone_input: add second GAIN switch, label MAIN/BP3 above each
    Split single centered GAIN switch into two column-aligned switches:
    - GAIN_MAIN (cx=5.715, col 0) with label_above "MAIN" → GAIN_PARAM
    - GAIN_BP3 (cx=17.145, col 1) with label_above "BP3" → ALT_GAIN_PARAM
    2.43mm gap between switch bodies; both DRC-clean.
    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
2026-05-26 zone_input: switches to col 2 right of pairs, BP3 collapsed to cy=31.5
    - GAIN_MAIN/GAIN_BP3 moved to cx=28.575 (col 2), flush right of jack pairs
    - GAIN_MAIN at cy=17 (same row as L_IN/R_IN)
    - GAIN_BP3 at cy=31.5 (same row as BP3 jacks)
    - BP3_L/R collapsed up to cy=31.5 (min clearance: 0.1mm gap from L_IN CrtYd)
    - Separator y=43, LFO label y=47
    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
    [panel-data.yaml]
2026-05-26 zone_input: center INPUT/GAIN label between strip bottom (y=4.5) and jack top (y=12)
    Label moved from y=12.0 to y=8.25 — midpoint of the dead space above the jacks.
    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
2026-05-26 zone_input: INPUT/GAIN label centered between rail hole (y=5.1) and zone separator (y=43)
    y = (5.1 + 43.0) / 2 = 24.05mm
    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
2026-05-26 zone_lfo: add LFO zone; fix zone_div color; add per-LED color support
    - zone_div color lifted from #2d2d2d to #555555 (visible on #0d0d0d bg)
    - svg_led/svg_led_labeled: accept fill/stroke overrides for per-component color
    - zone_lfo: two LFOs, each knob_medium (col 0, rotate=180) + blue LED (col 1)
    + jack_output (col 2), cy=57 and cy=72
    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
    [panel-data.yaml]
2026-05-26 zone_lfo: swap jack/knob to col 0/2, rename to Rate 1 / Rate 2
    Layout now: jack_output (col 0) | LED (col 1) | knob_medium (col 2).
    Knob labels updated from RATE to Rate 1 / Rate 2.
    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
    [panel-data.yaml]
2026-05-26 fix: separator lines never rendered — stale x-range guards removed
    The zone_div horizontal separators were gated on x2 < 21 OR x1 > 20.
    Our separator (x1=1.0, x2=35.06) matched neither condition and was
    silently dropped. Replaced both filtered loops with a single unconditional
    loop over all zone_div horizontal separators.
    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
2026-05-26 zone_lfo: tighten rows to match INPUT/GAIN label→jack gap (8.75mm)
    LFO1 cy: 57 → 55.75 (label y=47 + 8.75mm, matching INPUT/GAIN rhythm).
    LFO2 cy: 72 → 70.15 (LFO1 + 14.4mm jack-to-jack minimum).
    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
    [panel-data.yaml]
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2026-05-26 zone_mod: add MOD BUS section (SCALE, OFFSET knobs + MOD IN jack)
    Diagonal-stagger layout in 7HP col strip: SCALE knob_medium col 0
    rotate=180 at cy=84.375mm, OFFSET knob_medium col 1 at cy=97.715mm
    (13.34mm min pot-to-pot gap), MOD IN jack_input col 2 at cy=112mm
    (cv_jack_cy). Adds LFO→MOD BUS zone separator at y=76mm and
    "MOD BUS" zone label. DRC clean.
    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
2026-05-26 zone_mod: redesign MOD BUS — 2×2 knobs + 3-jack row
    SCALE+VCA AMT (col 0 rotate=180 + col 2, cy=83), OFFSET+VCA OFS
    (same cols, cy=96.34, 13.34mm min pot→pot gap), MOD IN + blue LED +
    VCA IN jacks (cols 0+1+2, cy=112). Cols 0 and 2 have 5.56mm x-gap
    so same-row placement is DRC-clean. Pot→jack bottom clearance 1.09mm.
    Zone label moved to y=78 (just above knob visual tops).
    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
    [panel-data.yaml]
2026-05-27 zone_mod: add 3-pos vertical MOD SRC slide switch; add V3 courtyard constant
    Switch at col 1 (cx=17.145), cy=89.67 — centred between the SCALE/VCA AMT
    and OFFSET/VCA OFS knob rows. Positions: LFO 1 / SUM / LFO 2.
    panel_rules.py: separate SWITCH_V3_CY (-2.0,-5.0,2.0,5.0) from the
    toggle-switch SWITCH_CY; 4mm-wide V3 courtyard leaves 0.78mm gap to
    col 0 and col 2 knob courtyards. SWITCH_V3_PANEL_R=1.0mm (panel slot
    half-width). DRC PASS.
    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
2026-05-27 zone_mod: change knob_medium → trimpot (small knob visual)
    All 4 MOD BUS knobs (SCALE, VCA AMT, OFFSET, VCA OFS) now render
    as small trimpots (r=2.5mm visual). PCB footprint (Alpha RD901F)
    and DRC clearances unchanged.
    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
    [panel-data.yaml]
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2026-05-27 zone_mod: replace single LED with 6 LEDs (2 per row)
    Two blue LEDs side by side between the trimpots on each row, plus
    the jack row. Panel face clearance is fine (11.86 mm between pot
    nuts). 4 PCB CrtYd corner-overlaps (1.22 mm) between inner LEDs and
    adjacent trimpot footprints — flagged, deferred to PCB layout.
    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
    [panel-data.yaml]
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2026-05-27 balance zone header spacing: D1=D2=2.5mm in LFO and MOD BUS
    LFO label: y 47→45.5; LFO components: cy +0.125mm (51.5, 65.9)
    MOD BUS separator: y 76→75.5
    MOD BUS label (78) and SCALE cy (83) unchanged — already land correctly.
    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
    [panel-data.yaml]
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2026-05-27 panel: LP1 rework — 7HP, 2.25HP jack/ATT pitch, new attenuverter type
    New component type: attenuverter
    - ATT_CY = (-5.0,-5.0, 5.0,5.0): compact Bourns PTV09A-style courtyard
    - ATT_PANEL_R = 4.5mm; fits 11.43mm (2.25HP) pitch with 1.43mm x-gap
    - Renders as knob_medium (r=4.5mm) visually
    - Own PCB overlay layer (teal) in debug HTML
    - Full DRC coverage (nut keepout, PCB keepout, panel clearance)
    LP1 zone: 9HP → 7HP (x=35.56–71.12mm, col_pitch=11.43mm)
    - ATTs changed from knob_medium → attenuverter (cols 0/1/2 at cy=97.0)
    - ATTs sit directly above their respective jacks (same column)
    - Main knobs (FREQ xl, TILT l, RES l) remain centred at col 1
    - All bottom jacks at cy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
    [panel-data.yaml]
2026-05-27 Replace attenuverter type with trimpot (Bourns 3296W) for LP1 ATTs
    - Remove the phantom 'attenuverter' component type from panel_rules.py,
    build_panel.py, and panel-data.yaml — it was never intended and had
    no proper PCB courtyard footprint.
    - Add TRIMPOT_CY = (-2.5, -5.0, 2.5, 5.0) and TRIMPOT_PANEL_R = 2.5
    in panel_rules.py for the Bourns 3296W Vertical trimpot, giving it
    a correct compact courtyard distinct from the Alpha 9mm pot (POT_CY).
    - _get_courtyard and get_panel_r now dispatch 'trimpot' to TRIMPOT_CY /
    TRIMPOT_PANEL_R rather than sharing POT_CY with full-size pots.
    - LP1_FREQ_ATT, LP1_TILT_ATT, LP1_RES_ATT changed to type: trimpot —
    matching VCA_AMT, VCA_OFS, SCALE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
    [panel-data.yaml]
2026-05-27 Add Bourns 3296W trimpot KiCad footprint; fix panel_kicad.py mapping
    - New footprint: kicad/footprints/Potentiometer_THT.pretty/
    Potentiometer_Bourns_3296W_Vertical.kicad_mod
    3-pin THT, 2.5mm pitch (pins at y=0/2.5/5.0), body 4.83×4.83mm,
    actuator Ø3mm circle at pin-2 centre. F.Fab + F.SilkS + F.CrtYd layers.
    - panel_kicad.py: trimpot now maps to Bourns_3296W_Vertical with
    anchor offset (0, 2.5) so the actuator/wiper centre aligns with
    the panel-hole position (cx, cy). Previously used Alpha RD901F —
    completely wrong geometry for a compact PCB trimpot.
    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
2026-05-27 Move LP1 ATT trimpots to cy=100.0mm; fix TRIMPOT_CY to match Bourns 3296W
    TRIMPOT_CY corrected from estimated (-2.5,-5.0,2.5,5.0) to the value
    derived from the actual footprint F.CrtYd relative to the actuator anchor:
    (-2.665, -3.385, 2.665, 3.385)
    The original estimate overstated the courtyard depth by 1.6mm per side.
    LP1 ATT row moved from cy=97.0 to cy=100.0mm — the maximum allowed by
    PCB courtyard clearance vs the jack row below (0.71mm gap at cy=100.0,
    binding constraint; 0.0mm gap limit is cy=100.715mm).
    Center-to-center ATT→jack now 12mm (was 15mm).
    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
    [panel-data.yaml]
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2026-05-27 Add docs/plugin-topology.md — new 48HP plugin topology spec
    Full parameter/input/output/light enums, per-block DSP behaviour,
    LP1 stereo tilt, BP section redesign (BP_MIX, TILT CV, unity sum),
    VCA_OFS, 3-LED mod bus, GAIN_BP3, BP3_OUT tap, DSP class reuse table.
    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
2026-05-27 Rewrite Pogo.cpp for 48HP panel redesign
    - New ParamId enum: 46 params matching panel-data.yaml
    (GAIN_MAIN/BP3, LFO1/2_RATE, MOD_SCALE/OFFSET, VCA_AMT/OFS,
    LP1 FREQ/TILT/RES + atts, BP_POL/DIST/OFFSET/MIX + atts,
    BP1/2/3 FREQ/FOCUS/DIST + atts, HP/LP2 FREQ/RES + atts)
    - New InputId: 24 inputs (replaced BYPASS/BLEND/MASTER_OFFSET CVs
    with LP1_TILT, BP_FREQ/TILT, and per-group BP FOCUS/DIST CVs)
    - New OutputId: 6 outputs (BAND_L/R → BP3_L/R, L/R → MAIN_L/R)
    - New LightId: 5 lights (MOD_LIGHT → CLIP/POS/NEG)
    Signal chain LP1 → BP → HP → LP2:
    - LP1 stereo TILT: L cutoff += tiltV, R cutoff -= tiltV (±5 V/oct)
    - VCA_OFS: floor offset applied in Pogo.cpp before VcaBlock call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
2026-05-27 regen res/Pogo.svg from 48HP panel-data.yaml (text-as-paths via Inkscape)
    Panel asset regenerated by build_panel.py --mfr after the 48HP panel
    redesign. Contains all new zones: LP1 TILT, BP CONTROL (POL/DIST switches,
    OFFSET/MIX knobs), BP1/2/3 with FOCUS+DIST controls, BP3 OUT, and updated
    HP/LP2 slider positions.
    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
2026-05-27 refactor: move VCV Rack plugin code into plugin/ subfolder
    Separates VCV Rack plugin artifacts from hardware design documentation
    at the repository root level.
    Moved:
    Makefile, plugin.json → plugin/
    src/ → plugin/src/
    res/ → plugin/res/
    Updated:
    tools/build_panel.py — SVG output paths now plugin/res/
    .github/workflows/build.yml — PLUGIN_DIR, cp paths, macOS cd into plugin/
    plugin/src/Pogo.cpp asset::plugin() call unchanged (VCV Rack resolves
    "res/Pogo.svg" relative to installed plugin dir, not source tree).
    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
2026-05-27 docs: design documentation reboot for 48HP topology
    New paradigm: code-first reverse engineering. Working plugin is the
    ground truth; hardware specs are extracted from it.
    Archive (specs/archive/40hp-era-2026-05/):
    - block-2-envelope-follower (replaced by dual LFO)
    - block-3-apcf (replaced by Triple Bandpass SVF)
    - module-overview.md, panel-notes.md, panel.svg (40HP)
    - board-layout/layout-notes.md (40HP 3-board split)
    CLAUDE.md: full rewrite
    - Updated signal chain to 48HP topology
    - Replaced design-first rule with code-first reverse paradigm
    - Updated repo structure (plugin/, docs/, tools/)
    - New phase definitions (1R-6R)
    specs/STATUS.md: rewritten for 48HP blocks and new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
2026-05-27 docs: update README and STATUS for 48HP topology and current state
    README: full rewrite — 40HP topology removed, 48HP signal chain,
    code-first paradigm, updated repo structure (plugin/), correct
    build instructions (cd plugin && make), accurate project state table.
    STATUS.md: mark Phase 1R complete for all blocks (done in previous
    session), add Phase 2R priority order, clarify LFO/BP as skeleton
    specs (Phase 1R written, Phase 2R/3R still todo).
    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
2026-05-27 specs: full rebuild — aux/ design library + block-N/ specs + components.yaml
    ## What changed
    ### Structure
    - Archive all 40HP-era block specs (block-5-lp1/, block-7-hp/, etc.) to
    specs/archive/40hp-era-2026-05/
    - Archive mod-architecture.md, module-overview.md, kicad-process.md, noise-audit.md
    - Create specs/aux/ circuit design library (11 files + placeholder SVGs)
    - Create specs/block-N/ specs (10 blocks: A, 1, 2, 3, 4, 5, 6, 7, 8, B)
    - Create specs/components.yaml global component registry
    ### Block numbering (new)
    A=Input Buffer, 1=Pre-Gain, 2=Dual LFO, 3=Mod Bus, 4=VCA,
    5=LP1, 6=Triple BP+Dist, 7=HP, 8=LP2, B=Output Buffer
    Matches signal chain order exactly.
    ### aux/ circuit libra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
2026-05-27 specs: remove SVG placeholders — ASCII schematics in .md are source of truth
    All 9 empty placeholder .svg files removed from specs/aux/.
    Removed broken image references from aux/*.md Schematic sections.
    Updated CLAUDE.md and STATUS.md:
    - aux/ directory listing no longer shows .svg files
    - aux/ template notes ASCII schematic requirement
    - Phase 3R note updated: no SVG files needed
    - STATUS.md: all aux/ files now marked complete (text content is sufficient)
    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
2026-05-27 specs: Phase 3R complete — blocks 2, 3, 6 circuit design finalized
    block-2 (Dual LFO):
    - Fix component values to match aux-lfo-core.md: C_INT 100nF→47nF C0G,
    pot 500kΩ→1MΩ log-taper, end resistors R_CW_END=270kΩ/R_CCW_END=10MΩ
    - Fix Schmitt trigger values: R_fb_sq=100kΩ/R_HYS=82kΩ → V_H=4.96V≈5V
    - Rewrite topology diagram: remove confusing R_fb label; show integrator
    and Schmitt trigger as separate half-descriptions with feedback loop
    - Add 1N4148W half-wave rectifier for pulsing LED (from aux-lfo-core.md)
    - Resolve 'Revisit trim pots' open item: no trimmer needed, log pot adequate
    - Fix R_LED: 1.5kΩ→1.2kΩ (accounts for diode V_f in series with LED)
    block-3 (Mod Bus)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
2026-05-27 specs: analog design review — trim pots, parts, impedance, noise
    - THAT340 package corrected everywhere: SOIC-8 → SOIC-14 (THAT340S14-U is 14-pin)
    Affected: block-5, block-6, block-7, block-8 specs + components.yaml (6 entries).
    Critical: wrong footprint would have produced an unassemblable PCB.
    - aux-power-filter: replace BAT85 SOD-80 (through-hole) with SS14 SMA (SMD).
    BAT85 in SOD-80 is an axial through-hole part; incompatible with SMD-first design.
    - block-3: add missing components that appeared only in aux-mod-bus-core.md:
    - D_MB_CLAMP_P/N: BZX84C10 zeners (back-to-back ±10V clamp in MB_INV feedback)
    - RV_MB_ZERO: offset null calibration trim
    - RV_MB_AMOUNT_MAX: 5× g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
2026-05-27 Analog design review fixes: OPA1612, power estimates, noise, tolerances, counts
    - Block-5/7/8: add Power Draw Estimate sections (OPA1612 SUM_AMPs; ~18/18/15 mA/rail)
    - Block-6: update power estimate for OPA1612 upgrade (~52 mA/rail, up from ~46 mA)
    - Block-1: R_g 12kΩ→4.7kΩ, R_f 47kΩ→18kΩ; NE5532D current noise 8.4→3.3 nV/√Hz
    - Block-4: VCA_AMT pot 10kΩ→1kΩ (wiper impedance <250Ω, THAT2180 gain error <1.6%)
    - Block-5/6/7/8: all 12 SUM_AMP ICs TL072CDT→OPA1612 (1.1 nV/√Hz, pin-compatible)
    - Block-5/6/7/8: THAT340S14-U package SOIC-8→SOIC-14 (correct footprint)
    - CLAUDE.md: 22 CV destinations → 19 (confirmed via DSP InputId enum)
    - aux-attenuverter.md: RV_ATT 100kΩ→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
2026-05-27 Fix code-review findings: OPA1612 Iq, power estimates, noise %, wiper impedance, README
    OPA1612 Iq correction (systematic 2× error):
    - OPA1612 Iq = 2.75 mA/channel; dual SOIC-8 = 5.5 mA per rail per IC (not 2.75 mA/IC)
    - blocks 5/7/8: '2× OPA1612: 2.75×2=5.5mA' → '5.5×2=11mA'; totals 23/23/20 mA (was 18/18/15)
    - block-6: '6× OPA1612: 2.75×6=16.5mA' → '5.5×6=33mA'; total ~69 mA (was ~52 mA)
    - analog-design-review §4.4: +44 mA total delta (was +22 mA); per-block deltas corrected;
    explicit per-channel vs per-IC distinction added
    Block-6 power note contradiction resolved:
    - Three values (4.5 mA / 6.5 mA / 11.1 mA) for same upgrade → single consistent note:
    '+22 mA (6 ICs × 3.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
2026-05-27 STATUS.md: fix block-3 destination count 20→19; update remaining work list
    - block-3 row: '20 destinations' → '19 destinations' (stale count)
    - Remaining work: items 1 (tolerance flags) and 2 (destination count verification) now done;
    removed from list. Remaining: KiCad 48HP generator + Phase 6R smoke tests.
    - Analog design review summary updated to reflect all completed fixes including
    OPA1612 Iq correction and noise improvement % fix.
    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
2026-05-27 block-6: replace WF fold topology with true symmetric precision folder
    Old topology: diodes in op-amp feedback path → gain compression when diodes
    conduct (R_f drops from 10kΩ to 10k||4.7k = 3.2kΩ, gain 1× → 0.32×). This
    was clipping/compression, not slope reversal. Not a wavefold.
    New topology (2 halves, same IC, no additional components):
    - Stage 1 (half A): pre-gain inverting amp, unchanged
    - Stage 2 (half B): passive diode clamp at (+) input + G=+2 subtractor
    V_clamp = clamp(V_fold_in, ±1.4V) via 4× 1N4148W (2 per polarity)
    WF_out = 2×V_clamp − V_fold_in → true slope reversal at ±Vth
    Transfer: linear pass-through when |V_fold_in| ≤ 1.4V; folds back (slope
    inverts)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
2026-05-27 dsp: replace SC tanh model with hardware-accurate diode chain
    The hardware SC path uses two 1N4148W diodes per rail (±1.4V threshold)
    in a shunt-to-ground circuit that is always in the signal path — the drive
    pot only controls pre-gain, not whether the diodes are active.
    Correct model: Vth × tanh(G×x/Vth) where Vth=0.28 (1.4V/5V) and G is the
    drive gain. This gives:
    - Unity slope at origin for signals well below threshold (diodes off)
    - Smooth soft onset above ±1.4V (exponential diode V-I curve)
    - Output bounded to ±Vth = ±1.4V at all drive levels (hardware ceiling)
    - Gain-control zone (driveParam ≤ 0.20) also passes through the diodes
    (gain 0→1×), making the formula continuo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
2026-05-27 docs: update all stale documentation for DSP/hardware alignment
    STATUS.md:
    - Remove ⚠️ deviations from block-4 and block-6 (all resolved)
    - Update aux-vca-cell note: DSP now matches dB-law
    - Add "DSP alignment complete" section listing all 9 changes
    - Remove BP_MIX level-compensation prototype question (now aligned)
    - Update components.yaml count 265 → 267
    specs/block-4/spec.md:
    - Remove "Intentional hardware deviation" paragraph (linear VCA)
    - §2 heading: "DSP Gain Law" → "Gain Law (DSP and hardware)"
    - Replace linear control law with dB-law code block; update operating-point table
    - Note DSP now matches THAT 2180 exponential characteristic
    specs/block-6/spec.md:
    - Summary line: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
2026-05-27 Fix switch label positions to align with slug centers
    All horizontal switch labels were spread too wide (positioned at switch
    body edges rather than slug centers). Corrected to slug-center positions:
    - H2 switch: labels at cx ± 2.25mm (was ±4.5mm)
    - H3 switch: outer labels at cx ± 3.75mm (was ±5.71mm)
    Affected switches: GAIN_MAIN, GAIN_BP3 (INPUT section 1×/5×),
    BP_POL (POS/NEG), BP_DIST (SOFT/HARD/FOLD).
    Rebuilds Pogo-source.svg and Pogo.svg accordingly.
    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
    [panel-data.yaml]
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2026-05-27 Fix switch label x_offset bug; reset pos_xs to slug-center positions
    build_panel.py: apply rules.x_offset to pos_xs when rendering switch_H2
    and switch_H3, matching how x_offset is applied to all other cx values.
    Previously the switch body rendered 1.905mm right of its YAML cx while
    labels stayed at raw coordinates, causing systematic label misalignment.
    panel-data.yaml: reset pos_xs to correct raw values now that the offset
    is handled at render time:
    - H2 switches: cx±2.25 (slug centers, body halves)
    - H3 switch: cx±4.5 (body thirds with small gap for readability)
    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
    [panel-data.yaml]
2026-05-27 Fix calibration pot topology: split R_IREF 1MΩ into R_IREF_A 750kΩ + RV_REF 500kΩ rheostat
    The original design used a 1MΩ fixed R_IREF with a 100kΩ series rheostat (RV_REF), giving
    only +9.1% upward trim range — insufficient to correct a downward-shifted f_ref caused by
    component tolerances (R_IREF ±5% + integrator cap ±5% = ±10.8% worst-case).
    New topology: R_IREF_A (750kΩ, fixed 0603) + RV_REF (500kΩ Bourns 3224W rheostat) in series.
    Nominal at pot center (250kΩ added) = 1000kΩ → same operating point as before.
    Range: 750kΩ (CCW) to 1250kΩ (CW) = ±25% trim range, covering tolerance with 2.3× margin.
    Also doubles RV_1VOCT from 10kΩ to 20kΩ (±5% → ±10% range) for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
2026-05-27 Fix three critical filter component errors found in deep-dive audit
    1. R_IREF_A: 750 kΩ → 1 MΩ (all blocks)
    750 kΩ placed the LP/HP/LP2 calibration target (9.69 µA, R_total=1238 kΩ) within
    1% of the pot maximum (1250 kΩ). Worst-case tolerance stack (R_IREF_A +5%, C_int +5%)
    pushed the target beyond the pot range, making calibration impossible.
    1 MΩ centers all block targets at 20–80% pot travel:
    LP/HP/LP2: 47.6%, BP1: 44.8%, BP2: 22.6%, BP3: 60.4%.
    2. R_VOCT: 56 kΩ → 47 kΩ (all expo converters)
    With 56 kΩ + R_E = 1 kΩ: 1V/oct ratio = 1/57 = 17.54 mV/V, which is 2.7% below
    the 18.02 mV/V target. Since RV_1VOCT is in series (can only add resistance), it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
2026-05-27 Fix filter calibration component values: R_IREF_A 1MΩ, R_VOCT 47kΩ
    Three corrections from deep-dive mathematical audit of OTA-C SVF calibration:
    1. R_IREF_A = 1 MΩ (was 750 kΩ): With 750 kΩ, LP/HP/LP2 calibration targets
    sat at 97% of RV_REF pot travel; worst-case +5% tolerance pushed required
    R_total beyond the 1250 kΩ maximum. At 1 MΩ all targets land at 20–80%
    travel across all filter blocks.
    2. R_VOCT = 47 kΩ (was 56 kΩ): 56 kΩ + R_E gives 17.54 mV/V, below the
    18.02 mV/V target; RV_1VOCT (series, adds resistance) cannot trim up.
    47 kΩ starts above target; RV_1VOCT ≈ 7.5 kΩ trims to exactly 18.0 mV/V.
    3. Update all calibration table entries and §3.4 bas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
2026-05-27 Power audit: correct IC Iq values, block estimates, and block-A IC
    Full pass over all block power estimates to match datasheet quiescent currents.
    Three categories of fixes:
    1. IC part change — block-A: LM4562MA → OPA1612
    OPA1612 is strictly better for this application: 1.1 nV/√Hz vs 2.7 nV/√Hz noise,
    and 2.75 mA/ch vs 5.5 mA/ch quiescent. LM4562 at 11 mA total = 264 mW in SOIC-8
    exceeded the ~200 mW practical limit; OPA1612 at 132 mW is safe.
    Updated: block-A spec, components.yaml, module-overview signal chain.
    2. Iq corrections across filter blocks
    LM13700M: 3 mA/pkg → 4 mA/pkg (TI datasheet typical)
    TL072CDT: ~2 mA/pkg → ~3 mA/pkg (TI: 1.4 mA/ch × 2 = 2.8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
2026-05-27 Tier 1 power reduction + full stale-reference sweep
    Power changes (Tier 1):
    - block-1: NE5532D → OPA1612 (saves 5 mA/rail; BOM consolidation)
    - block-6: SC and HC op-amps share one TL072CDT per group/channel (23→17 ICs; saves ~17 mA)
    - All blocks: TL072/TL074 Icc corrected from ±15V datasheet spec to ±12V actual (~2.6 mA/pkg)
    - Module total: 278 mA → 237 mA; bus recommendation updated to ≥300 mA (350 mA preferred)
    IC substitutions reflected in all docs:
    - block-A: LM4562MA → OPA1612 (lower noise: 2.7→1.1 nV/√Hz; lower power: 11→6 mA)
    - block-1: NE5532D → OPA1612; R_g 12kΩ → 4.7kΩ (RTI: 10→8.1 nV/√Hz; −1.8 dB)
    Stale-reference sweep (post-Tier-1):
    - specs/block-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
2026-05-28 Pre-layout verification: fix LFO formula, Q_min deviation notes, spare cell termination
    Block-2 LFO (3 bugs fixed):
    - Formula on line 53 was V_th/(2×R×C×V_sat); correct is V_sat/(4×V_H×R×C) — the
    factor-of-4 from two half-periods each of duration 2×V_H×R×C/V_sat
    - R_INT at f_min=0.05Hz: arithmetic corrected from 117 MΩ to 234 MΩ (factor-of-2 error)
    - R_CCW_END changed from 10 MΩ (achieves only f_min≈1 Hz) to 2×100 MΩ in series
    (200 MΩ total → R_INT_max=201 MΩ → f_min≈0.058 Hz ≈ 0.05 Hz ✓)
    - components.yaml LFO CCW-end entries updated to 100 MΩ qty:2; CW-end f_max corrected
    Q_min deviation documented (block-5, block-7, block-8, aux-q-control):
    - DSP Q_min=0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
2026-05-28 Phase 3 signal-path trace: fix BP_MIX polarity, stale values, arithmetic errors
    Block-1 signal routing section (Flag 8 — stale values):
    - Signal routing diagram updated from old 12 kΩ/47 kΩ to current 4.7 kΩ/18 kΩ for both
    main path (R3/R4) and ALT path (R_ALT_g); component table was already correct
    Block-B (Flag 7 — arithmetic error):
    - Output attenuation into 100 kΩ corrected from −0.01 dB to −0.087 dB
    (100k/(100k+1k) = 0.990× → correct value is −0.087 dB, not −0.01 dB)
    Block-6 BP_MIX polarity (Flag 6 — circuit polarity bug):
    - The 3-inverter chain (wet summer → MIX amp → output buffer) was producing
    V_out = V_dry − V_wet (subtractive) instead of DSP's a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
2026-05-28 Resolve THAT 2180 audio I/O impedances (pre-layout open item)
    Single-ended operation specified throughout: IN+ = signal, IN− → AGND
    direct (no matching resistor), OUT+ = signal out, OUT− → R_OUT_N (10 kΩ)
    → AGND per channel to prevent floating translinear cell noise.
    Stage boundary analysis added to block-4/spec.md §2:
    - Block 1 → VCA IN+: source ~15 Ω, load ~20 kΩ → −0.006 dB negligible
    - VCA OUT+ → LP1: source <100 Ω, load 100 kΩ → −0.009 dB negligible
    Components added: R_OUT_N_L / R_OUT_N_R (10 kΩ 0603, audio board, block-4)
    in both block-4/spec.md §4 table and components.yaml.
    aux-vca-cell.md: ASCII schematic updated to show single-ended wiring;
    different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
2026-05-28 Close open prototype questions (LED pulsing confirmed; WF Vth analyzed)
    block-2: Signal routing corrected to include D_LED1/D_LED2 (1N4148W) in the
    LED drive path — was missing from the routing diagram. Pulsing (half-wave
    rectified) confirmed as the design choice; no hardware change.
    block-6: WF Vth diode-current dependency fully analyzed. At practical fold
    depths (V_fold_in > 5V), Vth sits in 1.28–1.44V (±10% of DSP target 1.4V).
    Soft onset at low drive is an accepted analog character feature matching all
    passive-diode Buchla-style folders. Closed as accepted characteristic.
    STATUS.md: Open prototype questions section cleared — both items resolved.
    https://claude.ai/code/session_0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
2026-05-28 Fix five panel/DSP issues found on first plugin load
    1. Labels not showing (Pogo.svg) — build_panel.py --mfr was missing
    --export-text-to-path; Inkscape now converts all <text> to paths;
    Pogo.svg rebuilt with 0 text elements.
    2. HP_RES and LP2_RES knobs misaligned — Pogo.cpp had pre-x_offset cx
    values (205.74 / 228.60) while the panel SVG uses post-x_offset
    (207.645 / 230.505). Fixed both widget placements.
    3. Slider handle drawn twice — svg_slider_V45 was rendering a static
    handle graphic at the centre position; VCV Rack widget renders its
    own handle on top. Removed the handle rect and centre line from the
    panel_svg.py generator; kept slot body, end ticks, neutr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
2026-05-28 Fix six plugin issues: 4-pole BP, ALT→BP3 routing, polarity, normalling, SVG labels
    - BandpassSVF.hpp: cascade two 2-pole SVF stages for 4-pole BP (add ic1b/ic2b state)
    - BandpassSVF.hpp: ALT input feeds BP3 only (bp3x param); BP1+BP2 always use main path
    - BandpassSVF.hpp: polarity removed from TripleBandpass::process(); applied externally
    - Pogo.cpp: bp3InL/bp3InR route ALT (VCA-applied) to BP3, main path to BP1+BP2
    - Pogo.cpp: polarity applied to wetL/wetR and bp3OutL/bp3OutR (was discarded)
    - Pogo.cpp: BP_MIX crossfade bypass uses bandL/bandR (LP1 out), not bpInL
    - Pogo.cpp: BP3_R_OUTPUT normalises to L when unpatched
    - build_panel.py: _propagate_svg_fills() sets fill on each <path> af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
2026-05-28 Revert BP to 2-pole (single stage); 4-pole cascade not working as expected
    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
2026-05-28 Change all BP freq ranges to 40 Hz–4 kHz (was 200/1500/6000 Hz formants)
    All three BP groups now share F_REF=400 Hz with knob range ±log2(10)
    V/oct, giving 400×2^(−log2(10))=40 Hz at CCW and 400×2^(log2(10))=4 kHz
    at CW. Previously each group had a fixed formant frequency (200/1500/6000)
    with a ±5V/oct sweep range.
    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
2026-05-28 Redesign BP CONTROL section: replace polarity switch with tilt knob
    - panel-data.yaml: remove BP_POL switch, add BP_TILT medium knob (cy=43),
    reorder to Offset(L)→Tilt(M)→Mix(M)→Dist(H3), update col_pitch to 11.43
    - Pogo.cpp: BP_POL_PARAM enum → BP_TILT_PARAM; tilt knob feeds bpTiltCv;
    remove polarityVal/pol — distortion sum applied directly (always positive);
    widget: RoundLargeBlackKnob for Offset, two RoundBlackKnobs for Tilt+Mix,
    H3 switch at cy=78, all positions updated to match panel-data.yaml
    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
    [panel-data.yaml]
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2026-05-28 BP recirculation feedback — positive feedback loop for formant tightening
    Adds BP_RECIRC_PARAM (0–0.95) feeding prevOut[i] back into each group's
    input before the SVF. Q_eff = Q / (1 − g), so at g=0.9 a Q of 5 becomes
    50. Loop is hard-clamped at ±10 V to prevent explosion. Widget knob at
    cy=90 between the dist switch and trimpots (unlabeled, test placement).
    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
2026-05-28 Revert "BP recirculation feedback — positive feedback loop for formant tightening"
    This reverts commit 015e7a9fa654754dd1924b074edc941a00f6723b.
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2026-05-28 Fix BP CONTROL widget x positions — add x_offset=1.905mm
    _resolve_comp in build_panel.py adds x_offset to all component cx values
    before writing to the SVG, so widget code must use yaml_cx + 1.905.
    Raw YAML cx values (80.01, 74.295, 85.725) were used by mistake after
    the BP redesign; corrected to the rendered positions (81.915, 76.200, 87.630).
    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
2026-05-28 WIP: BP1 add TILT knob — DRC overlap pending resolution
    FOCUS/DIST shifted to cx=102.87 (midpoint of FREQ/TILT jacks).
    TILT knob added at cx=114.30, cy=65.20 (midpoint of TILT/DIST jacks).
    Fails DRC: 0.54mm PCB overlap — awaiting user decision on which
    component to shift to resolve the asymmetric POT courtyard conflict.
    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
    [panel-data.yaml]
2026-05-28 BP1: add TILT knob; shift FOCUS/DIST to left of center column
    FOCUS and DIST knobs move to cx=102.87 (midpoint of FREQ/TILT jacks).
    New TILT knob at cx=114.30, cy=65.20 (midpoint of TILT/DIST jacks,
    vertically between FOCUS and DIST). Rotated 180° to flip the
    asymmetric pot courtyard inward, clearing DRC by 1.23mm.
    BP1_TILT_PARAM wired into process(): knob ±1 V/oct + CV (±1.1 oct
    at full att), summed with global bpTiltCv per-band.
    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
    [panel-data.yaml]
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2026-05-28 Replace BP global dist switch with BP WET knob; rename MIX to BYPASS
    Remove BP_DIST_PARAM switch (each band now has its own per-band switch).
    Rename BP_MIX_PARAM → BP_BYPASS_PARAM (label "BYPASS"), add BP_WET_PARAM (label "WET").
    Signal path: bpOut = bandL * bypass + wetL * wet (independent dry/wet controls).
    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
    [panel-data.yaml]
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2026-05-28 Fix LED cpp_id names in panel-data.yaml to match plugin LightId enum
    LFO1/2_LED → LFO1/2_LIGHT; MOD_LED_R1/2/3 → MOD_CLIP/POS/NEG_LIGHT.
    Panel cpp_id values now match plugin enum exactly — all params, inputs,
    outputs, and lights cross-check clean with zero gaps in either direction.
    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
    [panel-data.yaml]
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2026-05-28 Fix MOD_SRC switch orientation: add rotate 180
    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
    [panel-data.yaml]
2026-05-28 Fix switch_V3 body centering and label routing in build_panel.py
    cy_body_top now defaults to cy - body_height/2 so the SVG body is
    centered on the DRC anchor (matching the PCB footprint position).
    label_below falls back to the YAML label field. label_below_y defaults
    to cy + body_height/2 + 3 (just below body bottom). DRC PASS.
    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
2026-05-28 Replace mod bus V3 switch with H3 between trimpot rows
    MOD_SRC_SW moved from switch_V3 at cy=112 to switch_H3 at cy=89.67
    (midpoint between SCALE/OFFSET rows). Also fix switch_H3 label fallback
    in build_panel.py to use label field. DRC PASS.
    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
    [panel-data.yaml]
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2026-05-28 Move mod bus switches to col 0; fix SW1 cy for LFO2_OUT clearance
    Switches move from col 1 to col 0 (left edge, where MOD_IN was).
    SW1 cy bumped 75.1→79.0 to clear LFO2_OUT jack above (courtyard
    bottom 72.4mm). SCALE/OFFSET/MOD_IN remain at col 1.
    Two background agents spawned to investigate DRC blind spots
    (SVG draw size > courtyard size). DRC PASS.
    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
    [panel-data.yaml]
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2026-05-28 Add DRC unit tests exposing courtyard vs SVG draw-size blind spots
    778-line pytest suite documenting every component type where the DRC
    courtyard is smaller than the drawn SVG bounding box. Key finding:
    switch_V3 body ±6mm vs courtyard ±5mm creates a 2mm blind window.
    Tests include the exact switch_V3+trimpot collision from the live panel.
    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
2026-05-28 Fix DRC blind spots for switch_V3/H3 and update test suite
    - Expand SWITCH_V3_CY from ±5.0mm to ±6.4mm to match CAS-120R3 body (±6.35mm + 0.05mm margin)
    - Add SWITCH_H3_CY = (-6.0,-3.5,6.0,7.5) for 12mm-wide horizontal 3-way body
    - Split _get_courtyard to route switch_V3/V5 → SWITCH_V3_CY, switch_H3 → SWITCH_H3_CY
    - Fix nut keepout: switch_V3 now uses SWITCH_V3_PANEL_R=1.0mm (slot), not 3.15mm toggle radius
    test_drc.py:
    - Update all tests that documented the old ±5.0mm blind spot to assert the fix is in place
    - test_blind_window_arithmetic: assert blind ≤ 0 (eliminated)
    - test_live_panel_positions_caught_by_drc: assert DRC fires at delta=8.5mm (was asserting pass)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
2026-05-28 Add interactive panel layout editor (design/panel-editor.html)
    Turn the read-only panel-debug viewer into an interactive editor built from
    panel-data.yaml as a single static HTML+JS page (no server).
    Features:
    - Left: component palette (add) + zone/component tree (select)
    - Centre: live panel SVG — free drag, grid snap, selection + DRC violation
    highlighting, layer-visibility toggles (Panel/Keep-Out/Nuts/Courtyards/KiCad)
    - Right: inspector — id, type, resolved cx/cy, rotate, label, font_size,
    cpp_id/cpp_param, read-only KiCad footprint name, delete
    - Top bar: panel HP + recenter, dividers add/remove, Export YAML, DRC badge
    The page embeds the parsed YAML, the original YAML text, t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
2026-05-28 Editor: tools, snap (mm/HP), align/anchor, sections, undo, EG parity
    Major interactivity upgrade to the panel editor:
    - EG slide-switch parity (eg_2pos/eg_3pos): JS renderers, courtyards, and the
    slot keep-out check now mirror panel_rules.py exactly (DRC string parity, incl.
    EG, verified clean + broken). Fixes a regression where the editor skipped EG
    geometry after the E-Switch EG-series change landed on dev.
    - Tool model: Select / Pan (Space-hold pan), Align/anchor pick mode.
    - Arrow-key nudge (Shift = 1 HP); Del to delete; Esc cancel/deselect.
    - Snap in mm OR HP (e.g. 2.25 HP), with grid origin = panel 0,0 or a selected
    component.
    - Align X/Y to a clicked reference; place-at-offset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
2026-05-28 Editor: structured DRC, jump-to-violation, live clearance HUD
    - runDRC() now also returns structured items [{tag,text,ids}] alongside the
    parity-identical violation strings (ids captured at the flag sites). DRC
    string-parity with build_panel.py --check is preserved (verified clean+broken).
    - Jump-to-violation: DRC list rows are clickable → select + scrollIntoView the
    offending component.
    - Live clearance HUD: while dragging, shows the component's cx/cy (+HP) and, vs
    the nearest neighbour, centre-to-centre / nut-edge / PCB-courtyard gaps
    (mirrors the CLI --dist math; negatives flagged red).
    No-op export remains byte-identical.
    https://claude.ai/code/session_01MsaCQa27NDEvGAyaaMD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
2026-05-28 Editor: draggable separator endpoints + opt-in label border
    Feature 1 — draggable separators:
    - Select a separator (click on the canvas, or "edit" from the Dividers modal);
    drag end handles to change length, middle handle to move it laterally. Snap +
    in-panel clamping apply; labeled h-separators re-centre label_x when resized.
    - New UI.selSep state + a separator inspector (style / endpoints / label / delete).
    - Export patches only the changed separator's line in place, preserving the
    block's derivation comments (wholesale regen only on add/remove).
    Feature 2 — label border (explicit):
    - New label_border field (+ rect_w) draws the rounded-rect label outline; the
    border is now dri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
    [panel-data.yaml]
2026-05-28 Editor: keep switch labels/position marks aligned when moved
    Switch labels used absolute coords (label_below_y, pos_xs/pos_ys, cy_body_top,
    label_above_y, pos_y) that didn't move when the component was dragged — only
    cx/cy updated, so the label offset (= label_below_y − cy) drifted.
    Fix: shiftAux() shifts these absolute auxiliary fields by the same delta on every
    move (drag, arrow-nudge, align, place, and zone-shift), and the exporter now
    persists the shifted scalars and array fields (pos_xs/pos_ys via a flow-sequence
    emitter). Verified: label/position-mark offsets stay constant across a move;
    no-op export byte-identical; round-trip re-parses, builds, passes --check with
    comments preser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
2026-05-28 Derive PCB courtyards from KiCad footprints (single source of truth)
    The hand-maintained *_CY courtyard constants are now DERIVED at load from each
    component's .kicad_mod F.CrtYd layer via panel_kicad.footprint_courtyard(),
    translated to the panel anchor by the _FOOTPRINT_MAP (ox,oy). Both the validator
    (panel_rules) and the web editor consume this, so they can't drift.
    - New EG footprints (SW_EG1218 2-pos, SW_EG2301 3-pos) with F.CrtYd matching the
    prior EG courtyards; mapped as eg_2pos/eg_3pos. EG switches now have real
    footprints (render in the KiCad layer too) — eliminating the last hardcoded
    courtyards for parts actually on the panel.
    - Legacy switch_V3/switch_H3 (unused; no de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
2026-05-28 Editor: dividers nested under zones, zone-tied vertical dividers, live DRC
    - Dividers are no longer a separate tree category — each is shown under the zone
    whose x-span contains it (vertical by its x, horizontal by its midpoint);
    any outside all zones fall under "Other dividers".
    - Vertical dividers are tied to zones: removed the standalone "+ Divider ▏";
    "+ Zone" now also creates the zone's left-edge vertical boundary, and moving a
    zone's x_start moves that boundary line with it. "+ Divider —" spans the
    selected zone (so it nests under it).
    - Live DRC: while dragging a component, violators recolour red in real time
    (runDRC gains an optional position override so the dragged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
2026-05-28 Editor: remove Nuts/Courtyards layers; KiCad layer draggable; DRC highlights footprints red
    - Remove "Nuts" and "Courtyards" layer toggles from the layer bar — these
    were intermediate representations now superseded by KiCad footprints.
    Courtyard geometry is still used internally for DRC (derived from .kicad_mod).
    - KiCad layer: footprint groups are now draggable (same drag/drop/snap/DRC
    behaviour as panel layer; pointer capture on the kicad group).
    - DRC violations: entire KiCad footprint strokes turn red (#ff4444) for any
    component in conflict — both on initial render and during live drag.
    - HUD clearance label renamed from "courtyard" to "footprint".
    https://claude.ai/code/ses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
2026-05-28 Standardize all toggle switches onto Thonk Dailywell 2M sub-mini toggles
    Replace E-Switch slide switches (EG1218/EG2301) and the legacy SPDT
    placeholder with Thonk-stocked Dailywell 2M sub-miniature toggles:
    - DW3 (DPDT ON-ON) for the 2-position switches: GAIN_MAIN, GAIN_BP3, BP_POL
    - DW5 (DPDT ON-ON-ON) for the 3-position selectors: BP1/2/3_DIST_MODE, MOD_SRC
    Changes:
    - New KiCad footprints SW_Dailywell_DW3_DPDT / SW_Dailywell_DW5_DPDT
    (2x3 grid, 2.54mm pitch, 5.08mm row spacing, Oe4.95mm panel hole);
    deleted the three obsolete E-Switch footprints.
    - Panel toolchain: new toggle_dw3/toggle_dw5 component types across
    panel_kicad, panel_rules (round-nut DRC, TOGGLE_CY/TOGGLE_PANEL_R),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
    [panel-data.yaml]
2026-05-28 Address adversarial review: 10-48 bushing spec, washer clearance, doc gaps
    Primary-source audit (Dailywell 2M datasheet) confirmed DW3=DPDT ON-ON,
    DW5=DPDT ON-ON-ON (all 3 positions live), and all footprint dims verbatim.
    Applied its two corrections plus the completeness-audit gaps:
    - panel_rules.py: bump TOGGLE_PANEL_R 3.0 -> 3.8mm to model the 10-48
    external-tooth locking washer (~Oe7.6mm); clarify bushing is 10-48 UNS
    (Oe6.00mm) through a Oe4.95mm panel hole (not 'an M7 bushing').
    - Document toggle-vs-pot panel hardware coexistence (10-48 UNS vs M7x0.75)
    in board-layout/layout-notes.md.
    - Fix stale leftovers missed in the first pass: panel-tool-guide.md
    sub-mini-toggle prose (was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
    [panel-data.yaml]
2026-05-28 Panel-editor: front-panel symbols honor component rotation
    The panel-editor front-panel layer ignored the 'rotate' field while the
    KiCad overlay applied it, so rotating a switch spun the footprint but not
    the panel symbol. Make the front-panel render rotate each component's
    body-fixed directional feature, consistent with the KiCad rotate(deg):
    - Toggles: lever vector rotates (DW3/DW5).
    - Sliders: track + ticks rotate (label stays upright).
    - Trimpots: wiper-indicator pointer rotates.
    - Knobs: intentionally NOT rotated — the pointer is a value indicator on a
    removable cap, independent of body mounting; a rotated pot (e.g. the
    rotate:180 TILT knobs, flipped only for PCB-courtyard fit) s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
2026-05-28 Panel designer: single knob type sized by explicit cap_mm diameter
    Replace the three fixed knob presets (knob_medium/large/xl, with cap radii
    hardcoded in 4 places) with a single 'knob' component type sized by an explicit
    cap_mm (cap DIAMETER in mm). The base default lives in a new panel-data.yaml
    'knobs:' registry (default_cap_mm), consistent with the footprints: block.
    - panel-data.yaml: add knobs.default_cap_mm; migrate all 19 knob entries to
    type: knob + cap_mm (medium->9, large->14, xl->18mm — identical drawn radii,
    so the committed Pogo.svg is byte-unchanged).
    - panel_rules.py: POT_TYPES={trimpot,knob}; POT_CY keyed on 'knob'; load
    knob_default_cap_mm from the knobs: block.
    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
    [panel-data.yaml]
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2026-05-29 Panel editor: unified component-linked label offsets + position labels
    Replace the inconsistent label-positioning (fixed offsets for jacks/knobs,
    absolute label_below_y/label_above_y for toggles, absolute pos_xs arrays for
    switch position labels) with one model:
    - Each component's label sits at a per-type DEFAULT offset from its anchor; a
    label_dx/label_dy NUDGE (0 = default) shifts it. Inspector exposes the nudge
    with a 'Reset label offset' button.
    - Default offsets follow rotation for directional panel faces (toggles, sliders);
    jacks/knobs keep labels screen-fixed (their rotate is PCB-courtyard-only, so a
    rotated jack/TILT-knob must NOT flip its label).
    - Switch position labels ('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
    [panel-data.yaml]
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2026-05-29 Move engine constants out of panel-data.yaml into the render engine
    panel-data.yaml mixed three kinds of value: universal Eurorack constants,
    render-style/part-spec defaults, and genuine panel-layout params. Make
    panel_rules.DesignRules the source of truth for the first two and trim the YAML
    to layout only.
    - panel_rules.py: DesignRules dataclass now holds canonical defaults for
    top/bot keepout, jack_label_dy, output_rect_*, indicator_length, jack_pitch,
    jack/pot nut radii, and knob_default_cap_mm. Fixed the stale jack_pitch default
    (10.16 -> 15.24) and aligned cv_jack_cy/att_offset/x_offset defaults with the
    panel. from_data still applies a YAML value when present (optional overrid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
    [panel-data.yaml]
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2026-05-29 Fix block-6 BOM over-count (12 paths -> 6)
    The block-6 spec BOM counted per-path distortion components as 12 (treating the
    design as 12 paths) when there are 6 (3 groups x 2 channels). Align the spec
    to the authoritative components.yaml (and the spec's own '1 per channel per
    group' / '6 paths' prose):
    - R_SC_in, R_SC_fb_fixed, R_HC_in, R_HC_fb_fixed, R_WF_in, R_WF_fb_fixed,
    R_clamp, R_g, R_f: qty 12 -> 6 (components.yaml R18-R25, R_f_wf = 6)
    - D_SC_1N4148: qty 48 -> 24, '12 paths' -> '6 paths' (components.yaml D4 = 24)
    Flagged for a separate circuit decision (authoritative file is itself
    inconsistent): D_WF_1N4148 = 48 vs '4 per path x 6 = 24'; R_sum spec 12 vs
    components.yaml 8 vs pro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
2026-05-29 components/: verify datasheet URLs + capture revisions
    Web-verified all 18 part datasheet URLs:
    - TI/Nexperia/Bourns/Diodes URLs confirmed correct; recorded revisions
    (SBOS450C, SLOS080W, SNOSBW2F, SCHS047O, DS11005, DS30086, BZX84 Rev.7, ...).
    - THAT 2180/340 product-page URLs 404'd -> replaced with manufacturer PDFs
    (Doc 600029 Rev 02, Doc 600041 Rev 04).
    - Fixed Thonk URLs: alpha_rd901f (was dual-gang page), slide_pot_45mm and
    led_3mm category pages (404 -> working pages). Panel-hardware supplier pages
    marked version: 'supplier page'.
    Flag: Thonk stocks 20mm-travel sliders, not the 45mm the panel uses
    (slide_pot_45mm) — noted in the part file; verify travel/source before BOM.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
2026-05-29 components/: datasheet PDF cache + integrity metadata (Phase 2 slice)
    tools/fetch_datasheets.py downloads each PDF datasheet into a gitignored cache
    (components/datasheets/) and records sha256 + bytes into component.yaml, so the
    BOM has verifiable datasheet integrity without committing copyrighted binaries.
    - 12 PDF datasheets fetched + hashed (TI/THAT/Bourns/Nexperia/Diodes); 6
    supplier-page parts skipped (no manufacturer PDF).
    - --check (offline, CI-safe): every PDF datasheet must carry sha256/bytes;
    cached PDFs are verified against the recorded hash when present.
    - --verify (online): re-download and fail on sha drift.
    - CI runs fetch_datasheets.py --check in all jobs; cache dir gitig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
2026-05-29 components/: generate manufacturing BOM from registry + components.yaml
    First KiCad-consumer slice (BOM + library scaffold). specs/components.yaml stays
    the authoritative hand-maintained source; the BOM is a generated, registry-enriched
    view of it.
    - Each registry part gains matches[] (the components.yaml part: strings it covers).
    - tools/components.py: part_for() match-index + bom_components() loader.
    - tools/build_components.py --gen-bom -> kicad/pogo-bom.csv: 278 rows grouped by
    board, enriched with MPN / KiCad footprint lib-id (POGO_<lib>:<name>) /
    manufacturer / supplier / datasheet from the registry; passives fall back to
    components.yaml fields. --all (fplib+bom); --check drift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
    [pogo-bom.csv]
2026-05-29 Fix adversarial-review defects: D_WF/R_sum counts + stale enum comment
    Data/EDA reviewer (with circuit reasoning) resolved the two block-6 counts left
    flagged earlier:
    - D_WF_1N4148 (WF clamp diodes): 48 -> 24. The wavefolder uses 4 diodes/path
    (2 per polarity) x 6 paths = 24 — same as SC (D4=24); the 48 contradicted its
    own '4 per path x 6 paths' text. Fixed in components.yaml D6 + block-6 spec;
    BOM regenerated.
    - R_sum (BP wet summer R): spec 12 -> 8 to match components.yaml R26 (3 inputs +
    1 feedback per channel x L+R = 8).
    - Pogo.cpp: NUM_PARAMS comment 48 -> 52 (actual enum/config/addParam count).
    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
    [pogo-bom.csv]
2026-05-29 Settle switch inventory: cut BP_POL, defer MOD_SRC, BP_DIST per-band
    Reconcile the four ground-truth artifacts (plugin / panel-data / components.yaml /
    docs) to the plugin (CLAUDE.md: the VCV plugin is ground truth = 5 switches).
    BP_POL — CUT (no plugin param; not on panel):
    - Remove the BP_POL select switch: components.yaml SW3, block-6 'BP_POL Polarity
    Switch' section, SW_POL BOM row, docs BP_POL_PARAM + polarity formula + signal-chain
    + default-table row + migration note, layout-notes count, dailywell_dw3 note.
    - KEEP the inversion it shared: U27 half B + R_pol_in/R_pol_fb are repurposed as a
    FIXED BP-output polarity-restore inverter (the MIX amp output is inherently
    negative;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
    [pogo-bom.csv]
2026-05-29 kicad: data-driven schematic generator (block-A vertical slice)
    Add a data-driven 48HP schematic generator that reads per-block netlists
    (kicad/nets/<block>.nets.yaml: net -> [REF.PIN]) and emits a KiCad 7
    schematic via name-based global-label connectivity.
    - generate_schematic.py: resolves symbols/pin geometry from kicad_common
    and footprints/MPNs from the components/ registry; byte-stable output
    (deterministic UUIDs); pin-coverage validator (every pin wired or
    explicit no_connect; rejects unknown refs/pins, double-wires, NC clashes).
    - kicad_common.py: add sym_opa1612, sym_bat54s, sym_jack symbols +
    opamp_dual_all_pins / bat54s_pins helpers; place_symbol carries an
    optional regi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
    [pogo-block-A.kicad_sch]
2026-05-29 kicad: vendor BAT54S SOT-23 footprint + structural schematic verifier
    Resolve the two items flagged in the block-A slice:
    - BAT54S footprint: add kicad/footprints/Package_TO_SOT_SMD.pretty/SOT-23,
    bind it in the registry (was footprint: null), regen fp-lib-table + BOM.
    D1/D2 now resolve to POGO_Package_TO_SOT_SMD:SOT-23; all block-A parts
    have vendored footprints.
    - Replace the weak paren-count check with an independent structural verifier:
    re-parses the emitted .kicad_sch as s-expr, re-derives each pin's connection
    point from lib_symbols geometry, and confirms every global label lands on a
    pin and every pin is labeled or an intended no_connect. Catches malformed
    s-expr, dangl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
    [pogo-block-A.kicad_sch, pogo-bom.csv]
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2026-05-29 kicad: add block-B output-buffer schematic (B of 10)
    Transcribe block-B (kicad/nets/block-B.nets.yaml) -> pogo-block-B.kicad_sch:
    MAIN buffers (U61 TL072), BP3 tap buffers (U62 TL072), 4x 1kΩ series R,
    MAIN_L/R jacks. Reconciled scope against components.yaml + plugin (the BP3
    jacks J27/J28 live in block-6, LFO jacks in block-2), so BP3 outputs and all
    four buffer inputs are boundary nets joined by name at board level.
    - Establishes the cross-block boundary-net registry in SCHEMATIC-GEN-PLAN.md
    (L_OUT/R_OUT, LP2_OUT_L/R, BP3_TAP_L/R, BP3_L/R_OUT).
    - Flags a BOM drift: components.yaml allocates no decoupling caps for U61/U62
    (block-A has 2x 100nF per dual op-amp). Not invented here to pr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
    [pogo-block-B.kicad_sch]
2026-05-29 components: add U61/U62 decoupling caps (C37-C40); wire into block-B
    Resolve the flagged block-B drift: components.yaml had no decoupling for the
    output-buffer op-amps while every other dual op-amp gets 2x 100nF. Add C37-C40
    (audio board, next free C refs after block-8's C36) and wire them into the
    block-B netlist (+12V/-12V to GND per IC). Regenerated BOM (281 rows) and
    block-B schematic (12 parts). All gates green.
    [pogo-block-B.kicad_sch, pogo-bom.csv]
2026-05-29 kicad: add block-1 pre-gain schematic + DW3/DW5 toggle symbols (3 of 10)
    Transcribe block-1 (pre-gain) -> pogo-block-1.kicad_sch (22 parts, 21 nets):
    2x OPA1612 non-inverting 5x gain stages with DPDT path-select 1x/5x toggles
    (matches DSP true-bypass), main + ALT paths.
    Generator/symbols:
    - kicad_common: add sym_dw3 / sym_dw5 (shared 6-pin DPDT body) + dpdt6_pins;
    register dw3/dw5 in SYM_TABLE. Footprints resolve to the Dailywell DW3 land.
    Refdes-suffix convention (project decision): components.yaml keeps grouped refs
    with qty>1 for stereo pairs; schematic refdes derived by L/R suffix
    (R3->R3L/R3R, ...). Documented in SCHEMATIC-GEN-PLAN.md.
    components.yaml reconciliations (BOM truth):
    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
    [pogo-block-1.kicad_sch, pogo-bom.csv]
2026-05-29 kicad: finalize LFO rate network + add block-2 schematic (4 of 10)
    Finalize block-2's Phase-3R-deferred LFO rate-setting network as a spec task,
    then transcribe block-2 -> pogo-block-2.kicad_sch (28 parts, 21 nets).
    Design decision (user-approved): drive-attenuator rate control. A 1MΩ linear
    trimpot cannot span the 400:1 R range a rheostat would need; instead R_INT is
    fixed (590k, sets f_max≈20Hz) and the preset trimpot attenuates the Schmitt
    square-wave drive into the integrator (f ∝ wiper fraction), with R_FLOOR (2.4k)
    bounding f_min≈0.05Hz. Since RV1/RV2 are set-once presets, taper law across
    rotation is irrelevant — no THAT340 expo needed. Matches the plugin rate law.
    Spec: bl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
    [pogo-block-2.kicad_sch, pogo-bom.csv]
2026-05-29 kicad: correct THAT2180 topology + add block-4 VCA schematic (5 of 10)
    Datasheet review (committed THAT 2180 PDF, Doc 600029 Rev 02, Table 1) caught a
    real device-level error: the part is current-in (pin1 Input) / current-out (pin8
    Output) with pinout Input=1, Ec+=2, Ec-=3, Sym=4, V-=5, Gnd=6, V+=7, Output=8 —
    NOT the differential IN+/IN-/OUT+/OUT- voltage VCA the symbol, aux-vca-cell, and
    STATUS assumed (which claimed no output op-amp + an OUT- termination resistor).
    Full correct rework (user-approved):
    - kicad_common sym_that2180: corrected pinout; add that2180_pins; SYM_TABLE 'vca'.
    - Vendor Bourns 3224W SMD trimmer footprint (was null); bind it.
    - Corrected cell: audio in -> R_in (20k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
    [pogo-block-4.kicad_sch, pogo-bom.csv]
2026-05-29 kicad: datasheet-correct LM13700 + THAT340 symbols (filter-block prep)
    Parallel datasheet verification (committed PDFs) before transcribing the OTA-C
    SVF filter blocks caught two more wrong symbols:
    - LM13700: 13 of 16 pins were wrong, including V+/V- on the wrong pins (would
    destroy the IC), Output-B marked NC, inputs polarity-swapped, and invented
    DiodeIn/DiodeOut names. Corrected to the canonical TI SNOSBW2F pinout
    (1/16 Iabc, 2/15 DiodeBias, 3/14 In+, 4/13 In-, 5/12 Out, 6 V-, 7/10 BufIn,
    8/9 BufOut, 11 V+). Added lm13700_pins helper.
    - THAT340: symbol encoded a 16-pin all-NPN part; the real THAT340S14-U is SO14,
    2 matched NPN (Q1,Q2) + 2 matched PNP (Q3,Q4), pins per Doc 600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
2026-05-29 block-5: expand BOM to full OTA-C SVF + shared-Q sheet model
    Prep for the LP1 (block-5) schematic, with two locked decisions:
    - Full BOM expansion (faithful): components.yaml block-5 grown from 23 to the full
    spec-§4 circuit (~40 added numbered refs R47-R64, C45-C65, D10): SUM_AMP feedback,
    OTA linearizing Rs, tilt summers, Q control (IRES_AMP + V→I), expo network
    (R_IREF/R_VOCT/R_E + I_ref bypass), Iabc bypass, and full per-IC decoupling.
    - Shared/cross-block parts get a dedicated shared sheet (revised from 'own in
    block-5' per user): the LP1/LP2 Q-VCAs U9/U10 + their decoupling/Iabc-bypass are
    regrouped to block: block-Q and will live in kicad/nets/shared-q.nets.yaml; block-5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
    [pogo-bom.csv]
2026-05-29 kicad: register LM13700 (ota) + THAT340 (expo) in SYM_TABLE
    Generator prep for the OTA-C SVF filter blocks: add 'ota' (LM13700) and 'expo'
    (THAT340) entries to SYM_TABLE, using the datasheet-corrected symbols + pin helpers.
    Unused until block-5 lands; all 5 existing blocks still verify.
2026-05-29 kicad: block-5 LP1 (OTA-C SVF) + shared-q sheet (6 of 10; dual-derivation)
    Built block-5 + shared-q by dual derivation: an independent worktree agent draft
    + my net-by-net review. Agreement was high on the core SVF (SUM_AMP + v2 feedback,
    HP->OTA1, integrator + Darlington-buffer state variables, R_LIN on In-, diode-
    connected expo reference, Q-cell sharing). Two changes from the agent draft:
    1. Per-channel expo (locked decision): true octave-accurate stereo tilt needs one
    expo per channel — U14=L, U64=R, each fed V_freq ± V_tilt -> separate Iabc
    (LP1_IABC_L->U7, LP1_IABC_R->U8). A single shared expo cannot make f_L != f_R.
    Added 2nd THAT340 + its V/oct network (R65-67, RV22/23,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
    [pogo-block-5.kicad_sch, pogo-bom.csv, pogo-shared-q.kicad_sch]
2026-05-29 kicad: block-8 LP2 + fix multi-unit op-amp placement bug (7 of 10)
    block-8 (LP2): OTA-C SVF mirroring LP1 minus tilt (single shared expo); Q VCA via
    the shared-q sheet cell B (U9/U10); added LP2's own IRES_AMP (U65, was missing from
    the BOM) + full SVF expansion (R_LIN, expo network, Q V->I, buffer pulldowns,
    decoupling). 51 parts / 36 nets; LP2 boundary nets match shared-q byte-for-byte.
    shared-q gains the LP2 cell-B Iabc bypass caps (C84/C85).
    GENERATOR CORRECTNESS FIX (exposed by block-8's spare op-amp half): dual op-amps
    were placed as a single instance while pins from BOTH halves were connected at the
    lib_symbol's overlapping origin -> unit-A and unit-B pins landed on the same canvas
    p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
    [pogo-block-1.kicad_sch, pogo-block-2.kicad_sch, pogo-block-4.kicad_sch, pogo-block-8.kicad_sch, pogo-block-A.kicad_sch, pogo-block-B.kicad_sch, pogo-bom.csv, pogo-shared-q.kicad_sch]
2026-05-29 kicad: block-7 HP filter (8 of 10)
    block-7 (HP): OTA-C SVF mirroring LP2 with HP-specific topology:
    - HP output via G=-1 inverting buffer (OPA1612 half B) restoring SUM_AMP polarity
    -> HP_OUT (boundary -> block-8 LP2); v2 only feeds back (no LP unity buffer).
    - Own Q-VCAs U51/U52 (cell A = HP Q; cell B spare, terminated: In±->GND,
    Out->R_QB_OUT->GND, Iabc->R_QB_IABC->GND, buffers/diode NC).
    - Single shared expo (U55); own IRES_AMP (U66, was missing from BOM); integrator
    buffer pulldowns (R112-115). Full SVF BOM expansion (R92-R115, C86-C106, D12).
    67 parts / 42 nets; all footprints resolve; HP_OUT matches block-8 byte-for-byte;
    structural verify (incl. short detector) clean across al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
    [pogo-block-7.kicad_sch, pogo-bom.csv]
2026-05-29 kicad: add TL074 quad multi-unit support (block-3 prep)
    Generator prep for block-3 (mod bus, 7× TL074): add opamp_quad_unit_pins +
    opamp_quad_all_pins, register 'opamp4' in SYM_TABLE, and add it to MULTI_UNIT so
    each of the 4 gates + power unit is placed as its own instance at distinct offsets
    (same fix class as the dual-op-amp placement bug). Unused until block-3; all 9
    existing sheets still verify; opamp4's 14 pins lay out at distinct coordinates.
2026-05-29 kicad: block-3 mod bus (9 of 10) + TL074 quad + zener infra
    block-3 (mod bus, utility board): MB processor (U3 scale/offset summer -> ±10V
    BZX84C10 zener clamp -> inverter -> V_MODBUS), 3 MOD lights (U4 + drivers + LED3-5),
    and the 19 CV destinations. Each destination: override jack (tip-switch normals to
    V_MODBUS via R_SRC_NORM) + 100Ω/BAT54S protection + TL074 -V_src inverter +
    attenuverter pot -> MOD_<DEST> boundary output (summed with panel CV at board level,
    per the 2026-05-29 decision). VCA_AMT dest taps V_MODBUS directly (its override jack
    J26 is in block-4). 170 parts / 135 nets; the 19x repetition was generated
    programmatically; all footprints resolve; LFO1_OUT matches block-2.
    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
    [pogo-block-3.kicad_sch, pogo-bom.csv]
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2026-05-29 components: block-6 BOM expansion for Option B + per-channel expo (finale prep)
    Per the two locked block-6 decisions:
    - Option B (DSP-faithful BP): the plugin BP is the same 2-integrator Simper SVF as
    LP1/HP/LP2, so BP gets separate Q-VCA OTAs (aux-q-control already specified them;
    the rewrite's BOM omitted them). Added U67-U69 (3 LM13700 BP Q VCAs, cell A=L/B=R)
    + Q control (U73/U74 IRES_AMPs, R_Iabc/R_QBIAS/R_QINV/R_f_q, D_IRES, Iabc bypass).
    - Per-channel expo (true BP_TILT): added U70-U72 (R-channel THAT340) + their V/oct
    networks (R_IREF_R/R_VOCT_R/R_E_R, RV24/RV25 trims, C_IREF).
    Also added the integrator support the rewrite omitted: buffer pulldowns (R123 qty12),
    integrator Ia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
    [pogo-bom.csv]
2026-05-29 components: complete block-6 expo BOM (L/R expo networks + tilt summers)
    Walking the block-6 circuit to build the netlist surfaced more gaps in its sparse
    (STALE §2-4) BOM, now filled: L-channel expo networks R_IREF/VOCT/E (R124-126,
    U28-30 had none), and the per-channel-expo tilt-summer resistors R127 (±V_tilt into
    each of the 6 expo bases, like block-5's R55/R56). With the earlier additions
    (Option B Q-VCAs, R-channel expo, Q control, buffer pulldowns, decoupling) the BP
    SVF + Q + expo BOM is now complete.
    Netlist deferred: block-6's distortion mux (1-of-3 SC/HC/WF for 2 channels from a
    single CD4053 + DW5 per group) is genuinely under-specified in the STALE aux-
    distortion and doesn't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
    [pogo-bom.csv]
2026-05-29 components: add block-6 distortion-mux parts (+3 CD4053, DW5 encoder pull-ups)
    Per the confirmed plugin-faithful distortion mux: stereo 1-of-3 SC/HC/WF needs 2
    CD4053 per group (U31/U75, U32/U76, U33/U77), with the DW5 (SW4-6) as a 3-position
    mode encoder (R128 pull-ups → 2 control bits). Bumped C110 decoupling to 45 ICs.
    block-6 BOM now complete (119 rows); all decisions locked. Netlist build next.
    [pogo-bom.csv]
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2026-05-29 kicad: block-6 triple BP + distortion (10 of 10)
    Transcribe the last block as a data-driven netlist (kicad/gen_block6.py,
    3-group repetition like block-3) -> kicad/nets/block-6.nets.yaml +
    pogo-block-6.kicad_sch. generate_schematic.py --check clean across all
    10 blocks + shared-q; zero blank footprints; boundary nets (LP1_OUT,
    BP_OUT, BP3_TAP, BP3_L/R_OUT) match the neighboring sheets.
    Topology (reconciled against the plugin as ground truth):
    - Option-B DSP-faithful SVF: same 2-pole Simper SVF as LP1/HP/LP2, tapping
    v1 (BP) instead of v2; per-group per-channel Q-VCA OTAs (U67-69) inject
    damping current at the SUM_AMP virtual ground (mirrors shared-q).
    - Per-channel expo (U28-30 L, U70-7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
    [pogo-block-6.kicad_sch]
2026-05-29 docs: adopt gated plugin-first change process (change 0001)
    Replace the CLAUDE.md 'Git Workflow' section (which said 'all development on
    dev') with 'Git Workflow & Change Process': one change/<slug> branch per
    change -> PR to dev; 3 lanes (A behavioral / B hardware-only / C trivial);
    per-change Steps 0-8 with hard-stop gates G1-G6; corrected invariants
    (plugin = ground truth; all five CI --check gates; .kicad_sch committed
    beside .nets.yaml; datasheet-verified symbols). Per-change Steps renamed to
    avoid colliding with the project Phase 1R-6R milestones.
    Tracked per change in changes/NNNN-<slug>.md (persistent; added
    changes/_TEMPLATE.md + the first dogfood file changes/0001-adopt-change-pro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
2026-05-29 docs: refresh README for current status + change process
    README predated the schematic generator and the new workflow. Updates:
    - Schematic generation: replace the 'KiCad generators are 40HP-era stale /
    new schematics in Phase 5R' section with the current data-driven per-block
    generator (generate_schematic.py, nets/*.yaml -> .kicad_sch, --check),
    10/10 blocks + shared-q; scope the STALE note to the legacy board generators.
    - Project State: note schematics transcribed + CI-gated; Phase 3R row updated.
    - Repository Structure: fix kicad/ tree, add components/ and changes/, correct
    components.yaml count (265 -> 476), fix block-A/block-1 ICs (-> OPA1612).
    - CI: note all five --check gates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
2026-05-29 docs: parts/code/BOM/schematic links + interactive BOM viewer
    docs/index.html: add cards linking the plugin source (plugin/src), the BOM
    viewer (bom.html), the per-block schematics (kicad/), the front-panel SVG, and
    a 'PCB Layout - Phase 5R (pending)' placeholder (no .kicad_pcb exists yet).
    docs/bom.html: self-contained interactive BOM viewer (search, sort, and a
    group-by-block toggle with per-block ref/pcs subtotals). Fetches ./pogo-bom.csv.
    tools/build_components.py: --gen-bom now also writes docs/pogo-bom.csv (identical
    copy for the Pages viewer); --check drift-gates it alongside kicad/pogo-bom.csv.
    Lane C (docs + build tooling). All --check gates green; CSV parser verified against
    the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
    [pogo-bom.csv]
2026-05-29 docs: BOM type column + footprint popups, panel viewer, CI + change-process pages
    BOM viewer (docs/bom.html): add a Type column (resistor/capacitor/IC/trimpot/
    jack/diode/switch/LED, derived from ref prefix) and footprint hover popups that
    show a rendered land-pattern per row.
    Footprint renderer (tools/footprint_svg.py): parse each vendored .kicad_mod
    (pads + silk/fab/courtyard; legacy 'module' + 'footprint' formats) -> small SVG.
    build_components.py: --gen-fp writes docs/footprints/<slug>.svg (19); --gen-panel
    copies panel art to docs/Pogo.svg; Type column added to the canonical BOM; --check
    drift-gates the BOM, docs CSV copy, footprint SVGs, and panel copy.
    docs/panel.html (new): embeds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
    [pogo-bom.csv]
2026-05-29 docs: make 'what happens on commit' a card (docs/ci.html)
    Move the inline commit/CI explainer from the index landing page into its own
    docs/ci.html page and replace the section with a 'What Happens on Commit' card,
    matching the rest of the grid. Drop the now-unused .commit CSS.
    Lane C (docs only). Pages well-formed; --check gates unaffected.
    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
2026-05-29 consolidate: nets->specs, footprints->components, scrub stale, mark generated
    Structural reorg (Lane B) per changes/0009. Design lives in specs/, component
    sourcing in components/, generated/KiCad artifacts in kicad/.
    Moves (history-preserving git mv):
    - kicad/nets/block-N.nets.yaml -> specs/block-N/ ; shared-q -> specs/block-Q/ (+ stub spec).
    generate_schematic.py scans specs/block-*/*.nets.yaml; gen_block6.py OUT repointed.
    Generated .kicad_sch stay in kicad/ (byte-stable; nicknames not paths).
    - kicad/footprints/*.pretty -> components/footprints/. Updated _FP_ROOT in 4 tools +
    the fp-lib-table URI (KIPRJMOD/../components/footprints). Only fp-lib-table byte-drifts.
    Deletions (40HP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
    [pogo-control-board.kicad_sch, pogo-utility-board.kicad_sch]
2026-05-29 specs: clarify shared block-Q Q-VCAs in block-5/8 (de-stale IC_Q_AB)
    Follow-on to the §4 removal: block-5/8 §4 pointers now flag the shared LP1/LP2
    Q-VCAs (U9/U10, owned by specs/block-Q/); replaced the stale generic IC_Q_AB
    name with U9/U10 in block-5/8 §3 prose; corrected the block-5 power line (the
    shared Q-VCAs are 2 ICs = ~8 mA, total ~31 mA). aux-q-control keeps IC_Q_AB as a
    generic building-block label. Archive untouched.
    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
2026-05-29 shared: replace block-Q with dual-ownership + shared flag (fold into block-5)
    Per the chosen model: shared parts carry block: [block-5, block-8] + shared: true
    in components.yaml (dual ownership, one refdes), and the U9/U10 Q-VCAs are folded
    onto block-5's sheet (the host / first owner). Removes the synthetic block-Q, its
    pseudo-spec (specs/block-Q/), and the separate pogo-shared-q.kicad_sch.
    - components.yaml: 10 shared rows -> block: [block-5, block-8], shared: true.
    - block-5.nets.yaml: U9/U10 + caps folded in; LP1 Q nets now internal; LP2_*
    become block-5->block-8 boundary nets. block-5 sch regenerates (75 parts/51 nets).
    - build_components.gen_bom: render list-valued Block ('block-5,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
    [pogo-block-5.kicad_sch, pogo-bom.csv, pogo-shared-q.kicad_sch]
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2026-05-30 0012-data-driven-symbols: load symbols/pinouts from components/symbols.yaml
    Move per-device KiCad symbol + pinout knowledge out of hand-coded
    kicad_common.sym_*()/*_pins() (two hand-synced copies, re-encoded a 3rd
    time in gen_block6.supply) into authored data:
    - components/symbols.yaml: 16 archetypes (lib_id, body graphics, per-unit
    pins with their connection-point at, placement, datasheet citation)
    - tools/symbols.py: parse/emit/load + a single connection_point() feeding
    BOTH the emitted pin (at) and pin_points() — kills the sym<->pins drift
    class behind the LM13700 / THAT340 / CD4053 pin bugs. Adds selfcheck().
    - tools/kicad_common.py: slimmed 1030 -> ~90 lines, generic emitters o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
    [pogo-block-1.kicad_sch, pogo-block-2.kicad_sch, pogo-block-3.kicad_sch, pogo-block-4.kicad_sch, pogo-block-5.kicad_sch, pogo-block-6.kicad_sch, pogo-block-7.kicad_sch, pogo-block-8.kicad_sch]
2026-05-30 0013-per-file-symbols: split symbols monolith into per-token primitive files
    - components/symbols.yaml (1659-line monolith) -> components/symbols/<token>.yaml
    x16 self-contained authored files; symbols.load() globs the dir. Per-file load
    verified deep-equal to the monolith before deleting it.
    - each components/parts/<slug>/component.yaml gains 'symbol: <token>' so a sourced
    part now selects BOTH its symbol and footprint primitive (self-contained).
    - components.py --check: a declared 'symbol:' must resolve to a real primitive.
    - generate_schematic.py --check: new cross-check — a ref bound to a part must wire
    the same sym the part declares (negative-tested).
    All 10 .kicad_sch + pogo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
    [bat54s.yaml, c.yaml, cd4053.yaml, diode.yaml, dw3.yaml, dw5.yaml]
2026-05-30 0014-stale-md-scrub: fix stale docs after symbol/restructure work
    - README.md: tools tree adds symbols.py + fixes kicad_common role; components
    tree adds symbols/<token>.yaml + notes component.yaml selects both primitives;
    'symbols/pinouts in kicad_common.py' -> components/symbols/ via symbols.py;
    '10 blocks + shared-Q sheet' -> 10/10 blocks, Q-VCAs hosted on block-5
    - SCHEMATIC-GEN-PLAN.md: sym_cd4053/cd4053_pins -> the CD4053 symbol (now
    components/symbols/cd4053.yaml); 'like shared-q' wording; power_sym() removed
    - block-6/spec.md: 'like the shared-q sheet' + 'wrong in kicad_common.py' ->
    current locations
    - module-overview.md / aux-mod-bus-core.md / board-layout/layout-notes.md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
2026-05-30 0015-lfo-rate-panel-pot: LFO Rate → 9mm log panel pot (like attenuverters)
    LFO1/2 Rate (block-2 RV1/RV2) were specced as Bourns 3296W screwdriver
    trimmers despite being front-panel controls. The plugin (Trimpot widget)
    and panel (type: trimpot) already treat them like the attenuverters; only
    the hardware part diverged. Swap to the attenuverter panel-pot family:
    - components.yaml + block-2.nets.yaml RV1/RV2: 'Bourns 3296W'/through-hole
    -> 'log pot'/9mm (resolves to Alpha RD901F-40, the attenuverter footprint)
    - block-2/spec.md: 9mm log panel pot, player-adjustable; drive-attenuator
    topology retained; log taper gives the ~exponential rate sweep matching
    the plugin 0.05x400^param law;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
    [pogo-block-2.kicad_sch, pogo-bom.csv]
2026-05-30 0015-component-audit: adversarial component verification report
    Six parallel adversarial agents audited all 19 sourced parts, 16 symbols,
    footprints, and specs/components.yaml against primary datasheets.
    Two board-breaking findings (independently re-verified):
    - that2180: fabricated MPN THAT2180LD + wrong package (SIP-8 THT, not SOIC-8 SMD)
    - bat54s: symbol draws common-cathode (BAT54C); real BAT54S is series
    Plus medium/low findings; report-only, no fixes applied.
2026-05-30 0015-component-audit: apply component verification fixes
    Board-breaking:
    - that2180: real MPN THAT2180AL08-U (grade A) + package SIP-8 (THT); vendor
    Package_SIP/SIP-8_2.54mm footprint; fix components.yaml U4/U5 + CLAUDE.md.
    The 2180 has no SMD/SOIC variant.
    - bat54s: redraw symbol to real series topology (1=A1, 2=K2, 3=K1;A2 junction);
    swap pins 2<->3 on all 24 BAT54S instances (blocks A/1/3/4) so signal sits on the
    junction (pin3), +12V on K2 (pin2), -12V on A1 (pin1); fix aux-cv-protection.md +
    block-A spec (both mislabeled the signal node as pin 2).
    Other:
    - R_INV_IN/R_INV_FB: add tol 1% (header-required >60 dB null).
    - slide_pot_45mm: MPN RA4522F (Alpha 45mm, Rapid/Banzai); fi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
    [pogo-block-1.kicad_sch, pogo-block-2.kicad_sch, pogo-block-3.kicad_sch, pogo-block-4.kicad_sch, pogo-block-5.kicad_sch, pogo-block-6.kicad_sch, pogo-block-7.kicad_sch, pogo-block-8.kicad_sch]
2026-05-30 0016-tall-trimmer-pots: bind panel trimpot → Song Huei 9mm tall trimmer (WIP, pre-relayout)
    Convert all panel trimpot-type controls from the Bourns 3296W screwdriver
    trimmer footprint to a Song Huei 9mm tall-trimmer (finger-adjustable panel
    pot). Vendored the footprint (standard 9mm vertical land pattern) and bound
    the panel trimpot type to it.
    The 9mm footprint (~13.75mm) doesn't fit the current 11.43mm attenuverter
    grid laid out for the tiny 3296W — DRC now reports overlaps across the
    mod/filter control bank. Panel re-layout is the next step (maintainer
    editor pass, G2). BOM repoint + component sourcing deferred until the grid
    is settled (grid-first).
    Also fixes a pre-existing bug: b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
2026-05-30 0016: refine PCB-overlap DRC to real footprint collisions (pads+body)
    Replace the conservative courtyard-bbox overlap check with real per-feature
    collision (each pad rect + the body) in both the Python gate and the editor's
    live JS DRC, so densely interleaved 9mm pots aren't false-flagged by the
    bounding courtyard (whose offset pins/legs make it ~13.75mm wide).
    - panel_kicad.footprint_shapes(): per-feature keepout rects from the .kicad_mod
    (pads + F.Fab body circle for round pots; parser now captures pad size/rot)
    - panel_rules._check_pcb_overlaps(): overlap every pad/body rect pair (real
    keepout is a subset of the courtyard -> no regressions); 'footprint overlap'
    - panel_editor.py expo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
2026-05-30 0016: fix editor runDRC crash — restore courtyard rect for §4 MH-clearance
    Section 3 (overlaps) switched fp to carry real-shape 'rects', but section 4
    (mounting-hole clearance) still read the singular 'rect' (courtyard) → it was
    undefined → 'undefined is not iterable' in runDRC. fp now carries both: 'rects'
    (real per-feature, used by §3) and 'rect' (bounding courtyard, used by §4 to
    match the CLI's _check_mounting_clearance). node --check passes.
    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
2026-05-30 0016: fix DRC rotation direction to match the SVG draw transform
    _rotate_rect (Python) and rotateRect (JS) rotated 90/270 the OPPOSITE way to
    the editor's SVG draw (rotate(+deg) = (x,y)->(-y,x) in y-down). Harmless while
    the courtyard was near-square, but with the real asymmetric pot footprint the
    collision pins went one way while the drawn pins went the other — so rotated
    pots' DRC didn't match the displayed orientation. Swapped 90<->270 to CW.
    Existing rotate:270 components (GAIN toggles, near-square) unaffected; DRC count
    unchanged (45 real overlaps in the current 11.43mm grid). node --check passes.
    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
2026-05-30 0016: draw the round body (not the rectangular base) so editor matches DRC
    Verified the rotation is already exact (at rot=90 every drawn pad center equals
    its DRC rect center: pad1 (22.5,12.5), legs (15.2/24.8,20), body (20,20)). The
    remaining 'doesn't match' was the footprint's F.Fab rectangular base outline,
    which the editor drew but the DRC (round body circle) didn't use — so the drawn
    body and the collision body diverged when rotated.
    Simplified the Songhuei footprint F.Fab to the round body circle + pads only
    (dropped the base rectangle + rectangular silk). footprint_shapes already used
    the circle, so DRC is identical (6 rects, body 9.7mm, TRIMPOT_CY unchanged, 45
    overlaps). Now the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
2026-05-30 0016 (WS1): body keepout = full F.Fab outline; restore pot squarish base
    Root cause of 'pins/bodies don't collide': footprint_shapes picked the small
    F.Fab indicator CIRCLE as the body (jack r1.8, knob r3.5 shaft, my trimpot
    r4.85) instead of the real body outline. Fixed:
    - footprint_shapes body = bounding box of ALL F.Fab geometry (lines ∪ circles),
    so it uses the real outline (jack 9x12.5, pot/knob squarish base 11.35x9.5,
    LED stays its 3mm circle) and ignores the tiny shaft/hole indicator.
    - Restored the Songhuei trimpot's squarish base rectangle (matches the Alpha
    9mm RD901F land pattern; trimpot shapes now == knob shapes).
    Now the checked body == the drawn F.Fab outline, and th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
2026-05-30 0016 (WS3 + #3): real-collision unit tests + penetration overlap metric
    - panel_rules._check_pcb_overlaps: report boolean + true penetration depth
    (max over colliding feature-pairs of min(dx,dy)), dropping the lossy max-AREA
    pair (#3, maintainer-approved).
    - test_drc.py: updated to the real pads+body model. Proximity tests now derive
    the touch separation from footprint_shapes via _touch_sep (no brittle courtyard
    magic numbers); TRIMPOT_CY doc + rotate-180 + toggle/trimpot tests fixed to the
    9mm pot. New TestRealCollisionModel locks: body=squarish base (not shaft circle),
    trimpot==knob land pattern, pin-of-B-under-body collides (the reported bug),
    clear at 14mm, rotation matches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
2026-05-30 0016 (tests): side-to-side + rotation failure-mode unit tests
    TestSideBySideRotationModes locks the offset-pin-cluster behaviour that drives the
    'side-to-side' collisions:
    - same rotation (rot0/rot0) horizontal: collisions are exactly A.body vs B's 3 pins
    (the center pin reaches ~0.55mm under the neighbour body at 12.7mm); clear at 14mm.
    - alternating rotation (rot0/rot180): pins face apart -> CLEAR even at 11.43mm.
    - both rot90: clash is leg-pad vs leg-pad; clear at 13mm.
    - rot180/rot180 is the mirror (B.body vs A pins).
    Documents that side-by-side same-rotation overlap is the offset pins, not body-body,
    and that alternating 0/180 interleaves clear. 48 pass / 1 xfail; parity still OK.
    (m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
2026-05-30 0016: rework DRC to real fab rules (centred-can body + 0.2mm pad clearance)
    Per maintainer direction, the PCB overlap check now mirrors real PCB DRC:
    - footprint_shapes returns {body, pads, legs}: body = centred ~9.7mm can (F.Fab
    circle on the shaft), pads = named electrical pads at real copper size, legs =
    unnamed structural mounting tabs.
    - _check_pcb_overlaps: bodies must not OVERLAP (placement); electrical copper keeps
    PCB_PAD_CLEARANCE_MM=0.2 (JLCPCB/PCBWay pad-to-pad min); leg-vs-leg exempt but
    leg-vs-signal flags; no pad-vs-body cross.
    - Songhuei footprint F.Fab = centred can (was offset KiCad outline); editor now
    draws pads at REAL size (legs fainter).
    - drc.js/PogoDRC + dr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
2026-05-30 0017-dist-before-bandpass: move distortion before bandpass + MOD SRC switch
    Topology change (per-band): signal is now distorted BEFORE its bandpass
    filter (x -> DISTn -> BPn) instead of after. The three filtered bands are
    summed/mixed as before; CLIP LEDs now monitor the distortion stage output.
    - BandpassSVF: process() now takes a per-band input array (each group gets
    its own distorted feed); returns void, results in prevOut[3].
    - BP3 L/R OUT taps the post-BP3 band (pre-mix).
    - MOD SRC: new 3-way MOD_SRC_PARAM (LFO1 / LFO2 / EXT); EXT = MOD_IN jack
    only (0 V if unpatched). Replaces the old "MOD_IN if patched else LFO1".
    - Panel reconciliation: bind MOD_SRC_PARAM to the existing MOD_SRC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
    [panel-data.yaml]
2026-05-30 0016: rebuild footprint to real Song Huei R0904N + pin-vs-body fails
    Per the R0904N datasheet (maintainer-supplied): the body is a 9.7mm SQUARE with the
    shaft CENTRED and the 3 signal pins ~3.5mm below it — not the 7.5mm side-offset round
    can carried over from the Alpha RD901F. Rebuilt the footprint accordingly:
    - 9.7mm square F.Fab body centred on the shaft (anchor = shaft at origin, ox/oy 0,0)
    - 3 signal pins Ø1 @ 2.5mm pitch on one edge; 2 snap-in legs (2.2x1.8) on the other
    - footprints.yaml trimpot ox/oy -> 0,0
    Re-enabled SIGNAL-pin-vs-body as a collision (maintainer: 'pins hitting that body
    should def fail too') — now safe because pins sit near their own shaft, so a pin only
    reac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
2026-05-30 0016: source Song Huei R0904N + repoint panel-pot BOM refs (G6a)
    - new part components/parts/songhuei_r0904n (matches lin/log/bipolar pot)
    - move taper tags off alpha_rd901f (keeps knob/large/xl knob)
    - RV41/RV43 (HP_RES/LP2_RES) Bourns 3296W -> R0904N finger pot
    - regen block-2/3/4 schematics (att/LFO/VCA pot footprint) + BOM
    [pogo-block-2.kicad_sch, pogo-block-3.kicad_sch, pogo-block-4.kicad_sch, pogo-bom.csv]
2026-05-30 0016: record G6a sourcing + BOM repoint + --cpp fix + GUI sync
2026-05-30 0018: block-A hardware re-verified to plugin (doc-only)
    No behavioral divergence from the locked plugin (0017 follow-up). Corrected
    DSP source citation, LM4562->OPA1612 part-identity note, lifted §2/§3 STALE
    banners, fixed aux cross-references, corrected the 100Ω clamp-current
    derivation (47mA worst-case, 100Ω retained), and fixed the systemic
    Control->audio board-name error in aux-unity-buffer Used-By table.
    https://claude.ai/code/session_013jFXG5oeMVSYP7iRpwGvtQ
2026-05-30 0018: block-1 ALT path corrected to plugin (G4 text)
    Gain-stage netlist is correct; local fixes are spec/comment text only. ALT
    path now correctly described: through the VCA (shared control) -> BP3 only,
    bypassing LP1 (not the VCA); BP3 input selector must be per-channel (handles
    the asymmetric L-unpatched/R-patched case). Lifted STALE banners, fixed aux
    refs + DSP citation, switch documented as path-select, softened the aux
    'OPA1612 only at Block A' note to a per-role policy.
    Substantive ALT hardware deferred and logged: block-4 (2nd THAT2180 ALT VCA
    cell on shared control) and block-6 (per-channel BP3 selector + the still-
    unbuilt 0017 DIST->SVF reorder).
    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
2026-05-30 0018: block-2 LFO reroute to MOD_SRC switch + aux/doc refresh
    LFO core verified faithful to plugin. Both LFO outputs now tap the block-3
    MOD_SRC 3-way switch (LFO1_OUT -> pos 0; new LFO2_OUT boundary -> pos 1),
    replacing the superseded passive LFO1-into-MOD_IN normalling. Rewrote spec
    §1/§2 mod-source description; refreshed aux-lfo-core (log panel pot not
    linear preset, full-cycle breathing LED not half-wave, dropped 10M rheostat
    and breathing-vs-pulsing orphans, fixed Used-By board names); corrected the
    stale MOD_SRC and ALT-path sections in docs/plugin-topology.md.
    LED driver re-spec to full-cycle breathing (user: match plugin) is staged as
    a G5/G6a proposal; block-3 switch wiring defer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
    [pogo-block-2.kicad_sch]
2026-05-30 0018: block-2 breathing LED driver (MMBT3904 current source)
    Re-spec the LFO LEDs to match the plugin's full-cycle (V_tri+5)/10 brightness
    law. Replaces the half-wave 1N4148 'pulsing' LED (which the spec wrongly
    claimed matched the plugin) with a per-LED NPN current source: V_tri level-
    shifted onto the base, LED fed from +12V through the transistor, emitter R
    sets full-scale current -> the LED breathes across the whole cycle.
    - New part MMBT3904 (NPN, SOT-23) registered: components/parts/mmbt3904 +
    new 'npn' symbol primitive (1=B,2=E,3=C, maps to SOT-23 pads).
    - components.yaml: +Q1/Q2, +R19-R24 base networks; R9/R10 1.2k->470 (R_E);
    D1/D2 removed. nets rewired; block-2 schematic + BOM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
    [pogo-block-2.kicad_sch, pogo-bom.csv]
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2026-05-30 0018: block-3 mod bus aligned to plugin (MOD_SRC, LEDs, VCA, FOCUS→TILT)
    Largest block of the alignment pass. Changes:
    - MOD_SRC: wire SW7 (DW5) as a 3-way analog source select LFO1/LFO2/EXT
    (DPDT commons bridged); MOD_IN becomes EXT-only (no LFO auto-normal);
    accept LFO1_OUT + LFO2_OUT boundary inputs from block-2.
    - Remove the 3 MOD-bus LEDs (POS/NEG/CLIP) + driver U4 + R56-R60: the
    plugin drives no such lights and the locked panel has no footprints
    (7x -> 6x TL074).
    - VCA: remove the block-3 VCA_AMT attenuverter (RV5 + inverter); per the
    plugin the raw mod bus normals into VCA_INPUT (no attenuverter) and the
    VCA_AMT depth pot belongs to block-4.
    - Rename per-band BP*_FOCUS -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
    [pogo-block-3.kicad_sch, pogo-bom.csv]
2026-05-30 0018-netlist-visualizer: bridged connectivity through hidden parts + ref-collision fix
    - Bridged (dashed) connectivity: when a hidden part is a 2-terminal series element on
    two non-power nets (R/C/diode in the signal path), contract its nets (union-find,
    handles chains) and draw the surviving endpoints with a dashed star — IC-R-IC with
    resistors hidden still shows IC...IC. Shunt/decoupling parts (one pin on a rail) are
    excluded so signal never merges into GND. Sim + render now operate on merged 'groups';
    with nothing filtered each group == its raw net (solid, unchanged). Legend + readout
    ('N bridged') updated.
    - Fix ref collisions across blocks (49 dupes, e.g. R1 in block-A & b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
2026-05-30 0018-netlist-visualizer: BOM-parity drift gate + deterministic output
    Make docs/netlist.html behave exactly like the BOM artifact:
    - deterministic / byte-stable output (drop the wall-clock timestamp from the model;
    metasub now shows block count instead).
    - build_netlist_viz.py --check upgraded to a drift gate: fails if the committed
    docs/netlist.html (served by GitHub Pages) doesn't byte-match a fresh render of the
    nets, mirroring build_components.py --check for the BOM. Still also asserts extraction
    sanity (all blocks parsed, no hard failures).
    - CI runs only --check (drift gate) in all 3 jobs; the committed file is staged into the
    hardware artifact bundle (no in-CI regeneration,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
2026-05-30 0018-netlist-visualizer: mark CLOSED (PR #44 merged)
    Trivial Lane C status flip — the change file was squash-merged still reading
    PR OPEN. Set Status: CLOSED, Closed date, and PR #44.
    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
2026-05-30 0018: block-4 ALT-BP VCA cell + OFS placement fix
    - ALT-BP VCA (B1 deferral): per the plugin the ALT signal passes through a
    VCA on the SAME control as the main path into BP3 (Pogo.cpp:439-441). Add
    2x THAT2180 (U78 ALT-L, U79 ALT-R) + I/V (U80) + R_in/R_f/Ec+ trims/decoupling,
    all sharing V_ctrl. New boundary nets: ALT_OUT_L/R (in, from block-1) and
    ALT_VCA_OUT_L/R (out, to block-6 BP3 selector). THAT2180 count 2->4.
    - VCA_OFS placement fix: the plugin adds OFS to the CV BEFORE the AMT gain law.
    Restructure the CV chain so OFS is summed into the CV ahead of the symmetric
    +/-effCV AMT pot -> AMT=0 (center) gives unity regardless of OFS, matching
    the plugin (old netlist summed O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
    [pogo-block-4.kicad_sch, pogo-bom.csv]
2026-05-30 0018: block-5 LP1 re-verified to plugin (doc + self-osc fix)
    No behavioral divergence: the topology already matches the plugin (2-pole
    Simper SVF, f0=632*2^cutoffV V/oct, per-channel THAT340 expo for true stereo
    tilt L=base+tilt / R=base-tilt, Q=0.5*4000^res reaching self-oscillation).
    Corrections: fixed the §1-vs-§2 self-oscillation contradiction (the '~50 Q
    cap for stability' note was wrong -- the hardware must and does reach
    self-oscillation to match the plugin; RV5 trims the onset); corrected the
    power tally (1->2 THAT340 for per-channel tilt); lifted the now-misleading
    STALE banners on spec §2/§3 and aux-q-control/aux-expo-converter/aux-ota-c-svf
    (bodies were rewritten 2026-05-29);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
    [pogo-bom.csv]
2026-05-30 0018: split block-6 into 7 sections (behavior-preserving)
    Decompose the monolithic Triple-BP+Distortion block into per-band sections
    (Scheme B): block-6-svf1/2/3 (OTA-C bandpass), block-6-dist1/2/3 (SC/HC/WF +
    CD4053 mux), block-6-mix (wet summer, MIX amp, tilt inverter, 5V logic, BP3
    jacks). No behavior change -- same 418 parts, same connectivity; every
    cross-section wire is now an explicit boundary net.
    - 7 new specs/block-6-*/*.nets.yaml + generated schematics; old monolith
    (block-6.nets.yaml + pogo-block-6.kicad_sch) removed.
    - components.yaml: 119 block-6 rows redistributed to the 7 section IDs (qty
    rows split by band; quantities preserved). U73 (BP1+BP2 IRES_AMP) = one
    shared ro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
    [pogo-block-6-dist1.kicad_sch, pogo-block-6-dist2.kicad_sch, pogo-block-6-dist3.kicad_sch, pogo-block-6-mix.kicad_sch, pogo-block-6-svf1.kicad_sch, pogo-block-6-svf2.kicad_sch, pogo-block-6-svf3.kicad_sch, pogo-block-6.kicad_sch]
2026-05-30 0018: block-6 stage 1 - F_REF 400Hz all bands + pole-count doc
    Per user confirmation, the plugin's F_REF = {400,400,400} is correct (the
    {200,1500,6000} formant spread was a stale code comment). Align the hardware:
    - All 3 BP integrator caps (C15/C19/C23) -> 68nF C0G 0805 (was 150/22/4.7nF),
    trimmed to 400Hz by each band's f_ref trim. Bands now default to the same
    center and the player spreads them via the FREQ knobs.
    - spec §2 f_ref table, expo-trim targets, and cap derivation updated to 400Hz;
    fixed the stale '3x THAT340 shared L/R' -> 6x per-channel.
    - Resolved the long-standing BP '4-pole vs 2-pole' question: the plugin BP is a
    single 2-pole SVFGroup (returns v1), so hardware 2-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
    [pogo-block-6-svf1.kicad_sch, pogo-block-6-svf2.kicad_sch, pogo-block-6-svf3.kicad_sch, pogo-bom.csv]
2026-05-30 0018: block-6 stage 2 - distortion BEFORE bandpass (0017 reorder)
    The core 0017 change: flip the per-band order from SVF->DIST to DIST->SVF to
    match the plugin (Pogo.cpp:443-451). Realized as a net re-point across the 7
    split sections (no part changes):
    LP1_OUT / BP3IN -> distN (R18/R20/R22 distortion inputs)
    -> mux out (BPn_DISTOUT) -> svfN SUM_AMP (R13)
    -> SVF v1 buffer (BPn_BANDOUT / BP3_TAP) -> mix wet summer
    - BP1/BP2 take the LP1 band; BP3 takes BP3IN (the ALT/LP1 selector, stage 3).
    - BP3 OUT tap now taken post-bandpass (BP3_TAP = svf3 v1), matching the plugin
    (prevOut[2]); block-B keeps the BP3_TAP net name (no block-B change).
    - spec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
    [pogo-block-6-dist1.kicad_sch, pogo-block-6-dist2.kicad_sch, pogo-block-6-dist3.kicad_sch, pogo-block-6-mix.kicad_sch, pogo-block-6-svf1.kicad_sch, pogo-block-6-svf2.kicad_sch, pogo-block-6-svf3.kicad_sch]
2026-05-30 0018: block-6 stage 3 - BP3 input selector (ALT-VCA vs LP1)
    Build the BP3 input selector the plugin requires (Pogo.cpp:440-441): a CD4053
    mux (U81, block-6-dist3) picks per channel between the LP1 band (LP1_OUT) and
    the ALT-VCA voice (block-4 ALT_VCA_OUT), feeding BP3's distortion input.
    - Select = ALT_L_DET, an ALT_BP_L insertion detect: J3 tip-switch lug (block-1)
    -> ALT_L_DET, +12V pull-up (R133, dist3) + 22k tip pulldown (R134, block-1);
    patched=ALT-VCA, unpatched=LP1.
    - BP3IN is now an internal dist3 net (mux out -> distortion), resolving the
    previously hand-waved boundary. New boundary nets: ALT_L_DET (block-1->dist3),
    ALT_VCA_OUT_L/R (block-4->dist3), LP1_OUT extended to dist3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
    [pogo-block-1.kicad_sch, pogo-block-6-dist3.kicad_sch, pogo-bom.csv]
2026-05-30 0018: block-6 stage 4 - per-band BP TILT (summer+inverter/band)
    The per-band tilt was entirely unbuilt (the panel BP1/2/3 TILT knobs had no
    hardware control component at all, and only the master tilt was wired). Build
    it to match the plugin's groupTiltV[i] = BPn_TILT_PARAM + CV*0.22:
    - Per band (svf1/2/3): +1 TL072 (U82-84) as an inverting summer + inverter.
    Summer combines master tilt (BP_TILT_CV, 100k) + the per-band TILT knob
    (RV48-50 bipolar, 100k) + the per-band TILT CV (MOD_BPn_TILT from block-3,
    470k -> x0.213 ~= the plugin's x0.22). -total feeds the R expo base; the
    inverter's +total feeds the L expo base.
    - Re-pointed R127_nL/R from the old shared master tilt onto the per-ba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
    [pogo-block-6-mix.kicad_sch, pogo-block-6-svf1.kicad_sch, pogo-block-6-svf2.kicad_sch, pogo-block-6-svf3.kicad_sch, pogo-bom.csv]
2026-05-30 0018: block-6 stage 5 - variable DRIVE (THAT2180 VCA per band)
    Build the per-band variable-drive stage the plugin needs (driveCv into the
    waveshaper). A stereo THAT2180 current-in/I-V-out VCA per band, inserted at the
    distortion input, mirroring the proven block-4 cell pin-for-pin:
    band -> R_in(20k) -> THAT2180.1 ; .8 -> TL074 I/V(-) + R_f(20k) -> BPn_DRIVEOUT
    -> SC/HC/WF cells. Ec+ (pin2) via Bourns unity trim <- V_DRIVE_CTRL.
    Drive control: per-band DRIVE knob (RV33/36/39) + DRIVE CV (MOD_BPn_DIST from
    block-3) summed (TL074 half) into Ec+; knob=0.20 ~= unity. A single dB-law VGA
    per band approximates the plugin's per-mode gain (SC exp vs HC/WF linear) -- a
    documented deviation; exact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
    [pogo-block-6-dist1.kicad_sch, pogo-block-6-dist2.kicad_sch, pogo-block-6-dist3.kicad_sch, pogo-bom.csv]
2026-05-30 0018: block-6 stage 6 - per-band CLIP LED drivers
    The plugin lights BPn_CLIP when max(|distOut_L|,|distOut_R|) > 4V; the panel
    has the CLIP LEDs but no hardware drove them. Build a per-band window
    detector on the distortion output (BPn_DISTOUT_L/R, the CD4053 mux output):
    - TL074 (U94/U95/U96) as 4 comparators per band: DISTOUT_L>+4, <-4,
    DISTOUT_R>+4, <-4, with ~2.2M hysteresis. Outputs diode-OR (D14_*) into
    the panel CLIP LED via a current-limit R.
    - Shared +/-4V threshold from a 20k/10k divider off +/-12 (dist1), exported
    as VREF_P4/VREF_N4 boundary nets to dist2/dist3.
    - CLIP LED component rows added for BP1/2/3.
    All 5 --check gates + parity green. Exact threshold trim is Phase-3R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
    [pogo-block-6-dist1.kicad_sch, pogo-block-6-dist2.kicad_sch, pogo-block-6-dist3.kicad_sch, pogo-bom.csv]
2026-05-30 0018: block-6 stage 7 - two independent dry/wet scalers (mix)
    Final block-6 stage: rework the mix to the plugin's two-scaler output
    bpOut = bandL*BP_BYPASS + wetSum*BP_WET (two independent 0-1 levels, not a
    crossfade):
    - Wet 3-band sum (U46/47-A, inv) re-inverted by U48 (G=-1) -> BP_WETPOS (+bands).
    - BYPASS dual-gang pot (RV30 L / RV58 R) attenuates dry LP1 band; new WET
    dual-gang pot (RV57 L / RV59 R) attenuates BP_WETPOS; both wipers sum in the
    final inverting summer (U46/47-B); output polarity restore per channel
    (U27-B = L existing, U27-A = R reused) -> BP_OUT.
    - Polarity arranged so wet ADDS with dry at BP_OUT (accounts for the Stage-5
    DRIVE-VCA I/V inversion); exact phase-vs-f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
    [pogo-block-6-mix.kicad_sch, pogo-bom.csv]
2026-05-30 0018: block-7 HP filter aligned to plugin (polarity bug fix + Q collapse)
    Adversarial review found a real behavioral divergence: HP output had a
    spurious G=-1 inverting buffer on the SUM_AMP node, double-inverting vs the
    plugin (HPFilter pre-negates so the SUM_AMP node IS the HP tap). Fixed:
    - Convert U53/U54 half-B from inverting buffer to a UNITY NON-INVERTING
    FOLLOWER on the SUM_AMP node (mirrors LP1's LP buffer); HP_OUT now matches
    the plugin polarity. R100-R103 removed.
    - Collapse HP Q from 2 LM13700 (U51/U52, cell-A each) to ONE (U51 cell A=L,
    cell B=R), matching the LP1/LP2 shared-Q precedent. U52 + C97/C98 +
    R_QB_* spare-termination removed.
    - RV18 (Q_max) value set to 100k.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
    [pogo-block-7.kicad_sch, pogo-bom.csv]
2026-05-30 0018: block-8 LP2 re-verified to plugin (doc); fix block-7 stale gotcha
    No behavioral divergence — LP2 faithfully mirrors LP1 minus tilt. Adversarial
    review confirmed:
    - Output buffer is correctly NON-INVERTING (unity follower) — matches the
    plugin's un-negated v2 return (unlike HP which negates). The full
    HP->LP2->MAIN chain is 3 cascaded G=+1 followers => no net polarity
    inversion vs the plugin.
    - Shared U9/U10 cell-B Q boundary (hosted on block-5) pin-matches exactly on
    both sides (6 nets); block-8 has its own IRES_AMP (U65); no double-count.
    - RES /10, mono cutoff/shared expo, self-osc, 632Hz V/oct, default +2V/2.5kHz
    all faithful; no stray HP/BP tap exposed.
    Doc-only edit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
2026-05-30 0018: block-B output buffers aligned to plugin (BP3_R normal + hygiene)
    Final block. Adversarial review confirmed MAIN outputs faithful (non-inverting
    unity followers, 1k series, +-11V via TL072 swing = plugin clamp, like block-A)
    and the BP3 tap point correct (svf3 v1, post-bandpass/pre-mix). One real gap:
    - BP3_R OUTPUT NORMALLING added: the plugin outputs BP3_L when the BP3_R jack
    is unpatched (Pogo.cpp:498-499). Wired J28.3 (switch lug) -> BP3_L_OUT in
    block-6-mix (which owns the BP3 jacks): BP3_L_OUT: [J27.1, J28.3], J28.3
    removed from no_connect. Mirrors block-A's L->R input normal.
    - Renumbered block-B R37 -> R224 to clear the cross-block R37 collision with
    block-3's CV-protec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
    [pogo-block-6-mix.kicad_sch, pogo-block-B.kicad_sch, pogo-bom.csv]
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2026-05-30 0019: doc staleness sweep + design-review refresh
    Thorough post-0018 markdown-staleness pass + design-review re-performance.
    No plugin/panel/DSP or net-connectivity change (plugin stays ground truth).
    - README: rework signal-chain ASCII for readability; fix stale facts (5->6
    --check gates, component count, block-6 split, docs/netlist.html, BP range
    ~50Hz-3.2kHz/F_REF 400, 18 attenuverter + VCA destinations).
    - CLAUDE.md: signal-chain box (two-scaler mix, per-band DIST_MODE, dist-before-
    SVF, ALT->VCA->BP3), modulation (MOD_SRC switch, lights LFO1/2+BP1-3_CLIP),
    gen_block6 superseded, block-6 nets split exception, 5->6 gates.
    - docs/plugin-topology.md: FULL regenerate from the plugin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
    [pogo-bom.csv]
2026-05-30 0019: fold in adversarial fact-check corrections
    Adversarial review found plugin-topology.md fully accurate; fixed:
    - Power totals were internally inconsistent (per-block column summed to
    329/323 mA, not the stated 326/321). Root cause: block-6 written as ~180 mA
    while its section rows sum to ~161. Corrected block-6 -> 161 and totals ->
    329/323 in both analog-design-review.md and module-overview.md; the 6 mA
    +12/-12 gap is now explained (block-2 LED drivers, +12V only).
    - component-verification-report.md: repeated-audio-ref count 37 -> 35;
    '9 footprint libraries' -> '9 bindings across 4 unique libraries'.
    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
2026-05-30 0019: fold adversarial-review doc fixes into staleness refresh
    A 6-agent adversarial review (plugin->spec->nets->schematic) surfaced more
    pure-doc staleness; folding the unambiguous doc fixes here (per user):
    - aux-expo-converter.md: BP cap/freq table + Used-By + comment still listed the
    pre-0018 200/1500/6000 Hz + 150/22/4.7 nF scheme -> corrected to 400 Hz / 68 nF
    (all three bands) with per-channel L/R expo for tilt.
    - aux-distortion.md: HC cell described as 'Schottky back-to-back, +-0.6V' -> actual
    netlist/plugin is BZX84C5V1 zeners +-5.8V (matches hardClip +-1.16). Fixed prose,
    ASCII box, component table, and gotcha note.
    - block-6/spec.md: U27 still called 'BP_TILT_INV' with ha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
    [pogo-bom.csv]
2026-05-30 0020: open CV-conditioning & behavioral netlist fix change (G1 pending)
    Lane B. Change file records the 6-agent adversarial review findings
    (plugin->spec->nets->schematic), prioritized CRITICAL/HIGH/MED, with
    independent-verification marks. Awaiting G1 intent confirmation before
    any spec/nets work. Stacked on 0019.
    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
2026-05-30 0020: G1 confirmed; record scope decision + wiring reconnaissance
    - G1: fix all confirmed CRITICAL+HIGH defects in this change; full H5/H6/M5
    fixes (not deferred); M3 dropped (verified non-issue).
    - Recorded wiring facts for the G5 topology proposal: M1 BP3-normal mechanism,
    H4 WF-phase, and the H1 BP3-selector ALT_R_DET constraint (J4 single switch
    lug already used for normalling). No nets rewired yet — topology goes to G5.
    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
2026-05-30 0020: G5 topology proposal (datasheet-grounded fix values)
    Records the full per-block topology proposal from the analog-design pass:
    - A expo V/oct divider (R_SHUNT 866R, 17.92 mV/oct, HC)
    - B LP1 tilt summing node (HC)
    - C OTA state-var tap pin 8/9 -> 5/12 reroute (HC)
    - D Q-cell Iabc bias (R_Iabc 1M->100k, negative V_ires) + self-osc soft-limit
    (M5/H6; bias value flagged [NV] - LM13700 Iabc-pin voltage needs datasheet
    re-verify, PDF extraction unavailable in-env)
    - E BP3 ALT_R selector (topology decision; J4 switch-lug constraint)
    - F WF phase inversion
    - G BP3 R->L output normal reroute
    - H mod-bus depth+buffer (topology decision) + M2/M4
    Also logs a new out-of-scope finding: THAT340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
2026-05-30 0020: cluster-C implementation finding (topology refinement, not reroute)
    Tracing block-5/7/8: the v1 tap reroute (pins 8->5, high-Z consumers) is the
    safe literal H5 fix. But the v2/LP tap drives both the output buffer AND the
    resistive feedback R47/R48 from the Darlington, so the fix is a real topology
    refinement (re-source feedback from the precision buffer, remove pulldowns) +
    the LP output inherits the Darlington DC offset. Loop DC/stability can't be
    validated in this env (no SPICE, PDFs won't extract).
    Proposed split: do the safe digital/output/summing clusters now (E,F,G,H);
    hold the resonant-loop / [NV] clusters (A,B,C,D,HIGH-3) for SPICE/bench/
    datasheet validation. Seeking user st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
2026-05-30 0020: adopt trim-pot strategy for [NV] nodes + ngspice validation path
    User decisions round 2:
    - Design every [NV]/uncertain node with calibration trim authority wide enough
    to span the uncertainty (dial in at bench bring-up) rather than pre-committing
    unverifiable fixed values. Most nodes already have a trim; work = ensure range
    + wiring. Removes the blind-analog-surgery risk for Tier 2.
    - ngspice-42 installed & verified (AC analysis runs). Tier-2 resonant-loop/[NV]
    fixes validated with small SPICE models before committing edits; decks in
    specs/sim/.
    Tempco research: no in-production SMD part at exactly +3300ppm/1k (Panasonic
    ERA-S33 EOL); active options are Vishay TFPT (+4110ppm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
2026-05-30 0020: SPICE-validate expo divider (caught 2.1x value error) + tempco=Vishay TFPT
    - ngspice deck specs/sim/expo_voct.cir validates the §A V/oct base divider.
    - SPICE caught that the first-pass values (R_SHUNT 866 + 1k tempco in series)
    give 37.8 mV/V = 2.1x the 17.92 mV/oct target. Corrected: tempco IS the shunt
    leg (1k TFPT to GND), series leg sets ratio. Validated R_VOCT~51.1k + RV 10k
    -> 19.19..16.10 mV/V across trim, 17.92 centered at ~38% rotation.
    - G6a tempco decision: Vishay TFPT0805L1001FM (SMD, active, +4110ppm); the
    trimmable slope absorbs the TCR mismatch.
    This is the proof-of-value for the SPICE gate: a 2.1x error would otherwise
    have gone into 8 expo instances.
    https: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
2026-05-30 0020: SPICE-validate OTA-C loop (H5 offset 1.26V vs 30mV; f_ref 634Hz)
    specs/sim/ota_svf_loop.cir:
    - (1) Quantifies H5: tapping the state variable from the LM13700 Darlington
    buffer injects 1.26V DC into the next OTA input (linear range +-30mV, 42x
    over). The unbuffered/cap-node tap (the §C fix) gives 0V offset.
    - (2) gm-C integrator corner = 634.6Hz at Iabc=9.69uA (target 632, 0.4%) -
    confirms the re-tap leaves f_ref unchanged.
    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
2026-05-30 0020: SPICE-validate Q-cell bias (M5 confirmed, §D fix mapped)
    specs/sim/q_cell.cir:
    - M5 confirmed: R_Iabc=1M from ~0V gives Iabc=10.8uA (14x the claimed 0.74uA)
    because the LM13700 Iabc pin sits ~-10.8V, not GND -> Q pinned at minimum.
    - §D fix: R_Iabc=100k + negative V_ires (-10.0..-10.795V) maps Q=0.065..10.4;
    Butterworth Q~0.74 at V_ires~-10.73V.
    - Design note: useful Q is in a ~0.8V window just above the pin and very steep
    (~10mV ~ 5x Q) -> V_bias trim needs fine/multi-turn resolution near the rail;
    Q=2000 self-osc via soft-limit diodes (H6), not Iabc precision.
    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
2026-05-30 0020: SPICE-validate VCA Ec+ trim (HIGH-3) - 4th/4 deck done
    specs/sim/vca_ecplus.cir:
    - HIGH-3 confirmed: series rheostat moves Ec+ only ~25uV (0.004dB) across full
    0-500ohm travel -> the unity trim does nothing (Ec+ is high-Z).
    - Voltage-injection trim (+-12mV wiper via 100k into Ec+) gives -2.8..+1.2dB,
    crosses 0dB mid-range, and nulls the real ~-0.8dB bias-current offset.
    Design: bound injection wiper to ~+-12mV (~100:1 pre-divider) for +-2dB
    authority; also add V_CTRL wiper buffer before the 4-cell fan-out.
    All four SPICE decks (expo, OTA-C loop, Q-cell, VCA Ec+) now pass; the Tier-2
    fixes are behavior-validated rather than blind.
    https://claude.ai/code/session_013jFXG5oeMVSYP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
2026-05-30 0020 §G: fix BP3 R->L output normal (M1) — first netlist cluster
    The BP3_R jack normalled to BP3_L by tying J28 tip<->switch, joining two
    post-1k buffer outputs -> unpatched R jack read (L+R)/2 and back-fed the L jack
    (J27). Fix: J28's switch lug now taps a new BP3_L_BUF boundary net = block-B
    U62A's STIFF op-amp output (pre-R36 series R), so an unpatched R jack reads
    clean L without the two driven outputs fighting.
    - specs/block-6-mix: BP3_L_OUT no longer carries J28.3; new BP3_L_BUF:[J28.3].
    - specs/block-B: export BP3_L_BUF (U62A stiff node) as boundary.
    - SPICE specs/sim/bp3_normal.cir: buggy J27=J28=2.0V ((L+R)/2); fixed J28=3.0V
    (clean L), J27 undisturbed.
    - Regenerated kicad/*.k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
    [pogo-block-6-mix.kicad_sch, pogo-block-B.kicad_sch]
2026-05-30 0020 §F: WITHDRAW H4 (wavefold phase) — SPICE shows it is FALSE
    Traced the small-signal sign from the common BP1_DRIVEOUT node through all
    three cells: SC = -drive (inverting R18/R19), HC = -drive (R20/R21), WF =
    stage-1 invert then folder 2*Vclamp-Vfoldin = -drive below threshold. All
    three share sign; the DRIVE-VCA inversion is common so it can't create a
    relative flip. SPICE specs/sim/wf_phase.cir confirms SC and WF have identical
    slope (-1 V/V near 0, +-1.0 at din=+-1); WF folds above +-1.4V but phase
    agrees. The original H4 (Vfoldin=-Vin) was a sign-tracking error.
    Decision: NO netlist change — an added inversion would have INTRODUCED a phase
    bug across all 3 bands. Second SPICE c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
2026-05-30 0020 §E: decision = dual-switch jack for J4 (full parity); G6 part research launched
    User chose the dual-switch-jack route over E3: replace J4 with a 3.5mm jack
    having two switch contacts (one for the R->L signal normal, one for an
    independent ALT_R insertion-detect -> ALT_R_DET), then OR ALT_R_DET with
    ALT_L_DET into U81's R-channel select only. New part type -> G6a/G6b (MPN +
    datasheet + new >=5-pin symbol + vendored footprint + panel binding) + a panel
    footprint implication. Part research running; §E netlist edit waits on a real
    MPN. Moving to §H meanwhile.
    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
2026-05-30 0020 §H: SPICE-validate mod-bus depth fix (C2/H2); H-a viable
    specs/sim/modbus_depth.cir:
    - C2 confirmed: 100k R_SRC_NORM into the destination node gives ~4.8% mod depth
    at an unpatched destination (~20x deficit). Direct low-Z normal -> ~98%.
    - H2 buffer budget: real per-destination load ~10k (R_INV_IN dominates; pot
    returns to -V_src not GND). 18 parallel ~561 ohm -> ~18mA worst-case; two
    paralleled TL074 sections (U3 C/D) share ~9mA each -> adequate. (First-pass
    5k assumption looked under-spec at 35mA; accurate 10k load makes H-a fine.)
    - Recorded the block-3 edit plan (drop 18x R18, direct normal, re-enable U3
    C/D buffer, M2 offset rescale) for the next commit.
    https://claude.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
2026-05-30 0020 §E: jack research - dual-switch route has a panel-standard tradeoff
    Only confirmed dual-switch vertical 3.5mm jack is Amphenol ACJS-MV35-5, but it
    uses an M6 bushing (not POGO's M8 Thonkiconn standard) -> J4 becomes a panel
    outlier + vendored footprint. The M8-compatible Qingpu PJ3410's second switch
    is unconfirmed (likely switched-tip-only -> wouldn't give the detect). All to
    fix the narrow 'ALT_R-only patched' case. Surfacing the tradeoff; E3 (document
    the limitation) remains the proportionate fallback. User decision needed.
    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
2026-05-30 0020 §E: make ALT_BP_L/R fully independent (Lane A plugin + hardware)
    User direction: instead of a dual-switch jack (which would break the M8 panel
    standard) to reproduce the R->L normal, make ALT L and R INDEPENDENT. This
    dissolves the §E problem - each jack self-detects via its own switch lug, no
    new part, no panel change, cleaner stereo behavior.
    PLUGIN (Lane A; G3 pending in VCV Rack):
    - Pogo.cpp: altR = altRConn ? PreGain(...) : 0 (dropped R->L normal);
    bp3InR = altRConn ? VcaBlock(...) : bandR (was altLConn||altRConn). L same.
    - plugin.json 2.0.0 -> 2.1.0.
    HARDWARE (follows):
    - block-1: J4 mirrors J3 -> ALT_R_DET:[J4.3] + R225 22k tip pulldown; removed
    J4.3 from ALT_L_IN (R->L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
    [pogo-block-1.kicad_sch, pogo-block-6-dist3.kicad_sch, pogo-bom.csv]
2026-05-30 0020 §H: refined buffer load = ~52mA worst-case; H-a under-spec
    specs/sim/modbus_load.cir models the exact attenuverter load (R_INV_IN 10k ||
    pot 10k-to-(-Vsrc)) = 3.33k/dest. Reconciles the 3% bug figure exactly (3.22%),
    confirming the model. Per-dest ~2.9mA; 18 dests at +10V = ~52mA. The mod bus is
    one source normalled to all 18 at once, so this is the REAL worst case.
    52mA exceeds 2x TL074 sections -> the approved H-a (reuse U3 C/D spares) is
    under-spec. Options: 3x TL074 (needs +1 section), op-amp+BJT push-pull boost
    (recommended, robust >100mA), or raise R_INV_IN (changes attenuverter scaling).
    Holding §H wiring for user buffer-topology decision.
    https://claude.ai/code/session_013jF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
2026-05-30 0020 §H: fix mod-bus depth + distribution buffer + offset range (C2/H2/M2)
    block-3 mod-bus rewrite (SPICE-validated, user chose raise-impedance):
    - C2 (depth): removed the 18x R18 R_SRC_NORM (100k); each jack switch lug now
    normals LOW-Z directly to V_MODBUS. SPICE: ~3% -> ~98% mod depth.
    - H2 (drive): raised attenuverter network x5 (R_INV_IN/FB 10k->47k, pot ->50k)
    so 18-dest load drops to ~11mA; re-enabled U3 C/D as a paralleled unity
    distribution buffer (R227/R228 47R share Rs) driving the rail. Within 2x TL074.
    - M2 (offset): R15 100k->240k so RV4's +-12V wiper maps to +-5V at the summer.
    - Decks: specs/sim/modbus_depth.cir, modbus_load.cir, modbus_hiZ.cir.
    block-3 schematic rege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
    [pogo-block-3.kicad_sch, pogo-bom.csv]
2026-05-30 0020 §A: expo V/oct divider fix - block-7 HP (template, tempco resolved)
    First expo-divider fix (C1). block-7 HP (mono, 1 expo):
    - R110 R_VOCT 47k->49.9k (E96; SPICE centers 17.92mV/oct = V_T*ln2 at mid-trim,
    sweeps 19.65..16.42 mV/V across RV17 -> symmetric +-10% authority).
    - R229 tempco shunt (Vishay TFPT 1k, +4110ppm/K) HP_EXPO_BASE->GND. Resolves in
    BOM to TFPT0805L1001FM + POGO_Resistor_SMD footprint + datasheet (G6a/b paid off).
    - Fixes the railed-expo bug: CV now sees ~18mV/oct at the base, not full V/oct.
    block-7 schematic regenerated (57 parts/36 nets); all --check gates green.
    This is the validated template for block-8 (mono) + block-5 (stereo, +tilt §B).
    https://claude.ai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
    [pogo-block-7.kicad_sch, pogo-bom.csv]
2026-05-30 0020 §A: expo V/oct divider fix - block-8 LP2 (mono, same template as block-7)
    R86 R_VOCT 47k->49.9k + R230 Vishay TFPT 1k tempco shunt on LP2_EXPO_BASE->GND.
    Resolves in BOM to TFPT0805L1001FM + footprint + datasheet. block-8 schematic
    regenerated (52 parts/36 nets); all --check gates green.
    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
    [pogo-block-8.kicad_sch, pogo-bom.csv]
2026-05-30 0020 §C+§D: block-7 HP OTA tap + Q-cell R_Iabc
    §C (H5): tap v1/v2 from the unbuffered LM13700 OTA outputs (pins 5/12), not the
    Darlington buffers (8/9) which inject ~1.26V DC into the next OTA (SPICE
    ota_svf_loop.cir). Removed R112-R115 buffer pulldowns; buffer pins 7/8/9/10 ->
    no_connect. f_ref unchanged (cap still on OTA out).
    §D/M5 (partial): R104/R105 R_Iabc 1M->100k (the LM13700 Iabc pin sits ~-10.8V,
    not GND -> 1M delivered ~14x too much Iabc). The deeper negative-V_ires IRES_AMP
    bias redesign + clamp-polarity flip is a Phase-3R/trim-backed [NV] item deferred
    to the block-5 combined-edit pass (shares the same pattern); clamp D12 unchanged
    meanwhile.
    block-7 schematic regenerated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
    [pogo-block-7.kicad_sch, pogo-bom.csv]
2026-05-30 0020 §C+§D: block-8 LP2 OTA tap + Q-cell R_Iabc (same pattern as block-7)
    §C (H5): tap v1/v2 from unbuffered OTA outputs (pins 5/12); v2 now drives the LP
    output buffer + R_FB from the clean cap node (no Darlington offset in the loop).
    Removed R88-R91 pulldowns; buffer pins 7/8/9/10 -> no_connect. LP2_V1_* boundary
    to block-5 Q-VCAs preserved.
    §D/M5: R80/R81 R_Iabc 1M->100k. (Negative-V_ires IRES_AMP redesign deferred to
    the block-5 combined pass, [NV]/trim-backed.)
    block-8 schematic regenerated (48 parts/32 nets); all --check gates green, 0 FAIL.
    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
    [pogo-block-8.kicad_sch, pogo-bom.csv]
2026-05-30 0020 §A+§B+§C+§D: block-5 LP1 combined filter-core edit (stereo)
    The convergence block, done as one coherent edit:
    - §A expo divider: R63/R66 R_VOCT 47k->49.9k + R231/R232 Vishay TFPT 1k tempco
    shunts on both expo bases (L+R). Centers 17.92mV/oct at mid-trim.
    - §B tilt: SPICE (lp1_tilt_passive.cir) showed tilt can sum PASSIVELY with V_freq
    at the tempco-shunted base via an equal series R -> R55/R56 100k->54.9k
    (=R_VOCT+RV_mid, 1:1 octave weight, freq=tilt=17.57mV/V). NO extra op-amp needed
    (dropped the planned +1 TL072). U13-A still makes -V_tilt for R; RV6 null kept.
    - §C OTA tap: v1/v2 from unbuffered OTA pins 5/12 (not Darlington 8/9); removed
    R68-R71 pulldowns; buffer pi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
    [pogo-block-5.kicad_sch, pogo-bom.csv]
2026-05-30 0020 HIGH-3: SPICE-validate full VCA Ec+ injection-trim + V_CTRL buffer network
    specs/sim/vca_ecplus_full.cir: per-cell V_CTRL_BUF-[R_ec 10k]->Ec+ + trim
    wiper-[R_inj 1M]->Ec+, trim across a shared ±~1.2V ref. g_ctrl=0.984 (unity
    pass-through), trim authority -2.1..+1.9dB crossing 0 (nulls the ~-0.5mV bias
    offset). Replaces the useless series rheostat (0.004dB).
    Parts/scope recorded: +1 TL072 (U97) for the V_CTRL buffer (all 3 block-4
    TL072 are full), a shared ±ref divider, and R_ec/R_inj per cell x10 (4 block-4
    + 6 block-6 DRIVE). Broadest remaining rewrite; wiring block-4 first then
    block-6 DRIVE mirror. Ec+ R/ref SPICE-validated; the absolute 6.1mV/dB figure
    is [NV], absorbed by the ±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
2026-05-30 0020 HIGH-3: VCA Ec+ injection trims + V_CTRL buffer (10 cells, last cluster)
    Replaced the useless series-rheostat-into-high-Z-Ec+ unity trims (~0.004dB
    authority) with SPICE-validated voltage-injection trims across all 10 VCA cells:
    - block-4 (4 cells: main L/R + ALT L/R): +U97 TL072 buffers the unbuffered AMT
    wiper -> V_CTRL_BUF -> 4x R_ec(10k) -> Ec+ (decouples the cells). Trims RV1/2/46/47
    500ohm->10k as dividers across a shared ±1.2V ref (R233/R234), wiper->R_inj(1M)->Ec+.
    - block-6 dist1/2/3 (6 DRIVE cells): same injection trim; V_DRIVE_CTRL_n is already
    an op-amp output (low-Z) so no extra buffer - just per-section ±ref divider + R_ec/R_inj.
    RV51-56 500ohm->10k.
    SPICE vca_ec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
    [pogo-block-4.kicad_sch, pogo-block-6-dist1.kicad_sch, pogo-block-6-dist2.kicad_sch, pogo-block-6-dist3.kicad_sch, pogo-bom.csv]
2026-05-30 0020: spec §2-4 parity sync (G4) + STATUS + aux docs
    Documented all change-0020 topology changes in the affected block specs §3,
    the aux library, and STATUS.md (the netlists already carry them):
    - block-3 §H: low-Z normal + U3 buffer + ×5 hi-Z attenuverters + OFFSET ±5V
    - block-4 HIGH-3: Ec+ voltage-injection trim + U97 V_CTRL buffer
    - block-5 §A/§B/§C/§D: expo divider+tempco, passive tilt sum, unbuffered tap, R_Iabc
    - block-6 §A (svf expo) + HIGH-3 (DRIVE Ec+ trims) note on the STALE §3
    - block-7/8 §A/§C/§D
    - aux-expo (corrected the wrong 'THAT340 has internal PTAT' claim → needs external
    tempco; Vishay TFPT), aux-ota-c-svf (unbuffered tap), aux-q-control (Iabc-pin
    ~-10.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
2026-05-31 0022: SPICE behavioral runner + per-block deck migration (implements 0021)
    tools/build_spice.py: runs per-block sim/ ngspice decks against .expect.yaml
    assertions. --list / --run BLOCK / --check. Deck contract = 'print <name>'
    lines (deck computes, yaml asserts); names matched case-insensitively. --check
    skips cleanly (exit 0) when ngspice is absent, so non-SPICE CI legs pass.
    Migrated change-0020's flat specs/sim/ scratch decks into per-block sim/ folders
    with assertions (7 checked decks, all pass):
    - block-5: expo_voct (§A divider), ota_svf_loop (§C tap offset + f_ref),
    q_cell (§D Iabc), lp1_tilt_passive (§B 1:1 octave sum)
    - block-3: modbus_depth (§H 3%->99%)
    - block-4: vca_ecplus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
2026-05-31 0024: SPICE circuit-math validation pilot — scaffolding (guide + change file)
    Pilot a multi-agent methodology for making 'every circuit-math reference in the
    schematic is valid' provable, on block-7 (HP). Adds tools/SPICE-DECK-GUIDE.md:
    the shared deck-authoring conventions (ngspice gotchas: parallel-instances over
    alter-loops, node naming, the print contract, ideal-model conventions) + the
    verification philosophy (deck encodes netlist values; .expect.yaml encodes spec
    math; a divergence fails the gate). Stage 1 deriver agent running.
    Stacked on 0023.
    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
2026-05-31 0024: record Stage-1 manifest (12 candidates, 7 new checks, spec divergence found)
    Deriver agent produced the block-7 SPICE-check manifest: 12 candidates classified
    (spice-able / [NV] / covered), 7 new checks shortlisted, out-of-scope items
    acknowledged (pinouts, sourcing, layout, power, fan-out). Surfaced a real
    spec<->netlist divergence: spec.md:152-153 still says R_Iabc=1M (pre-0020) vs
    netlist 100k -> to be corrected at integration. Stage 2 writers running.
    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
2026-05-31 0024: block-7 SPICE decks — slice B (SUM_AMP vground + IRES_AMP summer)
    Stage-2 writer slice B (verified PASS via build_spice.py --run block-7):
    - sumamp_vground: SVF SUM_AMP inverting virtual-ground summer, R_f/R_in=R_f/R_FB=1
    (R30/R92/R94 = 100k) -> -(x+Qfb) unity weights, v(-)≈0. Proves the (x−k·v1−v2)
    resistor-ratio math.
    - ires_summer: IRES_AMP inverting summer (R106/R107/R108 = 100k), unity ratios +
    monotone res→Q sign (higher res-CV -> V_ires down -> Iabc down -> Q up). Absolute
    V_bias setpoint flagged [NV].
    All netlist-derived values landed exactly on the independently spec-derived expects
    (Δ≈3e-06); no divergence. Slices A/C still in flight.
    https://claude.ai/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
2026-05-31 0024: block-7 SPICE decks — slice C (V/oct octave, Q-cell, I_ref trim)
    Stage-2 writer slice C (all PASS via build_spice.py --run block-7):
    - voct_octave: end-to-end 1V/oct tracking — f0 ratios 0.125 (-3V) / 32x (+5V),
    NV-free (Iref cancels), pins HPFilter.hpp:18 f0=632*2^cv.
    - q_cell: §D Iabc bias — 1M@0V bug 10.8uA vs 100k@-10.73V fix 0.7uA, Q=0.74
    (mirror of block-5; derived from netlist R104/R105=100k + aux §D).
    - iref_target [NV]: I_ref leg R_total trim authority — 1000/1238/1500k; the
    9.69uA f_ref setpoint at ~47.6% travel sits inside 20-80%.
    Slice C independently reconfirmed the stale spec.md:152-153 (R_Iabc=1M, pre-0020)
    vs netlist 100k -> fixed at integration. Slice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
2026-05-31 0024: block-7 SPICE decks — slice A (HP transfer + polarity guard)
    Stage-2 writer slice A (both PASS):
    - hp_transfer: 2-pole HIGHPASS structural proof — +12dB/oct LF slope, 0dB
    passband, corner=f0=632Hz (via the Q-independent arg(H)=+90 deg marker),
    peak |H(jw0)|=Q=6.02dB. The only deck proving block-7 is a highpass (not LP/BP),
    pins HPFilter.hpp:32-40.
    - hp_polarity: HP_OUT = -(x-k*v1-v2) via inverting-summer + UNITY follower (the
    0018 fix); models the bug (2nd G=-1 inversion) in-deck and shows opposite sign
    -> regression guard for the exact 0018 polarity bug. Pins HPFilter.hpp:40.
    All 7 new block-7 decks pass; global gate green (22 decks). Booleans via B-source
    ternary (ngsp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
2026-05-31 0024: close the netlist-binding gap (the pilot's headline finding) + fix spec bug
    Stage-3 adversarial verifiers found (and I confirmed in code) that decks
    hand-transcribe netlist values as literals — build_spice.py never read
    nets.yaml — so the gate was deck-literal-vs-spec, NOT netlist-vs-spec. A silent
    regression (R104 100k->1M) would pass green; the two decks whose sole job was
    pinning a netlist value (q_cell, iref_target) pinned a hardcoded literal. The
    guide's core premise was architecturally unmet.
    FIX (Stage 4): added to build_spice.py + an EE value parser
    (100k/47nF/1M/49k9 R-notation). An .expect.yaml declares
    ; the runner resolves the ref from
    specs/<block>/<block>.nets.yaml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
2026-05-31 0024: document the multi-agent authoring pipeline in the deck guide
    Adds Part 2 to tools/SPICE-DECK-GUIDE.md: the 4-stage pipeline (derive -> write
    -> verify -> integrate) with orchestration rules + the reusable sub-agent prompt
    structure that worked on the block-7 pilot. Captures:
    - Stage 1 deriver: structured manifest (not prose) with required fields.
    - Stage 2 writers: parallel slices, netlist_bind required, self-verify via runner,
    escalate divergences.
    - Stage 3 verifiers: the three killer questions, Q3 (would it fail if the netlist
    were wrong?) as the load-bearing one that found the architectural flaw.
    - Stage 4 integrate: fix the mechanism + prove the fix.
    - Prompt-writing lessons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
2026-05-31 0025: record block-4 Stage-1 manifest (11 candidates, 6 new + 2 retrofits)
    Deriver confirmed the methodology generalizes to the VCA: [NV] axis = THAT2180
    6.1mV/dB constant; checks confined to ratios/shape/authority/topology that
    cancel it. Pre-write integration findings: (1) the existing vca_ecplus.cir has
    NO netlist_bind (the gap 0024 fixed) -> retrofit; (2) vca_ecplus_full.cir is
    referenced in spec.md:167 but doesn't exist -> reconcile. Stage 2 writers next.
    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
2026-05-31 0025: block-4 VCA decks — slice A (AMT-symmetric unity + CV summer ratio)
    Stage-2 writer slice A (PASS with netlist_bind verified against live nets.yaml):
    - amt_symmetric: pins the 0018 OFS-placement fix — V_ctrl=0 at AMT-center for ANY
    OFS (symmetric pot across ±effCV). Binds R42-R46=100k. The agent's own Q3 probe:
    R46->200k breaks PEFFCV=-NEFFCV symmetry -> vctrl_center_ofs2 jumps to +1.0V ->
    fails (exactly the pre-0018 'OFS shifts gain at AMT detent' regression).
    - cv_summer: U63A unity inverting summer (-(CVP+OFS)) + U63B unity inversion;
    binds R42-R46. Q3: R43->200k doubles the sum -> fails.
    NV-free topology/ratio checks (sidestep the THAT2180 6.1mV/dB [NV] constant).
    No n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
2026-05-31 0025: block-4 VCA decks — slice B (I/V unity + dB-law shape)
    Stage-2 writer slice B (PASS):
    - iv_unity: transimpedance -R_f/R_in = -1 (binds R7/R40=20k) + virtual-ground
    audio input (Z_in~=R_in). Q3: R40->200k drives gain to -10 -> fails. NV-free ratio.
    - gain_law_shape: THAT2180 dB-law LOG-LINEARITY (equal Ec+ steps -> equal dB steps,
    linearity=0) + unity anchor at Ec+=0. Correctly NO netlist_bind (the 6.1mV/dB
    absolute is [NV]; the linearity ratio cancels all constants) -> tests shape, not
    the device constant. Pins VcaBlock.hpp:26-27 G=10^(2(control-1)) shape.
    Slice C (vctrl_buffer done; ref_divider + vca_ecplus retrofit in flight).
    https://claude.ai/code/session_013jFXG5oeMVSY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
2026-05-31 0025: block-4 VCA decks — slice C (V_CTRL buffer + ref divider) + vca_ecplus bind retrofit
    Stage-2 writer slice C (PASS):
    - vctrl_buffer: U97-A loaded unity pass-through g_ctrl~=0.984 (reconstructs the
    spec-referenced-but-absent vca_ecplus_full.cir). Binds R235=10k/R239=1M; Q3:
    R235->1M (pre-0020 rheostat class) collapses g_ctrl -> fails.
    - ref_divider: ±1.2V HIGH-3 reference from R233/R234=45k3 (NV-free divider). Binds
    R233/R234; Q3: R233->4k53 blows REF_P past 1.2V -> fails.
    - RETROFIT: added netlist_bind to vca_ecplus.expect.yaml (the 0023 deck that had
    NO binds — the deck-literal-vs-netlist gap). Binds R235/R236=10k, R239/R240=1M;
    all resolve -> the old hardcoded literals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
2026-05-31 0025: block-4 decks slice C + retrofit — ref_divider FOUND A REAL BUG
    Stage-2 slice C (PASS) + the headline finding:
    - vctrl_buffer: U97-A loaded unity g_ctrl~=0.991 (binds R235/R239); reconstructs
    the absent vca_ecplus_full.cir.
    - ref_divider: SPICE-derived REF_P = +-0.322V from the ACTUAL netlist
    (R233/R234=45k3 + four 10k pots in parallel = 2.5k bridge) -> NOT the +-1.2V
    spec.md:166 claims. Deck pins the current (wrong) 0.322V + documents the
    divergence per the guide. Binds R233/R234=45k3.
    - vca_ecplus retrofit: netlist_bind added (R235/R236=10k, R239/R240=1M); binds
    resolved -> old literals matched the netlist.
    ROOT CAUSE (mine, change 0020 HIGH-3): R233/R234 were sized 45.3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
2026-05-31 0025: FIX the HIGH-3 ref-divider bug the SPICE-math gate found (block-4 + block-6)
    ref_divider.cir derived REF_P from the actual netlist and got +-0.32V, not the
    +-1.2V spec.md:166 + the 0020 HIGH-3 design claimed. Root cause (my error in
    0020): R233/R234 sized 45.3k assuming a SINGLE 10k bridge, but all 4 unity trims
    (RV1/RV2/RV46/RV47) load REF_P<->REF_N in PARALLEL = 2.5k -> REF_P collapses to
    0.32V -> Ec+ injection authority was ~+-0.5dB, not the intended +-2dB. block-6
    DRIVE refs had the same bug (2 pots = 5k bridge).
    FIX:
    - block-4: R233/R234 45k3->11k3 (-> +1.195V at the 2.5k load).
    - block-6 dist1/2/3: R243/244/249/250/255/256 45k3->22k6 (-> +1.2V at the 5k load).
    - ref_divider deck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
    [pogo-block-4.kicad_sch, pogo-block-6-dist1.kicad_sch, pogo-block-6-dist2.kicad_sch, pogo-block-6-dist3.kicad_sch, pogo-bom.csv]
2026-05-31 0025: Stage 3+4 — adversarial verify found 6 defects, all fixed (incl. cross-deck seam)
    Stage-3 verifiers ran ngspice perturbation probes and found:
    1. CROSS-DECK SEAM: vca_ecplus hardcoded +-1.23V unbound to R233/R234 -> the
    ref->authority chain was guarded ONLY by ref_divider's bind. Closed: vca_ecplus
    now uses the corrected +-1.195V (-> +1.857/-2.019 dB) AND binds R233=11k3.
    PROVEN: reverting R233->45k3 now FAILS BOTH ref_divider and vca_ecplus.
    2. gain_law_shape near-tautology -> relabeled 'INTENT/MODELING check (not netlist)'.
    3. amt_symmetric ofs0 dead weight -> marked cosmetic (ofs2 is load-bearing).
    4. iv_unity R_in faked (hardcoded /20e3) -> parameterized .param Rin share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
    [block-4.nets.yaml]
